stacksjs/buddy-wheels/docs/README.md

# Buddy Wheels project documents

Prepared November 7, 2026. This is a development-stage business and product plan. No physical product has been validated, certified, manufactured or fitted in this project.

- [Business plan](business/business-plan.md): business model, market discovery, economics, operations, launch and risks.
- [Unit economics](business/unit-economics.md): reproducible assumptions and scenario outputs, generated with `bun run finance`.
- [Product and manufacturing plan](product/product-development.md): five proposed size families, printable architecture, material selection and release gates.
- [Suspension research](product/suspension-research.md): wheel isolation, damping, lockout and separately controlled rehabilitation support.
- [Actual bench CAD package](../designs/wheelchair/r0/README.md): all five families, editable CAD, printable STL parts, metal DXFs, full interface BOMs and kinematics.
- [Buddy's XL assembly traveler](engineering/xl-assembly-r0.md): illustrated sequence, hardware stacks, suspension settings and inspection.
- [Other family assemblies](engineering/wheelchair-family-assembly-r0.md): L, M, S and XS dimensions and common build sequence.
- [Fabrication drawing notes](engineering/wheelchair-drawings-r0.md): datums, tube drilling, pin/spacer stacks and unresolved engineering details.
- [Print instructions](engineering/wheelchair-printing-r0.md): file identity, orientation, bench profiles and inspection.
- [Buddy's configurable fit inputs](engineering/buddy-xl-measurements.md): reported 140 lb weight and explicitly estimated geometry, with a separate JSON profile.
- [Interactive wheelchair design studio](engineering/design-studio.md): native 3D inspection, bounded live dimensions, suspension views and matching download provenance.
- [Printer choices near LA](engineering/printer-options-la.md): current options, local support and starter budget.
- [Buddy Rover product brief](product/buddy-rover.md): running, beach and ski configurations, mechanical architecture and qualification gates.
- [Rover unit economics](business/rover-unit-economics.md): independently costed complete configurations, generated with `bun run finance`.
- [Validation and risk register](product/validation.md): bench tests, fitting studies, traceability, failure response and launch criteria.
- [Buddy's immediate needs](product/buddy-first.md): care-first action list and the information still needed for his fit.
- [Product marketing brief](marketing/product-marketing.md): positioning, evidence, audience and voice.
- [Go-to-market plan](marketing/go-to-market.md): acquisition, activation, retention, referral, budget and experiments.
- [Research and sources](business/research.md): checked reference prices, primary sources, uncertainties and comparison limits.
- [Architecture and operations](engineering/architecture.md): native Stacks boundaries, local setup, data model and checkout gate.
- [Acceptance record](engineering/acceptance.md): executed checks, browser evidence and remaining launch work.
- [Asset provenance](marketing/assets.md): original generated imagery, prompts and intended use.

The catalog's weight and height bands are planning inputs, not proven load ratings. Price targets exclude tax and delivery. Public product copy must retain these distinctions until evidence supports a change.

- [Illustrated measuring guide and customer handbooks](engineering/measurement-guide.md): six anatomical diagrams, private worksheet, unit conversion, PDF rebuild and review sources.
- [One-off XL build budget](business/xl-prototype-build-budget.md): every BOM line, printer, tools, finish, tax reserve, contingency and development allowances.
- [Industrial design refinement](engineering/industrial-design-refinement.md): candidate forest/silver finish and rounded nonstructural prints, with the remaining clinical/engineering gates.

- [XL r1 standard-parts manufacturing costs and checked prices](business/xl-standard-r1-costs.md)
- [XL r1 scope, architecture and verification plan](engineering/xl-r1-plan.md)
- [XL r1 configured assembly, BOM and drilling](../designs/wheelchair/r1/XL/assembly.md)

- [XL r2 adjustable spring cartridge costs and online evidence](business/xl-spring-r2-costs.md)
- [XL r2 design and verification scope](engineering/xl-r2-suspension-plan.md)
- [Product customization, colors and saved finish preferences](product/customization.md)

- [Rear support, mesh, padding and front-harness cut/sew guide](engineering/softgoods-xl-r1.md)
- [Complete textile design scope and verification](engineering/softgoods-plan.md)
- [Textile design verification record](engineering/softgoods-verification.md)

- [Complete XL per-unit cost and the $299 decision](business/xl-complete-unit-costs.md)
- [Checked textile supplier SKUs, prices and availability](business/textile-supplier-research.md)

- [Rover r0 bench assembly, cut list and joint patterns](engineering/rover-r0-assembly.md)
- [Rover r0 scope, native geometry kit and verification](engineering/rover-r0-plan.md)
- [Rover materials and weather system: rain, wind, sun, sand and snow](product/rover-materials.md)
- [Rover r0 cost study: counted cost, the $999 price and the path to a lower cost](business/rover-r0-costs.md)
- [Rover r0 build guide: ordering, shop work and assembly, in order](engineering/rover-r0-build-guide.md)
- [Rover r0 design files](../designs/rover/r0/README.md)
- [Rover r0 buy list for one carrier, with supplier links](../designs/rover/r0/buy-list.md)
