stacksjs/buddy-wheels/designs/rover/r0/buy-list.md

# Buddy Rover r0 buy list for one carrier

Configuration rover-r0-l1300-w700-h1000-r1000-a560-g1000-hub101.6-trail-swivel310-k350-t180-welded-sprung. Checked 2026-11-12, USD, before tax and shipping. This is what one builder buys for one bench carrier, in whole bars, sheets, yards and packs, so it is more than the material the carrier consumes. It is a bench build. Nothing here is rated or approved for carrying an animal.

**Materials to buy: about $2,378.24.** $1,811.24 of that has a supplier page behind it. The remaining $567.00 is allowance and needs a quote or a shop visit. Your own time is extra: the study assumes about 6 hours of cutting and assembly, with the welding done by a shop, and 9 hours of sewing.

## Frame, running gear and hardware

| Item | Cost | Basis |
| --- | ---: | --- |
| [1 bars of 1 x 1 x 1/16 inch 6063-T52 square tube, 21 ft each, cut in half to carry](https://www.metalsdepot.com/aluminum-products/aluminum-square-tube) | $65.73 | Observed 2026-11-12 |
| [2 bars of 1 x 1 x 1/8 inch 6061-T6 square tube, 24 ft each, cut in half to carry](https://www.metalsdepot.com/aluminum-products/aluminum-square-tube) | $232.32 | Observed 2026-11-12 |
| [2 brake clamp plates, laser cut 1/8 inch 6061](https://app.oshcut.com) | $27.32 | One carrier: quoted 2026-11-12. Batch: allowance |
| 36 TIG welded joints by a fabrication shop | $540.00 | RFQ |
| [5 round tubes cut and bent by a mail-order service, 10 bends, and 2 end plugs](https://app.oshcut.com) | $443.39 | Quoted 2026-11-12 |
| [2 pneumatic trail wheels, 15 inch 4.00-8](https://www.zoro.com/zoro-select-pneumatic-wheel-15-316dia-435lb-400-8-1nwv4/i/G1932594/) | $65.78 | Observed 2026-11-12 |
| [Front swivel caster with swivel lock, 10 inch pneumatic, and four bolts](https://www.zoro.com/service-caster-10-inch-black-pneumatic-wheel-swivel-caster-with-bolt-swivel-lock-scc-100s3504-pnb-bsl/i/G705434817/) | $67.69 | Observed 2026-11-12 + nut and sleeve allowance |
| [2 stock-shaft axles, sleeves, spacers, washers and cotters](https://www.onlinemetals.com/en/buy/carbon-steel/0-75-od-x-0-065-wall-x-0-62-id-carbon-steel-round-tube-a513-type-5-dom/pid/7765) | $26.44 | Observed 2026-11-12, rod from a listing |
| [8 sleeved bolted joints](https://boltdepot.com/Product-Details?product=328) | $36.20 | Observed 2026-11-12 |
| [Floor and ramp panels, sealed 15/32 inch ACX plywood](https://www.homedepot.com/b/Lumber-Composites-Plywood/15-32/N-5yc1vZbqm7Z1z0mcqq) | $77.00 | Observed 2026-11-12 + sealing allowance |
| [Hinge, two latches, carriage bolts and strap hardware](https://www.zoro.com/zoro-select-piano-hinge-stainless-steel-full-surface-mounting-1-in-leaf-w-x-36-in-leaf-h-stainless-steel-2zfk4/i/G1671966/) | $51.19 | Observed 2026-11-12 + strap allowance |
| [Wheel chocks, grip, tip-stop feet, floor fasteners, bedding tape and ridge pole](https://www.harborfreight.com/solid-rubber-wheel-chock-96479.html) | $105.77 | Observed 2026-11-12, partly from listings |
| [Parking brake: two push-pull toggle clamps with neoprene-tipped spindles](https://www.zoro.com/powertec-toggle-clamp-300lbs-cap-302f-quick-release-pushpull-clamp-20304n/i/G714915420/) | $31.70 | Observed 2026-11-12 + screw allowance |
| [Rear suspension: two coil-over shocks, eight bolt-on mount plates, pivot bolts, bushings and mount bolts](https://www.amazon.com/LvTu-Bicycle-Absorber-Suspension-Bushing/dp/B0CH6DCCPS) | $130.66 | Observed 2026-11-12 + hardware allowances |
| Printed service parts and fixtures | $27.00 | Computed volume + allowance |
| **Subtotal** | **$1,928.19** | |

The tube is priced as full-length bars at one online supplier's listed prices; a local supplier's counter price was not checked. Cut from the bars with cut-list.csv. Send metal/*.dxf to a laser or waterjet shop for the 2 brake clamp plates. The plate prices above are a real quote for one carrier. The frame is welded by a fabrication shop from weld-schedule.csv; build-guide.md says how to find one and what to ask. The parts list in bom.csv has every specification.

## Cover, floor and ramp surface

| Item | Cost | Basis |
| --- | ---: | --- |
| [Roof shell, one piece: 2 whole linear yards](https://www.rockywoods.com/products/solution-dyed-600-denier-polyester-with-urethane-water-repellant-coating_2) | $30.56 | Listed price |
| [Wall shell: sides, front, header and gussets: 4 whole linear yards](https://www.owfinc.com/p/productinfo/POLY6CHAR/) | $26.00 | Listed price |
| [Mesh: three windows and the rear vent: 2 whole linear yards](https://www.sailrite.com/Phifertex-Mesh-White-000-54) | $35.90 | Listed price |
| [Clear storm panels: 10 yards, bought as 60-yard and 10-yard rolls](https://www.sailrite.com/Plastipane-20-Gauge-Vinyl-Window-Material-54) | $89.35 | Listed price |
| [Floor tub liner and threshold flap: 2 whole linear yards](https://www.owfinc.com/p/productinfo/VIN18BLK/) | $19.92 | Listed price |
| [Two floor pad halves: 2 39 x 51 inch sheets](https://www.avetcoinc.com/product/e600-high-density-eva-foam-sheets-60-65-shore-c-39-x-51-5mm-10mm/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) | $63.00 | Listed price |
| [Ramp traction surface: 1 27 x 94 inch sheets](https://www.sailrite.com/Marine-Foam-Flooring-Gray-27-x-94-Adhesive-Backed) | $90.95 | Listed price |
| [Hook tape: 11 yards](https://questoutfitters.com/products/hook-and-loop) | $17.38 | Listed price |
| [Loop tape: 11 yards](https://questoutfitters.com/products/hook-and-loop) | $17.38 | Listed price |
| [Roof seam tape: 4 meters](https://www.rockywoods.com/products/melco-seam-sealing-tape-for-2-layer-fabrics) | $11.56 | Listed price |
| [Reflective trim: 2 2.2-yard packs](https://www.sailrite.com/Sew-On-Reflective-Tape-1-Yellow-2.2-Yds) | $5.90 | Listed price |
| [Roof hem shock cord: 5 yards](https://questoutfitters.com/products/shock-cord) | $5.20 | Listed price |
| [Four stainless D-rings: 4 each](https://www.sailrite.com/D-Ring-Without-Bar-0-1-Stainless-Steel) | $6.20 | Listed price |
| [Tether, grab loop, ties and wrist strap: 20 feet](https://www.strapworks.com/1-inch-utility-polyester-webbing-black) | $14.80 | Listed price |
| [Thread allowance: 1 cones](https://www.sailrite.com/PremoBond-V-92-Black-UV-Bonded-Polyester-Thread-4-Oz-1-350-Yds) | $15.95 | Listed price |
| **Subtotal** | **$450.05** | |

Cut from cover-cut-schedule.csv. A 10% allowance for sewing mistakes is not in this subtotal.

## Before you order

1. Measure the dog and set the cabin size first. Every tube cut and fabric blank follows from it.
2. Buy one wheel and measure its hub before cutting an axle or ordering hangers.
3. Print the clearance coupon and one cap, then the rest.
4. Read the release gates in assembly.md. This list builds a bench carrier for fit and handling trials with ballast, not a finished product.
