stacksjs/buddy-wheels/docs/engineering/acceptance.md

# Acceptance record

Implementation and local QA recorded November 7, 2026. Production deployment and public QA recorded November 8, 2026. This record covers software and planning artifacts only. It does not validate a physical wheelchair.

## Completed locally

- Project created with native Buddy scaffolding under ~/Code/Apps/buddy-wheels.
- Commerce enabled through Buddy and 244 native migrations applied to the development SQLite database.
- Five known development configurations installed with the idempotent native seed command.
- Marketing, shop, fit guide, basket, checkout preview, story, care, policies and development-plan pages implemented in STX with ts-css.
- Native ProductCard, QuantitySelector, Button, OrderSummary and CheckoutSteps used for commerce UI.
- Business plan, reproducible financial model, product/manufacturing plan, validation/risk register, research, marketing and operations docs completed.
- Origin story corrected to include Buddy's very large size and limited suitable options, alongside affordability.
- Public development page includes outdoor-use goals and separate suspension/body-support research, with no availability or rehabilitation efficacy claim.
- Native app lint passed with zero errors and zero warnings.
- App TypeScript checks passed, including the direct application project check.
- STX checks passed with zero errors and zero warnings.
- Native unit/feature suite passed: five tests, 37 assertions.
- Browser journey passed: choose L, set quantity two, add to basket, change quantity, preview checkout, acknowledge fitting and see the disabled payment state.
- Server checkout returns HTTP 409 and PRODUCT_VALIDATION_REQUIRED.
- Fresh/tampered cart cookies reveal no other basket, and fractional quantities/open redirects are rejected.
- Local fit planner passed a medium-family example and labels its result as unapproved.
- Home layout checked at 320, 428, 768 and 1440 pixels with zero horizontal overflow and no browser console errors.
- Native deployment dry-run targets the existing stacks host, not new compute. Web/API ports 3460/3468 were checked against live listeners and were unused at inspection time.
- Private production env and provider credentials are excluded from Git. Only required provider keys are passed to the local deployment process.

## Framework source evidence

The Stacks source includes generic product-card props, status copy below images, isolated STX quantity state, native form values, one native change event, and live bounds/model normalization. Four retained source tests passed with 26 assertions, including real Chromium interactions. Source lint and framework typechecks passed.

Source review found and corrected duplicate change events and stale form values after live bounds changed. The publishing pipeline also exposed a pre-existing router declaration-generator failure; removing a redundant nested conditional preserves type behavior and passed router build/type fixtures. Source changes were fast-forward pushed to origin/main and native patch release commands were run. Publication and installed-consumer evidence follows.

Stacks 0.75.522 was published to npm after the exact release source passed CI. Native `./buddy upgrade` installed it in this application, updating the root and framework-support manifests and lockfile. Installed stacks, defaults and actions package versions were verified as 0.75.522. App lint, native tests, typechecks and STX checks passed against that install. The real-browser journey passed again, including native ProductCard links to `/shop?size=L`, quantity updates, concurrent five-per-size enforcement and all four responsive widths. No local component fork is used.

## Production verification

Live at [buddywheels.org](https://buddywheels.org). The founder enabled domain-specific Porkbun API access, verified through the saved setting and a successful native provider request. The authorized provider keys remained deploy-process inputs.

Native `./buddy deploy --prod --yes` successfully deployed application commit `8089b9153ef4e9e624ed6d6787349bb355c2421d` to the existing `stacks-production-app` server. It skipped provisioning and installed independent `buddy-wheels-main` and `buddy-wheels-api` services and the `buddy-wheels` gateway fragment. The API listener was verified on loopback port 3468; web traffic is routed to port 3460. SQLite persists at the app-specific absolute path declared in config/cloud.ts.

- Native Porkbun reconciliation published apex and www IPv4/IPv6 records.
- Native TLS issuance completed for both names. HTTPS passed with normal certificate verification.
- HTTP and www requests for `/shop?size=L` returned 301 to `https://buddywheels.org/shop?size=L`.
- All nine public pages returned 200: home, shop, fit guide, basket, checkout, story, care, policies and development plan.
- The theme stylesheet and responsive WebP assets returned 200 with their expected content types.
- Same-origin `/api/cart` returned 200 JSON; order placement returned HTTP 409 with PRODUCT_VALIDATION_REQUIRED.
- The full native Chromium journey passed against the public HTTPS origin: L quantity two totals $529.00, quantity one totals $264.50, checkout remains disabled, unsigned/forged/absent cookies isolate baskets, invalid quantities and redirects are rejected, and concurrent adds retain the five-per-size limit.
- The local fit planner example passed on the public site. Responsive checks at 320, 428, 768 and 1440 pixels found no horizontal overflow or browser console errors.
- Application CI passed for the deployed commit; the Stacks 0.75.522 release workflow completed successfully.

The site is a development storefront with persistent planning baskets. It accepts no payments, deposits, reservations or customer orders. Software delivery does not establish physical-product readiness.

## November 8 storefront and Rover update

Launch-style copy replaces the repeated planning language and competitor-price references in all public pages. Internal price evidence remains in the project docs. A concise availability statement and the server order gate remain accurate.

- Buddy Rover adds complete Run ($399), Coast ($449), Snow ($499) and All-season ($599) configurations to the native catalog, shared signed basket and idempotent seeder.
- The wheelchair fit helper still searches only wheelchair size families. No untested carrier dimensions or load rating is published.
- Native STX configuration state updates price, SKU, included items and imagery. Snow has its own generated visualization and SKU thumbnail.
- Basket quantity changes save through their owning native form; removal, correct product images/links and the shared header count work across both families.
- Product pages have mobile purchase actions; checkout now has one direct availability step without forced preview acknowledgements.
- Native `buddy upgrade` installed Stacks 0.75.524. Source OrderSummary changes preserve defaults while supporting separate heading, tax and item-total labels. Source tests and exact release CI passed; a superseded 0.75.523 release was cancelled after the newer mainline release included its changes.
- App lint has zero errors/warnings; app TypeScript and STX checks passed; seven tests passed with 45 assertions; both financial documents regenerated successfully.
- Retained native Chromium QA passed on the installed package graph: real home-to-Rover-to-wheelchair navigation, configuration prices, image switching, mixed totals, mobile submit, quantity limits/concurrency, removal, cookie isolation, professional-fit wording and the HTTP 409 gate.
- All ten public pages were checked at 320, 428, 768 and 1440 pixels with no horizontal overflow or console errors. Hero CTA centers, principle icons and heading tops align within one CSS pixel; native purchase buttons use the forest-green theme. Mobile safe-area spacing and visible keyboard focus are styled consistently.
- Independent Standards and Spec reviews found three issues, all corrected: overly advanced readiness wording, an unverified stability adjective and incorrect Rover Open Graph metadata.

Production verification completed November 8, 2026. Native Buddy deployed the complete collection at application commit `1b1ecd1f8170f8ccb85283e660880afc36b9a89c`; a subsequent web-only release `f7cdb152cc35e38b9ddb8226dd167d580c704ef1` added automatic stylesheet revisions. Both commits passed application CI. The web and API continue to use the existing Stacks server.

The full retained Chromium journey passed again against https://buddywheels.org, including native navigation, all configuration prices, Snow image switching, mixed totals, mobile purchase, automatic quantity updates, removal, anonymous HTML/API isolation, concurrency limits, the fit guide and disabled order placement. All ten public pages passed responsive overflow and console checks at the four recorded widths, including alignment and native button-color assertions.

Public smoke checks returned 200 for all pages, the revised stylesheet, both Rover WebP images and the cart API. HTTP and www preserved `/rover?mode=snow` in 301 redirects to the HTTPS apex. The stylesheet URL includes its content revision because the static server caches CSS for one hour; existing visitors receive the changed styles after a normal page refresh. GitHub deployment `7638107422` records the final web deployment.

## Wheelchair bench CAD r0, November 8, 2026

- Native `buddy design:wheelchair` generates editable OpenSCAD, family-specific BOMs, tube drilling coordinates and ideal rigid-linkage kinematics. It calls the official external OpenSCAD CLI for solid/mesh export; no CAD engine or web dependency was added to Stacks.
- All five baseline families exported: 50 binary STL files, 15 metal DXF profiles and assembly previews. The separate Buddy XL estimate adds another 10 STL files and three DXF profiles. Each dataset includes source/output hashes and `mesh-inspection.json`.
- All 60 actual STL files passed export-time checks for closed two-face edges, consistent winding, one connected body, positive signed volume and the declared 220 x 220 x 100 mm print envelope. These are digital checks, not structural tests.
- All 50 baseline meshes also passed the retained native test suite's independent binary-STL inspection and authored arm dimensions. Nominal shock travel, tube overlap, hole separation, profile validation, invalid hardware/wall/corner combinations and isolation of configured iterations are covered.
- `./buddy lint`: zero errors or warnings. `./buddy typecheck`: passed. `./buddy test`: 12 passed, 536 assertions.
- The native Bun download bundle contains 60 STLs and 18 DXFs. Every bundled CAD file was compared byte-for-byte by SHA256 with its working-tree source; archive tests also confirm private environment/runtime files stay excluded.
- Authored Standards and Spec reviews found incompatible parameter combinations, corner-hole edge breakout and an inconsistent XS cotter size. The generator now rejects incompatible dimensions/pitches and uses one family-specific retention-hole value consistently; regression checks cover the boundary errors.
- XL and XS assembly views and the XL suspension/detail views were visually inspected. The rear-bridge cheek orientation and perpendicular tube termination were corrected during development.
- Owner-reported Buddy weight is 140 lb, with standing reach context retained separately. Supported dimensions remain estimated and explicitly configurable. The compact shocks, exact wheel/harness interfaces, finish drawings, fastener procedures and physical verification remain open as described in the mechanical docs.
- Current LA printer options were checked against manufacturer and seller sources. No printer, hardware, filament, testing service or fabrication was purchased or booked.

## Interactive XL studio, November 8, 2026

- `/design-studio` uses native STX state, shared CAD parameters and the framework's new `<ModelViewer>` component. The underlying WebGL module has no external renderer dependency and is published in Stacks 0.75.526.
- Framework commit `c6f6d044cd` adds the viewer, parser/primitives and retained component tests. The exact 0.75.526 release source (`fdc238ad30`) passed CI and Releaser. Framework lint/typecheck, three geometry/parser tests and two real-Chromium component/lifecycle tests passed.
- Native `buddy upgrade` installed 0.75.526. The temporary development link was removed and registry-installed browser/defaults/actions packages were verified. Final checks below use the published packages with no source-component override.
- App lint and TypeScript checks passed. STX checked 14 scripts and 177 expressions without diagnostics. Sixteen tests passed with 609 assertions, including configured artifact hashes and rejection of stale, modified or incomplete export provenance.
- The retained native Chromium studio test passed pointer-driven orbit pixel changes, zoom, live dimensions, leverage/travel/lock behavior, individual part inspection, invalid fields, unknown parts, deep links, exact configured downloads and every packaged checksum.
- Studio checks passed at 320, 428, 768 and 1440 pixels, including actual 2x canvas backing resolution, system dark theme and a forced non-WebGL drawing/download fallback. No horizontal overflow or browser console errors remained. The added navigation link initially overflowed at 320 pixels; the mobile navigation typography was corrected and verified again.
- The complete shopping/cart/Rover/fit journey passed again at all four widths after the shared navigation change. Checkout remains gated and no payments or orders were created.
- Editable controls change only frame height, rail spacing and rail length, so print geometry is unchanged. Downloaded dimensions, BOM, tube-hole datums, CAD pose, setup JSON and Markdown instructions match the selected setup. Independent review caught and corrected the missing optional lock-pin depiction and the publisher's stale-export acceptance.
- CAD cap insertion direction and lock depiction were fixed in the parametric source; all family exports and provenance were regenerated. `design:publish` supplies the public XL assets only after verifying their canonical sources and output hashes.
- The native production preview retains the existing attached Hetzner host, web port 3460 and API port 3468, with no additional compute.

Production verification completed November 8, 2026. Native `buddy deploy --prod --yes` deployed both web and API at application commit `0604302cfeb1d5d2df1c1b17dc2621aa41241000`. Application CI passed and GitHub deployment `7640338088` records success. Existing Porkbun DNS and TLS remain attached to the Stacks host.

The retained studio browser test passed against https://buddywheels.org/design-studio: real WebGL orbit, zoom, dimension changes, suspension settings, neutral lock, individual STL inspection, server validation, configured downloads and every archived checksum. Four responsive widths, 2x canvas resolution, dark mode and forced non-WebGL fallback passed without overflow or browser console errors. The separate public storefront journey also passed with the new shared navigation, including Rover configurations, mixed basket, mobile purchase controls, checkout gate, cart isolation and fit planner. No payments or orders were created.

## All-size studio extension, November 8, 2026

- The shared studio now covers XS, S, M, L and XL. Native radio selection updates geometry, dimension limits, suspension radii, individual meshes and download paths. Each family's valid edits are retained during the page visit; reset affects only the selected size. The shop opens its selected family directly.
- Each family publishes its own ten STL types and three metal DXF profiles. Independent review compared all 65 public mesh/profile assets with their canonical export hashes. Configured kits include family-specific CAD, BOM, tube drilling, suspension metadata, assembly instructions and checksums. Buddy's reported weight appears only in XL context.
- Standards review caught inner-upright/mount interference at low frame heights and opposed rear-cheek overlap at the narrowest XS spacing. Continuous studio envelopes now keep the undrilled inner tube above the mount-pin envelopes and leave at least 2 mm between rear corner cheeks. All advertised range corners have regression checks. Compact studio starting heights intentionally differ from the original nominal r0 rigs; the reference images are not configured fabrication drawings.
- Twenty-seven native tests passed with 1,379 assertions. App lint, TypeScript and STX checks passed. The native Chromium journey passed all five configured kits and every archived checksum, dimension/suspension changes, remembered edits, per-family reset, size deep links, shop handoff, keyboard radio selection and individual part downloads. The full existing storefront journey also passed.
- All five sizes passed responsive checks at 320, 428, 768 and 1440 pixels, with aligned selector buttons, touch targets, no horizontal overflow and no console errors. Retina canvas, dark mode and five distinct non-WebGL fallback drawings passed.
- Stacks commit `59e64f18f5` makes the reusable viewer's label and poster reactive alongside the scene. Two real-Chromium component tests passed with 14 assertions, framework lint/typecheck passed, and the exact 0.75.527 release source `85df359add` passed CI and Releaser. Native `bun run release:patch` drives publication. The app pins the published `@stacksjs/defaults` 0.75.527 component package on its existing 0.75.526 runtime and unchanged STX 0.2.807. Frozen installation passed, the development link was removed, and the installed viewer's SHA256 matches the source. All 27 tests, lint, app/STX type checks and the complete five-size browser journey passed again against the installed registry package with no source override.

Production verification completed November 8, 2026. Native Buddy deployed web and API at commit `0b973ed4e4dea458f4a1bfa70687a9cf9bdbe390`; application CI passed, and GitHub deployment `7641310439` records success. The public five-size browser suite passed all configured kits and archived hashes, per-family parts, suspension/lock controls, remembered edits, reset, shop handoff, size deep links, keyboard selection, four responsive widths, aligned touch targets, Retina rendering, dark mode and all five non-WebGL drawings. The separate storefront journey passed shopping, Rover configurations, mixed baskets, mobile controls, checkout gate, cart isolation, quantity validation and fit planning. Both suites reported zero console errors. No payments or orders were created.

The follow-up deployment configuration declares the backwards-compatible API before the frontend for future releases. Native dry-run confirms API 3468, web 3460 and the unchanged www redirect on the existing attached Stacks host, with no new compute or warnings. Lint and type checks passed for that configuration change. This ordering changes future release sequencing, not the currently verified application behavior.

## Illustrated fitting, first-build costs and appearance refinement, November 8, 2026

- The native STX fit page adds six original vector measurement diagrams with explicit landmarks, tools, posture and common mistakes. Supported groin height A stays distinct from lying rear-leg measurement E. Hip width B1 and widest body width B2 are separate raw measurements. No anatomical value is automatically mapped to a CAD setting.
- The local worksheet converts inches/cm and lb/kg numerically, keeps missing values pending, rejects nonpositive entries, and copies only after user action. It sends no worksheet data to an API or browser storage. Reset for Buddy explicitly clears a previous dog's record before filling his name and owner-reported 140 lb.
- Customer downloads include a visually checked two-page illustrated PDF/blank worksheet, a four-page XL budget PDF and line-item CSV/JSON. Both tagged PDFs have no embedded JavaScript. Mobile tables retain all columns in a keyboard-accessible scroll region.
- The reproducible integer-cent budget reconciles every XL BOM ID without charging a printer per chair or charging both a spool and consumed filament grams. Base first-rig DIY cash is $3,012.12 including a $549 printer, tools/fixture, material, fabrication, a candidate exterior finish, shipping and illustrative reserves. Low/high scenarios are $1,972.54/$4,932.92. Paid assembly makes the base $3,362.12; assembly plus engineering, fitting and testing allowances makes it $5,312.12. Most prices remain unquoted allowances, and these amounts do not buy approval or establish a bound on development cost.
- The actual parametric chair and native scene share a forest/silver/charcoal palette. End-cap flanges, loose marker collars and sample pivot shields have rounded or tapered nonstructural edges while nominal attachment interfaces and structural profiles stay unchanged. All five family exports and the separate Buddy estimate were rebuilt with OpenSCAD; mesh checks verify closed, consistently wound, positive-volume single bodies within the print envelope. Public kits carry matching refreshed meshes, source/export hashes and an industrial-design note.
- Thirty native tests passed with 1,504 assertions. App lint, app TypeScript and STX checks passed. The native Chromium storefront and all-size studio suites passed again, including configured kits and hashes, real WebGL controls, non-WebGL fallback, four responsive widths, dark mode and gated checkout. The fit-page journey passes all six diagrams, keyboard selection, populated-record reset, conversions, pending/invalid values, real clipboard copying, distinct height methods, helper handoff, downloads and budget arithmetic.
- Independent Standards and Spec review findings were corrected: resetting a populated worksheet, keeping mobile table headers/body aligned, and accurately labeling the finish allowance. This iteration did not expose a new generic framework defect; it uses the already published native component/runtime graph without a local source override.

Production verification completed November 8, 2026. Native `buddy deploy --prod --yes` deployed API first and web second at commit `ca72c969a6ea9efed7290bf7b8e4106f93c295e8`, on the existing attached Stacks host. GitHub deployment `7642197514` records success, application CI passed, and native Porkbun/TLS reconciliation completed without provisioning new compute.

The public HTTPS fit suite passed all six diagrams, keyboard selection, populated-record reset, conversions, pending/invalid values, actual clipboard copying, distinct height methods, size-helper handoff, downloads and cost arithmetic at 320, 428, 768 and 1440 pixels. The measurement and budget PDFs, CSV and JSON returned 200 and matched their committed SHA256 hashes byte for byte. Both PDFs were rendered and visually inspected, with two measurement pages and four budget pages. The complete public studio and storefront journeys passed again, including all five configured kits/checksums, refreshed print meshes, real WebGL manipulation, non-WebGL fallbacks, mobile layouts, dark theme, mixed baskets and gated checkout. Every suite reported zero console errors. No payments or orders were created.

## XL r1 standard-parts redesign, November 8, 2026

- A separate rigid, cut-to-fit XL r1 studio is linked from the XL shop, r0 studio and visual fit page. The existing all-size r0/suspension platform remains available. r1 has no fictitious independent-suspension controls. Frame edits produce matching configured CAD, BOM, drilling, assembly, profile and cost records.
- Standard 1 inch 6061-T6 stock, candidate 13 inch pneumatic wheels, cut plain shafts, two repeated steel profile types and nonstructural prints replace the r0 shock platform. Six real STL types and two DXFs were exported through native Buddy/OpenSCAD. Digital checks verify closed, oriented, positive-volume single-body meshes within the print envelope. This does not establish structural capacity or animal-use readiness.
- Checked Online Metals and Harbor Freight prices drive whole-stock nesting and wheel cost. The 100-chair scenario is $180.01 landed manufacturing versus $264.50 retail, 31.9% product gross margin and $28.29 contribution before fixed overhead under customer-paid outbound freight. A single retail-quantity build is $336.01 before applicable purchase tax/outbound freight. Most operations and softgoods remain unquoted. Independent suspension is deferred from the base, whose modeled 30% gross-margin headroom is only $5.14.
- Both hardware and cost provenance are guarded. Configured kits include every actual mesh/profile and checksums; incomplete manifests, modified assets, stale CAD and stale cost inputs are rejected. Public reference files are distinct from configured kit data.
- Thirty-four native tests passed with 1,666 assertions. Native lint, app TypeScript and STX checks passed. The r1 real-browser suite passed configured links/downloads/hashes, all parts, margin gates, four responsive widths, measured dark-panel contrast and non-WebGL fallback. The previous all-size studio, commerce and fit suites also passed. Independent Standards and Spec review findings were fixed.

Production verification completed November 8, 2026. Native Buddy deployed API and web at commit `2357ef1ef4026db3268e4a50220a6172bf98568f` to the existing attached Stacks host. GitHub deployment `7642854730` and application CI record success. Public HTTPS tests passed for r1 actual 3D interaction, all six part meshes, configured document links and archives, every archived checksum, one-versus-100 costs, size/quantity margin failures, four responsive widths, dark contrast and non-WebGL fallback. All 18 published r1 assets matched their committed hashes, including source, CAD, meshes, profiles, instructions and cost records. The full public r0 all-size, commerce and fit journeys also passed with zero console errors. No payments or orders were created. Product copy calls the printed pieces service parts, consistent with the metal load path.

## Buddy Rover r0 walk-in carrier, November 11, 2026

- A first Rover bench design is published at /design-studio-rover and linked from the Rover product page. The tailgate folds down into a ramp of about 9 degrees to a 152 mm deck, standing on its own feet. The starting cabin is 1200 x 700 x 950 mm clear, about twice the stated interior volume of the Burley Bark Ranger XL, whose own page lists a 9 inch step-up.
- Geometry is generated by a native solid kit with no external CAD program. Fourteen STL meshes and three DXF profiles are checked as closed, consistently wound, single bodies inside a 220 x 220 x 100 mm envelope. OpenSCAD was not run for Rover; there is no SCAD or STEP source for it.
- A rain, wind and sun cover is specified layer by layer with supplier prices read on November 11, 2026. No fabric page stated a hydrostatic head or UPF figure, so no weather claim is made.
- The counted cost is $2,037.93 per carrier at 100 units and $3,254.89 for one, against the provisional $399 Run price. The studio, the cost study and the Rover brief all state that the price or the architecture must change. The catalog price was left alone pending the owner's decision.
- Wheel, brake, swivel front wheel and anti-tip behavior are open. Estimated empty mass is about 47 kg by arithmetic.
- Fifty-seven native tests passed with 4,206 assertions, seven of them new for Rover. Native lint, app TypeScript and STX checks passed. In a local browser the studio reached its ready state with no console errors at desktop and 375 pixel widths, the raised and lowered ramp, ramp detail and weather cover views rendered, all six configured document links and the configured kit returned 200, and an out-of-range setup returned 422.

Production verification completed November 12, 2026 (UTC). Native `buddy deploy --prod --yes` deployed API first and web second at commit `ab5b64e` to the existing attached Stacks host; GitHub deployment `7731093166` records it and application CI passed on the same commit. The GitHub Deploy workflow itself did nothing, because its deploy secrets are not configured, so a push alone does not ship. The deploy warned that Porkbun credentials were absent and left DNS untouched; the existing records already point at the host.

On the public HTTPS site the Rover studio, Rover product page, shop and XL studio returned 200. The Rover studio reached its 3D ready state in desktop Chrome with a 8.9 degree ramp, a 2.0x volume readout, $2,037.93 modeled cost and fourteen part cards; the only console error came from a browser extension. A configured kit returned 200, an out-of-range setup returned 422 and the checkout gate still returned 409. All 28 published Rover assets matched their manifest hashes and the committed files byte for byte. The full real-browser QA scripts were not rerun against production for this release. No payments or orders were created.

## Buddy Rover r0 cost-down pass, November 12, 2026

- The counted cost fell from $2,037.93 to $1,668.26 per carrier at 100 units and from $3,254.89 to $2,809.28 for one, through a cheaper verified wall fabric, hook and loop in place of zippers, listed quantity tiers, zinc-plated hardware, exterior plywood, thin-wall secondary tubes and eight fewer gussets. Each change carries a stated trade-off in the cost study. Estimated mass is about 45 kg.
- A second, clearly labeled total prices the tube by weight at an assumed $4.00 per pound: $1,296.72. No tube or wheel price could be verified lower from a supplier page.
- Neither figure fits the provisional $399 price or reaches the reference trailer's retail price. The studio, cost study and Rover brief say so. The catalog price is unchanged.
- No existing part geometry changed. The fourteen meshes and three profiles of the first release are byte-identical.
- A second pass made the 13 x 4 inch pneumatic wheel from the XL wheelchair the default, at its observed $14.99, with a new low axle hanger profile and fork spacers. Totals are $1,527.23 at 100 units, $2,674.25 for one and $1,159.53 with tube by weight. The 20 inch wheel is a studio option and still costs $1,668.26. The package now has fifteen meshes and four profiles.

The first cost-down pass was deployed natively at commit `dd57a1a` on November 12, 2026 (UTC), GitHub deployment `7731443503`. On the public site the studio and product page returned 200, the published cost study read $1,668.26, the materials list showed the new roof and wall fabrics, a configured kit returned 200, an out-of-range setup returned 422, the checkout gate returned 409 and all 28 published Rover assets matched their manifest hashes and the committed files. The second pass, with the path wheel, is committed and verified locally with 57 passing tests, clean lint and type checks, and a browser check of the wheel switch, both kits and the parts list; its production deployment is recorded separately once done.

- A third pass priced tube, wheels, bolts and plywood from supplier pages read in a browser, moved the cabin tube to 1/16 inch 6063-T52, made a 15 inch pneumatic wheel the default and added a one-carrier buy list. Totals are $1,365.53 at 100 units, $2,589.59 for one and $1,186.31 with tube by weight; materials for one build are about $1,616, of which $1,147 has a supplier page behind it. The package has sixteen meshes and five profiles. The cabin tube cap mesh changed with the wall thickness; the other earlier meshes are unchanged. Verified locally only; not deployed at the time of writing.

- A fourth pass added a swivel front caster on a raised nose, a step-by-step build guide, a base frame plan, a drilling schedule for every tube, a parcel-bar nesting plan and 8 ft bar pricing for one build. Totals are $1,384.07 at 100 units, $2,663.98 for one and $1,188.17 with tube by weight; materials for one build are about $1,750, of which $1,294 has a supplier page behind it. Eight Rover tests cover it, including that every drilled hole lies inside its cut piece and that rail holes in the two directions never share a station. No wheel brake exists; parking is by wheel chocks. Verified locally only; not deployed at the time of writing.

- A fifth pass added a swivel caster with a swivel lock and a stated mounting height, a toggle-clamp parking brake on each rear tire with a new clamp plate profile, and supplier-page prices for most remaining hardware. Totals are $1,507.81 at 100 units, $2,777.43 for one and $1,309.43 with tube by weight; materials for one build are about $1,863, of which $1,557 has a supplier page behind it. The package has seventeen meshes and six profiles. The laser-cut plates remain an allowance, the brake is untested and nothing has been built.

Production verification completed November 12, 2026 (UTC). Native `buddy deploy --prod --yes` deployed API and web at commit `a4d5507`, GitHub deployment `7742748604`, after application CI passed on the same commit. On the public HTTPS site the Rover studio, Rover product page, shop and XL studio returned 200. Configured kits for the swivel and the fixed front returned 200, the build guide, buy list, drilling schedule and base plan downloads returned 200, an out-of-range setup returned 422 and the checkout gate returned 409. The published cost study read $1,507.81 and the served build guide contained the parking brake and caster sections. All 38 published Rover assets matched their manifest hashes and the committed files byte for byte. In desktop Chrome the studio reached its 3D ready state with the swivel and the fixed front, showed seventeen part cards and ten document links, and logged no site errors. The earlier note that the second pass awaited deployment is superseded by this release. The full real-browser QA scripts were not rerun against production. No payments or orders were created.

- A sixth pass drew the caster beam holes from the maker's published plate pattern, replaced the brake pad with a spindle whose thread is stated, and changed the ramp stand legs to a fixed length with a printed cap because no threaded insert fits the tube. Totals are $1,481.08 at 100 units, $2,749.54 for one and $1,281.97 with tube by weight; materials for one build are about $1,836, of which $1,530 has a supplier page behind it. The plate lines remain an allowance: a no-account instant quote exists at OSH Cut, but uploading the files was not permitted in the session.

The sixth pass was deployed natively at commit `baeff07` on November 12, 2026 (UTC), GitHub deployment `7743471602`, after CI passed on that commit. On the public site the studio, product page and shop returned 200, configured kits for both front options returned 200, the build guide, buy list and drilling schedule downloads returned 200, an out-of-range setup returned 422 and the checkout gate returned 409. The published cost study read $1,481.08, the served build guide named the no-account quote route and the new spindle and no longer mentioned a threaded insert, and all 38 published Rover assets matched their manifest hashes and the committed files. The studio was checked in a local browser for this release, not in a browser against production.

- The Rover catalog prices changed on November 12, 2026 at the owner's instruction: Run $999, Coast $1,049, Snow $1,099, All-season $1,199. The starting cabin grew to 1300 x 700 x 1000 mm with a 1000 mm ramp at about 8 degrees. The counted cost at that size is $1,538.35 per carrier at 100 units, so every configuration sells below its counted cost; the unit economics table, the cost study and the studio state this, and orders stay closed.

The price and size change was deployed natively at commit `3a0691a` on November 12, 2026 (UTC), GitHub deployment `7744606710`, after CI passed. On the public site the Rover page served $999.00, $1,049.00, $1,099.00 and $1,199.00, the studio and a default kit returned 200, an out-of-range setup returned 422, the checkout gate returned 409, the served setup was 1300 x 700 x 1000 with a 1000 ramp, and all 38 published Rover assets matched their manifest hashes and the committed files.

- A later pass raked the cabin front 350 mm on two fabric stays, added Walk, Run, Coast and Snow setups to the studio and a concept ski conversion kit. Totals for the starting setup are $1,518.19 at 100 units and $2,769.85 for one. The ski kit has no selected ski and no supplier price.

That pass was deployed natively at commit `930d16e` on November 12, 2026 (UTC), GitHub deployment `7745304382`. On the public site the studio returned 200 and served four activity choices, configured kits for the wheeled, ski and fixed-front setups returned 200, a rake of 50 returned 422, the checkout gate returned 409, and all 38 published Rover assets matched their manifest hashes.

- A welded pass made a welded frame the starting design and kept the bolted frame as an option: a roof that falls 180 mm toward the front, raked front pillars, 46 welded joints, no gussets, a weld schedule and a build guide written for briefing a fabrication shop. Totals for the welded starting setup are $1,504.41 at 100 units and $2,970.43 for one, against $1,518.19 and $2,769.85 bolted, so welding does not lower the cost. The welding line is arithmetic on an assumed shop rate with no quote behind it, no weld procedure or sample exists, and outbound freight for an assembled frame is not counted.
- A ride and seating pass put each rear wheel on a trailing swing arm with a coil-over shock, as the starting design on the welded frame, and added a two-seat bench as a labeled layout concept. Ride figures (about 59 mm of travel, about 22 mm of settle) are arithmetic from the drawn geometry and one seller's spring label; nothing was fitted or measured and no comparison with another product is claimed. The seat concept is marked not for use with a child, has no restraint or joint design, and cites the stroller standard and certification it would need. Totals for the starting setup are $1,624.72 at 100 units and $3,251.09 for one.
- A home-build pass gave the bolted frame the same sloped roof, raked pillars and sprung rear as the welded one, with three gusset plates generated at each setup's angles and bolt-on shock mounts for both builds, and made the bolted frame the starting setup. Totals for the starting setup are $1,607.79 at 100 units and $2,932.51 for one. The generated plates have not been cut or trial-fitted.
- A tube file pass added a STEP file for every different tube of the bolted frame, with its holes and angled ends, and an order sheet, so a tube laser service can cut and drill them. The solids pass native closed-shell and volume checks. With the owner's permission the 20 files for the starting setup were uploaded to OSH Cut on November 12, 2026: all passed its design check and the set was quoted at $1,405.06 before shipping and tax. Nothing was ordered and no tube has been cut.
- A cost pass added the plates to the same quote, $551.22 for 62 plates in 6061-T6, about double the earlier allowance, and put those prices into the one-carrier cost. The tube files became 8 sticks to saw apart, quoted at $1,195.44, and the handle grip lost its four gussets. The 100-carrier plate figure is still an unquoted allowance. The owner decided to keep the plates in 6061-T6 and to buy the tube for one carrier as full-length bars cut in half; materials for one bolted build then count about $2,063. These five passes were verified locally only at the time of writing and were not deployed, at the owner's instruction.
- A bent-frame pass made the shop-built frame the starting setup again and bent its cabin sides, handle and nose hoops from single tubes: 29 tubes, 10 bends at a 4.5 inch centerline radius and 36 welded joints, with a bend schedule beside the weld schedule. Totals for the starting setup are $1,564.38 at 100 units and $2,950.38 for one. The bending and welding lines are arithmetic on assumed shop rates. No shop has quoted, bent or welded anything, and the radius comes from one published result for this tube size, not from a sample. OSH Cut's bent tube tool was checked on November 12, 2026 and offers round tube only. Verified locally only and not deployed, at the owner's instruction.
- A round-tube pass redrew those five bent parts in 1 inch round 6063-T52 with a 1/8 inch wall, to OSH Cut's bending rules: a 3 inch centerline radius and at least 2.25 inches of straight beside each bend. All five passed its design check on November 12, 2026 and were quoted at $440.39 for one carrier. The bend schedule carries the points its order form asks for. Totals for the starting setup became $1,666.02 at 100 units and $3,082.31 for one, then $3,093.25 once the ten plates were quoted as an order of their own at $71.00, not $60.06. Nothing was ordered. The round nose hoops, the round-on-round handle welds, the notched square tubes and the fit of the printed clips on round tube are open and uncalculated. Verified locally only and not deployed, at the owner's instruction.

## Physical product gate

No production CAD/STL/3MF, qualified print specification, structural test report, veterinary fitting study, certified load rating, production inventory, supplier quotes, insurance, final return/warranty terms, live payment provider or customer order exists. Follow docs/product/validation.md before enabling sales or using a prototype on an animal.
