stacksjs/buddy-wheels/docs/product/buddy-rover.md

# Buddy Rover product and launch brief

November 8, 2026, updated November 11. Second product family: a repairable large-dog adventure carrier. This is a design specification and commercial hypothesis, not a qualified physical product, load rating or use guide. The software catalog and basket work; orders remain gated.

## r0 bench design, November 11, 2026

The first Rover design package now exists: [assembly and cut list](../engineering/rover-r0-assembly.md), [materials and weather system](rover-materials.md), [cost study](../business/rover-r0-costs.md), [scope and verification](../engineering/rover-r0-plan.md), the [design files](../../designs/rover/r0/README.md) and an interactive [Rover studio](https://buddywheels.org/design-studio-rover). It is a bench design. Nothing has been built, loaded, sewn or tested.

What changed from the brief:

- **Shape.** The front leans back 350 mm on a real pillar each side and the roof falls 180 mm from rear to front, so the side view is a wedge and not a box. On the welded frame each cabin side is one round tube bent twice. On the bolted frame every piece is a straight tube and six have an angled end. Rake and roof taper are studio settings, and zero for both gives the earlier box. No drag figure is claimed.
- **Ride.** Each rear wheel hangs on its own trailing swing arm with a coil-over shock. From the drawn geometry and one candidate shock at an observed $31.05, that is about 59 mm of wheel travel, settling about 22 mm under the 160 lb planning mass. The spring figure is a seller's label, nothing has been fitted, and no ride has been measured, so no claim is made against any other carrier. The mounts bolt on, so it fits either frame, and it is drawn for the 13 and 15 inch wheels; a rigid axle remains an option. Open: side play at a single-bolt pivot, a parking brake pad on a tire that now moves with the load, and an unsprung front caster.
- **Two seats.** The studio can show a two-place bench just ahead of the axle, 350 mm per place with about 620 mm of seated height. It is a layout concept and is labeled not for use with a child. No joint, anchor or restraint is designed and no build steps are issued for it. See the decision below.
- **Shop-built, or built at home.** The starting design is a welded frame made by a fabrication shop, so that as little as possible is left to do at home. Each cabin side is one tube bent into a hoop (rear post, roof run and front pillar), the handle is one U-shaped tube, and each end of the caster nose is one small hoop. That is 29 tubes, 10 bends and 36 welded joints, against 39 tubes for the bolted frame. The five bent tubes are round, 1 inch across with a 1/8 inch wall in 6063-T52, because no mail-order service was found that bends square tube and one does bend round. They are drawn to that service's rules, a single 3 inch centerline radius with at least 2.25 inches of straight beside each bend. On November 12, 2026 all five passed OSH Cut's design check and were quoted at $440.39 for one carrier's set: $100.50 a side hoop, $116.09 for the handle bar and $61.65 a nose hoop. The base, posts and cross tubes stay square, and a shop welds the frame from a cut list and a weld schedule, so it needs a welder and a tube notcher but no bender. The wheels, suspension, floor, ramp and cover bolt on afterward. Nothing has been ordered, bent or welded. Open on this frame: the round nose hoops are a smaller and softer section than the square tube they replace, the handle bar is welded where round crosses round, the square tubes that meet a hoop must be notched to it, and the printed cover clips and the latch keepers were drawn for square tube. The bolted frame remains the home build: one person with a saw and a drill, every tube straight, and every joint a flat plate cut by a mail-order laser service, three of them cut to the roof and pillar angles of the chosen setup. That is 62 plates and 172 bolted joints. Its kit carries 3D files of the tubes, packed into 8 sticks to saw apart, which passed one service's design check and were quoted at $1,195.44 for the set, about $766 more than bars cut and drilled by hand. It comes out about 6 kg heavier on paper and counts a little less. The reference maker's frame is not one piece either: its manual describes separate front, rear and middle frame tubes that pivot, click and latch so it folds.
- **Activities.** The studio has four one-tap setups that match the catalog: Walk with a swivel front wheel, Run with a fixed front wheel, Coast with wide 4 inch tires, and Snow with the wheels off, a ski on each rear axle and two tow shafts to a hip belt. The Snow kit is a concept: no ski is chosen and none of it has a supplier price.
- **Steering.** The base rails run about 330 mm past the cabin and carry four short posts and two cross beams. A 10 inch pneumatic swivel caster bolts under the beams.
- **Entry.** Buddy can no longer step up, so the tailgate is the ramp. At the starting size it is 1000 mm long and rises 140 mm to a 152 mm deck, about 8 degrees, with curb rails, a grip surface and printed threshold toes so there is no lip at the ground. The ramp stands on its own two feet under the threshold, so a dog's weight there goes to the ground instead of tipping the carrier. Ramp length is configurable and the design refuses anything steeper than 12 degrees.
- **Size.** The starting cabin is 1300 x 700 x 1000 mm clear (51.2 x 27.6 x 39.4 in), about 2.3 times the stated interior volume of the reference trailer, and it is cut-to-fit from 1000 to 1400 mm long.
- **Weather.** A one-piece pitched roof in solution-dyed fabric, taped roof seams, roll-down clear storm panels, shaded mesh windows, a high rear vent and a floor tub liner, each with a named, priced candidate material and the tests it still owes.
- **Running gear.** Two rear wheels on a repeated stainless hanger profile and a swivel caster at the front. The rear pick is a 15 inch pneumatic wheel (4.00-8) at an observed $32.89 whose supplier states ball bearings, a 5/8 inch bore, a 4 inch hub and a 435 lb load, so its axle can be drawn from stated numbers. The 13 x 4 inch wheel from the XL wheelchair is the budget option at $14.99, and a 20 inch run wheel remains an option with no verified candidate. Each has its own hanger profile on the same deck height. The brake is an open selection.
- **Printing.** Eleven printable service and fixture types plus seven fit-check copies of the metal profiles, generated natively and checked as closed single-body meshes.

Three findings need a decision before more design work:

1. **Cost and price.** The owner set the Run price to $999 on November 12, 2026, with Coast, Snow and All-season keeping their earlier steps above it. The counted cost of the starting design, welded with the sprung rear, is about $1,666 per carrier at 100 units and $3,093 for one, so at $999 every carrier would sell about $667 below its counted cost before any selling expense. Bolted, the same carrier counts $1,600 and $2,978. The one-carrier bolted figure uses a real laser quote for the plates, $551 for 62, about double the earlier allowance; the 100-carrier plate figure is still an allowance and is probably low. A 30% gross margin at $999 needs the cost at $699.30 or less. The [cost study](../business/rover-r0-costs.md) sets out why similar products retail near $800 and which levers would bring this one down; with all of them it lands near the price with no margin, and the rest needs a bent, folding, fabric-sided design made by a contract factory. With the bent tubes at a real mail-order quote, the welded frame counts about $66 more than the bolted one at 100 units and $116 more for one; neither closes the gap. Tube, wheels, caster, brake clamps, bolts, hinge, latches, leveling mounts, plywood and fabric are priced from supplier pages and the bent tubes from an instant quote; the welding and labor are still allowances, and no fabricator has quoted the frame. Materials for one bolted build come to about $2,063, most of it now priced from a supplier page or a real quote. That figure buys the tube as full-length bars cut in half to carry, at one online supplier's listed prices, which is $210 less than 8 ft bars by parcel. On November 12, 2026 the owner chose to keep the plates in 6061-T6 and not take a $167 saving from a softer alloy. Two comfort choices, the storm panels and the caster lock, would lower it by about $113 more; see the [buy list](../../designs/rover/r0/buy-list.md). Orders stay closed.
2. **Mass, steering and parking.** The estimate is about 46 kg (101 lb) empty for the welded frame and 52 kg (115 lb) bolted, well over twice the reference trailer. The sprung wheels sit further out, so it is about 1080 mm (42.5 in) wide over the axle ends. Steering is a 10 inch swivel caster on a raised nose, so the carrier turns by pushing the handle sideways; the priced caster has a swivel lock for running and states its mounting height. Parking is a push-pull toggle clamp on an arm over each rear tire, pressing a neoprene-tipped spindle onto the tread, with wheel chocks as a backup. That brake is drawn from standard parts and untested, and nothing slows the carrier while it moves. A dog standing at the tailgate still shifts the balance behind the axle, with tip-stop feet drawn but unproven.

The [build guide](../engineering/rover-r0-build-guide.md) walks one builder through ordering, cutting, drilling and assembly in order, with a base frame plan, a drilling schedule for every tube and a stock nesting plan.

The cost-down pass kept the cabin size, the ramp and the printed parts. It changed the wall fabric, closures, hardware finish, plywood grade, the tube source and cabin alloy, some tube walls and the default wheel, and each change has a stated trade-off in the [cost study](../business/rover-r0-costs.md). The Run configuration is now specified for fresh-water weather. Stainless fasteners and marine plywood come back as the salt-use upgrade for Coast.

## Customer and product job

Help an active caregiver bring a dog along when walking the whole route is unsuitable. Prioritize long-distance running and beach walks, with a dedicated winter conversion. Rover carries the dog; the wheelchair supports an eligible dog's own movement. Do not treat a carrier as a rehabilitation trainer.

Buddy's size makes cabin space and caregiver handling central. Interview runners with older or mobility-limited large dogs, beach walkers, rehabilitation professionals and winter-route users. Learn actual route conditions, dog dimensions, loading methods, storage constraints, repair experience and willingness to pay. Do not recruit dogs into unqualified equipment.

## Reference research

The founder identified the [Burley Bark Ranger XL Ski Bundle](https://burley.com/products/bark-ranger-xl-ski-bundle) as a reference. Its page displayed $900.91 on November 8, 2026, a 100 lb XL pet-and-cargo capacity and 20-inch wheels. Burley's [Ski Kit](https://burley.com/products/ski-kit) describes cross-country skiing and snowshoeing conversion and lists Bark Ranger XL compatibility. On November 11, 2026 the same Burley page listed an interior of 36.2 x 22.4 x 29.9 inches, a 33 lb trailer weight, a 33 inch maximum pet length, a 9 inch step-up at the tailgate, a 6.5 inch trailer drop and overall dimensions of 36.5 x 32.8 x 37.3 inches. Tree Fort Bikes listed the XL trailer alone at $729.95. Burley's standard-size figures could not be read that day and are not quoted. These facts describe Burley's products only. Do not transfer their ratings, compatibility, instructions, reviews or certifications to Rover.

Differentiate through large-dog cabin discovery, long-run handling, beach-serviceable running gear, repair architecture and total delivered cost. Independently engineer the chassis, conversion mounts and restraint system. Bicycle towing is a possible later module requiring separate hitch and dynamic validation; it is not included in the current Rover offer.

## Catalog architecture

| Configuration | Provisional USD price | Design contents |
| --- | ---: | --- |
| Run | $999 | Cabin, floor/liner, chassis, three running wheels, handle, brake and wrist tether |
| Coast | $1,049 | Run plus wider-wheel beach conversion and easy-clean floor/liner specification |
| Snow | $1,099 | Run plus skis, dedicated metal mounts, tow shafts and waist harness |
| All-season | $1,199 | Run plus both Coast and Snow conversion assemblies |

Each is a complete configuration, not an accessory-only purchase. Coast and Snow inherit the Run base; bundle calculations must not count its chassis or cabin twice. Final contents, assembly, price and delivered costs need qualification and quotes. These prices are not a public half-price or performance comparison with Burley.

The storefront deliberately publishes no untested payload, cabin dimensions, speed, distance, gradient, mass or folding-size rating. The planning brief should investigate a large-dog envelope beyond the reference's 100 lb class, followed by a separately qualified giant family. Select actual geometry from measured dogs and caregiver handling trials. Do not simply scale a 100 lb frame or assume Buddy fits.

## Mechanical architecture

Use a metal load-bearing chassis and floor with a defined load path through rated mechanical joints, axles and wheel or ski mounts. Keep the supported floor close enough to the ground to help loading without compromising required clearance. Assess a loading ramp or supported entry method independently. No unsupported jump-in requirement for a compromised dog.

A stable three-wheel running layout needs a positively retained, straight-tracking front assembly, appropriate wheelbase and track, handle ergonomics, controllable braking, a parking function and a secondary caregiver tether. Establish how it behaves if a brake cable, wheel retainer or primary connection fails. Do not rely on friction-only adjustments.

The cabin needs ventilation, adequate settled and seated space, secure closures, escape prevention and a restraint arrangement appropriate to the dog and the intended use. A shifted or standing dog changes the center of mass. Include paws, tail, leash, fur and clothing in the entrapment review. No vehicle-restraint, unattended-use, swimming or medical-treatment claim.

## Printable and serviceable parts

Use printed covers, guides, organizers and replaceable non-primary service parts first. Axles, forks, brake anchors, ski/tow connections and primary loaded joints require independently reviewed mechanical designs; a home print is not an acceptable substitution by default. Any printed safety-critical component needs qualified material, geometry, process, orientation, batch testing and traceability before release.

Design replaceable liners, fabric panels, wheels, bearings, brake components and conversion parts. Use captive hardware where practical, clear revision marking and service instructions. Evaluate corrosion isolation, drainage, cleaning, cold brittleness, UV, sand ingress and parts availability. A proprietary consumable should need a real functional reason.

## Route-specific qualification

| Track | Questions to resolve before release |
| --- | --- |
| Long-distance Run | Tracking and front-wheel shimmy, emergency stopping, braking temperature, dynamic dog movement, repeated impacts, tire/axle retention, handle fatigue, cadence clearance, rolling resistance and caregiver effort |
| Coast | Firm wet shoreline versus loose dry sand, wheel sinkage, steering and braking effort, side slope stability, salt/sand ingress, corrosion, drainage and cleaning; start with firm routes rather than assuming every beach is passable |
| Snow | Ski flotation and tracking, mount retention, articulation, tow-shaft loading, stopping and downhill push, icing, cold material behavior, harness release, thermal comfort and rescue handling |
| Common chassis | Static proof and fatigue, asymmetric loads, curb/threshold events within intended limits, tip stability, restraint/escape, floor support, thermal/ventilation conditions and setup mistakes |

An independent engineer defines fixtures, worst cases, acceptance limits, factors, sample counts and applicable standards before testing. Use ballast for proof, overload and failure exploration. A smooth-looking render or a component vendor's rating does not qualify the assembled carrier.

After bench approval, use an appropriate consented, professionally advised fit and handling study with defined stop rules. Evaluate the dog and the caregiver. Release each configuration's own payload, geometry, speed, distance, surface, slope, temperature and inspection limits. A passed Run chassis does not automatically qualify Coast, Snow or giant variants.

## Commercial and operational gate

Use [the reproducible economics](../business/rover-unit-economics.md) as a hypothesis. Obtain supplier, assembly and dimensional-freight quotes, including separate conversion packaging, before placing a production order. Include reject allocation, warranty/returns, support, seasonal inventory and replacement-part availability. The previous wheelchair startup budget does not include Rover engineering or tooling.

Qualify Run first, then Coast and Snow independently. Keep the software order gate until engineering, fit, manufacturing, instructions, support, inventory, shipping/tax/payment and incident response are ready. No paid preorder or reservation substitutes for that gate. Record the evidence with the change that enables orders.

## Software acceptance

Nine native product rows now cover five wheelchair sizes and four Rover configurations. Existing native Product/Cart/CartItem tables, signed cookies and server-side price lookup remain the commerce boundary. Wheelchair sizing continues to use only the five wheelchair records. Rover links, prices, contents, imagery, mobile purchase and mixed-basket totals are verified in the retained browser journey.

The Run image also illustrates Coast and All-season with an explicit shown-configuration caption. Snow has a separate visualization. Images are original generated design renders, not product photography or manufacturing evidence.
3. **Carrying children.** The owner asked for a conversion to carry two children. The reference maker's pet trailer page says nothing about children; its child trailer is a separate product, tested to a bicycle trailer standard, with 40 lb per child and 100 lb in total for two. A carrier for children is a children's product. In the United States a pushed one comes under 16 CFR part 1227, the Safety Standard for Carriages and Strollers, which requires ASTM F833-21, and it needs testing by a CPSC-accepted laboratory and a Children's Product Certificate before sale. The two-seat bench in the studio is therefore a layout concept only. Taking it further means a restraint and anchor design, a test plan with a laboratory and product liability cover, and that is the owner's call.
