stacksjs/buddy-wheels/docs/engineering/softgoods-xl-r1.md

# XL r2 rear support and front harness, textile revision 1

BENCH CUT/SEW PROTOTYPE. NOT FOR ANIMAL USE. No 140 lb capacity, fit, seam, anchor, buckle or pressure rating exists. These are actual reproducible candidate patterns and assembly geometry, not a qualified harness. Obtain anatomy, professional fit guidance and engineering review before any dog uses them. Not a lifting, vehicle-restraint or front-leg-support harness.

## Included design

A rear woven support saddle with two rounded leg openings, an open rear hygiene channel, removable foam and spacer-mesh lining; a padded front bib; chest and shoulder webbing; four rear suspension tails, two front tethers, reinforcing bands, closed frame wraps, protective chafe sleeves, metal adjuster envelopes and a front-only closure. Body load travels through the woven shell and reinforced webbing into metal frame members. The mesh is lining, not the sole support. Caps and printed fit-check parts carry no harness load.

## Exact selected dimensions

All mm. Saddle width 350, fore-aft length 220, frame-to-shell drop 90; shell plane Z530. Leg openings are rounded capsules 75 wide x120 long, centers Y+/-85.75. Each opening perimeter is approximately 325.6. This is a cut geometry readout, not a thigh-clearance recommendation. Padding, clothing, tissue, posture and load alter fit. Chest band centerline circumference 1065, before the added sewing/adjustment length. Front bib 159.75 wide x213 long, located near X-390, center Z556.1. The frame height follows the selected inspection pose; physical fabrication uses the baseline frame datums and a fitted support position.

## Material and cut schedule

Use textile-bom.csv for every piece, strap length, lap and hardware interface. Rear shell/mesh/foam use saddle-shell.svg; the front shell/mesh/foam use front-bib.svg. Body and cover-tab cut edges are bound; sleeve edges use their turned 10 mm seam allowance, so the outline is the raw cut line and contains NO extra fold allowance. Do not add an assumed 12 mm fold to the leg openings. Webbing cut lengths already include two 60 mm candidate sewing laps and adjustable tails where stated. Verify required adjustment travel with the actual fit and hardware before cutting load webbing.

The shell is woven polyester, the mesh is bought spacer mesh, the pad is 5 mm closed-cell foam, and the load tapes are 25.4 mm polyester webbing. Exact fabric grade, finish, thread, foam chemistry, metal adjuster/buckle SKU and strength remain RFQ and qualification items. Do not replace load webbing with grosgrain, mesh, printed straps or unverified elastic. The specified thicknesses are model envelopes, not approved supplier tolerances.

Print pattern-tiles.html from a browser at 100% / Actual Size, with headers/footers off. Letter and A4 both fit the 190 x240 mm tile. Verify the 50 mm scale bar with a ruler before cutting. Match coordinates and 10 mm overlaps; do not scale to fit. The SVGs use physical millimeters and DXFs declare millimeters. Each cut contour is chord-sampled by the native geometry kernel; use a fabric-safe finishing process, not a guessed laser setting.

## Candidate sewing sequence

1. Make paper and non-load mockups first. Record Buddy's supported groin height, actual chest girth, each upper-thigh circumference, hind-leg spacing and body length. Confirm anatomy, elimination clearance and skin sensitivity with the fitting professional. The starting settings are bench estimates.
2. Cut SG01-SG06 from the exact selected patterns and mark fore/aft, left/right and warp direction. Rear opening faces positive X. Keep the rear hygiene channel open. Inspect that seams or binding do not close a leg opening or migrate toward sensitive tissue.
3. Lay the rear reinforcing webbing under the woven shell, along the two side edges and front edge, with two separate rear cross pieces that stop 3 mm before each side of the hygiene channel. Retain 60 mm candidate sewing laps at their reinforced joins, directed along the webbing route rather than across a cut opening. Four suspension tails meet those reinforcements at the four corner zones. No tail may terminate on mesh or foam alone. Mark each overlap and keep its stitching clear of the leg openings.
4. Candidate bench stitch plan: bonded polyester Tex 90 thread, lockstitch, nominal 3 mm stitch length. Two independent stitch rows 4 and 8 mm from a bound cut edge; webbing overlaps use a 60 mm rectangular box with two diagonals and a second perimeter row. This is a reproducible coupon proposal, NOT a validated strength specification. Qualify exact material stacks, needle/thread/tension, machine settings, seam efficiency, tear-out and fatigue before approving production. If the sewing setup damages fibers, stop and redesign it.
5. Fit the rear pad and mesh over the woven support. Keep pad/mesh removable for inspection and cleaning using a bound cover opening and non-load hook-and-loop closure. Its closure must never substitute for structural stitching. Check seam bulk and bare-edge contact on a mock body, not Buddy.
6. Assemble the front bib layers with bound edges. Add chest and shoulder bands to the woven reinforcement. The front buckle closes restraint webbing only. Keep it outside rear body-support paths. Shoulder/chest routing is a layout candidate; the throat, axillae and foreleg motion must remain clear in the approved fit.
7. Sew the 12 chafe-sleeve panels into six sleeves with 10 mm seams, then fit them onto the frame wraps. Each wrap has a centerline perimeter plus two 60 mm return tails sewn to its reinforcement tab. Qualify those load seams as a stack, not a guessed simple end overlap. Rear wraps enclose the rear metal bridge/bracket stack; front support wraps enclose the side rails. Two L-shaped keeper runs, with reinforced corner joins, follow the outer side rails and then the rear bridge to tie their wraps together, so the system remains captured to the metal frame rather than a printed end cap. Keep these runs along the metal members, never diagonally through body space. Front-harness tethers have separate rail wraps. Assemble wraps before closing the frame if required. Do not force a loop over sharp metal, an adjuster or a pin head.
8. The studio shows nominal bracket/loop envelopes. Actual rail/bracket corners, fasteners, sleeve thickness and loop perimeter must be checked at every size. Webbing migration, edge loading and keeper extension require loaded fixture tests. These wraps are NOT approved anchors merely because they are drawn around metal. Do not drill extra frame holes or substitute hose clamps, printed buckles or snap clips without a reviewed redesign.
9. Thread metal adjusters using their actual manufacturer routing, with a captive sewn return and retained free tail. No approved adjuster SKU exists yet, so do not assume the pictured two-bar envelope is purchasable or slip-resistant. The model shows unthreaded placement below the tape; actual over/under routing follows the approved hardware drawing. In a guarded empty fixture, measure adjuster slip, tail pull-through, seam failure and anchor migration under an approved load protocol before any animal. Unload completely before adjusting/removing a support.
10. Qualify dry/wet/dirty/salt-exposed material stacks, abrasion over the actual metal finish, washing/drying, sweat/urine compatibility, sustained creep, cyclic loading, asymmetric entry and redundant capture. Measure loaded sag, pressure distribution, stride and stability using an approved clinical/engineering protocol. A raw-webbing breaking number or mesh upholstery rating is not a wheelchair/harness rating.

## Cost and manufacturing status

All SG items expand the existing complete-support T01 cost line. Do not count both a complete bundle and its subparts twice. The old $24 complete-set target is superseded. The current itemized material, reject, sewing and textile-freight estimate is $88.01 per set at 100 units. Read cost-notes.md for exact packs, candidate SKUs, missing stock/compatibility evidence and assumed labor. It is not a completed-harness supplier quote. Get an itemized manufacturing quote and replace the allowance before claiming the $265/$299 retail scenario is feasible. One-off material minimums, offcuts, shipping and a sewing machine are separate from consumed per-unit material. Colors: covers #254b38, textile trim #344c43. Black/reference materials may be the only currently listed stock colors; custom colors can require minimum orders.

## Files and reproduction

assembly-with-softgoods.scad includes your exact frame CAD and the generated textile assembly. softgoods/parts.scad exposes the six non-printable textile layers and editable dimensions. TEXTILE_REFERENCE_ONLY STLs are inspection volumes, never printable animal support. SVG/DXF files are cut patterns; source kernel.ts and export.ts regenerate the rear/front panel profiles with native Bun. Use the studio for a changed complete frame/strap/cut schedule; changing only a profile variable in parts.scad does not reroute the serialized strap geometry. The 3D view uses the same triangulated cut profile, not a cloth/pressure simulation. Load-path tapes, wrapping and hardware are nominal straight/envelope geometry, and fabric will deform under load.

Supplier references, checked November 8, 2026:
- [Seattle Fabrics Disco spacer mesh](https://www.seattlefabrics.com/56-Disco-3D-Spacer-Mesh-3300-linear-yard_p_96.html): listed $33 per linear yard, 56 inches wide, 0.5-yard minimum; the page exposes a waiting-list/out-of-stock notice. This is upholstery/lining evidence, not dog-support approval. Other colors may require full rolls. Do not quote it as available custom stock.
- [Sailrite webbing selection guide](https://directus.sailrite.com/assets/606b3c95-1846-4558-9ff8-a6b9a99b149a/Webbing_Specs_Chart.pdf): distinguishes webbing constructions. Confirm exact polyester grade, width, elongation, edge behavior and supplier lot. No raw-webbing figure qualifies our seams or anchors.
- [Walkin' Pets parts explanation](https://help.walkinpets.com/en-US/what-are-the-wheelchair-parts-842181): supports distinguishing rear support from the front harness. This is context, not an approval or a copied proprietary pattern.
