stacksjs/buddy-wheels/docs/product/customization.md

# Product choices and color preferences

Wheelchairs use size as a development fit starting point, not a load rating. Record anatomy with the fit guide. The studios expose actual manufacturing dimensions: rail height, center spacing, rail length, and measured wheel hub length where that axle design needs it. These do not represent a delivered, clinically fitted size or field adjustment. XL r1 and r2 are cut to fit; changing dimensions changes metal cuts.

R0 suspension leverage A/B/C changes shock attachment geometry. It does not select an approved shock tune or rehabilitation support force. XL r1 has no suspension control. XL r2 uses matched 0/1/2 mm preload shims, fixed 65.3 N/mm spring rate and no damper. Travel, plate separation and cutaway are inspection views. They are not product upgrades, predicted sag or clinical settings.

Rover Run, Coast and Snow choose running, beach or ski hardware. All-season includes the three gear configurations. None is a promise of validated terrain, distance, speed or load limits. Wheelchair dimensions and suspension controls are not offered on Rover.

## Colors

Forest, Ocean, Berry and Sunflower presets apply to nonstructural printed service parts. A native color picker also accepts any six-digit hex shade. Textile trim has an independent custom swatch. Metal, tires, bearings, springs, pins and other specified load-path materials keep their approved specification and reference finish. Only printable covers/markers/guards change color in 3D. The wheelchair studios now show candidate support and harness layers in the selected trim color. Their geometry is a bench layout, not a qualified fit. Product photographs and baseline CAD preview images retain reference colors.

Colors are preferences while products remain in development. Pigments and filament grade/process can affect print behavior; choosing a shade never authorizes a material substitution or load-bearing printed part. Textile availability, durability, validation and final custom pricing must be confirmed. The current cost models use reference finishes; do not claim arbitrary custom colors are qualified, stocked or free.

Your basket saves both color preferences. Identical product/finish combinations merge; different finishes stay separate. The five-per-product planning limit counts all colors, including quantity edits, when adding items or editing quantities. Links back to products restore the saved preference. No payment or order opens as a result of choosing colors.

Studio downloads carry finish.json, finish metadata in the setup/profile, selected assembly/BOM notes and refreshed archive checksums. Finish preferences change no CAD dimensions, source hash, STL/DXF geometry or material approval. Select print filament and textile trim against the saved finish instruction, subject to the engineering and procurement gates above.

## Choose and save a finish

1. Choose a wheelchair size with the [visual fit guide](https://buddywheels.org/fit-guide), or choose the Rover gear configuration for your routes. Measurements and professional fitting still come first.
2. Select Forest, Ocean, Berry or Sunflower for printable covers. To choose another shade, open Custom cover color. The hex value below the picker identifies your choice.
3. Choose Textile trim independently. This is a color preference for the candidate textile layers in the wheelchair studios. It does not recolor reference product photographs or approve a fabric or fitted harness.
4. Save the product to your basket, or open a studio and download your configured kit. Color choices travel with the product links and between studio revisions. Geometry settings stay specific to each revision.
5. Review the saved colors in your basket or finish.json. Confirm available, qualified materials and final pricing before manufacture or ordering. Ordering remains closed while development and validation continue.
