stacksjs/buddy-wheels/docs/marketing/product-marketing.md

# Product marketing context

Updated November 8, 2026. Canonical brief for Buddy Wheels.

## Product and evidence

Two product families: modular rear-support wheelchairs and Buddy Rover adventure carriers. The physical products remain at design stage. No tested chair/carrier, clinical evidence, customer orders, endorsements, certified rating or production files exist. The deployed software catalog, basket and fit guide are functional; payment and order placement remain gated.

Buddy is very large and stopped using his hind legs. Few available options offered a suitable size; cost mattered too. Do not invent his diagnosis, breed, age, recovery, fitted chair or photograph.

## Voice and current learning

The founder explicitly requested launch-style copy, without repeated planning language, dated price comparisons or competitor links in the shopping flow. Lead with what a caregiver can picture: a familiar walk, a place to ride, a frame worth repairing. Keep the warm, plain voice and the large-dog origin.

Use confident benefit-led headings and clear choices. Describe unverified performance as design intent. Put concise availability information at the product/basket/checkout boundary, with detailed product status and policies in the appropriate supporting pages. Do not repeat the entire validation checklist in every section.

Keep competitor pricing and research in project docs. The wheelchair price hypothesis remains approximately half the verified references internally; it is not a public superiority, equivalence or discount claim. Rover has its own configuration economics. Do not fabricate shipping, inventory, ratings, guarantees, testimonials, certifications or clinical results.

## Rover positioning

Buddy Rover is designed around long-distance running, beach walks and a dedicated winter conversion. Run, Coast, Snow and All-season are complete configurations. Large-dog room, repairability and suitable running gear are the positioning hypotheses. Cabin/load/speed/distance limits remain unpublished until validated. Cycling is a later separate research track.

## Design and implementation

Targeted evolution of the established light forest-green storefront. DESIGN_VARIANCE 4, MOTION_INTENSITY 2, VISUAL_DENSITY 4. Warm paper/sage surfaces, DM Sans, clear image-led product families and restrained hover feedback. No heavy animation or theme flips. Use STX, ts-css, native Stacks controls, server-rendered data and Iconify.

Keep /shop and existing size links working. Add /rover with query-selectable configurations. Both families use native catalog, signed basket and server-side prices. Provide a mobile purchase action, product-specific basket images/links, automatic quantity updates and a single clear availability step. No fake checkout progress, forced preview checkbox or payment form.

Product visuals are original generated design renders, disclosed once in the shared footer and supporting policies. Do not identify the generated dog as Buddy.

## Conversion and safety

Today: discover a family, choose a setup, check wheelchair starting size, save a basket and check availability. No orders, payments, deposits or reservations are accepted. Physical-product readiness and commercial operations must precede paid launch.

Wheelchairs and carriers serve different jobs. Do not prescribe rehabilitation through suspension stiffness, suggest universal terrain support or give an exercise regimen. Retain concise professional-fit guidance and urgent-care information on the fit/care surfaces.
