stacksjs/buddy-wheels/docs/business/research.md

# Research record

Checked November 7, 2026, America/Los_Angeles. Prices are USD product-page amounts observed during this session, not signed quotes or guaranteed future prices. Regional pricing, selected options, discounts and delivery can change them.

| Reference | Observed listed price | Proposed Buddy Wheels target | Comparison scope |
| --- | ---: | ---: | --- |
| [Walkin' Wheels Small](https://walkinpets.com/products/dog-wheelchair-small-adjustable-wheelchairs-for-dogs-with-disabilities) | $319.00 | S $159.50 | Half the observed small price; our proposed band and included services differ |
| [Walkin' Wheels Medium](https://walkinpets.com/products/dog-wheelchair-medium-adjustable-wheelchairs-for-dogs-with-disabilities) | $449.00 | M $224.50 | Half the observed medium price; no performance equivalence established |
| [Walkin' Wheels Large](https://walkinpets.com/products/dog-wheelchair-large-adjustable-wheelchairs-for-dogs-with-disabilities) | $529.00 | L and XL $264.50 | Both compared to the single large family; our L/XL split is our own proposal |
| XS reference | Not verified | $129.00 | Independent cost-led hypothesis; do not claim 50% savings |

The reference large product describes adjustable aluminum construction and a 70-180 lb band. It is a currently offered product; Buddy Wheels is a proposed design. A lower proposed price is not evidence of comparable safety, durability or fit. Do not copy their proprietary geometry, instructions, trademarks, photography, reviews or guarantee. Conduct an independent design and freedom-to-operate review before tooling or sales. No patent search or legal clearance has been completed.

## Animal care

The [Animal Emergency & Referral Center of Minnesota](https://www.aercmn.com/blog/my-dog-cant-walk-sudden-paralysis-in-dogs/) treats sudden inability to walk or get up as an emergency and advises immediate veterinary care. This supports our urgent-care message, not a diagnosis for Buddy. Buddy's diagnosis, examination, front-leg function, pain status, measurements and care plan are unknown. Do not infer IVDD, degenerative myelopathy or any other condition.

## US regulatory discovery

The [FDA's animal-device guidance](https://www.fda.gov/animal-veterinary/animal-health-literacy/how-fda-regulates-animal-devices) explains that animal devices remain under FDA oversight despite not requiring 510(k), PMA or premarket approval. Manufacturers remain responsible for safety, effectiveness and labeling. This is a planning summary; obtain qualified advice for product classification, claims, business location, destination markets and post-sale responsibilities. Do not describe the product as FDA approved. Do not assume US rules apply elsewhere.

## Material discovery

[Prusa's filament material guide](https://help.prusa3d.com/filament-material-guide), [PETG notes](https://help.prusa3d.com/article/petg_2059) and [polyamide notes](https://help.prusa3d.com/article/polyamide-nylon_167188) help narrow candidate materials and printing requirements. They do not validate a wheelchair, establish safe loads, prove skin contact suitability or provide this project's print profiles. Mechanical values depend on material brand, moisture, orientation, geometry, printer and process. All of those are uncontrolled until our own validation work is complete.

## Evidence still needed

No customer interviews, supplier quotes, pilot outcomes, veterinary endorsement, demand estimate, live CAC, repeat-purchase data, insurance quote, regulatory opinion or tested production BOM is available. Financial figures are explicit management assumptions. No primary evidence supports a claim that Buddy Wheels is the best, safest, clinically effective, all-terrain, chew-proof, suitable for every dog or ready to use.

The founder's brief supplies the genuine problem and the half-price ambition. Treat it as a reason to investigate and build, not proof of a market or safe design. Preserve a dated evidence ledger as interviews, supplier quotes and tests arrive. Refresh reference prices immediately before publishing any savings claim.
