stacksjs/buddy-wheels/designs/softgoods/r1/L-r0/softgoods/pattern-tiles.html

Rear saddle, column 1, row 1. 100% / Actual Size. 10 mm overlap. Verify 50 mm bar.

Rear saddle, column 2, row 1. 100% / Actual Size. 10 mm overlap. Verify 50 mm bar.

Rear saddle, column 1, row 2. 100% / Actual Size. 10 mm overlap. Verify 50 mm bar.

Rear saddle, column 2, row 2. 100% / Actual Size. 10 mm overlap. Verify 50 mm bar.

Front bib, column 1, row 1. 100% / Actual Size. 10 mm overlap. Verify 50 mm bar.

Front bib, column 2, row 1. 100% / Actual Size. 10 mm overlap. Verify 50 mm bar.

Cover tabs, column 1, row 1. 100% / Actual Size. 10 mm overlap. Verify 50 mm bar.

Rail chafe sleeves, column 1, row 1. 100% / Actual Size. 10 mm overlap. Verify 50 mm bar.

Rail chafe sleeves, column 2, row 1. 100% / Actual Size. 10 mm overlap. Verify 50 mm bar.

Bridge chafe sleeves, column 1, row 1. 100% / Actual Size. 10 mm overlap. Verify 50 mm bar.

Bridge chafe sleeves, column 2, row 1. 100% / Actual Size. 10 mm overlap. Verify 50 mm bar.
