stacksjs/buddy-wheels/public/designs/xl/r2/drilling.csv

Tube | Quantity | Axis | Centers from cut end mm | Nominal hole mm | Notes
Side rail | 2 | Y | 450 / 510 | 9.725 | T gusset x=-30/+30 at upright datum X=0
Side rail | 2 | Z | 570 / 630 | 9.725 | Rear T gusset X=120, rail holes X=90/150; separated from upright gussets
Rear bridge | 1 | Z | 22.3 / 47.3 / 327.3 / 352.3 | 9.725 | Gusset holes on each side; mirror about bridge center
Axle | 2 | radial | 8 / 154.4 | 3.2 | Do not drill until measured 82.55 mm hub, washer thickness and 0.5 mm end float verified
Wheel carriage | 2 | Y | 20 / 70 | 9.725 | Axle-patch sleeves, bottom datum
Wheel carriage | 2 | Y | 45 | 19.25 | Axle sleeve, bottom datum
Wheel carriage | 2 | Y | 147 to 155 | 8.2 | Capsule slot through both walls: 8 mm between end centers, total length 16.2 mm; finish tool, no 3D printed slot
Housing | 2 | Y | 55 / 205.35 | 8.2 | Lower travel pin and upper spring-seat pin, bottom datum. Do not put crush sleeves through slots
Housing | 2 | Y | 364.9 / 339.9 | 9.725 | Top T-gusset crush sleeves
