stacksjs/buddy-wheels/locales/README.md

# The Language Folder

This folder contains the language files for your application. If you are building an internationalized application, you should populate this directory with the appropriate language files.

To learn more about Stacks Internationalization, check out the [documentation](https://stacksjs.com).

> **Note**
> If your project does not require any routes, you can remove this folder._

## 🚜 Contributing

Please review the [Contributing Guide](https://github.com/stacksjs/contributing) for details.

## 🏝 Community

For help, discussion about best practices, or any other conversation that would benefit from being searchable:

[Discussions on GitHub](https://github.com/stacksjs/stacks/discussions)

For casual chit-chat with others using this package:

[Join the Stacks Discord Server](https://stacksjs.com/discord)

## 📄 License

The MIT License (MIT). Please see [LICENSE](../LICENSE.md) for more information.

Made with 💙
