stacksjs/buddy-wheels/public/audio/README.md

# Audio Files

This directory is intended to contain your audio files. You can organize them as you wish and may delete this folder if your project does not contain any audio files.

## 🏝 Community

For help, discussion about best practices, or any other conversation that would benefit from being searchable:

[Discussions on GitHub](https://github.com/stacksjs/stacks/discussions)

For casual chit-chat with others using this package:

[Join the Stacks Discord Server](https://stacksjs.com/discord)

## 📄 License

The MIT License (MIT). Please see [LICENSE](https://github.com/stacksjs/stacks/tree/main/LICENSE.md) for more information.

Made with 💙
