stacksjs/buddy-wheels/storage/framework/orm/README.md

# Stacks ORM

This package contains the Stacks ORM.

## ☘️ Features

- Based on your models
- Fully-typed
- Reusability

## 🤖 Usage

```bash
bun install -d your-orm
```

Now, you can use it in your project:

```js
import { orm } from 'your-orm'

// wip
```

To view the full documentation, please visit [<https://stacksjs.com/or>m](https://stacksjs.com/orm).

## 🧪 Testing

```bash
bun test
```

## 📈 Changelog

Please see our [releases](https://github.com/stacksjs/stacks/releases) page for more information on what has changed recently.

## 🚜 Contributing

Please review the [Contributing Guide](https://github.com/stacksjs/contributing) for details.

## 🏝 Community

For help, discussion about best practices, or any other conversation that would benefit from being searchable:

[Discussions on GitHub](https://github.com/stacksjs/stacks/discussions)

For casual chit-chat with others using this package:

[Join the Stacks Discord Server](https://stacksjs.com/discord)

## 📄 License

The MIT License (MIT). Please see [LICENSE](https://github.com/stacksjs/stacks/tree/main/LICENSE.md) for more information.

Made with 💙
