stacksjs/buddy-wheels/docs/business/rover-unit-economics.md

# Buddy Rover unit economics

Generated with bun run finance. No physical Rover has been manufactured or qualified. The owner set the Run price to $999 on November 12, 2026; Coast, Snow and All-season keep their earlier steps above it.

| Setup | Price | COGS | Freight | Fees | Reserve | Acquisition | Support | Contribution | COGS +20% contribution |
| --- | ---: | ---: | ---: | ---: | ---: | ---: | ---: | ---: | ---: |
| Run | $999.00 | $1,666.02 | $35.00 | $29.27 | $49.95 | $35.00 | $15.00 | -$831.24 | -$1,164.44 |
| Coast | $1,049.00 | $1,701.02 | $40.00 | $30.72 | $52.45 | $35.00 | $17.00 | -$827.19 | -$1,167.39 |
| Snow | $1,099.00 | $1,741.02 | $45.00 | $32.17 | $54.95 | $35.00 | $20.00 | -$829.14 | -$1,177.34 |
| All-season | $1,199.00 | $1,801.02 | $55.00 | $35.07 | $59.95 | $35.00 | $23.00 | -$810.04 | -$1,170.24 |

**Every row loses money.** The Run COGS is the counted cost of the r0 bench design at 100 units from the [r0 cost study](rover-r0-costs.md), which is higher than the price. Coast, Snow and All-season add the earlier target steps of $35, $75 and $135 for conversion kits that have not been designed. A 30% gross margin at $999 needs the cost at $699.30 or less; the cost study lists what it would take to get there.

Fees assume 2.9% plus $0.30; reserve assumes 5% of product revenue. Tax collected is not revenue. Freight, acquisition and support are management assumptions, not quotes, and the freight figures predate the mass estimate: they are low for a carrier of about 110 lb. The starting design is now a welded frame that ships assembled by truck, which these freight figures do not cover. Returns, dimensional freight and multi-box handling require actual quotes before purchasing inventory.

These contribution figures exclude fixed overhead and development costs. They do not change the wheelchair-only demand scenarios. Do not open orders at these prices until the counted cost is below them.
