stacksjs/buddy-wheels/public/images/buddy-meadow-640.webp

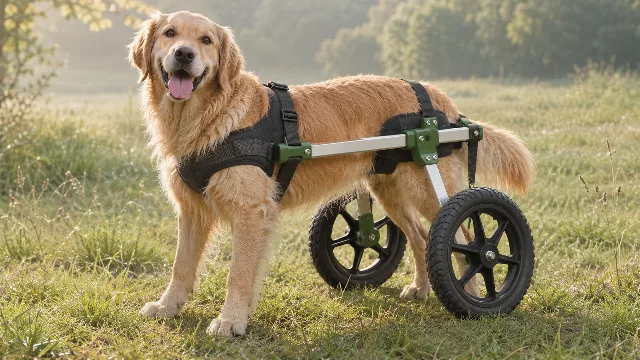
public/images/buddy-meadow-640.webp
