stacksjs/buddy-wheels/public/images/buddy-rover-640.webp

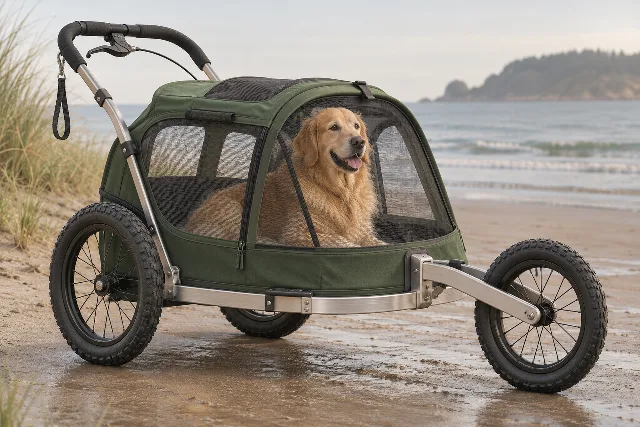
public/images/buddy-rover-640.webp
