stacksjs/buddy-wheels/public/images/buddy-rover-snow-640.webp

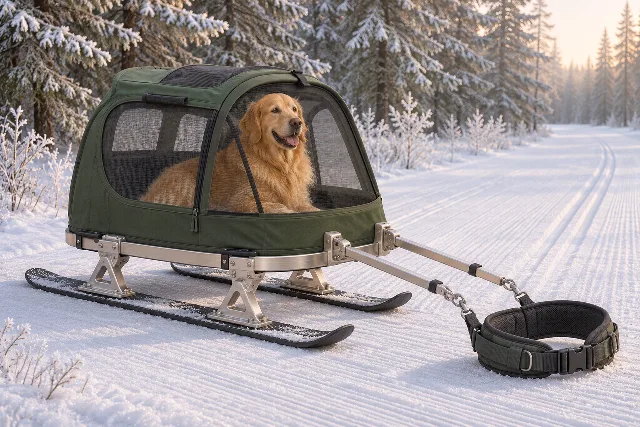
public/images/buddy-rover-snow-640.webp
