stacksjs/buddy-wheels/public/images/chair-concept-640.webp

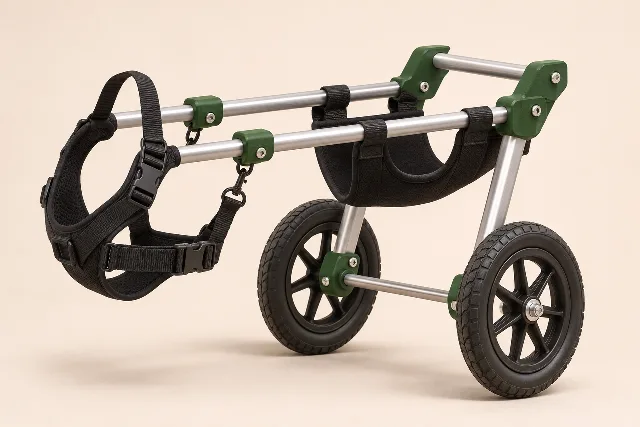
public/images/chair-concept-640.webp
