stacksjs/buddy-wheels/docs/business/rover-r0-costs.md

# Buddy Rover r0 cost study

Checked 2026-11-12, USD, integer cents, native Bun arithmetic. Configuration rover-r0-l1300-w700-h1000-r1000-a560-g1000-hub101.6-trail-swivel310-k350-t180-welded-sprung. This prices the r0 bench architecture. It is not a supplier quote, a production cost or a selling price, and nothing has been bought.

## Result

At 100 carriers the modeled landed manufacturing cost is **$1,666.02 each** at listed prices. A single build at retail quantities is **$3,093.25**. The first count of this design, on November 11, was $2,037.93 and $3,254.89, with 20 inch wheels, the original cover and most prices as allowances.

The owner set the Run price to $999.00 on November 12, 2026. At the counted cost that is $667.02 below cost on every carrier, before card fees, returns, support or freight. A 30% gross margin at that price needs the cost at $699.30 or less, so $966.72 has to come out. At today's cost the price that would carry a 30% margin is about $2,381.00.

If the tube is bought by weight, it drops again. $220.93 of the total is 21.8 lb of aluminum tube priced as 21 ft and 24 ft stock bars at $3.13 and $4.84 per foot. A 100-carrier batch is about 1.1 tons of two extrusions and would be bought from a mill or distributor. At an assumed $4.00 per pound with 8% scrap the tube line falls to $94.18 and the total to **$1,539.27**, which a price near $2,199.00 would carry. That rate is an assumption with no quote behind it.

For scale, the reference trailer sold for $729.95 at one retailer on the check date, with a 100 lb stated capacity and a 36.2 x 22.4 x 29.9 inch interior. Rover's cabin is about twice that volume. Rover does not reach that price in either scenario.

## Welded against bolted

The same carrier can be built two ways, with the same shape and the same running gear. The welded frame goes to a shop: each cabin side, the handle and each nose hoop is one round tube, cut and bent by a mail-order service, and the shop welds them to a square-tube base. The bolted frame is the home build: every tube is straight and every joint is a pair of flat plates. Both are counted with the same rules.

| | Welded | Bolted |
| --- | ---: | ---: |
| Counted cost each, at 100 | $1,666.02 | $1,600.05 |
| Counted cost of one | $3,093.25 | $2,977.64 |
| Frame tubes | 29 | 39 |
| Tube bends | 10 | 0 |
| Welded joints | 36 | 0 |
| Bolted joints | 8 | 172 |
| Plates to cut | 10 | 62 |
| Planning mass, kg | 45.9 | 52.3 |
| Ships | Assembled, by truck | Flat, in cartons |
| Who can build it | A shop with a TIG welder, from mail-order bent tubes | One person at home with a saw and a drill, plates by mail order |

On these counts the welded frame comes out $65.97 more each at 100 and $115.61 more for one. That gap is smaller than the uncertainty in the welding figure, which nobody has quoted. At 100 it trades about $230.77 of plates, bolts, sleeves and drilling time, and $126.06 of bar stock, for $162.00 of welding, $240.80 of bent tubes and $20.00 more packaging. What the shop build buys is about 6.4 kg less mass, 10 fewer tubes, no plates, joints with no bolt clearance to work loose, and a frame that arrives in one piece. What bolting buys is that nothing leaves the house except the plate order. The welding figure is arithmetic on an assumed shop rate; no fabricator has quoted it. The bent tube figure is a mail-order service's instant quote at prototype prices, which a production tube bender should beat in a batch. Outbound freight for an assembled frame is not in either column.

## What changed since the first count

| Change | Effect at 100 carriers | Trade-off |
| --- | ---: | --- |
| Wall fabric: a $6.50 PVC-coated 600 denier polyester under the roof overhang, with the solution-dyed fabric kept for the roof | about -$85 | Walls will fade and carry no stated UV rating |
| Hook and loop instead of six zippers; roof liner made optional; corner seams lapped, not taped | about -$55 | Storm panels are slower to close; less sun insulation unless the liner is added |
| Listed quantity tiers used where the batch reaches them: wall fabric, liner, clear panel rolls | about -$20 | None. They are published prices |
| Sewing time 240 to 200 minutes | -$20.00 | An assumption either way |
| Zinc-plated grade 5 hardware for Run, at prices read on the supplier page; stainless becomes the salt-use upgrade | about -$81 | Add $1.84 for stainless before beach use. Cut sleeves are still an allowance |
| Exterior ACX plywood at an observed $52.00 a sheet instead of marine | -$73.00 | Marine plywood returns for salt use |
| Intermediate cross members and ramp ribs in thin-wall tube | about -$40 | Members checked by hand arithmetic only |
| One gusset instead of two at the eight corner-post joints | -$12.80 | Corner posts carry the cover, not the dog |
| Assembly time 6 to 5.5 hours | -$12.50 | An assumption either way |
| A 15 inch pneumatic wheel at an observed $32.89, with ball bearings, a stated hub length and a 435 lb supplier load figure, instead of a $60 allowance for a 20 inch wheel nobody has found | -$81.33 | Smaller than a running wheel. The 13 inch path wheel at $14.99 saves a further $53.70; the 20 inch wheel stays as an option |
| Tube bought as 21 ft and 24 ft stock bars at prices read on the supplier page, with the cabin and secondary members in 1/16 inch 6063-T52 | about -$136 | 6063-T52 is softer than 6061-T6, so it is kept out of the chassis. Long bars ship by truck |
| A swivel front caster with a swivel lock on a raised nose, in place of the fixed fork and third wheel | about +$63 | Steers without lifting. Adds about 2 kg and twelve gussets |
| A parking brake: a toggle clamp on an arm over each rear tire | about +$60 | Untested as a brake. Nothing slows the carrier while it moves |
| Hinge, latches, leveling mounts, sleeve tube, axle parts and chocks priced from supplier pages instead of allowances | about +$20 | The allowances were low |

## Where the money goes

| Line | One carrier | 100-carrier allocation | Evidence |
| --- | ---: | ---: | --- |
| Aluminum tube, whole stock bars with kerf | $298.05 | $220.93 | Observed 2026-11-12 |
| 2 brake clamp plates, laser cut 1/8 inch 6061 | $27.32 | $3.20 | One carrier: quoted 2026-11-12. Batch: allowance |
| 36 TIG welded joints by a fabrication shop | $540.00 | $162.00 | RFQ |
| 5 round tubes cut and bent by a mail-order service, 10 bends, and 2 end plugs | $443.39 | $240.80 | Quoted 2026-11-12 |
| 2 pneumatic trail wheels, 15 inch 4.00-8 | $65.78 | $65.78 | Observed 2026-11-12 |
| Front swivel caster with swivel lock, 10 inch pneumatic, and four bolts | $67.69 | $66.89 | Observed 2026-11-12 + nut and sleeve allowance |
| 2 stock-shaft axles, sleeves, spacers, washers and cotters | $26.44 | $10.47 | Observed 2026-11-12, rod from a listing |
| 8 sleeved bolted joints | $36.20 | $4.66 | Observed 2026-11-12 |
| Floor and ramp panels, sealed 15/32 inch ACX plywood | $77.00 | $64.00 | Observed 2026-11-12 + sealing allowance |
| Hinge, two latches, carriage bolts and strap hardware | $51.19 | $48.99 | Observed 2026-11-12 + strap allowance |
| Wheel chocks, grip, tip-stop feet, floor fasteners, bedding tape and ridge pole | $105.77 | $83.77 | Observed 2026-11-12, partly from listings |
| Parking brake: two push-pull toggle clamps with neoprene-tipped spindles | $31.70 | $25.58 | Observed 2026-11-12 + screw allowance |
| Rear suspension: two coil-over shocks, eight bolt-on mount plates, pivot bolts, bushings and mount bolts | $130.66 | $90.48 | Observed 2026-11-12 + hardware allowances |
| Printed service parts and fixtures | $27.00 | $23.00 | Computed volume + allowance |
| Cutting, the few drilled holes, deburring and assembly labor | $150.00 | $62.50 | RFQ |
| Per-carrier inspection | $25.00 | $12.00 | RFQ |
| Packaging | $60.00 | $45.00 | RFQ |
| Inbound freight allocation | $90.00 | $30.00 | RFQ |
| Machine wear and shop consumables | $10.00 | $6.00 | RFQ |
| Weather cover, floor set and ramp surface | $830.06 | $399.97 | Listed materials + assumed sewing |
| **Landed manufacturing** | **$3,093.25** | **$1,666.02** | Mostly unquoted |

- **2 brake clamp plates, laser cut 1/8 inch 6061:** One aluminum profile. The welded frame has no gussets. For one carrier this is OSH Cut's instant-quote price in 6061-T6, $13.66 a plate, read 2026-11-12 with only this frame's ten plates and five bent tubes in the cart. The same plate was $12.23 in the larger order for the bolted frame. The batch figure is an allowance of $1.60 a plate with no quote behind it.
- **36 TIG welded joints by a fabrication shop:** No shop has quoted this. Batch: 3.5 minutes a joint on a jig at $70 a shop hour, plus a $15 share of the jig. One frame: 10 minutes a joint at $90 an hour, fit-up included. A real quote replaces all of it.
- **5 round tubes cut and bent by a mail-order service, 10 bends, and 2 end plugs:** OSH Cut's instant quote for the starting setup, read 2026-11-12: the tube itself in 1 inch OD x 1/8 inch wall round 6063-T52, cut and bent at a 3 inch centerline radius. For one carrier: $100.50 a side hoop, $116.09 for the handle bar and $61.65 a nose hoop. At the quantities for 100 carriers: $61.45, $58.04 and $28.43. Every part passed the service's design check; nothing was ordered. Other sizes are that quote scaled by tube length, not quoted. A production tube bender would be asked for a batch price. The two end plugs for the handle bar are a $1.50 allowance each.
- **2 pneumatic trail wheels, 15 inch 4.00-8:** $32.89 each, no bulk discount assumed. Ball bearings, 5/8 inch bore and a 4 inch hub are stated by the supplier.
- **Front swivel caster with swivel lock, 10 inch pneumatic, and four bolts:** Service Caster SCC-100S3504-PNB-BSL at $64.69: 12-3/16 inch mounting height and 350 lb stated, with a bolt-on swivel lock. Plate size and bolt pattern are not on the page.
- **2 stock-shaft axles, sleeves, spacers, washers and cotters:** One 5/8 inch x 3 ft plain steel rod at $20.57 (store listing), 12 inches of 3/4 inch DOM tube at $4.99, 5/8 inch washers at $0.15 and cotters at $0.07.
- **8 sleeved bolted joints:** Zinc-plated grade 5 bolts, lock nuts and washers at Bolt Depot prices: per 1,000 for the batch, whole boxes of 100 for one build. Sleeves are cut from 3/8 inch x .049 DOM steel tube at $11.66 per 6 ft.
- **Floor and ramp panels, sealed 15/32 inch ACX plywood:** 1 sheet at $52.00 plus edge and face sealing. Offcuts are charged.
- **Hinge, two latches, carriage bolts and strap hardware:** Stainless piano hinge 2ZFK4 at $18.19, two Southco TL-20-202-52 stainless draw latches at $11.89, carriage bolts at $0.16. The ramp legs end in printed caps, so they need no feet or inserts. The strap hook is a $4.00 allowance.
- **Wheel chocks, grip, tip-stop feet, floor fasteners, bedding tape and ridge pole:** Two rubber chocks at $7.49, foam grip tube at $1.95 per 6 inches, two tall leveling mounts at $11.59, rivet nuts at $16.87 per 100, foam strip at $18.99 per 50 ft. Floor screws and the ridge pole are allowances.
- **Parking brake: two push-pull toggle clamps with neoprene-tipped spindles:** POWERTEC 302F at $10.70 each, $7.64 in a six-pack, 300 lb holding capacity and a 5/16-18 plunger thread stated. DE-STA-CO 507208 neoprene-tipped spindle, 5/16-18, at $4.15 each.
- **Rear suspension: two coil-over shocks, eight bolt-on mount plates, pivot bolts, bushings and mount bolts:** LvTu 150 mm coil-over at $31.05 each, read on its product page: 30 mm travel, 24 mm wide eyes with an 8 mm bore, springs labeled 150 to 650 lbs. The label is the seller's nominal figure with a rider-weight table, not a measured rate. Bunting EF081008 bronze flanged bearings at $5.29 per pack of three (a listing price) and 1/2-13 x 4 inch grade 5 bolts at $1.64 with $0.41 lock nuts. The mount plates are priced from the one-carrier laser quote, about $5.46 each, and are an allowance in the batch. The pivot crush sleeves, washers, M8 eye bolts and long hanger bolts are allowances. The swing arms and spacer tubes are counted in the tube line.
- **Printed service parts and fixtures:** About 1.3 liters of solid part volume, most of it the three ramp toes. Priced as consumed filament with a reject reserve, not a printer.
- **Cutting, the few drilled holes, deburring and assembly labor:** Batch: 2.5 h at $25/h. One-off: 6 h. Angled cuts on six pieces, about 40 tube-wall holes, then the bolt-on parts. Welding is its own line. Timing assumptions, not observed.
- **Per-carrier inspection:** Does not replace engineering qualification.
- **Packaging:** A welded frame does not pack flat: one carton about the size of the cabin. Outbound freight is separate and for a box this size it is truck freight, not parcel.
- **Inbound freight allocation:** Truck freight for long bars in a batch. For one build, delivery of the parts, with the tube collected from a local supplier. Unquoted.
- **Machine wear and shop consumables:** Drill bits, blades, jig wear.

Tube packing at 100 carriers: 94 bars of 1/16 inch wall, 21 ft each, and 137 bars of 1/8 inch wall, 24 ft each. One carrier needs 1 and 2 whole bars.

## Cover and soft goods detail

| Material line | One carrier | 100-carrier allocation | Purchased for 100 |
| --- | ---: | ---: | --- |
| Roof shell, one piece | $30.56 | $18.49 | 121 whole linear yards |
| Wall shell: sides, front, header and gussets | $26.00 | $17.24 | 390 whole linear yards |
| Mesh: three windows and the rear vent | $35.90 | $23.88 | 133 whole linear yards |
| Clear storm panels | $89.35 | $10.67 | 140 yards, bought as 60-yard and 10-yard rolls |
| Floor tub liner and threshold flap | $19.92 | $12.51 | 161 whole linear yards |
| Two floor pad halves | $63.00 | $63.00 | 200 39 x 51 inch sheets |
| Ramp traction surface | $90.95 | $45.48 | 50 27 x 94 inch sheets |
| Hook tape | $17.38 | $16.22 | 1026 yards |
| Loop tape | $17.38 | $16.22 | 1026 yards |
| Roof seam tape | $11.56 | $10.15 | 351 meters |
| Reflective trim | $5.90 | $5.17 | 175 2.2-yard packs |
| Roof hem shock cord | $5.20 | $4.49 | 431 yards |
| Four stainless D-rings | $6.20 | $6.20 | 400 each |
| Tether, grab loop, ties and wrist strap | $14.80 | $12.39 | 16 120-foot rolls |
| Thread allowance | $15.95 | $2.40 | 15 cones |
| Reject reserve, 10% | $45.01 | $26.46 | |
| Sewing labor at $30/h | $270.00 | $100.00 | 540 min one-off, 200 min batch, assumed |
| Textile freight | $65.00 | $9.00 | Unquoted |
| **Total** | **$830.06** | **$399.97** | |

Material prices are the listed prices in [the materials sheet](../product/rover-materials.md). A listed quantity tier is used only where the 100-carrier purchase actually reaches it; no unlisted discount is assumed.

## What was and was not observed

- [Metals Depot T3118-6061, 1 x 1 x 1/8 inch 6061-T6 square tube](https://www.metalsdepot.com/aluminum-products/aluminum-square-tube): **$116.16**, one 24 ft bar. Read in a browser 2026-11-12: $116.16, in stock, about $4.84 per foot. Chassis members. No quantity break shown. A 24 ft bar ships by truck.
- [Metals Depot T31116, 1 x 1 x 1/16 inch 6063-T52 square tube](https://www.metalsdepot.com/aluminum-products/aluminum-square-tube): **$65.73**, one 21 ft bar. Read in a browser 2026-11-12: $65.73, in stock, about $3.13 per foot. Cabin and secondary members. 6063-T52 is softer than 6061-T6; Online Metals 6061 in .065 wall was $60.03 per 12 ft, about $5.00 per foot.
- [Zoro Select 1NWV4 pneumatic wheel, 4.00-8](https://www.zoro.com/zoro-select-pneumatic-wheel-15-316dia-435lb-400-8-1nwv4/i/G1932594/): **$32.89**, one complete wheel. Read in a browser 2026-11-12: $32.89. Supplier states 15 3/16 inch diameter, 3 1/8 inch width, ball bearings, 5/8 inch bore, 4 inch hub length and a 435 lb load. Weight not stated. The rating does not rate the carrier.
- [HAUL-MASTER 67467 pneumatic wheel, 13 x 4 inch](https://www.harborfreight.com/13-inch-x-4-inch-pneumatic-tire-67467.html): **$14.99**, one complete wheel. Read in a browser 2026-11-12: $14.99. 5/8 inch bore, 4.7 lb, supplier working load 300 lb. The page states no bearing type or hub length.
- [Bolt Depot 328, 1/4-20 x 2 inch grade 5 zinc hex bolt](https://boltdepot.com/Product-Details?product=328): **$16.25**, per 100; $143.00 per 1,000. Read in a browser 2026-11-12. Lock nut 2624 is $5.19 per 100 and $45.70 per 1,000. SAE washer 2976 is $3.10 per 100 and $24.80 per 1,000. The 18-8 stainless bolt 133 is $30.75 per 100.
- [Service Caster SCC-100S3504-PNB-BSL, 10 inch pneumatic swivel caster with swivel lock](https://www.zoro.com/service-caster-10-inch-black-pneumatic-wheel-swivel-caster-with-bolt-swivel-lock-scc-100s3504-pnb-bsl/i/G705434817/): **$64.69**, one caster. Read in a browser 2026-11-12: $64.69, in stock, 12-3/16 inch mounting height, 350 lb, bolt-on swivel lock. Plate size, bolt pattern and swivel radius are not on the page.
- [POWERTEC 302F push-pull toggle clamp, 20304N](https://www.zoro.com/powertec-toggle-clamp-300lbs-cap-302f-quick-release-pushpull-clamp-20304n/i/G714915420/): **$10.70**, one clamp; $45.85 per six. Read in a browser 2026-11-12: 300 lb holding capacity, about 1-5/16 inch of plunger travel, 5/16-18 plunger bolt, base 3-1/2 x 2-3/16 inch. Used as the parking brake on each rear tire.
- [Zoro Select 2ZFK4 stainless piano hinge, 1 inch leaf x 36 inch](https://www.zoro.com/zoro-select-piano-hinge-stainless-steel-full-surface-mounting-1-in-leaf-w-x-36-in-leaf-h-stainless-steel-2zfk4/i/G1671966/): **$18.19**, one hinge. Read in a browser 2026-11-12: $18.19, 0.06 inch thick, 2 inch open width, unpunched. Also read: Southco TL-20-202-52 stainless draw latch $11.89, S&W BSW-1Z 3/8-16 swivel leveling mount $6.15 and $11.59, Online Metals 3/8 inch x .049 DOM tube $11.66 per 6 ft and 3/4 inch x .065 DOM tube $4.99 per foot, Harbor Freight 96479 rubber wheel chock $7.49.
- [Home Depot 15/32 inch x 4 x 8 ft ACX radiata pine sanded plywood, model 80496](https://www.homedepot.com/b/Lumber-Composites-Plywood/15-32/N-5yc1vZbqm7Z1z0mcqq): **$52.00**, one sheet. Read on a store category listing 2026-11-12: $52.00, in stock at one Los Angeles area store. Store prices vary.
- [Burley Bark Ranger XL at Tree Fort Bikes](https://www.treefortbikes.com/Burley-Bark-Ranger-XL-Pet-Bike-Trailer): **$729.95**, one complete trailer, reference only. Observed $729.95. A bike trailer with a stroller kit, 100 lb stated capacity. A market reference, never a Rover cost input.
- [Burley Bark Ranger XL Ski Bundle](https://burley.com/products/bark-ranger-xl-ski-bundle): **$900.91**, one bundle, reference only. Observed $900.91 sale price. Source of the stated 36.2 x 22.4 x 29.9 inch interior, 33 lb weight and 9 inch step-up.
- [LvTu 150 mm coil-over rear shock](https://www.amazon.com/LvTu-Bicycle-Absorber-Suspension-Bushing/dp/B0CH6DCCPS): **$31.05**, one shock. Read in a browser 2026-11-12: $31.05 on the product page, one review. The seller states 150 mm length, 30 mm travel, 24 mm eye bushings with an 8 mm bore and spring options labeled 150, 250, 350, 450 and 650 lbs. Those labels come with a rider-weight table and are not verified spring rates. Damping, life and corrosion resistance are not stated.
- [Bunting EF081008 bronze flanged sleeve bearing, 1/2 x 5/8 x 1/2 inch, pack of 3](https://www.zoro.com/search?q=oil+impregnated+bronze+flanged+sleeve+bearing+1%2F2+x+5%2F8+x+1%2F2): **$5.29**, one pack of three. Seen 2026-11-12 on a Zoro listing, not a product page: $5.29 per three. The listing says bronze and does not say oil-impregnated.
- [Bolt Depot 399, 1/2-13 x 4 inch grade 5 zinc hex bolt, and 21807 lock nut](https://boltdepot.com/Product-Details?product=399): **$1.64**, one bolt. Read in a browser 2026-11-12: bolt $1.64 each or $277.00 per 250; nylon-insert lock nut $0.41 each or $127.00 per 500. Swing arm pivots.
- [Burley D'Lite X child trailer, reference only](https://burley.com/collections/strollers-skis/products/dlite-x): **$799.95**, one trailer, base price shown. Read 2026-11-12. The page says adjustable suspension without describing the mechanism or travel. Double model: 40 lb per child, 100 lb total, 26 inch shoulder width, 24 inch seated height, and a statement that it is designed and tested to ASTM F1975-09. This is the maker's child product. Its pet trailer page mentions neither suspension nor children.
- [OSH Cut tube laser, all 39 frame tubes of the starting bolted setup, cut and drilled](https://app.oshcut.com): **$1,195.44**, one set, as 8 sticks to saw apart, standard lead. Read 2026-11-12 on the instant-quote page after uploading the STEP files from the kit. Every file was recognized as a tube, passed the design check and was matched to its material automatically. As 20 separate tubes the set was quoted at $1,405.06. Packed into 8 sticks with the same holes, to be sawn apart at 25 marked lines, it was quoted at $1,195.44. Subtotals before shipping and tax, which the page shows only after sign-in. Bars for the same tubes cost $639.68. Nothing was ordered.
- [OSH Cut laser-cut plates for one starting bolted carrier, 1/8 inch 6061-T6](https://app.oshcut.com): **$551.22**, all 62 aluminum plates. Read 2026-11-12 on the same page after uploading the eight DXF files: 30 corner gussets at $9.47, 12 tee gussets at $8.19, 10 angled gussets at $10.15 to $12.43, 2 brake plates at $12.23 and 8 shock mount plates at about $4.45. All passed the design check. The same plates in 5052-H32 came to $383.84. With the eight tube sticks the whole metal order was $1,746.66 at the standard lead of 7 business days, $2,357.87 at 6 and $2,532.72 at 5, before shipping and tax. Nothing was ordered.
- [OSH Cut order for one starting welded carrier: 5 bent round tubes and 10 plates](https://app.oshcut.com): **$511.39**, the whole cart, standard lead. Read 2026-11-12 with only the welded frame's parts in the cart: 2 side hoops at $100.50, 1 handle bar at $116.09 and 2 nose hoops at $61.65 in 1 inch round 6063-T52, and in 1/8 inch 6061-T6 2 brake plates at $13.66, 4 shock plates at $5.51 and 4 shock hangers at $5.41. The ten plates came to $71.00 against $60.06 when they shared an order with the bolted frame's 52 gussets. All six lines passed the design check. Standard lead was 6 business days; expedited $690.38 and rush $741.51. Before shipping and tax. Nothing was ordered.
- [Mutual Screw FC1198-25-S-12 round spacer, 3/8 OD x 1/4 ID x 1 inch, clear zinc steel, pack of 250](https://mutualscrew.com/products/spacers-3-8-od-x-1-1-4-hole-steel-clear-zinc_fc1198-25-s-12): **$184.32**, one pack of 250. Read in a browser 2026-11-12: $184.32 per 250, $0.74 each. The same size as the bolt sleeves, ready cut. The page gives the hole as 1/4 inch with no tolerance, so check that a 1/4 inch bolt slides through before relying on it.

- Tube for one build: the supplier ships bars over 8 ft by truck, so the one-carrier scenario buys 8 ft bars at $58.08 for the 1/8 inch 6061-T6 and $41.60 for the 1/16 inch 6063-T52, both read on the supplier page. The batch buys 24 ft and 21 ft bars.
- Run wheels: $60 each is an allowance. No 20 inch pneumatic wheel with a 5/8 inch bore and a suitable rating was found, so the 20 inch wheel remains an open selection.
- Plates: no quote was run. OSH Cut shows instant pricing for uploaded DXF files without an account; SendCutSend lists .125 inch 6061-T6 and .125 inch 304 stainless, accepts DXF, has no minimum quantity and ships laser parts in 1 to 3 days, but asks for a sign-up. Uploading the files is left to the owner, so the gusset, brake plate and hanger lines stay allowances.
- Front caster: the maker's shop page for the same caster series lists a 4 x 4-1/2 inch top plate, bolt holes at 2-5/8 x 3-5/8 inch slotted to 3 x 3 inch, 3/8 inch mounting bolts and a 12-3/16 inch mounting height. The design puts the beams 85.7 mm apart and the holes 70 mm apart, inside those slots. Its swivel radius is not published; the 185 mm sweep comes from CasterHQ CB-SPC10, a same-size caster that states 7-1/4 inch. The maker sells the version without a swivel lock at $41.38, and Harbor Freight 63799 is $19.99 with no stated height.
- Parking brake: a push-pull toggle clamp on an arm over each rear tire, with a neoprene-tipped spindle whose 5/16-18 thread matches the clamp plunger. The spindle tip is listed at 0.83 inch on one page and about 0.5 inch elsewhere. The clamp, the plate it hangs on and the arm are untested as a brake. Two rubber chocks stay in the kit for slopes.
- Still allowances: the tailgate strap hook, floor screws, the ridge pole (the 4 ft store length is too short for the starting cabin), clamp screws, and caster nuts and sleeves.
- Listing prices, read on a search or category page and not a product page: 5/8 inch steel rod $20.57, rivet nuts $16.87 per 100, foam grip $1.95 per 6 inches, foam strip $18.99 per 50 ft.
- Stainless option: the stainless bolt is an observed $30.75 per 100. Stainless nuts and washers were not priced; the $0.23 per joint upgrade includes a $0.10 allowance for them.
- Sprung rear: the travel, sag and spring figures are arithmetic from the drawn arm geometry and an assumed spring rate. No shock has been fitted, no ride has been measured, and no comparison with any other product is claimed. The parking brake presses on a tire that now moves with the load, which is unresolved.
- Axle sleeve fit: the linked 3/4 inch x .065 wall DOM tube is 0.620 inch inside, 0.005 under the 5/8 inch axle. Ream it to 5/8 or buy .058 wall, 0.634 inside, which the drawn numbers assume.
- Laser quotes: on 2026-11-12 the tube and plate files for the starting bolted setup were uploaded to OSH Cut with the owner's permission. All passed its design check. These are quotes for one carrier on one day, before shipping and tax, and nothing was ordered. No other setup, and no batch quantity, has been quoted. The counted one-carrier total uses the quoted plate prices and still assumes stock bars cut and drilled by hand, because that is the cheaper way to get the tubes.
- Tube for one carrier: priced as full 21 ft and 24 ft bars at the listed long-bar prices, each cut in half by the supplier to carry. Those prices are one online supplier's for bars that ship by truck. A local supplier's counter price was not checked and may be higher or lower. The same tube as 8 ft parcel bars costs more and is shown as the alternative.
- Plate alloy: the owner chose to keep the plates in 6061-T6 on 2026-11-12. The 5052-H32 quote stays on record as a price only.
- Welded build: the welding line is arithmetic on assumed shop rates and minutes per joint. No fabricator has seen the drawings. A welded frame also ships assembled, and outbound truck freight for a carton that size is not in any total here.
- Mill-quantity tube: the second total prices tube by weight at $4.00 per pound plus 8% scrap. That rate is an assumption with no quote behind it. The listed-price total stays the headline until a mill or distributor quote exists.

## How others sell near $800, and what it would take here

This section is reasoning from general practice in consumer goods. None of its numbers is a quote or something read on a supplier page, and each is marked as an estimate.

A trailer that retails near $730 is typically built for a small fraction of that. The retailer and the brand each take a margin, so a common rule of thumb puts factory cost at a quarter to a third of the shelf price. Makers reach that with:

- **Volume and a contract factory.** Thousands of units a run, made where assembly labor costs a few dollars an hour, shipped flat in containers.
- **A frame that is bent and welded on jigs.** A handful of tubes, bent once and welded, with almost no fasteners. This frame is welded too, but by hand from 29 straight pieces, one joint at a time: 36 joints, no bends and no tooling.
- **Fabric as the body.** The cabin walls and often the floor are sewn fabric hung on that frame, sewn at the same low labor rate from fabric bought by the roll.
- **Tooling spread over many units.** Molded hubs, joints and wheels cost cents each once the mold is paid for.
- **Material bought by the ton.** Aluminum extrusion at mill prices by weight, not cut bars at $3 to $5 a foot.

Rover r0 is the opposite on every point: one-off architecture, retail material prices, United States labor rates and a rigid box cabin twice the size.

What each lever would do to the $1,666.02 counted cost, as estimates:

| Lever | Estimated effect | What it needs |
| --- | ---: | --- |
| Tube bought by weight from a mill or distributor | about -$126.75 | A quote. The study assumes $4.00 per pound |
| Have the cover cut and sewn by a contract shop from roll goods | about -$135 | A sewing quote on a sample |
| Front caster without a swivel lock, from its maker at $41.38 | -$23.31 | Accepting walking pace only |
| 13 inch wheels at $14.99 | -$35.80 | Accepting a rougher roll |
| **All of the above** | **about $1,345.16** | |

That is about the $999.00 price with no margin left. Getting to $699.30, a 30% margin, takes about another $645.86 out. On this architecture there is no obvious place to find it. The realistic route is the one the cheaper products take: a bent and welded folding frame with fabric sides, made by a contract factory, keeping the two things that make Rover different, the size and the walk-in ramp. That is a new design and needs factory quotes, not a revision of this one.

## What would bring it down further

1. A tube quote. See the mill-quantity paragraph above.
2. Welding. 36 TIG welded joints by a fabrication shop, modeled at $162.00 on an assumed shop rate. A fabricator's quote on the drawings replaces that guess, in either direction.
3. Plates. 2 brake clamp plates, laser cut 1/8 inch 6061 are an allowance, about $3.20. Uploading the DXF files to a cutting service turns that into a real number in minutes.
4. The cover is now $399.97. The ramp surface, floor pad and mesh are the largest material lines left; sewing is $100.00.

Selling-cost lines at the current price, per carrier at 100: payment fee $29.27, returns reserve $49.95, support $15.00, acquisition $35.00. Contribution before fixed overhead: -$796.24.

Rebuild with `./buddy design:rover`. Inspect at https://buddywheels.org/design-studio-rover.
