stacksjs/buddy-wheels/docs/product/rover-materials.md

# Buddy Rover r0 materials and weather system

Configuration rover-r0-l1300-w700-h1000-r1000-a560-g1000-hub101.6-trail-swivel310-k350-t180-welded-sprung. Supplier pages read 2026-11-11 unless a row says otherwise. These are costing candidates and a design intent. No fabric has been bought, sewn, soaked, sun-aged or tested, and nothing here is a waterproof, UPF or temperature claim.

## How the cabin handles weather

| Exposure | Design answer | What still has to be proven |
| --- | --- | --- |
| Rain | One-piece roof in the better, solution-dyed fabric, with no seam on top, pitched over a ridge pole 60 mm above the frame so water runs to both sides. 40 mm drip overhangs. Roof-to-wall seams taped; wall corner seams lapped and left untaped under the overhang. Rear header overlaps the raised ramp. Floor tub liner with 80 mm upturned walls. | Spray and pooling test on the sewn roof. Hydrostatic head of fabric and taped seams. Target to verify: 1,500 mm or better at the roof. |
| Wind | Clear roll-down storm panels on both sides and the front, held by hook and loop down the sides and along the sill. Solid ramp panel as the tailgate, with fabric gussets to the rear posts. | Flap noise and billow at running speed. Whether a nervous dog tolerates it. |
| Sun | Solution-dyed roof fabric the supplier credits with excellent UV resistance, mesh with a stated 70% shade factor, and an optional reflective liner under the roof that is not in the base cost. | UPF of the roof assembly and interior temperature rise in direct sun, panels open and closed. The priced roof is black and the walls charcoal, which run hot; a light roof must be sourced and re-priced. The wall fabric is not solution dyed and will fade. |
| Heat | Three large mesh windows plus a high rear vent that stays open under the roof overhang even with storm panels down. | Airflow and temperature limits. A closed cabin is not safe in heat until measured. |
| Cold and snow | Clear panel with a stated -20 F cold-crack rating, EVA floor pad under the liner. | Panel handling with gloves, hook and loop packed with snow, icing, condensation. |
| Sand and salt | Aluminum frame and gussets, stainless hangers and rings, rinse-out liner. The Run hardware is zinc-plated steel and the panels exterior plywood; salt use needs the stainless fastener and marine plywood upgrades. | Fastener, sleeve and axle corrosion, sand in bearings and hook tape. |
| Wet paws on the ramp | 5 mm diamond EVA surface between two 25 mm curb rails, printed threshold toes at the ground edge. | Grip when wet at 8.0 degrees, claw wear. |

## Layers and candidates

| Layer | Candidate | Observed price | Guards against | Supplier facts | Caveat |
| --- | --- | ---: | --- | --- | --- |
| Roof shell | [Rockywoods solution-dyed 600 denier polyester, polyurethane coated, 58-SD600PC-Black](https://www.rockywoods.com/products/solution-dyed-600-denier-polyester-with-urethane-water-repellant-coating_2) | $15.28 per 59-inch-wide linear yard | Rain, sun | Supplier words: solution dyed, polyurethane coating, 8 oz per square yard, "excellent UV resistance". Solution dyeing holds color in sun. | The page gives no hydrostatic head or UPF number. Both must be measured on the sewn, seam-taped roof. Black only, which runs hotter in sun than a light roof. |
| Wall shell | [OWF polyester 600 denier charcoal, POLY6CHAR](https://www.owfinc.com/p/productinfo/POLY6CHAR/) | $6.50 per 58-inch-wide linear yard; $5.07 at 20 yards, $4.42 at 50 | Wind, splash, sun | Supplier words: 12 oz 600x300 denier polyester, import, PVC coated, "holds up better if subjected to direct sunlight or constant water" than nylon. | Not solution dyed, so expect fading. No waterproof, UV or cold rating on the page. Walls sit under the roof overhang; the roof keeps the better fabric. |
| Window mesh | [Sailrite Phifertex Standard White 54 inch, 393111](https://www.sailrite.com/Phifertex-Mesh-White-000-54) | $17.95 per 54-inch-wide linear yard | Sun, airflow, claws | Supplier words: vinyl-coated polyester mesh, "Shade Factor 70%", 11.3 oz per square yard. | Claw, chew and push-out resistance are not stated for a 140 lb dog. Mesh is not a restraint. |
| Roll-down storm panels | [Sailrite Plastipane 20 gauge clear vinyl 54 inch, 283201](https://www.sailrite.com/Plastipane-20-Gauge-Vinyl-Window-Material-54) | $89.35 per 10-yard roll, 54 inch wide | Rain, wind | Supplier words: 0.020 inch, "Cold Crack Rating -20 F". One-yard rolls are $9.25 but too short for a side panel. A 60-yard roll is $444.00. | Closed storm panels stop airflow. Heat build-up limits must be set by test before any enclosed use. |
| Floor tub liner | [OWF 18 oz vinyl coated polyester black, VIN18BLK](https://www.owfinc.com/p/productinfo/VIN18BLK/) | $9.96 per 61-inch-wide linear yard | Wet paws, sand, accidents | Supplier words: 18 oz (20 mil), 61 inch, heat sealable. $7.77 per yard at 20 yards or more. | Import, black only by the yard. Slip, chew and cleaning-chemical behavior are untested. |
| Floor comfort pad | [Avetco E600 5 mm EVA, SP60A.5MM.BLACK.39X51](https://www.avetcoinc.com/product/e600-high-density-eva-foam-sheets-60-65-shore-c-39-x-51-5mm-10mm/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) | $31.50 per 39 x 51 inch sheet, 5 mm | Comfort, insulation from a cold floor | Checked 2026-11-08: firm 60-65 Shore C closed-cell EVA, in stock, minimum one sheet. | Pressure relief for a recumbent senior dog is unqualified. An orthopedic pad may be needed on top. |
| Ramp traction surface | [Sailrite Nonslip Foam Flooring Gray 27 x 94 inch adhesive-backed, 123492](https://www.sailrite.com/Marine-Foam-Flooring-Gray-27-x-94-Adhesive-Backed) | $90.95 per 27 x 94 inch sheet, 5 mm | Wet paws on the incline | Supplier words: 100% EVA foam, 5 mm, diamond pattern, adhesive backed. | No wet-grip or claw-wear data. Grip on a wet 9 degree incline has to be tested with the intended dog size. |
| Roof seam tape | [Rockywoods MELCO seam tape for 2-layer fabrics, 31-MELCO-FU700-Clear](https://www.rockywoods.com/products/melco-seam-sealing-tape-for-2-layer-fabrics) | $2.89 per meter, 20 mm wide | Rain at needle holes | Supplier words: for polyurethane coated fabric seams, flow temperature 110 C. | Adhesion to this roof fabric and to the PVC-coated wall fabric must be proven on an offcut, or the tape replaced with a compatible sealer. |
| Reflective trim | [Sailrite sew-on reflective tape 1 inch yellow, 123218](https://www.sailrite.com/Sew-On-Reflective-Tape-1-Yellow-2.2-Yds) | $2.95 per 2.2-yard pack | Low light | Sew-on, 1 inch. | No reflectivity rating on the page. Not a substitute for lights. |
| Hook tape, 2 inch | [Quest Outfitters hook and loop 2 inch, hook 2106](https://questoutfitters.com/products/hook-and-loop) | $1.58 per yard | Storm panel edges, cover tabs | Sold by the yard. Loop 2107 is the same price and bought separately. | The page does not state the material. Hook and loop clogs with sand and fur and is never a restraint. |
| Loop tape, 2 inch | [Quest Outfitters hook and loop 2 inch, loop 2107](https://questoutfitters.com/products/hook-and-loop) | $1.58 per yard | Storm panel edges, cover tabs | Sold by the yard. | Confirm hook and loop are matched widths at checkout. |
| Roof hem shock cord | [Quest Outfitters shock cord 3/16 inch, 2403](https://questoutfitters.com/products/shock-cord) | $1.04 per yard | Keeps the roof taut so water runs off | 3/16 inch. | UV life of the cord is not stated. |
| Tether rings | [Sailrite D-ring 1 inch stainless 316, 122757](https://www.sailrite.com/D-Ring-Without-Bar-0-1-Stainless-Steel) | $1.55 per each | Salt | Supplier states a 270 lb working load limit for the ring alone. | A ring rating does not rate the sewn tether, its anchor or the frame. No restraint claim. |
| Tether, grab and tie webbing | [Strapworks 1 inch polyester webbing, WSR-POL-PUT-001-BLK](https://www.strapworks.com/1-inch-utility-polyester-webbing-black) | $0.74 per foot; $77.41 per 120-foot roll | Low stretch when wet | Checked 2026-11-08, listed in stock. | Sewn strength is unqualified. |
| Thread | [Sailrite PremoBond Tex 90 UV bonded polyester, 123338](https://www.sailrite.com/PremoBond-V-92-Black-UV-Bonded-Polyester-Thread-4-Oz-1-350-Yds) | $15.95 per 4 oz cone, 987.552 m | Sun | Checked 2026-11-08. Supplier describes UV protection and a non-wicking finish. | 160 m per cover is an unmeasured allowance. |

- Premium shell for every panel: Sailrite Top Gun Charcoal 62 inch, 120396, $23.95 per yard, acrylic-coated 600 denier polyester, supplier words "Highly UV Resistant" and "Highly Water Resistant". The first cost count used it everywhere; it added about $85 per carrier at 100 units.
- Optional sun layer: eQuilter Insul-Bright 45 inch, WABATISB, $9.25 per yard, quilted under the roof. Left out of the base cover; about $13 per carrier. The supplier says it is not heat-proof or fire-resistant.
- Optional zippers on the storm panels: Sailrite YKK #10 molded-tooth chain 100030 at $6.00 per 5 feet and sliders 100033 at $11.25 per 5. The base cover uses hook and loop instead; zippers added about $32 per carrier.
- Mesh alternate for more shade: Sailrite Phifertex Plus White 54 inch, 235811, $25.95 per yard, "Shade Factor 92.50%". It leaves about 7.5% open area, so airflow drops sharply.
- Liner alternate: Sailrite Shelter-Rite 18 oz grey 61 inch, 112015, $23.95 per yard, supplier word "Waterproof".
- Clear panel alternate for colder routes: Sailrite Regalite 30 gauge 54 x 110 inch, 103762, supplier words "Cold Crack Rating -30 F". Its price was not captured.
- Not found: a hydrostatic head or UPF figure on any shell page, a by-the-yard clear TPU film price, and Seattle Fabrics pages (blocked).

## Cut schedule for this configuration

Cover height 1066 mm, window sill 350 mm above the base rail, window height 606 mm, rear header 150 mm. All blanks are rectangles with 15 mm seam allowance included. See cover-cut-schedule.csv and cover-panels.svg.

| ID | Qty | Piece | Material | Width | Length |
| --- | ---: | --- | --- | ---: | ---: |
| P01 | 1 | Roof, one piece over the ridge | roof | 885 | 1097 |
| P02 | 2 | Side wall | wall | 1096 | 1381 |
| P03 | 1 | Raked front wall | wall | 960 | 781 |
| P04 | 1 | Rear header above the tailgate | wall | 210 | 781 |
| P05 | 2 | Tailgate wind gusset | wall | 200 | 1030 |
| M01 | 2 | Side window mesh | mesh | 636 | 871 |
| M02 | 1 | Front window mesh | mesh | 500 | 670 |
| M03 | 1 | Rear header mesh | mesh | 120 | 670 |
| V01 | 2 | Side storm panel | clear | 666 | 901 |
| V02 | 1 | Front storm panel | clear | 530 | 700 |
| L01 | 1 | Floor tub liner | liner | 860 | 1460 |
| L02 | 1 | Threshold flap | liner | 200 | 688 |
| F01 | 2 | Floor pad half | pad | 700 | 650 |

## Sewing and sealing notes

1. Sew with Tex 90 bonded polyester and a size 18 to 20 needle. Use lapped or flat-felled seams on the shell so water runs over, not into, each seam.
2. Tape the roof-to-wall seams from the inside and prove adhesion on offcuts of both fabrics first. Lap the wall corner seams so they shed outward.
3. Bind every mesh edge inside a shell frame. Never leave a raw mesh edge where a nose or claw can reach it.
4. Hem the roof skirt around the shock cord. Add reflective trim on both sides and the rear at wheel-top height.
5. Bind the four cutouts where the handle arms cross the rear and axle posts, and a slit at each axle post for the brake arm, so metal clamps metal.
6. The cover hangs on the frame with printed rail clips and hook-and-loop tabs. Neither is a restraint. Escape prevention, tether anchors and chew resistance need their own design review.

## Tests before any dog rides

Spray and pooling, hydrostatic head, UPF, interior temperature rise, airflow with panels down, cold handling, wet ramp grip, mesh push-out and chew, hook and loop cycling with sand, colorfastness, and a flame behavior check of every layer.
