stacksjs/buddy-wheels/docs/business/textile-supplier-research.md

# XL textile supplier price research

Observed 2026-11-08, America/Los_Angeles. USD unless identified otherwise. These are online costing candidates, not approved load hardware, material qualification, supplier quotes, or a purchase. No suppliers were contacted and no orders were placed. Prices exclude freight, tax, cutting, sewing, inspection, and other production costs. Stock counts are observations, not reservations.

## Candidate inputs

| Required input per XL set | Purchasable supplier candidate | Observed price and unit | Availability and caveats |
| --- | --- | --- | --- |
| Six metal 1-inch two-bar webbing adjusters | Seattle Fabrics H-MLL, 1-inch Metal Double Bar Ladder Lock in Nickel Plated Steel | Product price $0.65 each; six cost $3.90. The description separately says $0.75 each, so retain $4.50/set as a conservative alternate until checkout resolves the conflicting text. No quantity tiers shown. | Page states In Stock and offers the 1-inch option. This is an explicitly named metal double-bar ladder lock. No rated load is established here. [Product page](https://www.seattlefabrics.com/1-Metal-Double-Bar-Ladder-Lock-in-Nickel-Plated-Steel_p_490.html). |
| One 1-inch acetal front-only side-release buckle | Ripstop by the Roll Standard Side Release Buckle, SKU SR-1-B, variant 12231494785 | **$1.10 each for the 1-inch variant**. The page default $0.90 belongs to the 3/4-inch variant. Sold individually. No public quantity price breaks returned. | Product describes black acetal, flat shape, single-side adjustment. The 1-inch variant returns available=true. Front-only is its location in the assembly, not a supplier claim. [1-inch product variant](https://ripstopbytheroll.com/products/standard-side-release-buckle?variant=12231494785), [live product variant data](https://ripstopbytheroll.com/products/standard-side-release-buckle.js). |
| 8.292m of 20mm polyester binding, including cover tabs | Hobby Trendy 20mm single-fold polyester satin bias binding, 10m pack; black BSB24 or red BSB12 | $8.99 per 10m, $0.899/m. Net 8.292m costs $7.45451. Whole-pack cash purchase for one set is $8.99. No quantity breaks returned. | **Black is unavailable**; red is available. This is a satin bias binding candidate, not evidence of industrial binding suitability. Nominal 20mm width is stated, but fold geometry and finish need comparison with the sewing specification before substitution. [Product](https://hobby-trendy.com/products/polyester-satin-bias-binding-tape-single-fold-20mm-13-16inch-10meters-10-93yds), [red variant](https://hobby-trendy.com/products/polyester-satin-bias-binding-tape-single-fold-20mm-13-16inch-10meters-10-93yds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), [live data](https://hobby-trendy.com/products/polyester-satin-bias-binding-tape-single-fold-20mm-13-16inch-10meters-10-93yds.js). |
| 80m Tex 90 bonded polyester thread | Sailrite PremoBond Tex 90 (V-92) Black UV Bonded Polyester, SKU 123338 | $15.95 per 4oz cone, **1,080 yards** = 987.552m. Net 80m costs $1.29208; buy one cone for a prototype. No quantity tiers shown. | Product page returned Available: 468. The URL retains an old 1,350-yard title; use the current product title's 1,080-yard length. Supplier describes bonded polyester, UV protection, and non-wicking finish. [Product page](https://www.sailrite.com/PremoBond-V-92-Black-UV-Bonded-Polyester-Thread-4-Oz-1-350-Yds). |
| Ten mated sew-on hook-and-loop patches, finished 20x20mm each | RBTR VELCRO Industrial Sew-On Tape: black 1-inch hook SKU 1-VELCRO-HOOK-B and black 1-inch loop SKU 1-VELCRO-LOOP-B | **Each side is $0.90 per linear foot**, separately purchased. Ten patches need 0.2m of each side, then trim 25.4mm width to 20mm. Net tape charge for both sides: $1.18110/set. Purchase one foot of each side for one prototype: $1.80. | Both 1-inch black variants return available=true. Nylon, sew-on, no adhesive. Cut lengths are continuous up to 25ft, then supplied in 25ft increments. Allow for cut losses and unusable width. No public quantity price breaks returned. [Hook](https://ripstopbytheroll.com/products/velcro-industrial-hook-and-loop?variant=47238308692138), [hook live data](https://ripstopbytheroll.com/products/velcro-industrial-hook-and-loop.js), [loop](https://ripstopbytheroll.com/products/velcro-industrial-sew-on-tape-loop?variant=47238312591530), [loop live data](https://ripstopbytheroll.com/products/velcro-industrial-sew-on-tape-loop.js). |
| Exact 5mm closed-cell EVA or XLPE foam, one 220x350mm and one 213x159.75mm panel | Avetco E600 closed-cell EVA black, SKU **SP60A.5MM.BLACK.39X51**, 5mm variation | **$31.50 per 39x51-inch sheet**, 990.6x1295.4mm = 1.28322324m². Not the $63 10mm option. MOQ one sheet. No public quantity tiers seen. | Live variation data: in stock=true, purchasable=true, no backorders. EVA is 60-65 Shore C and described as firm. Exact thickness matches; hardness/comfort remain unqualified. Shipping-cart dimensions 40x5x5 inches are the rolled package, not foam sheet dimensions. [5mm product variant](https://www.avetcoinc.com/product/e600-high-density-eva-foam-sheets-60-65-shore-c-39-x-51-5mm-10mm/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). |

## Pack-aware costing notes

The calculations below are our arithmetic using the cited supplier units, not supplier claims. Net consumption is distinct from purchase cash and finished-set yield.

- Foam net area is 0.11102675m² per set. Area-only allocation is $2.72544/set, before nesting and offcuts. A simple feasible rectangular nest makes **10 sets per sheet**, allocating $3.15/set: rotate ten 220x350 panels to 350x220; arrange them in two columns and five rows (700x1100mm). Place eight 213x159.75 panels down the remaining right strip, and two across the bottom strip. This is an illustrative nest, not a proved optimum or a production cutting plan. The charged final shelf nest includes trim margins and 5 mm cut gaps and uses 12 sheets for 100 sets, $3.78/set. The 10-set illustration is an optimization lead, not the charged model.
- Ten mated patches mean ten hook pieces **and** ten loop pieces. The combined requirement is 0.2m of hook plus 0.2m of loop, not 0.2m total. A one-foot pair yields fifteen 20mm-long mated patches before kerf. For a 100-set batch, 20m net per side would round to 66ft before cut losses. The final model adds 1 mm between patches and respects 25ft section boundaries, requiring 70ft per side, $126.00 total or $1.26/set.
- At 100 sets, thread demand 8,000m requires nine 987.552m cones, $143.55 total, or $1.4355/set in purchase cash. Net-consumption allocation remains $1.29208/set. Test that the 80m allowance includes top thread, bobbin thread, starts/stops, and rework.
- The final cut schedule requires 8.292m/set including cover-tab edges. At 100 sets, 829.2m has a theoretical minimum of 83 ten-meter packs, but continuous panel-edge packing with 2 mm cut gaps requires 84 packs, $755.16 cash or $7.56 allocated per chair after upward-cent rounding. See the [complete cost report](xl-complete-unit-costs.md). The black-stock and binding-construction issues remain unresolved.

## Other observed hardware candidates

[Strapworks MTH-SAJ-001](https://www.strapworks.com/1-inch-metal-strap-adjuster) is a stocked 1-inch metal strap adjuster, with singles $1.03; 10/$9.55; 25/$22.91; 75/$67.28; 150/$133.11; 300/$264.78. Six singles cost $6.18; two 300-packs cover a 100-set batch for $529.56, or $5.2956/set. Page does not explicitly name its bar count, so do not silently replace the specified double-bar topology with this candidate. [Matte black MTH-SAJ-001-PLT-MBK](https://www.strapworks.com/1-inch-black-plated-metal-strap-adjuster-matte-black) is $1.22 single or $312.45/300.

[P&H J06-1BLK](https://www.phfasteners.com/shop/1-side-release-buckle-acetal) is a listed 1-inch acetal side-release buckle at $0.42 each. The page offers Add To Cart but gives no explicit stock count, adjustment geometry, or quantity tiers. Prefer the fully identified RBTR single-adjust candidate for the model until those details are verified.

## Evidence limitations

Supplier product HTML and public product-variant data were read directly. Variant data resolved the 1-inch buckle price, hook/loop availability, binding color availability, and exact 5mm foam price. The Seattle double-bar product has conflicting price text. The 20mm polyester binding has a purchasable colored option but no currently purchasable black variant. These facts should remain visible in any cost model. None of the prices establish compatibility, safe working load, assembled performance, foam compression behavior, or an approved textile specification.
