stacksjs/buddy-wheels/docs/business/xl-complete-unit-costs.md

# Buddy XL: complete per-unit cost and $299 decision

Checked November 8, 2026. USD. This is the current bottom-up r2 spring-chair planning estimate at the default Buddy XL geometry, not a finished-product quote or an animal-use release. The prior $217.44 total contained an unquoted $24 textile placeholder. It is superseded by the complete support/harness costing below.

## Decision

The current design does not support $299 retail under the existing business assumptions. The 100-chair estimate is $281.45 per chair, including $88.01 for the complete support/harness. At $299 that leaves $17.55 gross profit (5.9%), then -$41.37 contribution after fees, reserve, support and acquisition. The unchanged 30% gross-margin gate requires COGS no higher than $209.30, a $72.15 reduction from this estimate. Prices in the storefront are not changed by this study.

Even with FREE sewing, current materials, rejects and textile freight would cost $50.51 for T01. With the $193.44 non-textile base, the 30% gate allows only **$15.86 for the complete T01 set**. Listed material purchasing alone is $42.28. A modest buckle discount cannot close that gap.

## Full recurring cost summary

| Category | 100-chair allocation per chair |
| --- | ---: |
| Whole frame/carriage tube stock | $36.62 |
| Whole cartridge housing stock | $12.60 |
| Springs | $9.24 |
| Wheels | $29.98 |
| Metal profiles, shafts, sleeves, bolts, pins, guidance, shims and guards | $60.00 |
| Complete textile materials, full purchasing units | $42.28 |
| Textile manufacturing reject reserve | $4.23 |
| Textile cutting, sewing and textile inspection | $37.50 |
| Frame cutting, drilling and assembly labor | $25.00 |
| Final chair inspection | $6.00 |
| Packaging | $5.00 |
| Frame/hardware inbound freight | $7.00 |
| Additional textile inbound freight | $4.00 |
| Machine wear and shop consumables | $2.00 |
| **Complete landed manufacturing** | **$281.45** |

The [r2 line-item CSV](xl-spring-r2-costs.csv) expands every mechanical category. All material quantities follow the current CAD/cut schedule. This excludes buying a new printer, sewing machine, reusable tools, design software, fixtures or engineering setup for every chair. Production labor, power/rejects, wear and freight remain recurring. Design qualification, insurance, fixed overhead and salaries beyond the modeled production labor require separate funding.

## $299 selling costs and one-build comparison

| Metric | Per chair |
| --- | ---: |
| Retail revenue excluding customer tax | $299.00 |
| Manufacturing COGS | $281.45 |
| Gross profit | $17.55 |
| Card fee, 2.9% + $0.30 | $8.97 |
| Return/warranty reserve, 5% | $14.95 |
| Customer support assumption | $10.00 |
| Customer acquisition assumption | $25.00 |
| **Contribution before fixed overhead** | **-$41.37** |
| Contribution with $24 seller-paid delivery | -$65.37 |
| Contribution with zero acquisition spend | -$16.37 |

Outbound delivery is customer-paid in the base case. Customer sales tax is not revenue. Input purchases assume valid resale treatment; add any nonrecoverable tax. The extra textile freight allowance is in addition to frame/hardware freight, since these are separate supply sources. Actual checkout freight is not verified.

One-off stock purchasing, paid production labor and modeled freight total **$684.47**, including **$267.38** for textiles. That is cash needed under whole-pack purchasing assumptions and includes leftover inventory. It is not the net material physically consumed by one chair. A 100-chair run is a costing scenario, not a purchase authorization.

## Labor and sourcing sensitivity

These scenarios retain the complete BOM and stock purchasing; they vary only explicit labor assumptions.

| Textile sewing scenario | Complete T01 | Full r2 COGS | Gross margin at $299 | Contribution |
| --- | ---: | ---: | ---: | ---: |
| 45 min at $25.00/hour | $69.26 | $262.70 | 12.1% | -$22.62 |
| 60 min at $30.00/hour | $80.51 | $273.95 | 8.4% | -$33.87 |
| 75 min at $30.00/hour | $88.01 | $281.45 | 5.9% | -$41.37 |
| 120 min at $40.00/hour | $130.51 | $323.95 | -8.3% | -$83.87 |

[US Cargo Control NS-WEB14500BLK](https://www.uscargocontrol.com/products/Black-Polyester-Web-1-x-300-3-5K-Cargo-Webbing) lists a 300-foot polyester roll at $69.99, with $87.00 crossed out; the current page says Call to Order. Buying ten 300-foot rolls at the listed price would be $699.90, or $7.00 per chair before rejected/uncuttable sections, versus the selected Strapworks webbing allocation of $17.81. Even that approximately $11.89 saving after the material reject reserve cannot close the $72.15 gross-gate gap. It is a comparison, not an approved substitute: cargo-web stiffness, width/thickness tolerance, skin/abrasion behavior and adjuster grip must be qualified, and availability/price require confirmation. Do not use promotional or unquoted wholesale prices as guaranteed production savings.

The selected mesh is already the lower-priced OWF reference, not the unavailable $33/yard Seattle mesh. The 100-chair nest needs ten yards, so the published 20/30-yard discount tiers do not apply. The selected adjusters already use the conservative $0.75 listing text. Further optimization must address the complete support architecture, assembly time and the non-textile frame base, with a new reviewed BOM and quote. Do not remove chafe protection, reinforcement or guarding to make a spreadsheet pass.

The rigid r1 alternative is **$244.02** with this same textile model. At $299 its gross margin would be 18.4% and contribution -$3.94. It still fails 30%; removing suspension alone does not solve the complete product economics.

## Price boundary, without changing the product price

At this COGS, contribution break-even is approximately **$343.92**, before fixed overhead. A 30% product gross margin needs at least **$402.08** before any cost overrun. These are arithmetic boundaries, not recommended launch prices or evidence that customers will pay them.

| Illustrative retail | Gross margin | Contribution before fixed overhead |
| --- | ---: | ---: |
| $299.00 | 5.9% | -$41.37 |
| $349.00 | 19.4% | $4.68 |
| $399.00 | 29.5% | $50.73 |
| $409.00 | 31.2% | $59.94 |

## Evidence and release conditions

Labor times and the loaded $30/hour rate are planning inputs, not a measured factory cycle or wage quote. The 10% material reject reserve and incremental $4 textile freight are assumptions. Mechanical fabrication, guards, exact hardware and shipping also retain RFQ allowances. Listed shell stock is ambiguous, black binding is unavailable, the priced red satin binding needs construction approval, firm EVA comfort is unqualified and purchased hardware must match the actual interfaces. None of the costing candidates is approved for Buddy's body support. Obtain available, compatible production SKUs, sewing coupons, loaded fixture tests and professional fit review before any animal use or sales release.

# Complete XL support and harness cost

Checked November 8, 2026. XL r2, rear 220 x 350 mm, chest 1065 mm. Price candidates, not a qualified harness or production quote.  This replaces the old $24 T01 target and $50 one-off allowance. All SG items expand one complete T01 bundle, rather than adding a second harness. For r0 the study remains an unqualified alternative to T01/T02 supplier-selected supports.

## Complete textile purchasing and labor

| Textile line | One-build stock cash | Per chair at 100 | Purchase for 100 |
| --- | ---: | ---: | --- |
| Woven shells, 12 chafe panels and 10 closure tabs | $18.71 | $3.56 | 19 whole linear yards, $355.49 |
| Rear and front spacer mesh | $12.68 | $1.27 | 10 whole linear yards, $126.80 |
| Rear and front 5 mm EVA pads | $31.50 | $3.78 | 12 39 x 51 inch sheets, $378.00 |
| Every webbing cut including returns, laps and tails | $20.57 | $17.81 | 23 120-foot rolls, $1780.43 |
| Six metal double-bar adjusters | $4.50 | $4.50 | 600 each, higher conflicting listing price, $450.00 |
| One 1-inch acetal front closure | $1.10 | $1.10 | 100 each, $110.00 |
| 20 mm binding including cover-tab edges | $8.99 | $7.56 | 84 10-meter packs; each panel/tab edge stays continuous, $755.16 |
| Tex 90 top/bobbin thread allowance | $15.95 | $1.44 | 9 987.552-meter cones, $143.55 |
| Ten 20 x 20 mm hook patches | $0.90 | $0.63 | 70 linear feet of 1-inch hook, $63.00 |
| Ten 20 x 20 mm loop patches | $0.90 | $0.63 | 70 linear feet of 1-inch loop, $63.00 |
| Materials, full purchasing units and nesting | $115.80 | $42.28 | All offcuts and leftover stock charged |
| Manufacturing rejects reserve, 10% of materials | $11.58 | $4.23 | Planning reserve, separate from geometric offcuts |
| Cut, sew and textile inspection labor | $90.00 | $37.50 | 180 / 75 minutes at $30/hour loaded labor assumption |
| Additional textile inbound freight | $50.00 | $4.00 | Unquoted, separate from frame/hardware freight |
| **Complete T01 support/harness** | **$267.38** | **$88.01** | No completed-set supplier quote |

One-build cash buys full supplier packs and leaves reusable material inventory. It is not net consumed fabric cost and it excludes a new printer/sewing machine. The 100-chair column allocates all batch purchasing cash and rounds each line up to a cent. No batch is authorized. Customer tax and delivery are separate. Nonrecoverable purchase tax must be added if resale treatment is unavailable.

## Exact consumption and purchasing method

All 33 SG rows are covered: SG01, SG02, SG03, SG04, SG05, SG06, SG07, SG08-1, SG08-2, SG08-3, SG08-4, SG08-5, SG08-6, SG08-7, SG08-8, SG08-9, SG08-10, SG08-11, SG08-12, SG08-13, SG08-14, SG08-15, SG08-16, SG08-17, SG09-R, SG09-B, SG10-R, SG10-B, SG11, SG12, SG13, SG14, SG15. Webbing cuts total **8.228 m per set**, including actual returns, 60 mm laps, adjustable tails, perimeter keepers and all six frame wraps. Binding totals **8.292 m**, including the ten cover-tab perimeters missing from the earlier binding allowance. Thread allowance is 80 m per set, top and bobbin combined, unmeasured.

Woven nesting includes the two body panels, twelve chafe-sleeve panels and ten tabs. Mesh and foam each include both body panels. Shelf nesting keeps grain orientation, 5 mm cutting gaps, 20 mm stock-width trim and 40 mm stock-end trim. This is a reproducible feasible purchasing plan, not an optimal nest. Foam uses 12 whole sheets for 100 sets. Mesh buys 10 whole yards, below the 20-yard discount threshold, so no discount applies. Binding and webbing use first-fit cuts with 2 mm separation; every panel edge remains continuous. Hook and loop are purchased separately, trimmed from 25.4 to 20 mm, with 1 mm between patches and 25-foot supplier section boundaries. Thread buys 9 full cones. No net-area-only pricing or assumed wholesale discount is used.

The $37.50 batch sewing allowance assumes 75 minutes at a loaded $30/hour. It covers textile cutting, binding, reinforcement/box stitches, threading, closures and in-process textile checks. Frame assembly and final chair QA are still charged separately. A factory's completed-set quote must replace these inputs without double-counting its included sewing/freight. Qualification tests and fixed business overhead remain separate. The 10% reject reserve does not fund design qualification or prove any yield.

## Current listed material candidates

- [Rockywoods 58-CORDURAPOLY-Black](https://rockywoods.com/products/1000-denier-coated-cordura-hp-polyester-fabric): $18.71 per 60-inch-wide linear yard. 1000D-class coated polyester, listed $18.71/yard. Model buys whole yards without an unverified roll discount. Exact black-variant availability is unconfirmed; page exposes both Sold Out and Add to Cart. Nominal .025-inch thickness is not the CAD .8 mm envelope.
- [OWF SPACER3MM](https://www.owfinc.com/Spacer-3mm-Mesh/productinfo/SPACER3MM/): $12.68 per 58-inch-wide linear yard. Listed in stock. $12.68/yard, $9.89 at 20 yards, $8.62 for a full 30-yard roll. Use $12.68 until the actual purchase reaches a tier. Listed 3 mm / approximately 3/32 inch; this is a costing candidate for the 1.5 mm CAD reference layer, not an approved thickness substitution.
- [Avetco E600 5 mm EVA SP60A.5MM.BLACK.39X51](https://www.avetcoinc.com/product/e600-high-density-eva-foam-sheets-60-65-shore-c-39-x-51-5mm-10mm/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): $31.50 per 39 x 51 inch sheet, 5 mm. Exact 5 mm variation $31.50, in stock, MOQ one. Firm 60-65 Shore C. Comfort/compression remains unqualified. Sheet nesting, not net area pricing.
- [Strapworks WSR-POL-PUT-001-BLK](https://www.strapworks.com/1-inch-utility-polyester-webbing-black): $77.41 per 120-foot roll, 1 inch polyester. Listed in stock. $77.41/120 ft; singles $0.74/ft, 30 ft $20.57, 60 ft $39.51. Batch uses actual 120-foot rolls; one-off compares those options without assuming a continuous splice-free roll. Nominal .065-.07 inch thickness; compatibility and sewn strength unqualified.
- [Seattle Fabrics H-MLL](https://www.seattlefabrics.com/1-Metal-Double-Bar-Ladder-Lock-in-Nickel-Plated-Steel_p_490.html): $0.75 per one 1-inch nickel-plated steel double-bar ladder lock. Page header $0.65, description $0.75. Model conservatively uses $0.75, not the lower conflicting price. Page states In Stock but also contains a generic wait-list block. Checkout and actual dimensions/radii/slip resistance need verification.
- [RBTR SR-1-B, variant 12231494785](https://ripstopbytheroll.com/products/standard-side-release-buckle?variant=12231494785): $1.10 per one 1-inch acetal single-adjust buckle. Exact 1-inch variant $1.10, available=true. Default $0.90 is the smaller 3/4-inch option. Front restraint only in this study.
- [HobbyTrendy BSB12 red polyester satin binding](https://hobby-trendy.com/products/polyester-satin-bias-binding-tape-single-fold-20mm-13-16inch-10meters-10-93yds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): $8.99 per 10-meter pack, nominal 20 mm single fold. Red available, black BSB24 unavailable. Satin construction, supplied/folded width and durability must be approved against the 20 mm cut/sew specification. Cost reference only; a qualified black industrial equivalent still needs a quote.
- [Sailrite 123338 PremoBond Tex 90 black bonded polyester](https://www.sailrite.com/PremoBond-V-92-Black-UV-Bonded-Polyester-Thread-4-Oz-1-350-Yds): $15.95 per 4 oz cone, current title 1,080 yards / 987.552 m. Current title says 1,080 yards although URL says 1,350. Use the shorter current yield. Listed available. 80 m per set covers top/bobbin/rework only as an unmeasured allowance.
- [RBTR 1-VELCRO-HOOK-B](https://ripstopbytheroll.com/products/velcro-industrial-hook-and-loop?variant=47238308692138): $0.90 per one foot, 1-inch sew-on nylon hook. Available=true. Trim width to 20 mm, charge full bought width. Cuts include 1 mm separation; account for 25-foot supplier section boundaries.
- [RBTR 1-VELCRO-LOOP-B](https://ripstopbytheroll.com/products/velcro-industrial-sew-on-tape-loop?variant=47238312591530): $0.90 per one foot, 1-inch sew-on nylon loop. Purchased separately from hook at the same price. Ten mated patches require ten pieces of each side.

The black shell's stock status is not confirmed, black binding is unavailable, and the priced red satin binding needs construction/fold-width approval. The foam is firm and needs pressure/comfort testing. Mesh and webbing thicknesses differ from nominal inspection envelopes. Adjuster radii, dimensions, corrosion behavior, strap slip and actual threading remain unapproved. These prices do not authorize material substitutions, provide a dog-support rating or establish an orderable production BOM. Custom colors can add minimums and costs. Hold retail release until a compatible, available bill is quoted and physically qualified.
