stacksjs/buddy-wheels/docs/business/xl-spring-r2-costs.md

# Buddy XL r2: lower-cost adjustable spring cartridge

Checked November 8, 2026. USD, integer-cent native Bun model. This is a costed bench candidate, not a production quote, retail release or animal-use rating. Anatomy, actual hub length and spring suitability remain unverified. Other sizes remain r0. XL r1 uses the same revised complete textile costing with its separate rigid frame.

## Decision

Replace the r0 $220 shock-pair allowance with **two standard MISUMI SWH20-75 die springs**, listed at $5.44 each or $4.62 each for 200+. A 100-chair batch buys 200 springs for $924, **$9.24 per chair**, before included pooled inbound freight. A single pair is $10.88 before freight/tax. The springs alone cost 95.8% less than the old unquoted $220 allowance; this is not a 95.8% installed-system saving. No cheap RC shocks or threaded wheel journals are substituted.

The new mechanism has independent 8 mm nominal vertical travel, steel end stops, four-sided replaceable UHMW guidance and 0/1/2 mm matched steel preload shims. **Preload is adjustable; spring stiffness and damping are not.** Fixed rate 65.3 N/mm, no hydraulic damper. Changing rate would require a separately verified spring. No riding/terrain/rehab suitability is established.

## Complete cost and price scenarios

Configuration: height 620, width 400, rail 680, provisional hub 82.55, preload 1, manual preview travel 0, all mm. Preview travel changes pose, not manufacturing cost. Includes one spring pair, not spare alternative rates.

| Metric | $265 retail | $299 retail |
| --- | ---: | ---: |
| Landed manufacturing, 100-chair batch | $281.45 | $281.45 |
| Product gross profit | -$16.45 | $17.55 |
| Gross margin | -6.2% | 5.9% |
| Maximum COGS at 30% gross gate | $185.50 | $209.30 |
| Headroom / shortfall | -$95.95 | -$72.15 |
| Payment fee, 2.9%+$0.30 | $7.99 | $8.97 |
| Warranty/return reserve, 5% | $13.25 | $14.95 |
| Support + acquisition | $35.00 | $35.00 |
| Contribution before fixed overhead | -$72.69 | -$41.37 |
| Contribution with $24 free delivery subsidy | -$96.69 | -$65.37 |

At $299 the numerical 30% gate FAILS; at $265 it FAILS. Do not lower the gate to make the design appear viable. $299 needs at least $72.15 less landed COGS to pass 30%, plus enough contingency. Get quotes before accepting this architecture for retail. Single-unit retail-stock manufacturing is $684.47 and cannot sustain either retail price. No printer, software setup, reusable jig or development/engineering capital is charged as a new purchase per chair. Machine wear and consumables are recurring and included. A 100-chair batch is a scenario, not an authorized purchase.

| Recurring line | One unit |100-chair allocation | Evidence |
| --- | ---: | ---: | --- |
|1 inch frame/carriage tube, whole 12-foot bars | $60.03 | $36.62 | Checked bar price, computed nesting |
|1.25 inch housings, whole 6-foot lengths | $25.20 | $12.60 | Checked price/foot, length assumption |
| Preload shims, 2 total | $2.00 | $0.50 | RFQ |
| Two cartridge bellows and axle/pinch guard set | $15.00 | $4.00 | RFQ |
| Two complete pneumatic wheels | $29.98 | $29.98 | observed |
| 20 steel profiles, cutting, deburring and corrosion finish | $55.00 | $18.00 | RFQ |
| Two stock-shaft axles, washers and cotters | $20.00 | $10.00 | RFQ |
| Cut standard steel sleeve/spacer stock | $18.00 | $6.00 | RFQ |
| 20 grade-5 bolts, 40 washers and 20 locknuts | $22.00 | $9.50 | RFQ |
| Padded rear support, front restraint and webbing loops | $267.38 | $88.01 | Listed materials + assumed labor/freight |
| Nonstructural prints, rejects and power | $4.00 | $3.00 | RFQ |
| Cutting, drilling, cleanup and assembly labor | $85.00 | $25.00 | RFQ |
| Per-chair inspection | $12.00 | $6.00 | RFQ |
| Packaging | $6.00 | $5.00 | RFQ |
| Inbound freight allocation | $25.00 | $7.00 | RFQ |
| Machine wear, shop consumables and tooling allocation | $3.00 | $2.00 | RFQ |
| Two MISUMI SWH20-75 springs | $10.88 | $9.24 | observed |
| Four smooth clevis pins with washers/cotters | $12.00 | $5.00 | RFQ |
| 16 liner pads and two M5 guide fastener sets | $12.00 | $4.00 | RFQ |
| **Landed COGS** | **$684.47** | **$281.45** | Mostly unquoted |

- **Two cartridge bellows and axle/pinch guard set:** Complete guard material/fastener allowance only. No qualified pattern, supplier, pinch envelope or tested attachment exists. Must replace with a quoted validated design before release.
- **Two complete pneumatic wheels:** 2 x $14.99, no bulk discount assumed.
- **20 steel profiles, cutting, deburring and corrosion finish:** 20 steel pieces: eight T gussets, four axle patches, four rectangular rail shims, four spring seats. Four profile types. $4 batch increment over r1; laser/drill/finish RFQ required.
- **Two stock-shaft axles, washers and cotters:** Unkeyed precision C1018 5/8 stock cut and cross-drilled. No approved supplier SKU/fit yet. No custom turned heads or threaded bearing journals.
- **Cut standard steel sleeve/spacer stock:** 16x25.4 and 4x31.75 small sleeves, two 55 mm guide tubes, two axle sleeves and two wheel spacers. Cut lengths and finish included; RFQ.
- **20 grade-5 bolts, 40 washers and 20 locknuts:** 12 short and 8 long grade 5 joint bolts plus 40 washers/20 nuts. $0.50 batch increment; RFQ.
- **Padded rear support, front restraint and webbing loops:** Itemized shell, mesh, 5 mm foam, all straps/wraps, six adjusters, front buckle, binding, thread and closures. Includes 10% material reject reserve, 75 min at $30/h batch or 180 min one-off, and incremental textile freight. No supplier-approved completed harness quote or load/fit qualification.
- **Nonstructural prints, rejects and power:** Allocated consumed material, not a full spool or printer purchase. Slicer grams/hours are unmeasured. Fixture allowance allocated, not charged as a new tool per chair.
- **Cutting, drilling, cleanup and assembly labor:** 60 min at $25/h batch;3.4 h one-off. Includes slots, liner trimming, seats/pins and cartridge assembly. These times are assumptions, not a time study.
- **Per-chair inspection:** Additional force/travel/friction/retention inspection allowance. Does not fund qualification tests. RFQ.
- **Packaging:** Box, protection and instructions. Outbound freight separate.
- **Inbound freight allocation:** Two tube SKUs plus springs and hardware. Long-stock checkout freight unverified; RFQ.
- **Machine wear, shop consumables and tooling allocation:** Recurring allocation. Printer/tools/jigs and one-time development capital are budgeted separately.
- **Two MISUMI SWH20-75 springs:** Two at $4.62 for 200 springs, or $5.44 for 2. Actual selected online tier, not an invented discount.
- **Four smooth clevis pins with washers/cotters:** $1.25 per complete pin set batch allowance. Supplier SKU, clear grip and retention drawing not yet verified.
- **16 liner pads and two M5 guide fastener sets:** Consumed .050 inch UHMW tape, 16 pads, two M5 x 70 ISO4762 screws, DIN433 upper washers, lower washers and locknuts. No full roll charged per unit; no verified price or wear test.

## Whole-stock purchasing

1 inch: 61 x144 inch bars at $60.03 =$3,661.83 per 100. Housing: 50 x6-foot stock at $25.20 =$1,260.00. Every cut charges 3 mm kerf; all offcuts are charged. Per-chair allocations round UP to a cent. Six-foot housing lengths are a purchasing assumption, not a confirmed supplier SKU; verify fulfillment lengths/cut tolerances and re-nest before ordering. Wider/taller/longer configurations change stock waste and margin. No imaginary wholesale discount on tube or wheels.

## Online evidence

- [Wurth ISO4762 M5 head dimensions](https://eshop.wuerth.de/Hexagon-Socket-Head-Cap-Screw-full-thread-ISO-4762-DIN-912-steel-88-plain-with-full-thread-SCR-CYL-ISO4762-88-HS4-M5X50-50/008295%2050.sku/en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): Unpriced, specification reference, price RFQ. M5 socket head diameter 8.5 mm, height 5 mm. The linked 50 mm listing verifies the head family only; our 70 mm length and actual thread engagement require supplier confirmation.
- [DIN433 M5 reduced-OD washer](https://www.dbroberts.com/din433-a2-m5.html): Unpriced, specification reference, price RFQ. M5 reduced washer 9 mm OD and 5.3 mm ID, unlike the rejected oversized guide washer. Confirm 1 mm thickness and selected steel finish with supplier. In-spring head/washer/guide max OD 9.525 mm versus catalog minimum spring ID 10.1 mm, before working deflection and misalignment.
- [6061-T6 square tube 20737, 1 x .065 inch](https://www.onlinemetals.com/en/buy/aluminum/1-x-0-065-aluminum-square-tube-6061-t6-extruded/pid/20737): $60.03, one 144 inch bar. Observed 144 inch selection, $60.03. Full bars and saw kerf charged. No wholesale discount assumed.
- [HAUL-MASTER 67467 pneumatic wheel](https://www.harborfreight.com/13-inch-x-4-inch-pneumatic-tire-67467.html): $14.99, one complete wheel. Observed regular price. Nominal 13 x 4 inch, 5/8 bore, 4.7 lb each. Supplier 300 lb wheel rating does not rate the chair. Hub length and intended use remain unapproved.
- [MISUMI SWH20-75](https://us.misumi-ec.com/vona2/detail/110100185850/?HissuCode=SWH20-75): $5.44, one spring, quantities 1-19. Observed $5.44 each; $4.62 each at 200+. Two springs per chair: $10.88 one-off or $9.24 at 100 chairs. Batch stock/checkout/freight unconfirmed. Not a chair rating.
- [Wicks SQ1-1/4X065-T6 housing tube](https://www.wicksaircraft.com/shop/6061-t6-aluminum-square-tubing/): $4.20, one foot. Observed 1.25 inch square-corner 6061-T6, .065 wall, $4.20/ft. Model buys full 6-foot lengths at $25.20 each; confirm orderable stock lengths, cut tolerance and shipping. No quantity discount assumed.
- [MISUMI SWH manufacturer table](https://in.misumi-ec.com/pdf/press/09_pr1081.pdf): Unpriced, specification reference, not a price. SWH20-75 rate 65.3 N/mm; nominal 20 mm OD/10 mm ID, 75 mm free length; table solid height 54 mm. Load tolerance +/-10%, length +/-1%. Conservative catalog deflection 14.4 mm; this is not system fatigue qualification.
- [Power Plastics .050 inch UHMW PSA wear tape](https://powerplasticscorp.com/products/uhmw-pe-tape/): Unpriced, specification reference, price RFQ. PSA050 family confirms .050 inch material exists. No exact-width price verified. Liner allowance is unquoted; actual adhesive thickness and corner fit must be measured.

Prices are observed listings, not checkout quotes or guaranteed availability. Spring rate/free-length/manufacturer deflection references come from the linked maker table. Never convert its spring load/cycle numbers into wheelchair capacity/life. Upper-seat and smooth pin strength, bending, slot wear, side loads, corrosion, stiction and undamped rebound are unqualified. Spring body rendering is an envelope helix, not a print/manufacturing model for the industrial spring. Liner adhesive and tube tolerances can consume the nominal 0.254 mm running gap.

## Conditions and exclusions

Outbound delivery is charged separately at actual cost. Customer sales tax is not revenue; manufacturing assumes valid resale treatment. Add any nonrecoverable purchase tax. Every unquoted operation, steel profile finish, pin/axle supplier fit, complete padded support/front restraint, guard system, freight and production time needs an itemized quote. The old $24 textile target is superseded by the itemized T01 estimate below. Listed material candidates and assumed sewing/freight still do not establish a qualified support or anchor. Guard development, clinical/structural qualification, insurance, salaries and startup overhead need separate funding. Full fur/pinch/spring guards remain a release gate; the included $4 manufacturing allowance is provisional, with assembly time included in labor. A quoted validated guard design must replace it before a sale-ready COGS claim. A 20% COGS overrun costs $56.29 per chair and can eliminate contribution. The rigid r1 baseline remains the lower-complexity fallback.

## Manufacturing release gates

Measure Buddy using the fit guide; obtain clinical guidance. Review the complete metal/textile load paths and dimensions. Verify actual spring tolerances, stock corners, wear-liner fits, seats, guide clearances, slot and pin ligaments, positive retainers and wheel journals. Build only a guarded empty rig, measure force/travel and rebound, then qualify fatigue/stability/terrain and all guarding to an approved protocol before any animal. No hind-leg training or support-force prescription follows from the ideal spring-force preview. Time actual manufacturing and replace all allowances; both qualification and 30% margin gates must pass.

Native commands: `./buddy design:xl-spring --export --openscad /absolute/path/to/OpenSCAD`, `./buddy test`, `bun run test:spring`. Inspect and download matching files at [the r2 studio](https://buddywheels.org/design-studio-xl-suspension).
# Complete XL support and harness cost

Checked November 8, 2026. XL r2, rear 220 x 350 mm, chest 1065 mm. Price candidates, not a qualified harness or production quote.  This replaces the old $24 T01 target and $50 one-off allowance. All SG items expand one complete T01 bundle, rather than adding a second harness. For r0 the study remains an unqualified alternative to T01/T02 supplier-selected supports.

## Complete textile purchasing and labor

| Textile line | One-build stock cash | Per chair at 100 | Purchase for 100 |
| --- | ---: | ---: | --- |
| Woven shells, 12 chafe panels and 10 closure tabs | $18.71 | $3.56 | 19 whole linear yards, $355.49 |
| Rear and front spacer mesh | $12.68 | $1.27 | 10 whole linear yards, $126.80 |
| Rear and front 5 mm EVA pads | $31.50 | $3.78 | 12 39 x 51 inch sheets, $378.00 |
| Every webbing cut including returns, laps and tails | $20.57 | $17.81 | 23 120-foot rolls, $1780.43 |
| Six metal double-bar adjusters | $4.50 | $4.50 | 600 each, higher conflicting listing price, $450.00 |
| One 1-inch acetal front closure | $1.10 | $1.10 | 100 each, $110.00 |
| 20 mm binding including cover-tab edges | $8.99 | $7.56 | 84 10-meter packs; each panel/tab edge stays continuous, $755.16 |
| Tex 90 top/bobbin thread allowance | $15.95 | $1.44 | 9 987.552-meter cones, $143.55 |
| Ten 20 x 20 mm hook patches | $0.90 | $0.63 | 70 linear feet of 1-inch hook, $63.00 |
| Ten 20 x 20 mm loop patches | $0.90 | $0.63 | 70 linear feet of 1-inch loop, $63.00 |
| Materials, full purchasing units and nesting | $115.80 | $42.28 | All offcuts and leftover stock charged |
| Manufacturing rejects reserve, 10% of materials | $11.58 | $4.23 | Planning reserve, separate from geometric offcuts |
| Cut, sew and textile inspection labor | $90.00 | $37.50 | 180 / 75 minutes at $30/hour loaded labor assumption |
| Additional textile inbound freight | $50.00 | $4.00 | Unquoted, separate from frame/hardware freight |
| **Complete T01 support/harness** | **$267.38** | **$88.01** | No completed-set supplier quote |

One-build cash buys full supplier packs and leaves reusable material inventory. It is not net consumed fabric cost and it excludes a new printer/sewing machine. The 100-chair column allocates all batch purchasing cash and rounds each line up to a cent. No batch is authorized. Customer tax and delivery are separate. Nonrecoverable purchase tax must be added if resale treatment is unavailable.

## Exact consumption and purchasing method

All 33 SG rows are covered: SG01, SG02, SG03, SG04, SG05, SG06, SG07, SG08-1, SG08-2, SG08-3, SG08-4, SG08-5, SG08-6, SG08-7, SG08-8, SG08-9, SG08-10, SG08-11, SG08-12, SG08-13, SG08-14, SG08-15, SG08-16, SG08-17, SG09-R, SG09-B, SG10-R, SG10-B, SG11, SG12, SG13, SG14, SG15. Webbing cuts total **8.228 m per set**, including actual returns, 60 mm laps, adjustable tails, perimeter keepers and all six frame wraps. Binding totals **8.292 m**, including the ten cover-tab perimeters missing from the earlier binding allowance. Thread allowance is 80 m per set, top and bobbin combined, unmeasured.

Woven nesting includes the two body panels, twelve chafe-sleeve panels and ten tabs. Mesh and foam each include both body panels. Shelf nesting keeps grain orientation, 5 mm cutting gaps, 20 mm stock-width trim and 40 mm stock-end trim. This is a reproducible feasible purchasing plan, not an optimal nest. Foam uses 12 whole sheets for 100 sets. Mesh buys 10 whole yards, below the 20-yard discount threshold, so no discount applies. Binding and webbing use first-fit cuts with 2 mm separation; every panel edge remains continuous. Hook and loop are purchased separately, trimmed from 25.4 to 20 mm, with 1 mm between patches and 25-foot supplier section boundaries. Thread buys 9 full cones. No net-area-only pricing or assumed wholesale discount is used.

The $37.50 batch sewing allowance assumes 75 minutes at a loaded $30/hour. It covers textile cutting, binding, reinforcement/box stitches, threading, closures and in-process textile checks. Frame assembly and final chair QA are still charged separately. A factory's completed-set quote must replace these inputs without double-counting its included sewing/freight. Qualification tests and fixed business overhead remain separate. The 10% reject reserve does not fund design qualification or prove any yield.

## Current listed material candidates

- [Rockywoods 58-CORDURAPOLY-Black](https://rockywoods.com/products/1000-denier-coated-cordura-hp-polyester-fabric): $18.71 per 60-inch-wide linear yard. 1000D-class coated polyester, listed $18.71/yard. Model buys whole yards without an unverified roll discount. Exact black-variant availability is unconfirmed; page exposes both Sold Out and Add to Cart. Nominal .025-inch thickness is not the CAD .8 mm envelope.
- [OWF SPACER3MM](https://www.owfinc.com/Spacer-3mm-Mesh/productinfo/SPACER3MM/): $12.68 per 58-inch-wide linear yard. Listed in stock. $12.68/yard, $9.89 at 20 yards, $8.62 for a full 30-yard roll. Use $12.68 until the actual purchase reaches a tier. Listed 3 mm / approximately 3/32 inch; this is a costing candidate for the 1.5 mm CAD reference layer, not an approved thickness substitution.
- [Avetco E600 5 mm EVA SP60A.5MM.BLACK.39X51](https://www.avetcoinc.com/product/e600-high-density-eva-foam-sheets-60-65-shore-c-39-x-51-5mm-10mm/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): $31.50 per 39 x 51 inch sheet, 5 mm. Exact 5 mm variation $31.50, in stock, MOQ one. Firm 60-65 Shore C. Comfort/compression remains unqualified. Sheet nesting, not net area pricing.
- [Strapworks WSR-POL-PUT-001-BLK](https://www.strapworks.com/1-inch-utility-polyester-webbing-black): $77.41 per 120-foot roll, 1 inch polyester. Listed in stock. $77.41/120 ft; singles $0.74/ft, 30 ft $20.57, 60 ft $39.51. Batch uses actual 120-foot rolls; one-off compares those options without assuming a continuous splice-free roll. Nominal .065-.07 inch thickness; compatibility and sewn strength unqualified.
- [Seattle Fabrics H-MLL](https://www.seattlefabrics.com/1-Metal-Double-Bar-Ladder-Lock-in-Nickel-Plated-Steel_p_490.html): $0.75 per one 1-inch nickel-plated steel double-bar ladder lock. Page header $0.65, description $0.75. Model conservatively uses $0.75, not the lower conflicting price. Page states In Stock but also contains a generic wait-list block. Checkout and actual dimensions/radii/slip resistance need verification.
- [RBTR SR-1-B, variant 12231494785](https://ripstopbytheroll.com/products/standard-side-release-buckle?variant=12231494785): $1.10 per one 1-inch acetal single-adjust buckle. Exact 1-inch variant $1.10, available=true. Default $0.90 is the smaller 3/4-inch option. Front restraint only in this study.
- [HobbyTrendy BSB12 red polyester satin binding](https://hobby-trendy.com/products/polyester-satin-bias-binding-tape-single-fold-20mm-13-16inch-10meters-10-93yds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): $8.99 per 10-meter pack, nominal 20 mm single fold. Red available, black BSB24 unavailable. Satin construction, supplied/folded width and durability must be approved against the 20 mm cut/sew specification. Cost reference only; a qualified black industrial equivalent still needs a quote.
- [Sailrite 123338 PremoBond Tex 90 black bonded polyester](https://www.sailrite.com/PremoBond-V-92-Black-UV-Bonded-Polyester-Thread-4-Oz-1-350-Yds): $15.95 per 4 oz cone, current title 1,080 yards / 987.552 m. Current title says 1,080 yards although URL says 1,350. Use the shorter current yield. Listed available. 80 m per set covers top/bobbin/rework only as an unmeasured allowance.
- [RBTR 1-VELCRO-HOOK-B](https://ripstopbytheroll.com/products/velcro-industrial-hook-and-loop?variant=47238308692138): $0.90 per one foot, 1-inch sew-on nylon hook. Available=true. Trim width to 20 mm, charge full bought width. Cuts include 1 mm separation; account for 25-foot supplier section boundaries.
- [RBTR 1-VELCRO-LOOP-B](https://ripstopbytheroll.com/products/velcro-industrial-sew-on-tape-loop?variant=47238312591530): $0.90 per one foot, 1-inch sew-on nylon loop. Purchased separately from hook at the same price. Ten mated patches require ten pieces of each side.

The black shell's stock status is not confirmed, black binding is unavailable, and the priced red satin binding needs construction/fold-width approval. The foam is firm and needs pressure/comfort testing. Mesh and webbing thicknesses differ from nominal inspection envelopes. Adjuster radii, dimensions, corrosion behavior, strap slip and actual threading remain unapproved. These prices do not authorize material substitutions, provide a dog-support rating or establish an orderable production BOM. Custom colors can add minimums and costs. Hold retail release until a compatible, available bill is quoted and physically qualified.
