stacksjs/buddy-wheels/designs/softgoods/r1/L-r0/softgoods/cost-notes.md

# Textile costing scope

L r0 is a separate cut/sew study. The checked complete price model covers XL with 1-inch webbing and hardware. Do not apply those SKUs or prices to this smaller family. Obtain its correctly sized material, hardware, sewing and freight quotes. No animal-use qualification exists.
