stacksjs/buddy-wheels/designs/rover/r0/bom.csv

ID | Quantity | Part | Specification | Status
C01 | 2 | Base side rail | 6061-T6 1 x 1 x 1/8 inch square tube; cut 1678.65 mm | Cut to fit. Not telescoping
C02 | 2 | Base end cross member | 6061-T6 1 x 1 x 1/8 inch square tube; cut 700 mm | Cut to fit. Not telescoping
C03 | 2 | Axle post | 6061-T6 1 x 1 x 1/8 inch square tube; cut 922.6122 mm | Cut to fit. Not telescoping
C06 | 2 | Ramp side curb rail | 6061-T6 1 x 1 x 1/8 inch square tube; cut 1000 mm | Cut to fit. Not telescoping
C07 | 2 | Ramp under rib | 6063-T52 1 x 1 x 1/16 inch square tube; cut 688 mm | Cut to fit. Not telescoping
C08 | 2 | Ramp stand leg | 6061-T6 1 x 1 x 1/8 inch square tube; cut 107.3571 mm | Cut to fit. Not telescoping
C11 | 3 | Top cross tube | 6063-T52 1 x 1 x 1/16 inch square tube; cut 725.4 mm | Cut to fit. Not telescoping
C14 | 3 | Base intermediate cross member | 6063-T52 1 x 1 x 1/16 inch square tube; cut 700 mm | Cut to fit. Not telescoping
C17 | 2 | Brake arm | 6061-T6 1 x 1 x 1/8 inch square tube; cut 140 mm | Cut to fit. Not telescoping
C26 | 2 | Side hoop | 6063-T52 1 inch OD x 1/8 inch wall round tube; ordered 2882.2637 mm | Cut and bent by a mail-order service. See bend-schedule.csv
C27 | 1 | Handle bar | 6063-T52 1 inch OD x 1/8 inch wall round tube; ordered 2696.1894 mm | Cut and bent by a mail-order service. See bend-schedule.csv
C28 | 2 | Nose hoop | 6063-T52 1 inch OD x 1/8 inch wall round tube; ordered 1031.9894 mm | Cut and bent by a mail-order service. See bend-schedule.csv
C22 | 2 | Swing arm | 6061-T6 1 x 1 x 1/8 inch square tube; cut 357.8103 mm | Cut to fit. Not telescoping
C23 | 2 | Shock spacer tube | 6061-T6 1 x 1 x 1/8 inch square tube; cut 60 mm | Cut to fit. Not telescoping
J02 | 10 | Tube bend | 76.2 mm (3 inch) centerline radius in the round tubes, bent by a mail-order service; see bend-schedule.csv | The radius and the straight needed beside each bend are one service's rules. Every bent tube passed its design check on 2026-11-12. None has been ordered or bent
H07 | 2 | Handle bar end plug | Plastic plug for 1 inch OD x 1/8 inch wall round tube, 3/4 inch inside | Closes the two open ends of the handle bar
J01 | 36 | Welded joint | TIG, 4043 or 5356 filler at the shop's choice, fillet all round unless weld-schedule.csv says otherwise | No weld procedure, sample or strength figure exists. The metal beside every weld is softer than the tube it joins
M04 | 2 | Brake clamp plate | 6061-T6 3.175 mm, metal/brake_plate.dxf | Bolts to the front face of the brake arm with two bolts. Drill its clamp holes from the delivered clamp
M05 | 4 | Shock plate, swing arm | 6061-T6 3.175 mm, metal/shock_plate.dxf | A pair on the two side faces of each swing arm. Check the 8.2 eye hole and the 25.4 gap against the delivered shock
M09 | 4 | Shock hanger, axle post | 6061-T6 3.175 mm, metal/shock_hanger.dxf | A pair on each axle post, either side of a C23 spacer tube
U01 | 2 | Coil-over shock | 150 mm eye to eye, 30 mm travel, spring labeled 450 lbs, 24 mm wide eyes with an 8 mm bore; LvTu 150 mm candidate | Candidate only. Travel and sag figures assume the seller's numbers and treat the spring label as lb/in. Damping, life and corrosion unknown
U02 | 2 | Swing arm pivot bolt | 1/2-13 x 4 inch grade 5 hex bolt, lock nut, two washers, a 5/8 inch OD crush sleeve in the rail and a 13 mm spacer | Single bolt through the base rail. Side play here becomes wheel wobble; untested
U03 | 4 | Pivot bushing | Oil-impregnated bronze flanged sleeve bearing, 1/2 ID x 5/8 OD x 1/2 inch long | One pressed into each wall of each swing arm, flange outside
U04 | 4 | Shock eye bolt | M8 x 50 hex bolt and nylon-insert lock nut | One through each pair of plates
U05 | 4 | Shock hanger bolt | 1/4-20 x 3-1/2 inch grade 5 hex bolt, lock nut, two washers and a 9.8 mm spacer cut from the sleeve tube | Through outer hanger, spacer tube, inner hanger, spacer and axle post. Two per side
W01 | 2 | Pneumatic wheel candidate, 15 inch 4.00-8 | Zoro Select 1NWV4; 15 3/16 inch OD, 3 1/8 inch wide, 5/8 inch bore, ball bearings, hub length stated 4 inch; configured 101.6 mm | Supplier states a 435 lb wheel load. That does not rate the carrier. Measure the delivered hub before cutting an axle
W02 | 2 | Rear stub axle | Plain 15.875 steel shaft; cut 162.4 mm; two 3.2 cross-holes 8 mm from each end | Unkeyed precision shaft. Never a threaded journal
W07 | 1 | Front swivel caster with swivel lock, 10 inch pneumatic | Service Caster SCC-100S3504-PNB-BSL; 10 x 3-1/2 inch wheel, top plate, stated mounting height 12-3/16 inch; configured 310 mm | Supplier states 350 lb and a bolt-on swivel lock. The maker lists a 4 x 4-1/2 inch plate with holes at 2-5/8 x 3-5/8 inch slotted to 3 x 3 inch for this series. Lock the swivel for running
H06 | 4 | Caster bolt set | 5/16-18 x 2-1/2 inch grade 5 bolt, two washers, lock nut and a steel crush sleeve | Vertical through both caster beams, with a washer over each plate slot. Check the delivered plate against the drilling schedule first
W04 | 2 | Axle sleeve | 4130 tube 19.05 OD x 1.4732 wall; cut 25.4 mm | Through each axle post. Steel, not printed
W05 | 2 | Wheel spacer | 4130 tube 19.05 OD x 1.4732 wall; cut 12.7 mm | Rear wheels only. Check actual hub and bearing face contact
W06 | 4 | Thrust washer and split cotter set | 5/8 inch bore washer 1.5 mm; 3.2 mm stainless cotter | Two washers and two cotters per rear wheel
H01 | 8 | Joint bolt | 1/4-20 x 2 inch SAE J429 grade 5 zinc hex bolt | Partially threaded shank required at sleeves. Torque procedure pending. 18-8 stainless is the salt-use upgrade
H03 | 16 | Crush sleeve | A513 DOM steel tube .375 OD x .049 wall; cut 25.4 mm | One per tube crossing. Corrosion finish between steel and aluminum pending
H04 | 16 | Bolt washer | 1/4 inch zinc steel flat washer | Two per bolt
H05 | 8 | Prevailing-torque nut | 1/4-20 zinc nylon-insert locknut | New nuts at every assembly
F01 | 1 | Floor panel | 15/32 inch (12 mm) ACX exterior plywood 1350.8 x 750.8 mm, six post notches 44 x 30, sealed all faces and edges; marine plywood for salt use | Sits on the base tubes and bedding tape. Deflection under a standing dog not yet calculated
F02 | 1 | Bedding tape | 3.2 mm closed-cell tape, 25 mm wide, about 9 m | Under both panels, between the plywood and the aluminum
F03 | 27 | Floor fastener set | 1/4-20 stainless countersunk screw with rivet nut in the tube top wall | Rivet nut pull-out in .125 wall to be tested
R01 | 1 | Ramp panel | 15/32 inch (12 mm) ACX exterior plywood 1000 x 688 mm, sealed all faces and edges, toe edge fitted with printed threshold toes | Curb rails on top, two ribs underneath
R02 | 1 | Continuous hinge | Stainless piano hinge, 1 inch leaf, 36 inch, cut to 680 mm; Zoro Select 2ZFK4 candidate, unpunched | Leaves on the top faces, knuckle in the 6 mm gap. Drill and countersink for flat-head screws. Pinch review pending
R03 | 2 | Draw latch with keeper | Stainless toggle-style draw latch; Southco TL-20-202-52 candidate | Holds the raised ramp to both rear posts. The supplier page does not say a keeper is included. The rear posts are round on this frame, so each keeper needs a flat pad or a curved shim, not yet drawn
R04 | 1 | Tailgate safety strap | 1 inch webbing with a metal hook, independent of both latches | Second retention path if a latch opens
R05 | 18 | Ramp carriage bolt | 1/4-20 x 2 inch stainless carriage bolt, washer and locknut | Smooth heads on the walking side
R06 | 2 | Ramp stand leg cap | Printed cap_heavy.stl pressed into the bottom of each stand leg | Leg cut 107.3571 mm puts the capped end on level ground with the ramp lowered. Fixed length: shim on uneven ground
B01 | 2 | Wheel chock | Solid rubber wheel chock, Harbor Freight 96479 candidate | Backup on slopes and whenever the ramp is down
B03 | 2 | Parking brake clamp | Push-pull toggle clamp, 300 lb holding capacity, about 1-5/16 inch plunger travel; POWERTEC 302F candidate, with four #10 screws and lock nuts each | Bolts to a brake clamp plate over each rear tire. Untested as a brake
B04 | 2 | Brake pad spindle | Toggle clamp spindle, 5/16-18, neoprene flat tip, with jam nuts; DE-STA-CO 507208 candidate | Replaces the plain bolt in the clamp plunger. Cut to length if it bottoms out. Adjust so the tip presses about 10 mm into the tire when locked
B02 | 1 | Handle grip and wrist tether | Foam grip for 25.4 tube over 801.6 mm; 1.2 m wrist tether | Tether is a secondary link to the caregiver
S01 | 2 | Tip-stop foot | 3/8-16 swivel leveling mount, tall version of S&W BSW-1Z, through each base rail behind the axle, nut and washer above and below | Catches a rearward tip. Height setting and strength are untested
X01 | 1 | Roof ridge pole | 12.7 mm aluminum tube, cut 1016.8582 mm | Rests in three printed saddles
T01 | 1 | Weather cover set | Roof and wall shell, mesh windows, clear storm panels, hook and loop, seam tape, reflective trim | See cover-cut-schedule.csv and materials.md. No sewn sample exists
T02 | 1 | Floor set | Two EVA pad halves under a vinyl tub liner with a threshold flap | Removable for washing
T03 | 1 | Ramp traction surface | 5 mm adhesive EVA, 637.2 x 1000 mm between the curbs | Wet grip unproven
T04 | 2 | Interior tether loop | 1 inch webbing loop around a base rail with a 316 D-ring | Positioning aid only. Not a restraint rating
P-cap_heavy | 16 | Chassis tube cap | cap_heavy.stl | Closes 1/8 inch wall tube ends. End protection only.
P-ramp_toe | 3 | Ramp threshold toe | ramp_toe.stl | Ground-supported bevel that removes the step at the ramp edge. It is not the ramp structure.
P-ridge_saddle | 3 | Roof ridge saddle | ridge_saddle.stl | Holds the ridge pole above the frame so the roof sheds water. Carries fabric tension only.
P-fabric_clip | 28 | Cover rail clip | fabric_clip.stl | Snaps a cover hem onto a frame tube. No restraint or structural function.
P-cable_clip | 6 | Brake cable clip | cable_clip.stl | Routes one brake cable housing along a tube. Not a brake anchor.
P-axle_cover | 4 | Axle end cover | axle_cover.stl | Covers a shaft end and cotter. Never a shaft retainer or a complete fur guard.
P-guide_butt | 1 | Drill guide, butt ends | guide_butt.stl | Pilot centers 22.3, 37.3, 52.3 and 67.3 mm from a cut end. Layout aid only.
P-guide_run | 1 | Drill guide, corner runs | guide_run.stl | Pilot centers 47.7, 62.7, 77.7 and 92.7 mm from a rail end. Layout aid only.
P-guide_tee | 1 | Drill guide, tee pattern | guide_tee.stl | Pilot centers 30 mm each side of a scribed joint line. Layout aid only.
P-coupon | 1 | Clearance coupon | coupon.stl | Calibrates the actual printer before any fit is trusted. Not part of the carrier.
