stacksjs/buddy-wheels/designs/wheelchair/r2/XL/bom.csv

ID | Quantity | Part | Specification | Status
M01 | 2 | Side rail | 6061-T6 1 x 1 x .065 inch tube; cut 680 mm | Cut to fit, not telescoping
M03 | 1 | Rear bridge | 6061-T6 1 x 1 x .065 inch tube; cut 374.6 mm | Cut to fit, not telescoping
M04 | 8 | Repeated T gusset | A36 steel 3.175 mm, joint_plate.dxf | Cut/drill one repeated profile; finish and corrosion process pending
M05 | 4 | Axle patch | A36 steel 3.175 mm, axle_plate.dxf | Finish bearing holes after drawing review
W01 | 2 | Pneumatic wheel candidate | HAUL-MASTER 67467; 330.2 OD, 101.6 width, 15.875 bore mm | Supplier hub length not verified; configuration assumes 82.55 mm. Supplier wheel rating is not a chair rating
W02 | 2 | Plain round steel axle stock | 15.875 diameter; cut 162.4 mm; two 3.2 cross-holes | Unkeyed C1018 precision shaft, finish fits/material/retention still need review. No thread as bearing journal
W03 | 2 | Upright axle sleeve | 4130 tube 19.05 OD x 1.4732 wall; cut 25.4 mm | Steel, not a printed load path
W04 | 2 | Outboard wheel spacer | 4130 tube 19.05 OD x 1.4732 wall; cut 25.4 mm | Check actual hub/bearing face contact
W05 | 4 | Axle thrust washer | 5/8 inch bore; nominal 1.5 mm thick | Bearing contact/stack must be verified
W06 | 4 | Split cotter | 3.2 mm shaft cross-hole | Positive end retention, not a friction cap; verify pin end ligaments
H03 | 40 | Bolt washer | 1/4 inch steel flat washer | Two per bolt
H04 | 20 | Prevailing-torque nut | 1/4-20 steel locknut | New retained fasteners, procedure pending
T01 | 1 | Rear support and front restraint set | Padded textile support with continuous webbing loops around metal rails | OEM RFQ only; no approved pattern, rating, size, sewing schedule or anchors. Requires engineering and professional fitting
P-end_cap | 6 | Rounded tube cap | end_cap.stl | Optional end protection. No structural retention.
P-axle_cover | 2 | Axle end sample cover | axle_cover.stl | Empty-rig cover only. Never a shaft retainer or complete fur guard.
P-drill_guide | 1 | Tube layout guide | drill_guide.stl | Bench layout aid. Finish holes require proper metal tooling.
P-coupon | 1 | Clearance coupon | coupon.stl | Calibrate the actual printer. Not part of the chair.
M02 | 2 | Wheel carriage | 6061-T6 25.4 x 25.4 x 1.651 mm; cut 220 mm | See r2 drilling and slot datums
S01 | 2 | Outer housing | 6061-T6 31.75 x 31.75 x 1.651 mm; cut 387.2 mm | Wicks SQ1-1/4X065-T6; inspect actual corners, bore, finish and straightness
S02 | 2 | Compression spring | MISUMI SWH20-75; OD 20 ID 10 nominal, L 75 mm, k 65.3 N/mm | Undamped industrial spring; no dog-support approval
S03 | 4 | Spring seat | 3.175 mm A36 steel; spring_seat.dxf | Lower bridges carriage bore; upper retained by smooth steel pin. Do not print for loaded use
S04 | 4 | Housing retaining pin | 8 mm smooth steel clevis pin, nominal 45 mm under-head length; matching washers/cotters | Two per side. Required clear grip >=34.75 mm. Head/cross-hole specification and supplier SKU require drawing approval; no threads in slots
S05 | 16 | Wear liner | PSA UHMW .050 inch; 18 x 35 mm patches | Two bands of four faces, carriage z=120-155 and 180-215. Keep 8.2 mm slots clear. Actual tolerance, adhesive and wear unqualified
S06 | 2 | Spring guide tube | 4130 .375 OD x .049 wall inch; cut 55 mm | 9.525 OD guide through nominal 10 mm spring ID; verify minimum spring ID, bow and installation clearance
S07 | 2 | Guide fastener set | M5 x 70 mm ISO4762 socket screw (8.5 OD, 5 high head); DIN433 upper washer 5.3 ID/9 OD/1 mm; underside washer 1 mm and 5 mm locknut | Retains guide to lower seat only, does not tie upper seat to carriage. Bolt/head height and 4 mm nominal bump clearance require verification
S08 | 2 | Preload shim | DIN 988 steel washer 10 ID x 20 OD x 1 mm | Stack below upper seat, identical both sides. Preload shifts initial force; spring rate stays 65.3 N/mm
S10 | 1 | Complete cartridge/axle/pinch guard set | Two flexible cartridge bellows plus axle-end and joint pinch guards, retained to metal | RFQ allowance only; pattern and attachment unqualified. No animal use without completed tested guards
S09 | 4 | Rail width shim | 3.175 mm A36 steel, rail_shim.dxf | One between each vertical T plate and narrower rail, not between plate and housing
H01 | 12 | Joint bolt | 1/4-20 x 2 inch SAE J429 grade 5 | Rear frame and axle patches
H01L | 8 | Long joint bolt | 1/4-20 x 2.25 inch SAE J429 grade 5 | Four rail and four housing-top bolts; check thread engagement
H02 | 16 | Short crush sleeve | 4130 .375 OD x .049 wall inch, cut 25.4 mm | Four rail, eight rear bridge/rail, four axle-patch sleeves
H02L | 4 | Housing crush sleeve | Same steel stock, cut 31.75 mm | Housing-top bolts only. Retaining pins stay free, no sleeve through moving carriage
