stacksjs/buddy-wheels/designs/wheelchair/iterations/buddy-xl-estimate/bom.csv

ID | Quantity | Description | Nominal specification mm | Status
M01 | 2 | Side rail | 25 square x 2 wall x 680 long; 6061-T6 candidate | Cut/drill after drawing review
M02 | 2 | Lower upright | 25 square x 2 wall x 315 long; 6061-T6 candidate | Cut/drill after drawing review
M03 | 2 | Upper upright | 20 square x 2 wall x 180 long | Indexed telescoping joint
M04 | 1 | Bridge outer | 25 square x 2 wall x 262.5 long | Indexed telescoping joint
M05 | 1 | Bridge inner | 20 square x 2 wall x 262.5 long | Indexed telescoping joint
M06 | 4 | Fixed suspension cheek | 6 plate; fixed_plate.dxf | Metal only for loaded bench testing
M07 | 4 | Trailing arm cheek | 6 plate; arm_plate.dxf | Metal only for loaded bench testing
M08 | 8 | Frame corner cheek | 6 plate; corner_plate.dxf | Metal only for loaded bench testing
S01 | 2 | Adjustable spring/damper assembly | Extended eyes 165; stroke 38; nominal installed 155; max OD 40; eye bore 8; eye width 20 | RFQ interface only; supplier approval/tune pending
S02 | 2 | Main pivot pin with head and cross-hole | Ground diameter 10; underhead to retaining washer inner face 60.5; end cross-hole 2; washer stack detailed in guide | Custom turned steel candidate; drawing review required
S03 | 4 | Pivot bronze bush | ID 10; nominal OD 14; length 6; fit per supplier, not raw DXF | Supplier running/press fits pending
S04 | 2 | Inner pivot spacer | ID 10.2; OD 14; length 20 | Turned metal
S05 | 4 | Outer pivot spacer | ID 10.2; OD 14; length 8 | Turned metal
S06 | 2 | Travel-stop pin, head and cross-hole | Ground diameter 6; retention span 60.5; end cross-hole 2 | Must slide freely in both slots; no preload
S07 | 2 | Lock pin, head and cross-hole | Ground diameter 6; retention span 60.5; end cross-hole 2 | Installed only in neutral hole, never a friction lock
S08 | 2 | Stop pin arm spacer | ID 6.2; length 20; OD 10 | Metal; between arm cheeks
S09 | 2 | Lock pin arm spacer | ID 6.2; length 20; OD 10 | Metal; between arm cheeks
S10 | 4 | Upper shock eye spacer | ID 8.2; length 14; OD 12 | Confirm does not contact shock body/eye rotation
S11 | 2 | Upper shock pivot pin | Diameter 8; retention span 60.5; end cross-hole 2 | Supplier eye-bushing fit pending
S12 | 2 | Lower shock pivot pin | Diameter 8; retention span 32.5; end cross-hole 2 | Connects paired arm cheeks through eye
W01 | 2 | Wheel and pneumatic tire assembly | OD 400; tire width <=50; hub bearing stack 40; bore 12 | Exact wheel SKU, tire pressure and capacity pending
W02 | 2 | Headed axle shaft | Diameter 12; retention span 106.5; end cross-hole 2 | Custom turned steel; no thread running in bearing
W03 | 2 | Inner axle spacer | ID 12.2; length 20; OD 16 | Between arm cheeks
W04 | 2 | Outer axle spacer | ID 12.2; length 34; OD 16 | Between outer arm and wheel inner bearing
H01 | 16 | Frame joint through-bolt set | M6; grip 37; length >= grip + 2 washers + full locknut engagement | 8 rail/upright + 8 bridge bolts; verify selected actual lengths
H02 | 4 | Suspension-to-upright through-bolt set | M6; grip 60 | Choose length from actual washers and locknut
H03 | 4 | Upright index through-bolt set | M6; grip 25 | Two per upright; no friction-only height retention
H04 | 2 | Bridge index through-bolt set | M6; grip 25 | Two at nominal center +/- pitch/2
H05 | 8 | Fixed cheek-to-upright spacer | ID 6.4; length 11.5; OD 12 | Four per side, no printed compression stack
H06 | 12 | Small tube-to-corner cheek spacers | ID 6.4; length 2.5; OD 12 | 8 at upper uprights + 4 at right bridge
H07a | 20 | Outer tube crush sleeves | OD 8; ID 6.2; length 25; tube bore 8.2 | Ends flush with outer faces; 6 index sleeves removable
H07b | 6 | Inner tube crush sleeves | OD 8; ID 6.2; length 20; tube bore 8.2 | 4 upper upright corner bolts + 2 right bridge corner bolts
H08 | 52 | Frame bolt washers | Fits M6 | Two per through-bolt
H09 | 26 | Frame bolt prevailing-torque locknuts | M6 | No torque specified until joint procedure validated
H10 | 12 | Clevis pin retention cotters | 2 cross-hole interface; actual cotter and pin end ligament require review | One per headed pin, including axles
H11 | 12 | Clevis pin end washers | Bore matches each pin; nominal thickness 1.5; cross-hole diameter 1 for XS or 2 for other families | One per pin at cotter end; retain 0.5 axial float, see shaft drawing notes
T01 | 1 | Padded rear support harness | Professionally selected, measured and supplier-rated | Not a printed or self-designed textile sling
T02 | 1 | Front harness and paired side tethers | Professionally selected, independent of suspension | Hardware and routing approved at fit gate
T03 | 1 | Bench ballast cradle, scales and safety catch | Keep ballast out of pinch paths; supported load measured on rig | Fixture specified by test engineer, not supplied as wearable part
P-tube_cap | 4 | Outer-tube end protection, optional | tube_cap.stl | Nonstructural print, not a released wearable part
P-inner_cap | 1 | Inner bridge end protection, optional | inner_cap.stl | Nonstructural print, not a released wearable part
P-index_collar | 2 | Loose setup witness marker, no retention function | index_collar.stl | Nonstructural print, not a released wearable part
P-pivot_guard | 4 | Removable shield for non-animal rig only | pivot_guard.stl | Nonstructural print, not a released wearable part
P-drill_jig | 1 | Pilot layout aid only; metal bush tooling required for final holes | drill_jig.stl | Bench tooling only
P-coupon | 1 | Hole-clearance calibration coupon | coupon.stl | Bench tooling only
P-shock_dummy | 2 | Rigid nominal eye-distance gauge, no spring/damping or load function | shock_dummy.stl | Bench tooling only
