stacksjs/buddy-wheels/designs/softgoods/r1/XL-r0/softgoods/costs.csv

Line | One-build stock cash USD | 100-chair allocation USD | 100-chair purchase USD | Purchased units at 100 | Source
Woven shells, 12 chafe panels and 10 closure tabs | 18.71 | 3.56 | 355.49 | 19 | https://rockywoods.com/products/1000-denier-coated-cordura-hp-polyester-fabric
Rear and front spacer mesh | 12.68 | 1.27 | 126.80 | 10 | https://www.owfinc.com/Spacer-3mm-Mesh/productinfo/SPACER3MM/
Rear and front 5 mm EVA pads | 31.50 | 3.78 | 378.00 | 12 | https://www.avetcoinc.com/product/e600-high-density-eva-foam-sheets-60-65-shore-c-39-x-51-5mm-10mm/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
Every webbing cut including returns, laps and tails | 19.98 | 17.81 | 1780.43 | 23 | https://www.strapworks.com/1-inch-utility-polyester-webbing-black
Six metal double-bar adjusters | 4.50 | 4.50 | 450.00 | 600 | https://www.seattlefabrics.com/1-Metal-Double-Bar-Ladder-Lock-in-Nickel-Plated-Steel_p_490.html
One 1-inch acetal front closure | 1.10 | 1.10 | 110.00 | 100 | https://ripstopbytheroll.com/products/standard-side-release-buckle?variant=12231494785
20 mm binding including cover-tab edges | 8.99 | 7.56 | 755.16 | 84 | https://hobby-trendy.com/products/polyester-satin-bias-binding-tape-single-fold-20mm-13-16inch-10meters-10-93yds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
Tex 90 top/bobbin thread allowance | 15.95 | 1.44 | 143.55 | 9 | https://www.sailrite.com/PremoBond-V-92-Black-UV-Bonded-Polyester-Thread-4-Oz-1-350-Yds
Ten 20 x 20 mm hook patches | 0.90 | 0.63 | 63.00 | 70 | https://ripstopbytheroll.com/products/velcro-industrial-hook-and-loop?variant=47238308692138
Ten 20 x 20 mm loop patches | 0.90 | 0.63 | 63.00 | 70 | https://ripstopbytheroll.com/products/velcro-industrial-sew-on-tape-loop?variant=47238312591530
Manufacturing rejects | 11.53 | 4.23 |  |  | 10% assumption
Textile cutting/sewing/inspection | 90.00 | 37.50 |  |  | 180/75 minutes at $30/hour assumption
Additional textile freight | 50.00 | 4.00 |  |  | Unquoted allowance
COMPLETE T01 | 266.74 | 88.01 |  |  | Candidate materials and unquoted production assumptions
