stacksjs/buddy-wheels/designs/softgoods/r1/XL-r1/softgoods/textile-bom.csv

ID | Qty | Part | Cut / interface mm | Material and role | Cost parent
SG01 | 1 | Rear woven shell | 220 x 350, saddle-shell.svg | Woven abrasion-resistant polyester shell, candidate 1000D class. Structural shell must be coupon-qualified | T01
SG02 | 1 | Rear spacer-mesh liner | Same saddle outline | Bought 3D polyester mesh, nominal 1.5-3 mm. Comfort/ventilation layer, not the sole support | T01
SG03 | 1 | Rear pad | Same saddle outline | Closed-cell EVA/XLPE nominal 5 mm, bound washable cover. Pressure and hygiene validation pending | T01
SG04 | 1 | Front bib woven shell | 213 x 159.75, front-bib.svg | Woven polyester; no throat-bearing or lifting approval | T01
SG05 | 1 | Front bib mesh liner | Same front-bib outline | Polyester spacer mesh | T01
SG06 | 1 | Front bib pad | Same front-bib outline | Closed-cell foam nominal 5 mm | T01
SG07 | 1 | Chest girth band | 1335 | 25.4 mm polyester load webbing, cut includes 120 lap and 150 adjustment tail. Finished loop centerline circumference 1065 | T01
SG08-1 | 1 | rear-tail--1--1 | 372 | 25.4 mm polyester webbing. Straight geometric run plus 120 mm sewing lap; adjustable tails add 150 mm. Sewn routing and overlap require coupon review | T01
SG08-2 | 1 | rear-tail--1-1 | 379 | 25.4 mm polyester webbing. Straight geometric run plus 120 mm sewing lap; adjustable tails add 150 mm. Sewn routing and overlap require coupon review | T01
SG08-3 | 1 | front-tether--1 | 403 | 25.4 mm polyester webbing. Straight geometric run plus 120 mm sewing lap; adjustable tails add 150 mm. Sewn routing and overlap require coupon review | T01
SG08-4 | 1 | corner-keeper-long--1 | 310 | 25.4 mm polyester webbing. Straight geometric run plus 120 mm sewing lap; adjustable tails add 150 mm. Sewn routing and overlap require coupon review | T01
SG08-5 | 1 | corner-keeper-cross--1 | 215 | 25.4 mm polyester webbing. Straight geometric run plus 120 mm sewing lap; adjustable tails add 150 mm. Sewn routing and overlap require coupon review | T01
SG08-6 | 1 | shoulder--1 | 221 | 25.4 mm polyester webbing. Straight geometric run plus 120 mm sewing lap; adjustable tails add 150 mm. Sewn routing and overlap require coupon review | T01
SG08-7 | 1 | rear-tail-1--1 | 372 | 25.4 mm polyester webbing. Straight geometric run plus 120 mm sewing lap; adjustable tails add 150 mm. Sewn routing and overlap require coupon review | T01
SG08-8 | 1 | rear-tail-1-1 | 379 | 25.4 mm polyester webbing. Straight geometric run plus 120 mm sewing lap; adjustable tails add 150 mm. Sewn routing and overlap require coupon review | T01
SG08-9 | 1 | front-tether-1 | 403 | 25.4 mm polyester webbing. Straight geometric run plus 120 mm sewing lap; adjustable tails add 150 mm. Sewn routing and overlap require coupon review | T01
SG08-10 | 1 | corner-keeper-long-1 | 310 | 25.4 mm polyester webbing. Straight geometric run plus 120 mm sewing lap; adjustable tails add 150 mm. Sewn routing and overlap require coupon review | T01
SG08-11 | 1 | corner-keeper-cross-1 | 215 | 25.4 mm polyester webbing. Straight geometric run plus 120 mm sewing lap; adjustable tails add 150 mm. Sewn routing and overlap require coupon review | T01
SG08-12 | 1 | shoulder-1 | 221 | 25.4 mm polyester webbing. Straight geometric run plus 120 mm sewing lap; adjustable tails add 150 mm. Sewn routing and overlap require coupon review | T01
SG08-13 | 1 | rear-web-long--1 | 309 | 25.4 mm polyester webbing. Straight geometric run plus 120 mm sewing lap; adjustable tails add 150 mm. Sewn routing and overlap require coupon review | T01
SG08-14 | 1 | rear-web-cross-rear--1 | 262 | 25.4 mm polyester webbing. Straight geometric run plus 120 mm sewing lap; adjustable tails add 150 mm. Sewn routing and overlap require coupon review | T01
SG08-15 | 1 | rear-web-long-1 | 309 | 25.4 mm polyester webbing. Straight geometric run plus 120 mm sewing lap; adjustable tails add 150 mm. Sewn routing and overlap require coupon review | T01
SG08-16 | 1 | rear-web-cross-rear-1 | 262 | 25.4 mm polyester webbing. Straight geometric run plus 120 mm sewing lap; adjustable tails add 150 mm. Sewn routing and overlap require coupon review | T01
SG08-17 | 1 | rear-web-cross-front | 439 | 25.4 mm polyester webbing. Straight geometric run plus 120 mm sewing lap; adjustable tails add 150 mm. Sewn routing and overlap require coupon review | T01
SG09-R | 4 | Side-rail wrap loops | 246 | 25.4 mm webbing; bare rail/chafe sleeve perimeter plus two 60 mm return tails | T01
SG09-B | 2 | Rear-bridge wrap loops | 264 | 25.4 mm webbing; bracket-stack/chafe sleeve perimeter plus two 60 mm return tails | T01
SG10-R | 8 | Rail chafe-sleeve panels | 146 x 55.4, chafe-rail.svg | Two panels per sleeve, 10 mm seam allowance included; four sleeves | T01
SG10-B | 4 | Bridge chafe-sleeve panels | 164 x 55.4, chafe-bridge.svg | Two panels per sleeve, 10 mm seam allowance included; two sleeves | T01
SG11 | 6 | Metal two-bar adjusters | 25.4 clear strap width, minimum 3 mm contact radius, actual drawing RFQ | Rear tails 4 plus front tethers 2. No approved SKU or slip strength. Captive sewn return/keeper mandatory | T01
SG12 | 1 | Front-only closure | 25.4 strap width | Acetal side-release buckle candidate for front restraint only. Never a rear load-bearing or lifting release | T01
SG13 | 1 | Binding and sewing thread | 8292 mm of 20 mm fold-over binding; 80 m bonded polyester Tex 90 thread planning allowance | Binding covers woven/mesh edges and ten cover-tab perimeters plus 15% handling allowance. Actual thread/machine yield and sewing qualification still required | T01
SG14 | 10 | Removable-cover closure tabs | 20 x70 mm woven rectangles, a 25 mm fixed sewing lap and 25 mm free-end patch zone. closure-tabs.svg | Six rear plus four front tabs. Non-load closure only; folded tabs close outside body-contact zones | T01
SG15 | 10 | Hook-and-loop mated patches | 20 x20 mm mated sets | Sewn to cover tabs only. Never a substitute for structural stitching or a frame anchor | T01
