stacksjs/buddy-wheels/public/guides/xl-prototype-budget.csv

Group | Item | Purchase quantity | BOM IDs | Low USD | Base USD | High USD | Evidence | Source | Notes
device | Outer aluminum tube stock | 3 m, 25 x 25 x 2 mm | M01 / M02 / M04 | 45.00 | 65.00 | 100.00 | allowance |  | 2,252.5 mm net cut length. Exact metric 6061-T6 stock, kerf and delivery need a quote. Imperial tube is not a drop-in replacement.
device | Inner aluminum tube stock | 1 m, 20 x 20 x 2 mm | M03 / M05 | 20.00 | 30.00 | 45.00 | allowance |  | 622.5 mm net cut length. Actual telescoping and corner radii must be checked.
device | External frame finish and masking | 1 small-batch finish operation |  | 35.00 | 70.00 | 140.00 | allowance |  | Candidate matte forest coating on exterior outer tubes only. Mask sliding sections, tube interiors, bores, bearing interfaces and clamped joint faces. Exact process, adhesion, corrosion behavior and quote are pending. Separate from metal cutting/deburring and finish-hole work.
device | Metal cheeks and fabrication | 16 plates: 4 fixed, 4 arm, 8 corner | M06 / M07 / M08 | 120.00 | 220.00 | 400.00 | allowance |  | 6 mm plate stock, cutting, deburring and finish-hole work. Includes outsourced tube drilling/match-fitting allowance; no drill press purchase assumed. Shop RFQ required.
device | Machined pins and axles | 10 retained pivot/stop/lock/eye pins, 2 axles | S02 / S06 / S07 / S11 / S12 / W02 | 100.00 | 200.00 | 400.00 | allowance |  | Headed shafts, finish fits and cross-holes are custom work. Drawing approval and actual quote pending.
device | Metal spacers and crush sleeves | 38 spacers and 26 sleeves | S04 / S05 / S08 / S09 / S10 / W03 / W04 / H05 / H06 / H07a / H07b | 80.00 | 150.00 | 300.00 | allowance |  | Small-quantity material and machining. These are metal compression/load-path parts, not prints.
device | Bronze pivot bushes | 4, nominal 10 ID / 14 OD / 6 long | S03 | 12.00 | 24.00 | 48.00 | allowance |  | Supplier press/running fits pending.
device | Frame fastener sets | 26 bolts, 52 washers, 26 locknuts | H01 / H02 / H03 / H04 / H08 / H09 | 25.00 | 40.00 | 65.00 | allowance |  | M6 nominal. Lengths and grades require the final joint drawing.
device | Pin washers and retainers | 12 end washers and 12 cotters | H10 / H11 | 10.00 | 18.00 | 30.00 | allowance |  | Positive retention, not friction caps. Final pin-end ligaments and cotter fit pending.
device | Wheel, tire and bearing assemblies | 2, requested 400 mm OD / 12 mm bore / 40 mm hub | W01 | 90.00 | 140.00 | 220.00 | allowance |  | RFQ only. A nominal 16-inch wheel is not automatically compatible or load rated for this rig.
device | Adjustable spring/damper assemblies | 2 matched units | S01 | 120.00 | 220.00 | 400.00 | allowance |  | 165 extended / 38 stroke / 155 installed / 8 pin / 20 eye width / 40 maximum body, all mm. No approved purchasable SKU or spring tune yet. This allowance can be exceeded.
device | Padded rear support | 1 professionally selected harness | T01 | 80.00 | 130.00 | 220.00 | allowance |  | Capacity, anatomy and attachment compatibility need fitting and supplier review.
device | Front harness and paired tethers | 1 fitted set | T02 | 35.00 | 60.00 | 100.00 | allowance |  | Supplier-rated softgoods; not a homemade printed saddle.
device | Support anchor interface reserve | 1 interface set, design unresolved |  | 30.00 | 60.00 | 120.00 | allowance |  | Additional allowance beyond the current BOM, because the harness anchor load path is not yet designed. Not an approved part or purchase instruction.
consumables | Initial PETG purchase | 1 full 1 kg spool, 1.75 mm | P-tube_cap / P-inner_cap / P-index_collar / P-pivot_guard / P-drill_jig / P-coupon / P-shock_dummy | 20.00 | 25.00 | 35.00 | allowance |  | Cash purchase, not a measured print mass. Covers service/fixture prints and some fit-check iterations only as far as the actual slicer yield allows. Metal-part plastic copies are unloaded gauges. Do not charge consumed grams again.
consumables | Printer and dryer electricity | One printing/iteration allowance |  | 1.00 | 3.00 | 8.00 | allowance |  | Unmeasured allowance. Log actual hours, kWh and utility tariff; no print time is represented as observed.
equipment | Bambu Lab P2S, printer only | 1, no AMS or laser bundle |  | 549.00 | 549.00 | 549.00 | observed-price | https://additiveplus.com/product/bambu-lab-p2s/ | Seller lists printer-only at $549. Verify configuration, current stock, freight and checkout price. The 256 mm bed accommodates the current nominal 220 mm part envelope; check brim and exclusions.
equipment | Filament dryer | 1 single-spool dryer |  | 40.00 | 60.00 | 90.00 | allowance | https://www.sunlu.com/products/filadryer-s2-filament-dryer | SUNLU S2 is a capability reference, not a verified price. Match the filament maker drying guidance.
equipment | Digital caliper for printed/metal parts | 1, 150 mm range |  | 24.99 | 24.99 | 24.99 | observed-price | https://www.harborfreight.com/6-in-digital-caliper-63711.html | Harbor Freight item 63711 regular listed price, no membership coupon assumed. Not a tool to squeeze or measure Buddy body width.
equipment | Hand tools and measuring supplies | Wrenches, clamps, deburring tools, tape, ruler, boards |  | 60.00 | 100.00 | 180.00 | allowance |  | Supplier fabricates metalwork. Borrowing an already suitable tool reduces cash outlay; calibration/torque procedure still needs approval.
equipment | Cleanup supplies and spare nozzle | 1 starter set |  | 20.00 | 35.00 | 60.00 | allowance |  | Check printer-specific consumables. No extra build plate assumed.
equipment | Dry storage and desiccant | 1 starter set |  | 15.00 | 25.00 | 40.00 | allowance |  | Reusable storage, not additional filament.
equipment | Empty-rig catch/cradle and scales | 1 bench fixture allowance | T03 | 50.00 | 100.00 | 180.00 | allowance |  | Testing equipment, not part of the wearable chair. This is not a qualified test program or calibrated lab quote.
development | Paid assembly, if used | See basis |  | 150.00 | 350.00 | 960.00 | allowance |  | 6 h x $25 / 10 h x $35 / 16 h x $60. Illustrative labor, not a quote. DIY cash scenarios exclude this line, but your time is not free economically.
development | Mechanical engineering review | See basis |  | 600.00 | 1200.00 | 2160.00 | allowance |  | 6 h x $100 / 8 h x $150 / 12 h x $180. Unquoted planning allowance, not a scope or sign-off commitment.
development | Veterinary/rehabilitation fitting | See basis |  | 150.00 | 250.00 | 450.00 | allowance |  | Unquoted visit allowance. Buddy care continues independently; treatment and ongoing care are additional.
development | Bench testing and additional specimens | See basis |  | 250.00 | 500.00 | 1000.00 | allowance |  | Unquoted development allowance beyond the reusable cradle. Actual test protocol, repetitions and failures can cost more.
summary | Shipping | Not another purchase line; do not sum summary rows again |  | 60.00 | 120.00 | 240.00 | calculated |  | See documented reserve bases and scenario definitions.
summary | Tax reserve | Not another purchase line; do not sum summary rows again |  | 154.15 | 228.73 | 365.33 | calculated |  | See documented reserve bases and scenario definitions.
summary | Contingency | Not another purchase line; do not sum summary rows again |  | 176.40 | 314.40 | 572.60 | calculated |  | See documented reserve bases and scenario definitions.
summary | DIY cash total | Not another purchase line; do not sum summary rows again |  | 1972.54 | 3012.12 | 4932.92 | calculated |  | See documented reserve bases and scenario definitions.
summary | Development budget total | Not another purchase line; do not sum summary rows again |  | 3122.54 | 5312.12 | 9502.92 | calculated |  | See documented reserve bases and scenario definitions.
