stacksjs/buddy-wheels/designs/wheelchair/iterations/buddy-xl-estimate/tube-drilling.csv

Part | Quantity | Axis / datum | Hole centers mm | Tube hole diameter mm | Notes
Side rail | 2 | X from front cut end; drill along Y | 540 / 570 | 8.2 | Side corner pair
Side rail | 2 | X from front cut end; drill along Z | 600 / 630 | 8.2 | Rear bridge corner pair
Lower upright | 2 | Z from lower cut end; drill along Y | 10 / 40 | 8.2 | Fixed suspension cheek attachment
Lower upright | 2 | Z from lower cut end; drill along Y | 265 / 295 | 8.2 | Height index pair, outer wall
Upper upright | 2 | Z from lower cut end; drill along Y | 132.5 / 162.5 | 8.2 | Upper frame corner pair, with cheek spacers
Upper upright | 2 | Z from lower cut end; drill along Y | 62.5 / 92.5 | 8.2 | Match-drill nominal telescoping pair after centering, no extra adjustment rows in r0
Bridge outer and inner | 1 | Y from each bridge outboard cut end toward center; drill along Z | 17.5 / 47.5 | 8.2 | End corner attachment pair, both ends
Bridge outer and inner | 1 | Y from each outboard end toward center; drill along Z | 172.5 / 202.5 | 8.2 | Match-drill both nested tubes at nominal width
