stacksjs/buddy-wheels/designs/wheelchair/r0/M/tube-drilling.csv

Part | Quantity | Axis / datum | Hole centers mm | Tube hole diameter mm | Notes
Side rail | 2 | X from front cut end; drill along Y | 320 / 350 | 7.2 | Side corner pair
Side rail | 2 | X from front cut end; drill along Z | 380 / 410 | 7.2 | Rear bridge corner pair
Lower upright | 2 | Z from lower cut end; drill along Y | 10 / 40 | 7.2 | Fixed suspension cheek attachment
Lower upright | 2 | Z from lower cut end; drill along Y | 75 / 105 | 7.2 | Height index pair, outer wall
Upper upright | 2 | Z from lower cut end; drill along Y | 101 / 131 | 7.2 | Upper frame corner pair, with cheek spacers
Upper upright | 2 | Z from lower cut end; drill along Y | 31 / 61 | 7.2 | Match-drill nominal telescoping pair after centering, no extra adjustment rows in r0
Bridge outer and inner | 1 | Y from each bridge outboard cut end toward center; drill along Z | 19 / 49 | 7.2 | End corner attachment pair, both ends
Bridge outer and inner | 1 | Y from each outboard end toward center; drill along Z | 114 / 144 | 7.2 | Match-drill both nested tubes at nominal width
