stacksjs/buddy-wheels/designs/wheelchair/r0/S/tube-drilling.csv

Part | Quantity | Axis / datum | Hole centers mm | Tube hole diameter mm | Notes
Side rail | 2 | X from front cut end; drill along Y | 220 / 240 | 6.2 | Side corner pair
Side rail | 2 | X from front cut end; drill along Z | 280 / 300 | 6.2 | Rear bridge corner pair
Lower upright | 2 | Z from lower cut end; drill along Y | 10 / 40 | 6.2 | Fixed suspension cheek attachment
Lower upright | 2 | Z from lower cut end; drill along Y | 35 / 55 | 6.2 | Height index pair, outer wall
Upper upright | 2 | Z from lower cut end; drill along Y | 90 / 110 | 6.2 | Upper frame corner pair, with cheek spacers
Upper upright | 2 | Z from lower cut end; drill along Y | 30 / 50 | 6.2 | Match-drill nominal telescoping pair after centering, no extra adjustment rows in r0
Bridge outer and inner | 1 | Y from each bridge outboard cut end toward center; drill along Z | 10 / 30 | 6.2 | End corner attachment pair, both ends
Bridge outer and inner | 1 | Y from each outboard end toward center; drill along Z | 85 / 105 | 6.2 | Match-drill both nested tubes at nominal width
