stacksjs/buddy-wheels/designs/rover/r0/metal/shock_hanger.dxf

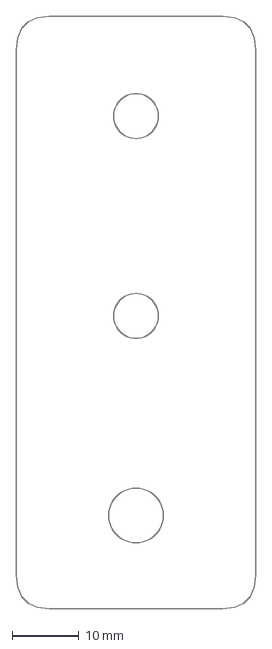
[picture p6: CAD file, 2026-11-12]
designs/rover/r0/metal/shock_hanger.dxf
36.0 x 89.0 mm
