stacksjs/buddy-wheels/designs/rover/r0/parts/FIT_CHECK_ONLY_shock_hanger.stl

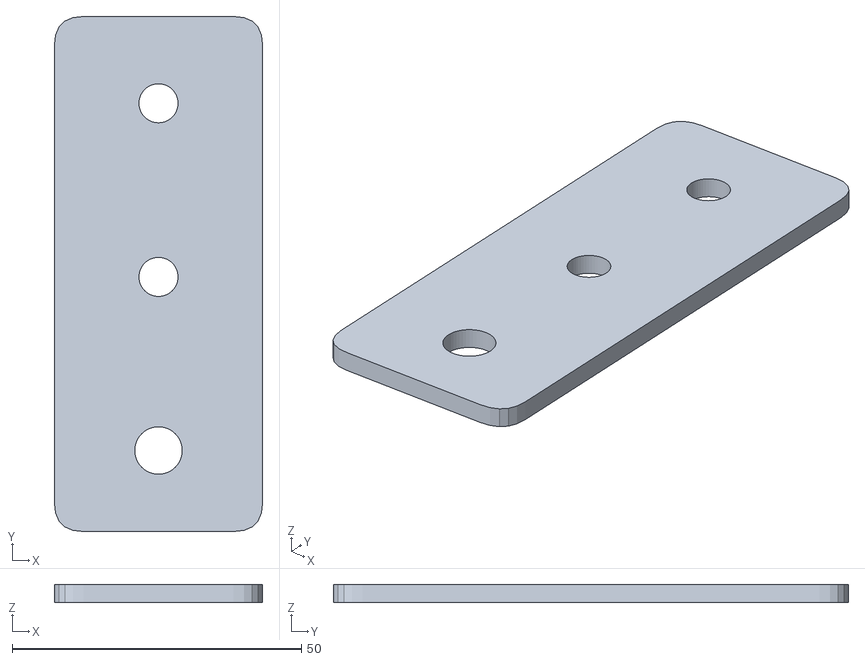
[picture p7: CAD file, 2026-11-12]
designs/rover/r0/parts/FIT_CHECK_ONLY_shock_hanger.stl
36.0 x 89.0 x 3.17
