stacksjs/buddy-wheels/designs/rover/r0/tubes/6063-T52-0.062-wall/C12-x2-handle-arm.step

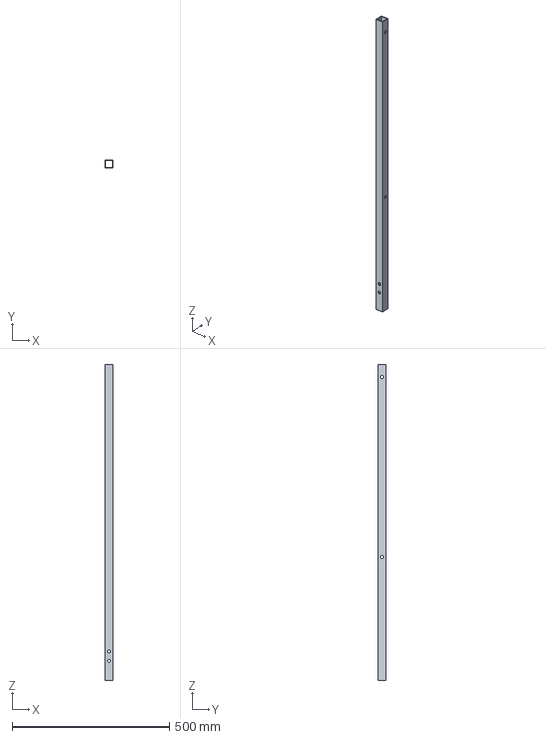
[picture p8: CAD file, 2026-11-12]
designs/rover/r0/tubes/6063-T52-0.062-wall/C12-x2-handle-arm.step
25.4 x 25.4 x 1005.4 mm
