stacksjs/buddy-wheels/designs/rover/r0/tubes/C14-base-intermediate-cross-member.step

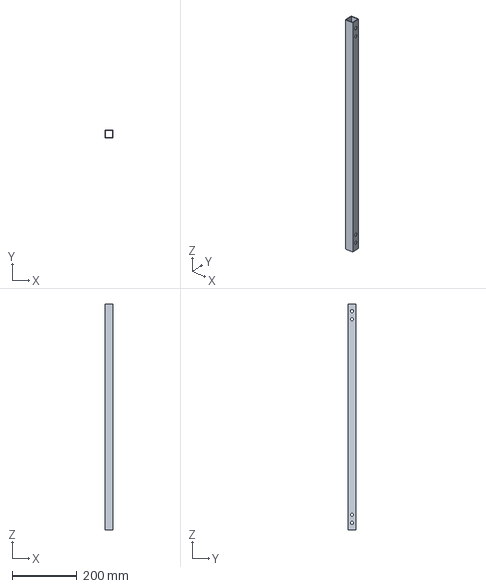
[picture p9: CAD file, 2026-11-12]
designs/rover/r0/tubes/C14-base-intermediate-cross-member.step
25.4 x 25.4 x 700.0 mm
