stacksjs/buddy-wheels/designs/softgoods/r1/L-r0/softgoods/front-bib.dxf

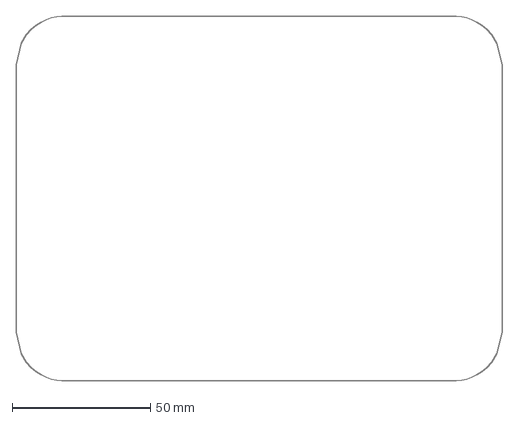
[picture p10: CAD file, 2026-11-09]
designs/softgoods/r1/L-r0/softgoods/front-bib.dxf
176.0 x 132.0 mm
