stacksjs/buddy-wheels/designs/softgoods/r1/M-r0/softgoods/front-bib.dxf

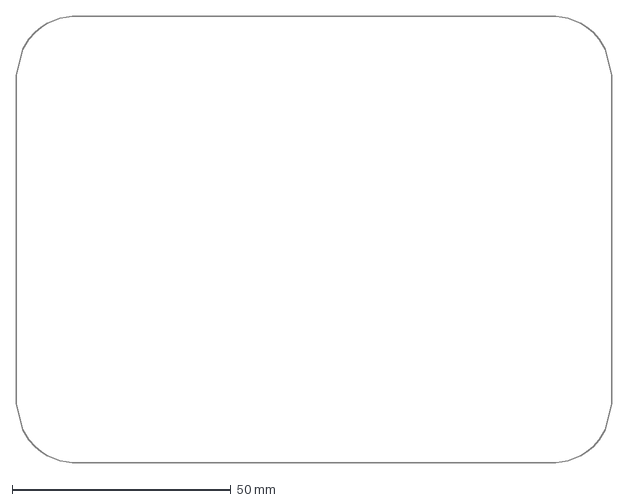
[picture p11: CAD file, 2026-11-09]
designs/softgoods/r1/M-r0/softgoods/front-bib.dxf
136.0 x 102.0 mm
