stacksjs/buddy-wheels/designs/softgoods/r1/S-r0/softgoods/TEXTILE_REFERENCE_ONLY_front_mesh.stl

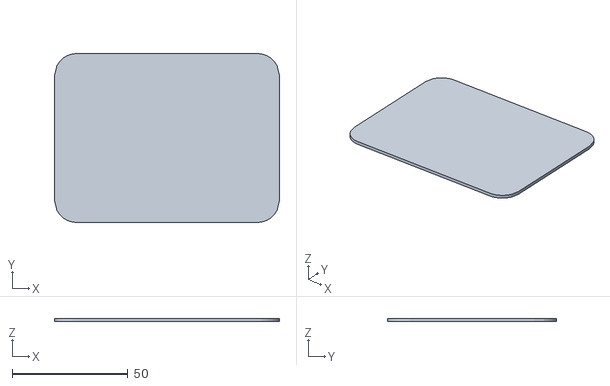
[picture p12: CAD file, 2026-11-09]
designs/softgoods/r1/S-r0/softgoods/TEXTILE_REFERENCE_ONLY_front_mesh.stl
97.0 x 72.8 x 1.50
