stacksjs/buddy-wheels/designs/softgoods/r1/XL-r0/softgoods/TEXTILE_REFERENCE_ONLY_rear_mesh.stl

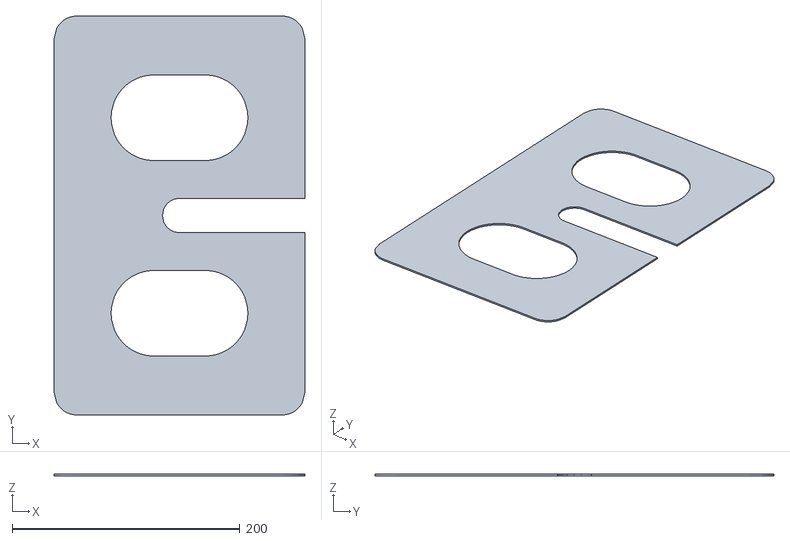
[picture p13: CAD file, 2026-11-09]
designs/softgoods/r1/XL-r0/softgoods/TEXTILE_REFERENCE_ONLY_rear_mesh.stl
220.0 x 350.0 x 1.50
