stacksjs/buddy-wheels/designs/softgoods/r1/XL-r2/softgoods/TEXTILE_REFERENCE_ONLY_front_pad.stl

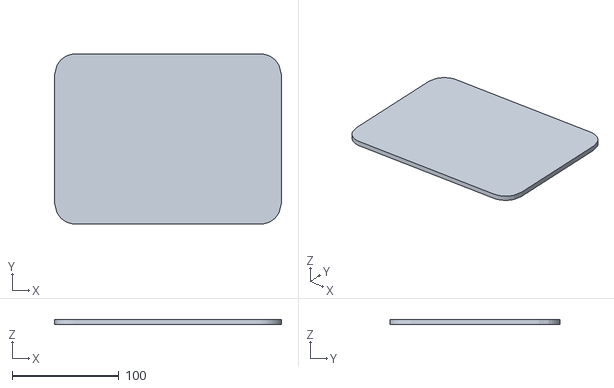
[picture p14: CAD file, 2026-11-09]
designs/softgoods/r1/XL-r2/softgoods/TEXTILE_REFERENCE_ONLY_front_pad.stl
213.0 x 159.8 x 5.00
