stacksjs/buddy-wheels/designs/softgoods/r1/XS-r0/softgoods/front-bib.dxf

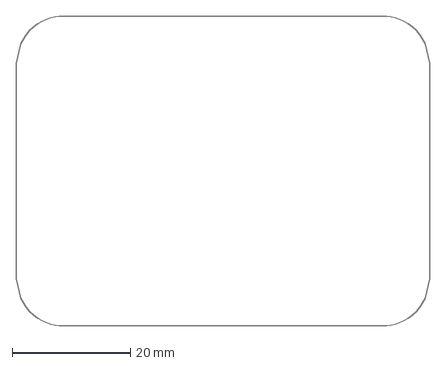
[picture p15: CAD file, 2026-11-09]
designs/softgoods/r1/XS-r0/softgoods/front-bib.dxf
70.0 x 52.5 mm
