stacksjs/buddy-wheels/designs/wheelchair/iterations/buddy-xl-estimate/stl/inner_cap.stl

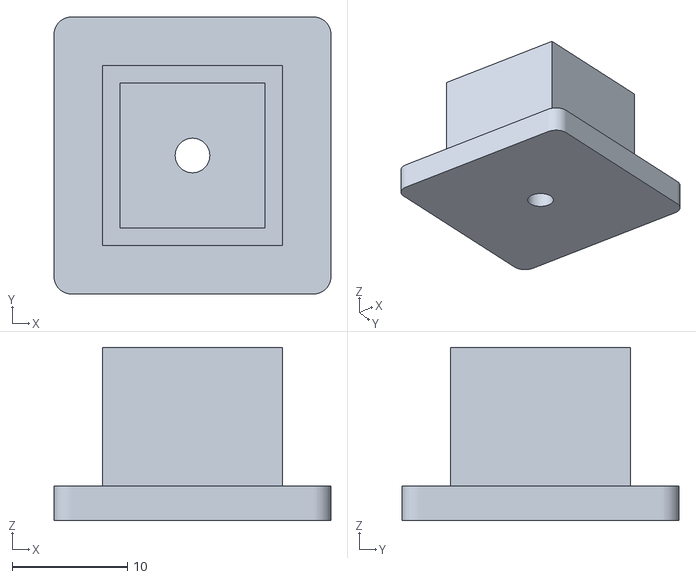
[picture p16: CAD file, 2026-11-08]
designs/wheelchair/iterations/buddy-xl-estimate/stl/inner_cap.stl
24.0 x 24.0 x 15.0
