stacksjs/buddy-wheels/designs/wheelchair/r0/L/stl/tube_cap.stl

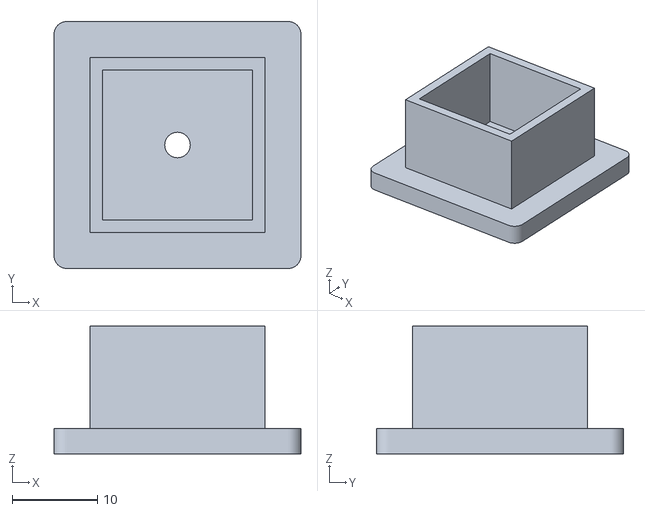
[picture p17: CAD file, 2026-11-08]
designs/wheelchair/r0/L/stl/tube_cap.stl
29.0 x 29.0 x 15.0
