stacksjs/buddy-wheels/designs/wheelchair/r0/M/stl/drill_jig.stl

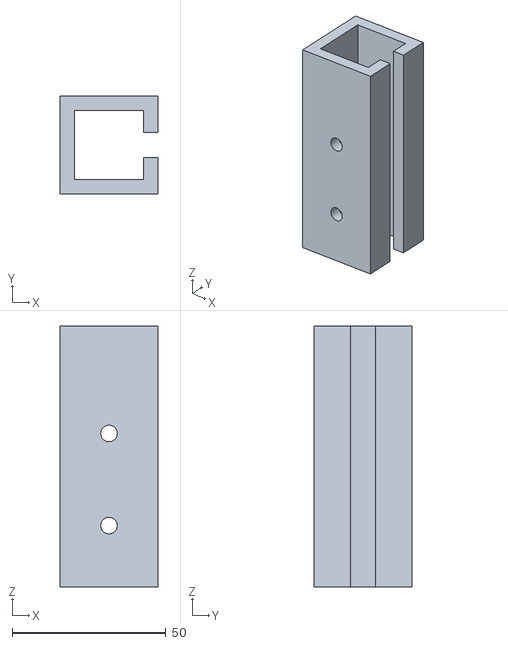
[picture p18: CAD file, 2026-11-08]
designs/wheelchair/r0/M/stl/drill_jig.stl
32.0 x 32.0 x 85.0
