stacksjs/buddy-wheels/designs/wheelchair/r0/S/stl/coupon.stl

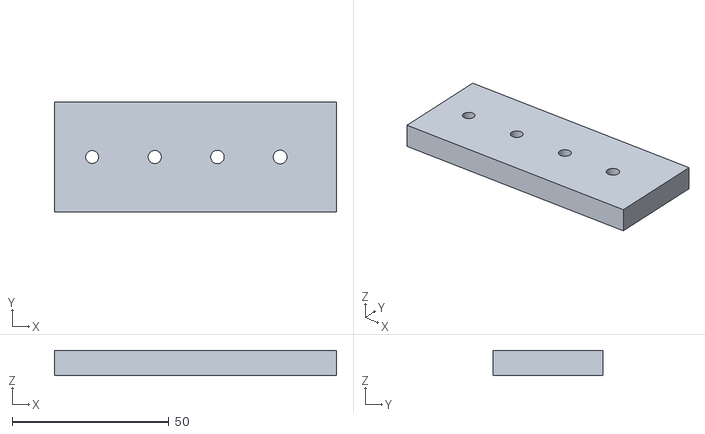
[picture p19: CAD file, 2026-11-08]
designs/wheelchair/r0/S/stl/coupon.stl
90.0 x 35.0 x 8.00
