stacksjs/buddy-wheels/designs/wheelchair/r0/XS/stl/drill_jig.stl

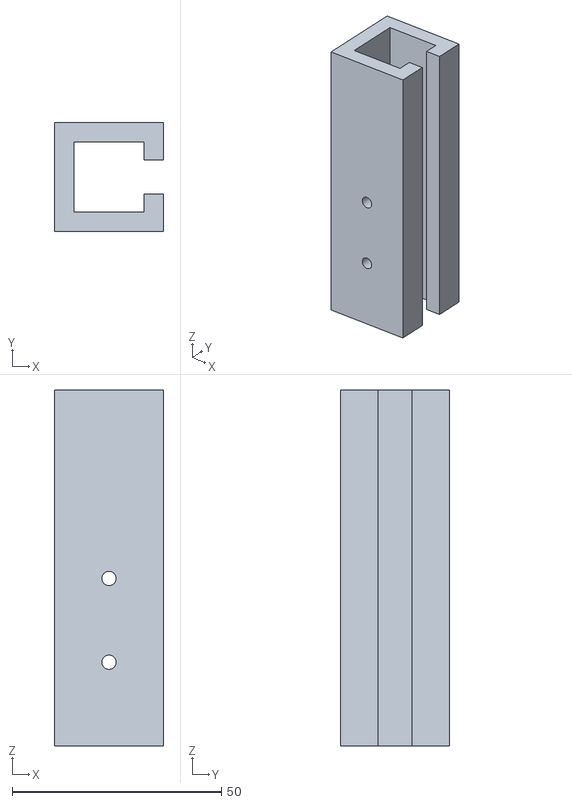
[picture p20: CAD file, 2026-11-08]
designs/wheelchair/r0/XS/stl/drill_jig.stl
26.0 x 26.0 x 85.0
