stacksjs/buddy-wheels/designs/wheelchair/r1/XL/parts/drill_guide.stl

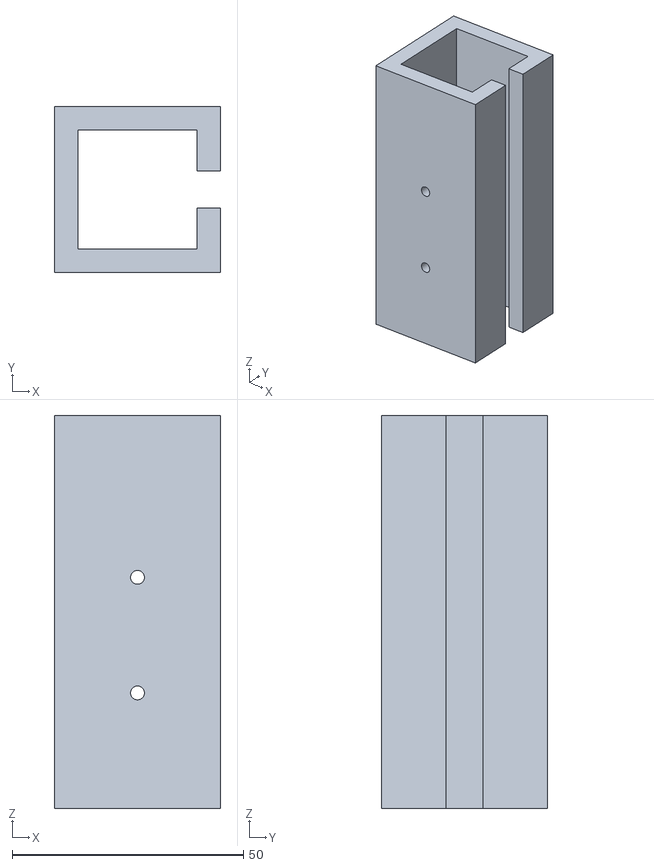
[picture p21: CAD file, 2026-11-09]
designs/wheelchair/r1/XL/parts/drill_guide.stl
36.0 x 36.0 x 85.0
