stacksjs/buddy-wheels/designs/wheelchair/r2/XL/metal/rail_shim.dxf

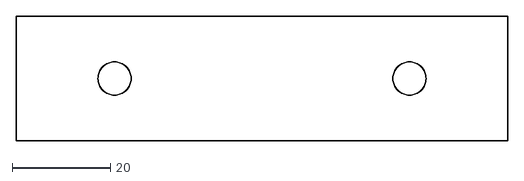
[picture p22: CAD file, 2026-11-08]
designs/wheelchair/r2/XL/metal/rail_shim.dxf
100.0 x 25.4
