stacksjs/buddy-wheels/designs/wheelchair/r2/XL/parts/coupon.stl

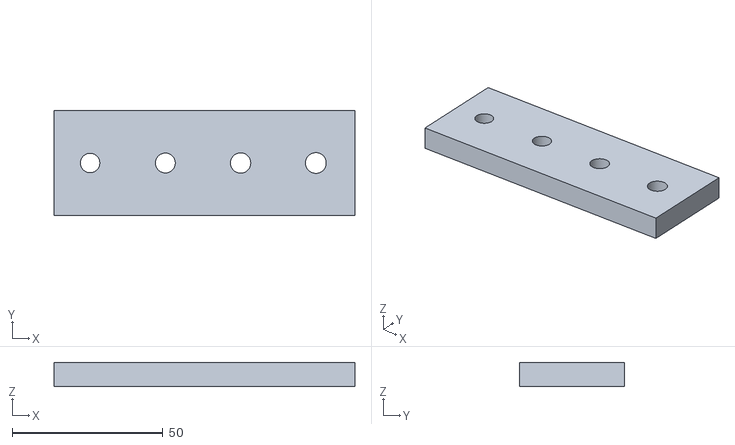
[picture p23: CAD file, 2026-11-09]
designs/wheelchair/r2/XL/parts/coupon.stl
100.0 x 35.0 x 8.00
