stacksjs/buddy-wheels/public/designs/l/r0/metal/fixed_plate.dxf

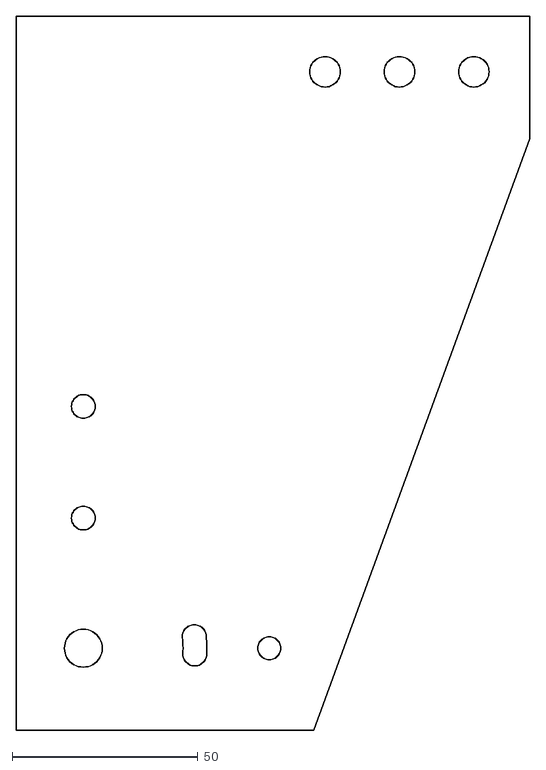
[picture p24: CAD file, 2026-11-08]
public/designs/l/r0/metal/fixed_plate.dxf
138.0 x 192.0
