stacksjs/buddy-wheels/public/designs/l/r0/parts/index_collar.stl

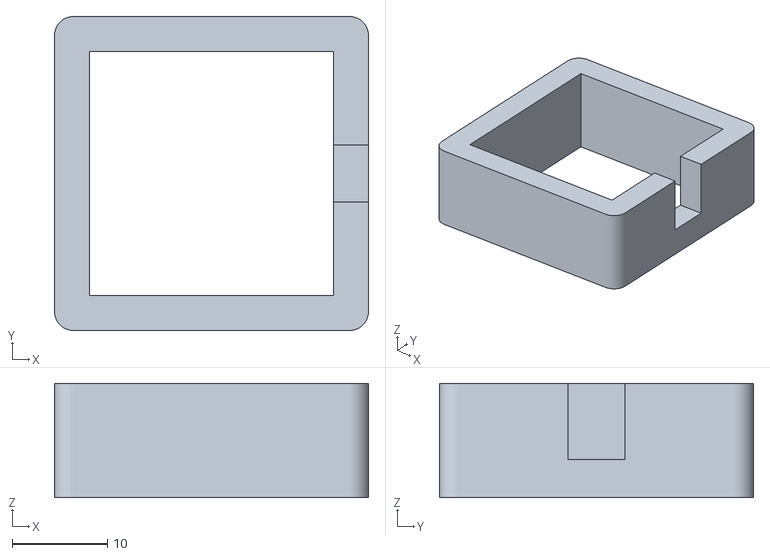
[picture p25: CAD file, 2026-11-08]
public/designs/l/r0/parts/index_collar.stl
33.0 x 33.0 x 12.0
