stacksjs/buddy-wheels/public/designs/m/r0/metal/corner_plate.dxf

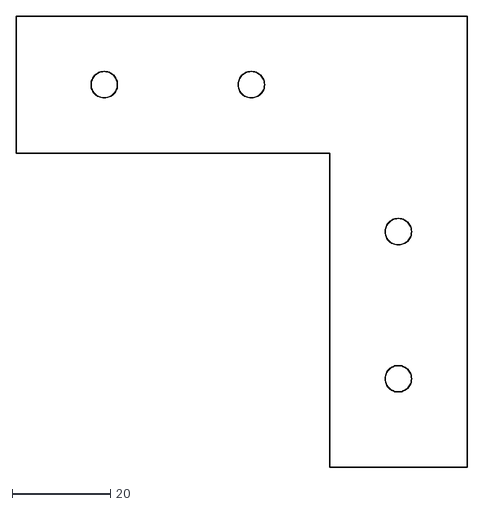
[picture p26: CAD file, 2026-11-08]
public/designs/m/r0/metal/corner_plate.dxf
92.0 x 92.0
