stacksjs/buddy-wheels/public/designs/m/r0/parts/index_collar.stl

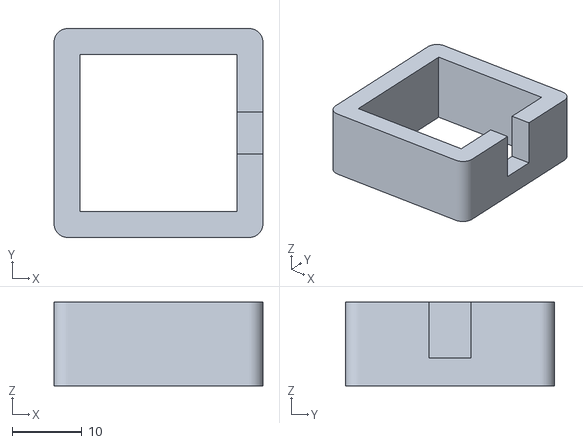
[picture p27: CAD file, 2026-11-08]
public/designs/m/r0/parts/index_collar.stl
30.0 x 30.0 x 12.0
