stacksjs/buddy-wheels/public/designs/rover/r0/metal/shock_plate.dxf

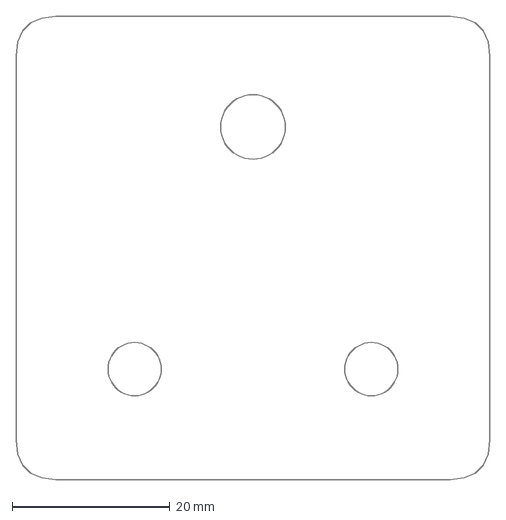
[picture p28: CAD file, 2026-11-12]
public/designs/rover/r0/metal/shock_plate.dxf
60.0 x 58.7 mm
