stacksjs/buddy-wheels/public/designs/rover/r0/parts/FIT_CHECK_ONLY_shock_plate.stl

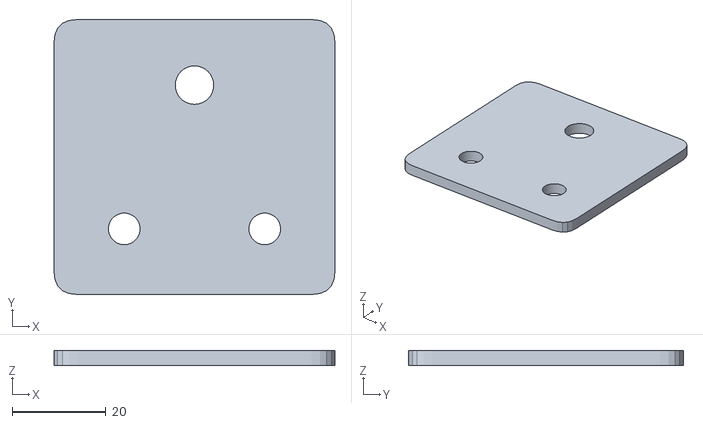
[picture p29: CAD file, 2026-11-12]
public/designs/rover/r0/parts/FIT_CHECK_ONLY_shock_plate.stl
60.0 x 58.7 x 3.17
