stacksjs/buddy-wheels/public/designs/s/r0/metal/corner_plate.dxf

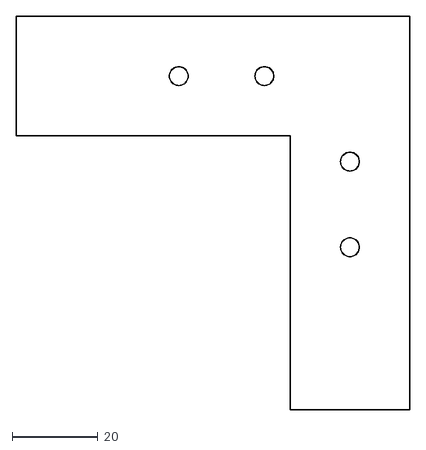
[picture p30: CAD file, 2026-11-08]
public/designs/s/r0/metal/corner_plate.dxf
92.0 x 92.0
