stacksjs/buddy-wheels/public/designs/s/r0/parts/index_collar.stl

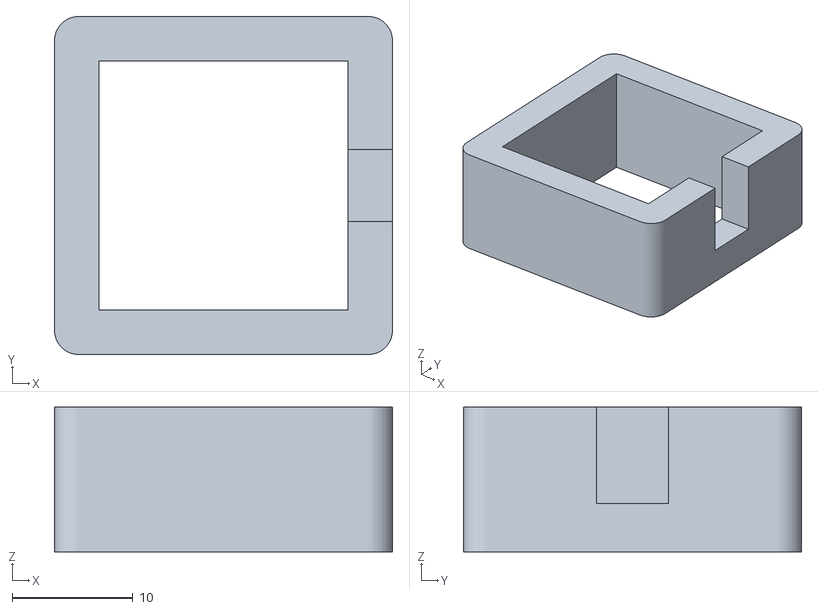
[picture p31: CAD file, 2026-11-08]
public/designs/s/r0/parts/index_collar.stl
28.0 x 28.0 x 12.0
