stacksjs/buddy-wheels/public/designs/xl/r0/parts/drill_jig.stl

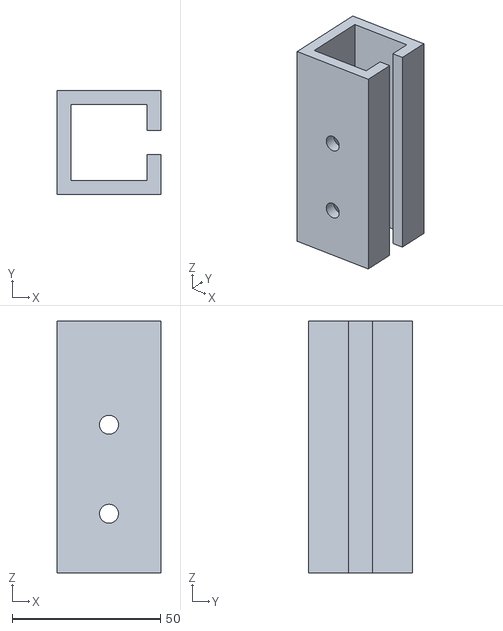
[picture p32: CAD file, 2026-11-08]
public/designs/xl/r0/parts/drill_jig.stl
35.0 x 35.0 x 85.0
