stacksjs/buddy-wheels/public/designs/xl/r2/metal/spring_seat.dxf

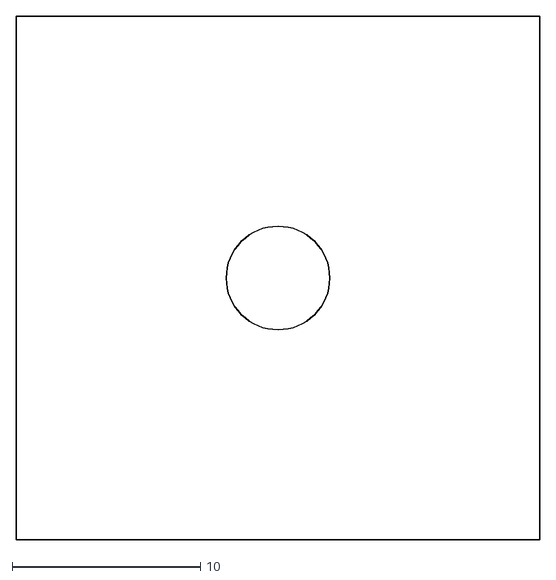
[picture p33: CAD file, 2026-11-08]
public/designs/xl/r2/metal/spring_seat.dxf
27.8 x 27.8
