stacksjs/buddy-wheels/public/designs/xs/r0/metal/arm_plate.dxf

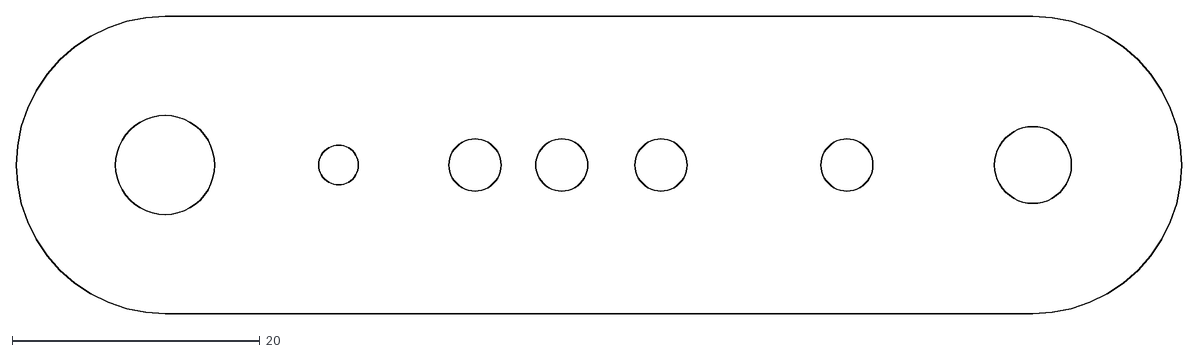
[picture p34: CAD file, 2026-11-08]
public/designs/xs/r0/metal/arm_plate.dxf
94.0 x 24.0
