stacksjs/buddy-wheels/public/designs/xs/r0/parts/tube_cap.stl

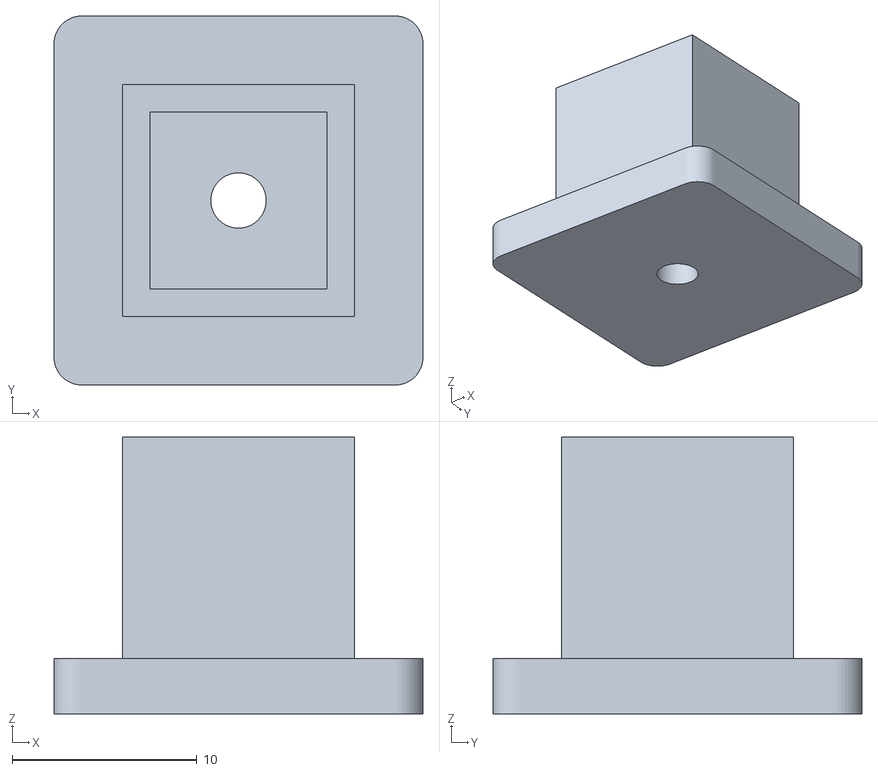
[picture p35: CAD file, 2026-11-08]
public/designs/xs/r0/parts/tube_cap.stl
20.0 x 20.0 x 15.0
