stacksjs/buddy-wheels/designs/softgoods/r1/L-r0/softgoods/TEXTILE_REFERENCE_ONLY_front_pad.stl

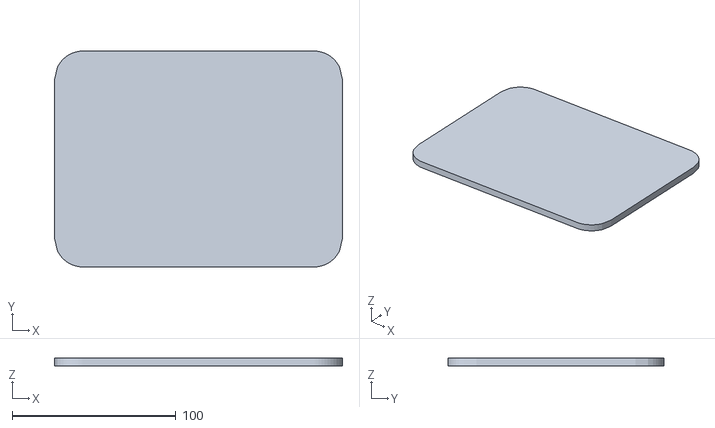
[picture p36: CAD file, 2026-11-09]
designs/softgoods/r1/L-r0/softgoods/TEXTILE_REFERENCE_ONLY_front_pad.stl
176.0 x 132.0 x 5.00
