stacksjs/buddy-wheels/designs/softgoods/r1/S-r0/softgoods/saddle-shell.dxf

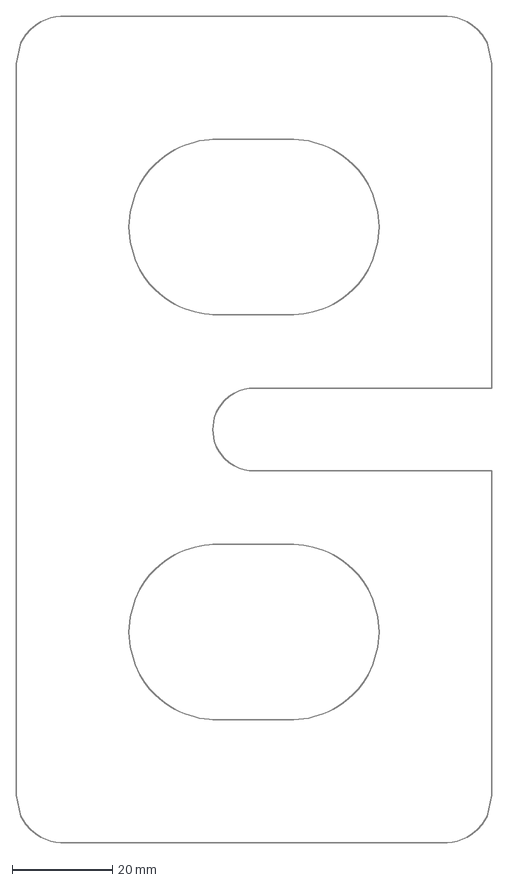
[picture p38: CAD file, 2026-11-09]
designs/softgoods/r1/S-r0/softgoods/saddle-shell.dxf
95.0 x 165.0 mm
