stacksjs/buddy-wheels/designs/softgoods/r1/XL-r1/softgoods/TEXTILE_REFERENCE_ONLY_rear_shell.stl

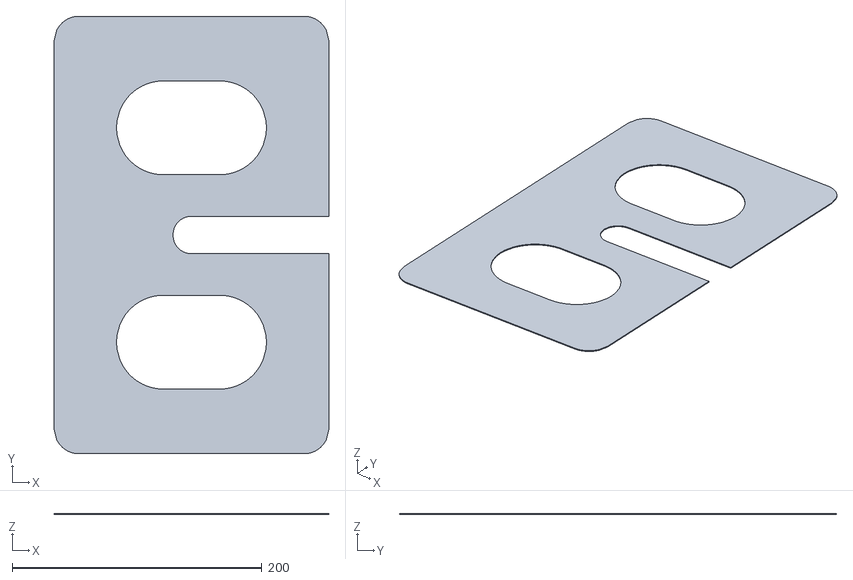
[picture p39: CAD file, 2026-11-09]
designs/softgoods/r1/XL-r1/softgoods/TEXTILE_REFERENCE_ONLY_rear_shell.stl
220.0 x 350.0 x 0.8
