stacksjs/buddy-wheels/designs/softgoods/r1/XL-r2/softgoods/TEXTILE_REFERENCE_ONLY_rear_pad.stl

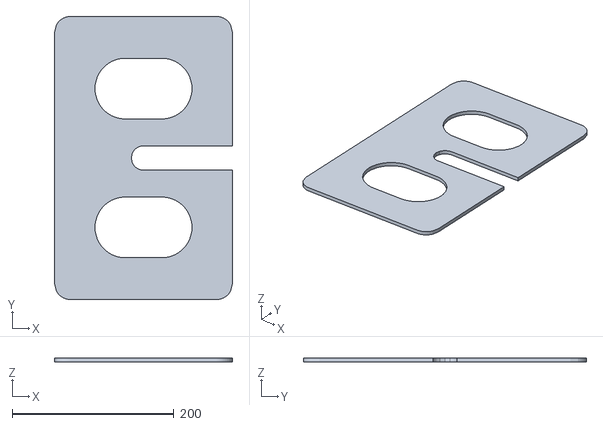
[picture p40: CAD file, 2026-11-09]
designs/softgoods/r1/XL-r2/softgoods/TEXTILE_REFERENCE_ONLY_rear_pad.stl
220.0 x 350.0 x 5.00
