stacksjs/buddy-wheels/designs/softgoods/r1/XS-r0/softgoods/TEXTILE_REFERENCE_ONLY_front_shell.stl

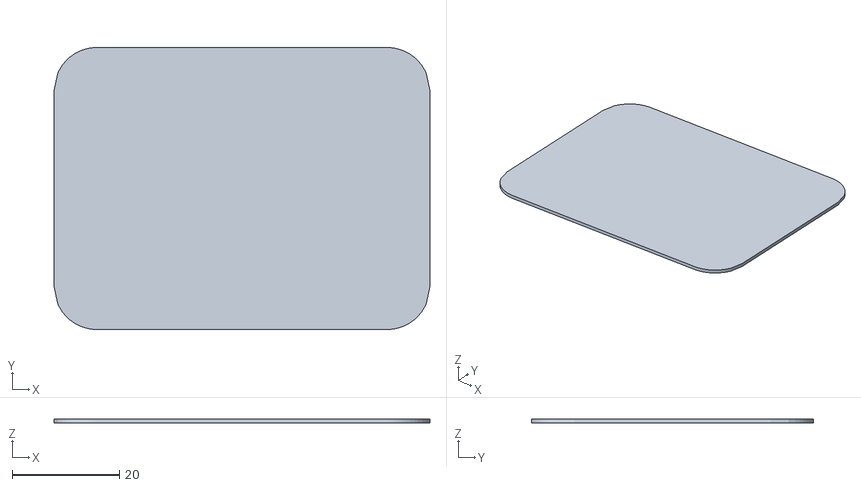
[picture p41: CAD file, 2026-11-09]
designs/softgoods/r1/XS-r0/softgoods/TEXTILE_REFERENCE_ONLY_front_shell.stl
70.0 x 52.5 x 0.8
