stacksjs/buddy-wheels/designs/wheelchair/r0/L/stl/coupon.stl

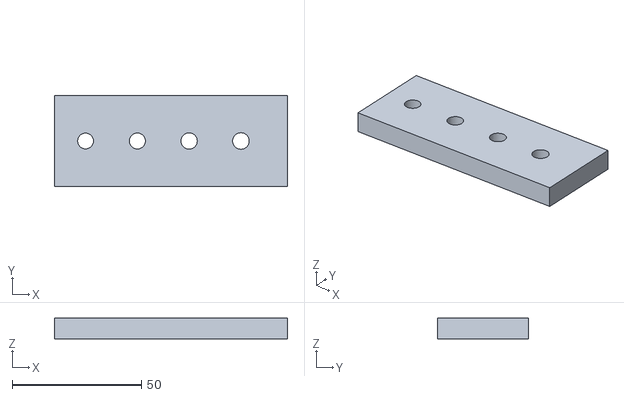
[picture p42: CAD file, 2026-11-08]
designs/wheelchair/r0/L/stl/coupon.stl
90.0 x 35.0 x 8.00
