stacksjs/buddy-wheels/designs/wheelchair/r0/S/stl/drill_jig.stl

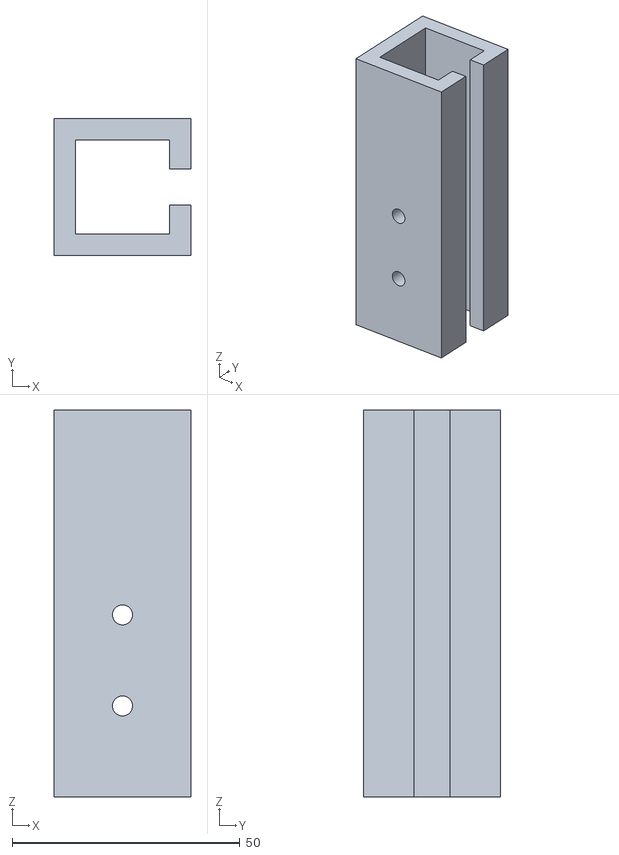
[picture p43: CAD file, 2026-11-08]
designs/wheelchair/r0/S/stl/drill_jig.stl
30.0 x 30.0 x 85.0
