stacksjs/buddy-wheels/designs/wheelchair/r1/XL/parts/axle_cover.stl

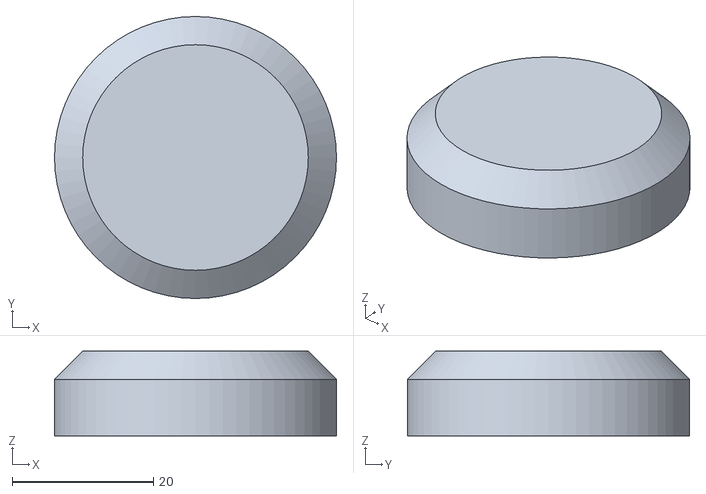
[picture p44: CAD file, 2026-11-09]
designs/wheelchair/r1/XL/parts/axle_cover.stl
40.0 x 40.0 x 12.0
