stacksjs/buddy-wheels/public/designs/l/r0/metal/arm_plate.dxf

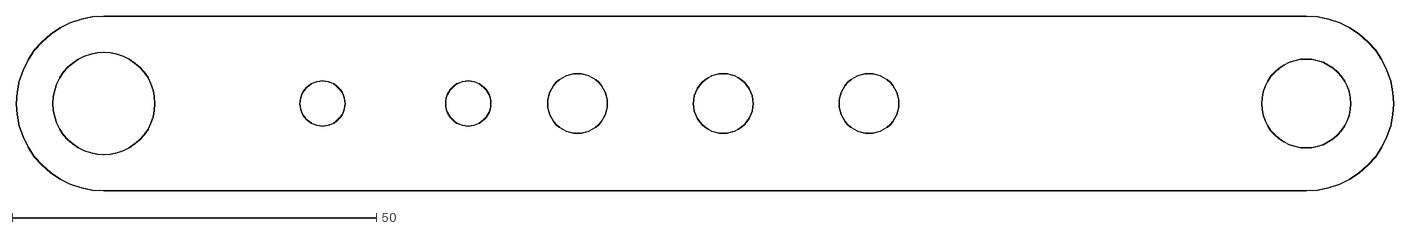
[picture p45: CAD file, 2026-11-08]
public/designs/l/r0/metal/arm_plate.dxf
189.0 x 24.0
