stacksjs/buddy-wheels/public/designs/m/r0/metal/fixed_plate.dxf

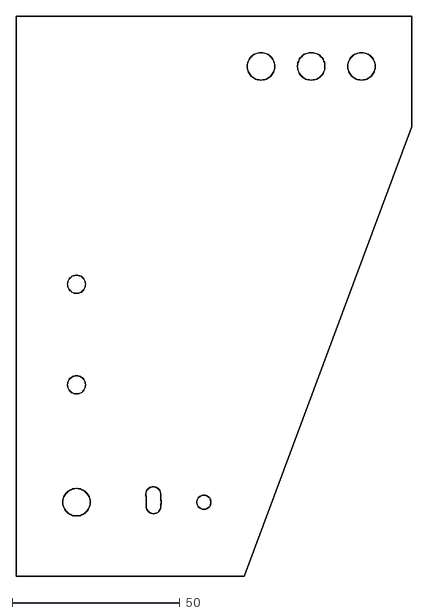
[picture p46: CAD file, 2026-11-08]
public/designs/m/r0/metal/fixed_plate.dxf
118.0 x 167.0
