stacksjs/buddy-wheels/public/designs/m/r0/parts/tube_cap.stl

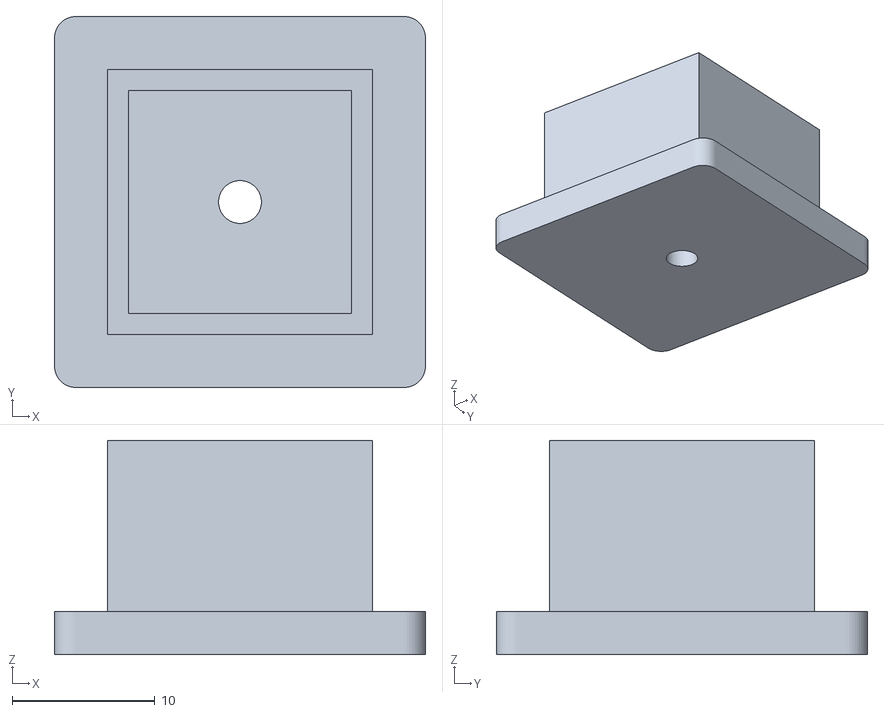
[picture p47: CAD file, 2026-11-08]
public/designs/m/r0/parts/tube_cap.stl
26.0 x 26.0 x 15.0
