stacksjs/buddy-wheels/public/designs/s/r0/metal/arm_plate.dxf

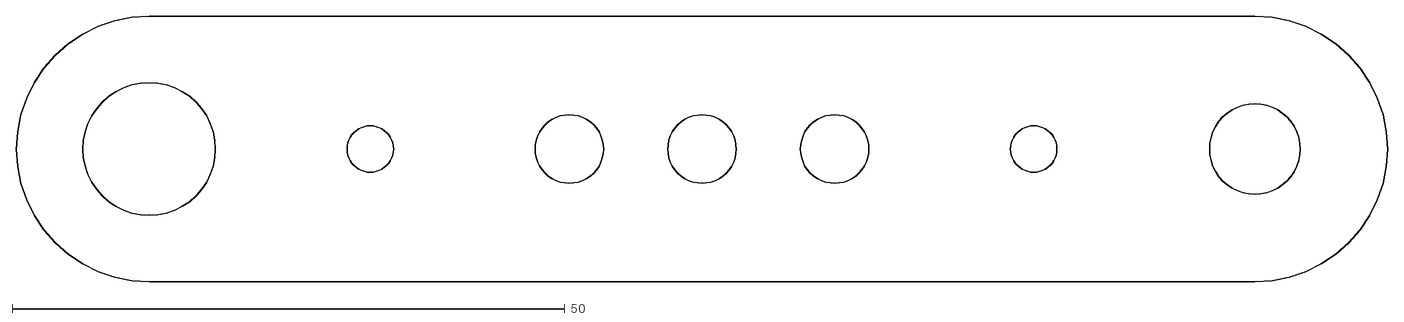
[picture p48: CAD file, 2026-11-08]
public/designs/s/r0/metal/arm_plate.dxf
124.0 x 24.0
