stacksjs/buddy-wheels/public/designs/s/r0/parts/tube_cap.stl

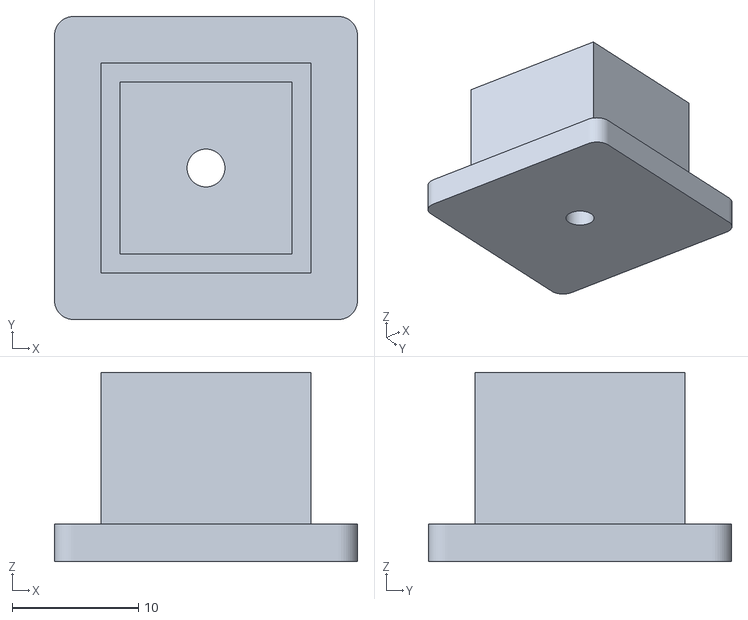
[picture p49: CAD file, 2026-11-08]
public/designs/s/r0/parts/tube_cap.stl
24.0 x 24.0 x 15.0
