stacksjs/buddy-wheels/public/designs/xl/r2/parts/end_cap.stl

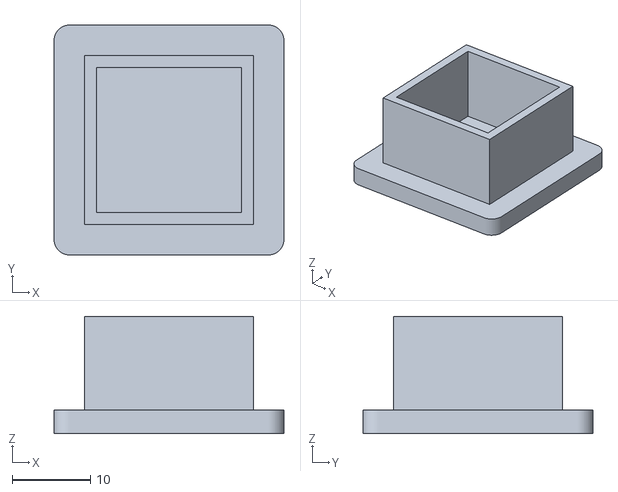
[picture p50: CAD file, 2026-11-09]
public/designs/xl/r2/parts/end_cap.stl
29.4 x 29.4 x 15.0
