stacksjs/buddy-wheels/public/designs/xs/r0/metal/fixed_plate.dxf

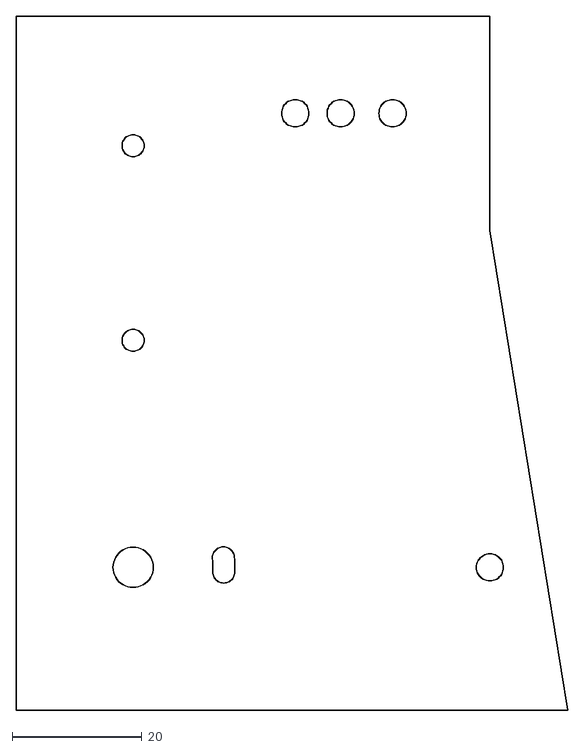
[picture p51: CAD file, 2026-11-08]
public/designs/xs/r0/metal/fixed_plate.dxf
85.0 x 107.0
