stacksjs/buddy-wheels/public/designs/xs/r0/parts/inner_cap.stl

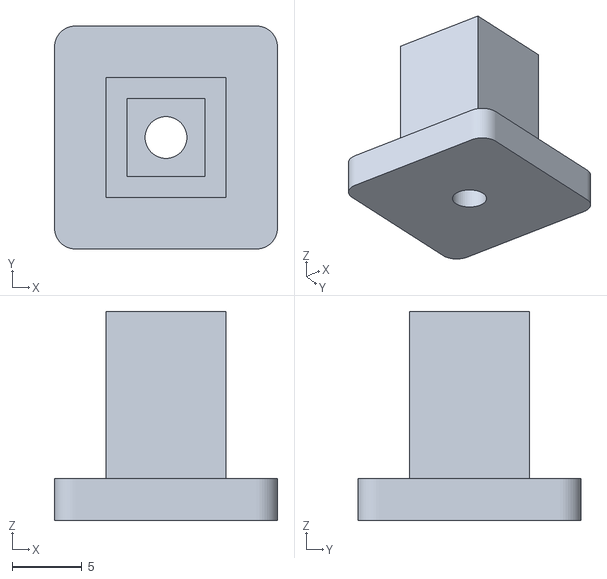
[picture p52: CAD file, 2026-11-08]
public/designs/xs/r0/parts/inner_cap.stl
16.0 x 16.0 x 15.0
