stacksjs/buddy-wheels/designs/rover/r0/metal/brake_plate.dxf

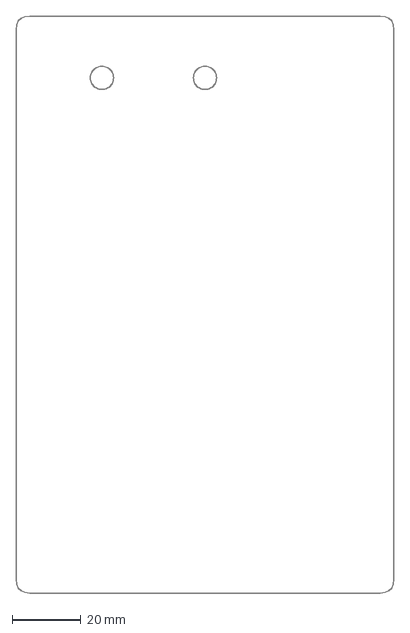
[picture p53: CAD file, 2026-11-12]
designs/rover/r0/metal/brake_plate.dxf
110.0 x 168.0 mm
