stacksjs/buddy-wheels/designs/rover/r0/parts/FIT_CHECK_ONLY_brake_plate.stl

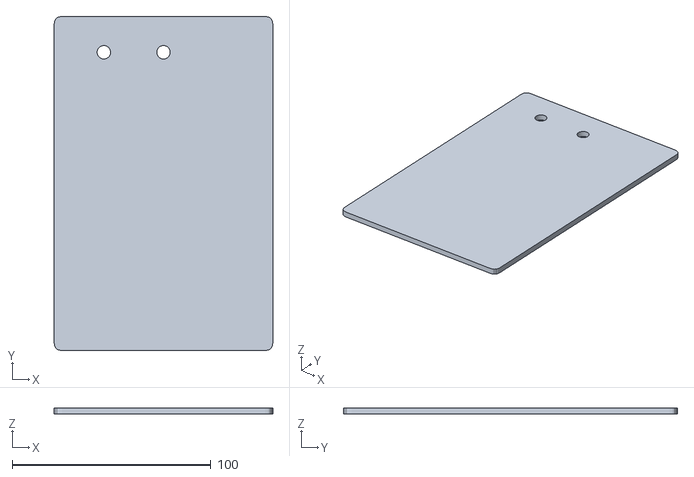
[picture p54: CAD file, 2026-11-12]
designs/rover/r0/parts/FIT_CHECK_ONLY_brake_plate.stl
110.0 x 168.0 x 3.17
