stacksjs/buddy-wheels/designs/softgoods/r1/L-r0/softgoods/TEXTILE_REFERENCE_ONLY_rear_shell.stl

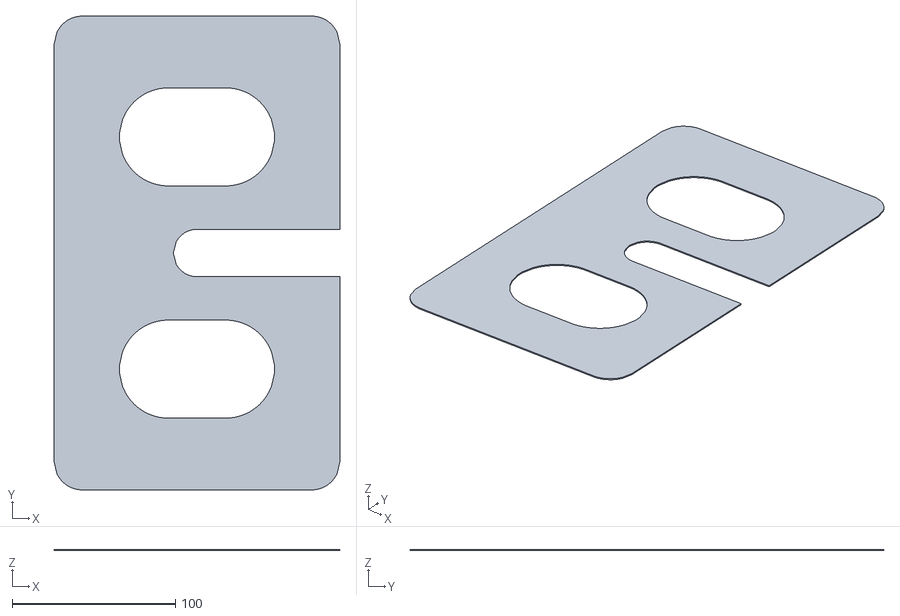
[picture p55: CAD file, 2026-11-09]
designs/softgoods/r1/L-r0/softgoods/TEXTILE_REFERENCE_ONLY_rear_shell.stl
175.0 x 290.0 x 0.8
