stacksjs/buddy-wheels/designs/softgoods/r1/M-r0/softgoods/TEXTILE_REFERENCE_ONLY_rear_pad.stl

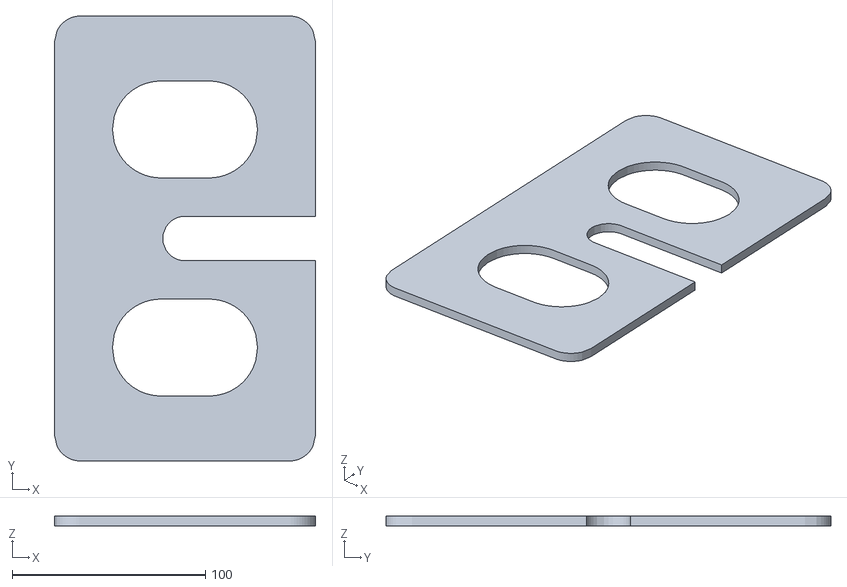
[picture p56: CAD file, 2026-11-09]
designs/softgoods/r1/M-r0/softgoods/TEXTILE_REFERENCE_ONLY_rear_pad.stl
135.0 x 230.0 x 5.00
