stacksjs/buddy-wheels/designs/softgoods/r1/XL-r0/softgoods/TEXTILE_REFERENCE_ONLY_front_shell.stl

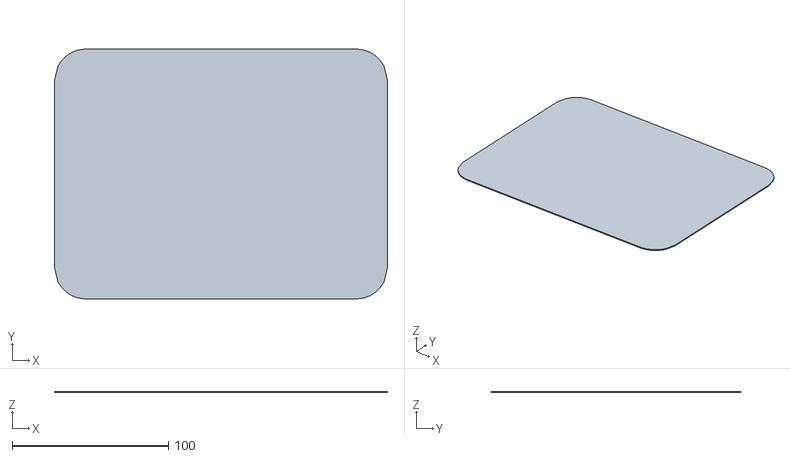
[picture p58: CAD file, 2026-11-09]
designs/softgoods/r1/XL-r0/softgoods/TEXTILE_REFERENCE_ONLY_front_shell.stl
213.0 x 159.8 x 0.8
