stacksjs/buddy-wheels/designs/softgoods/r1/XS-r0/softgoods/saddle-shell.dxf

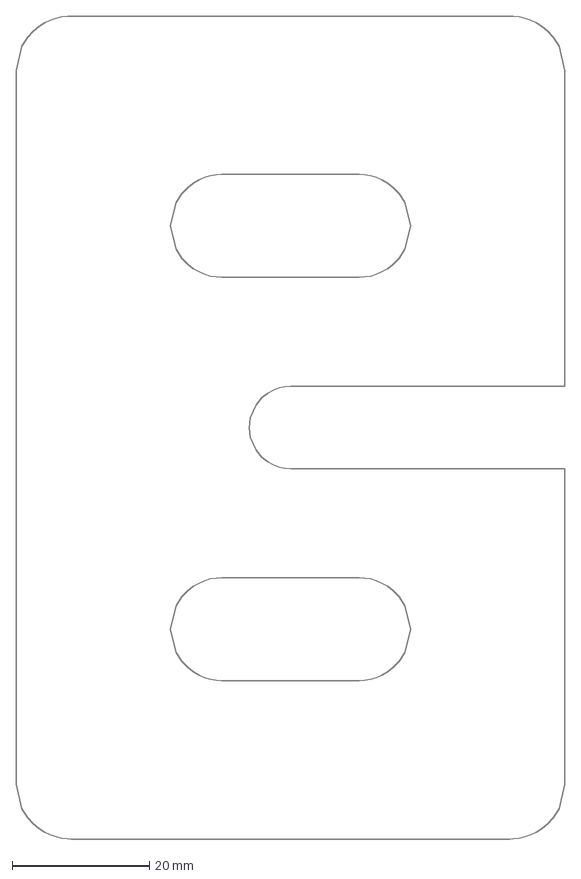
[picture p59: CAD file, 2026-11-09]
designs/softgoods/r1/XS-r0/softgoods/saddle-shell.dxf
80.0 x 120.0 mm
