stacksjs/buddy-wheels/designs/wheelchair/r0/L/stl/pivot_guard.stl

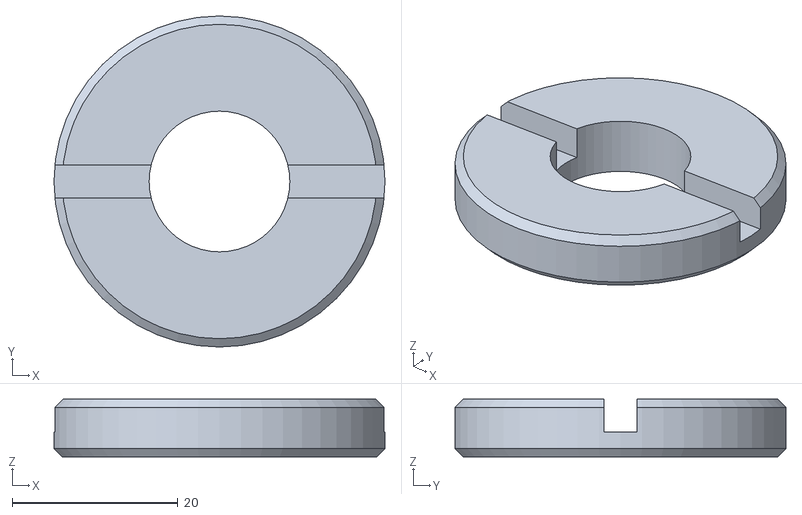
[picture p60: CAD file, 2026-11-08]
designs/wheelchair/r0/L/stl/pivot_guard.stl
40.0 x 40.0 x 7.00
