stacksjs/buddy-wheels/designs/wheelchair/r2/XL/metal/axle_plate.dxf

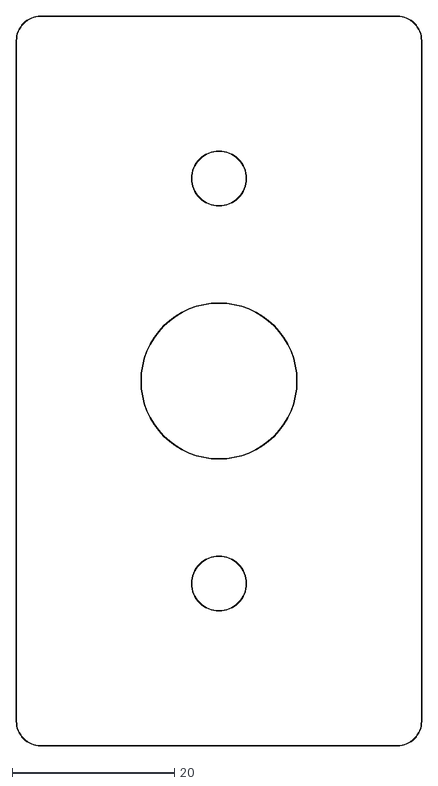
[picture p62: CAD file, 2026-11-08]
designs/wheelchair/r2/XL/metal/axle_plate.dxf
50.0 x 90.0
