stacksjs/buddy-wheels/public/designs/m/r0/metal/arm_plate.dxf

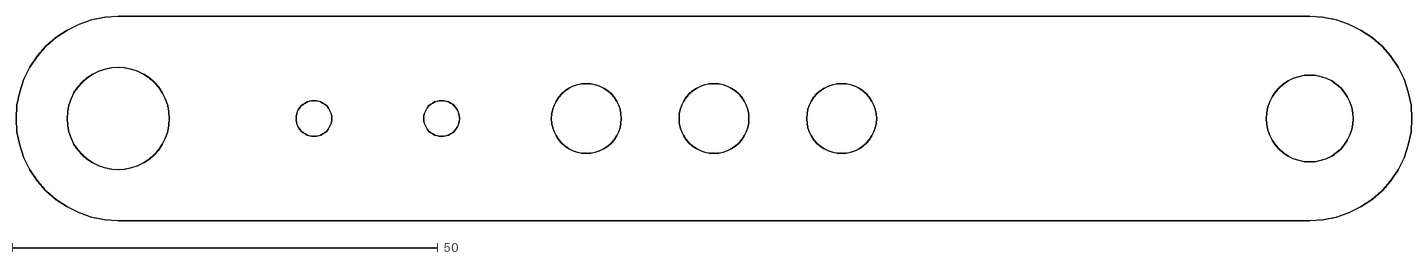
[picture p64: CAD file, 2026-11-08]
public/designs/m/r0/metal/arm_plate.dxf
164.0 x 24.0
