stacksjs/buddy-wheels/public/designs/m/r0/parts/inner_cap.stl

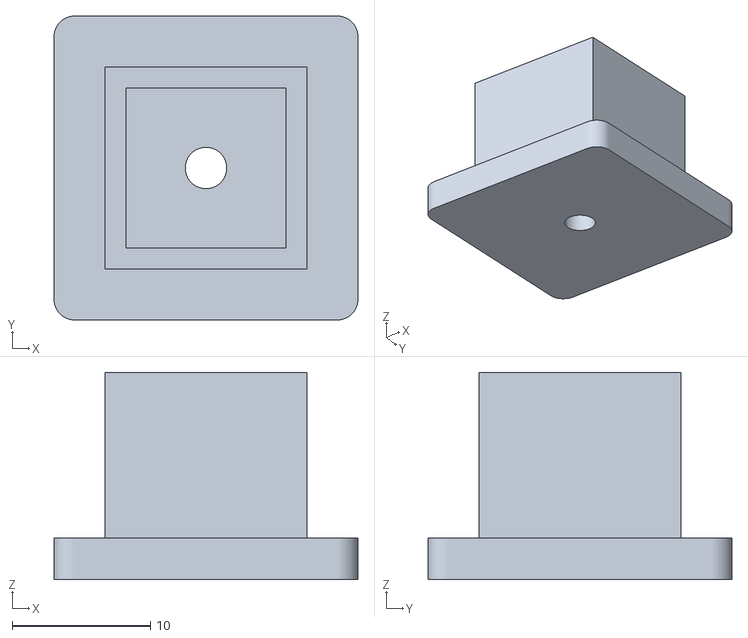
[picture p65: CAD file, 2026-11-08]
public/designs/m/r0/parts/inner_cap.stl
22.0 x 22.0 x 15.0
