stacksjs/buddy-wheels/public/designs/s/r0/metal/fixed_plate.dxf

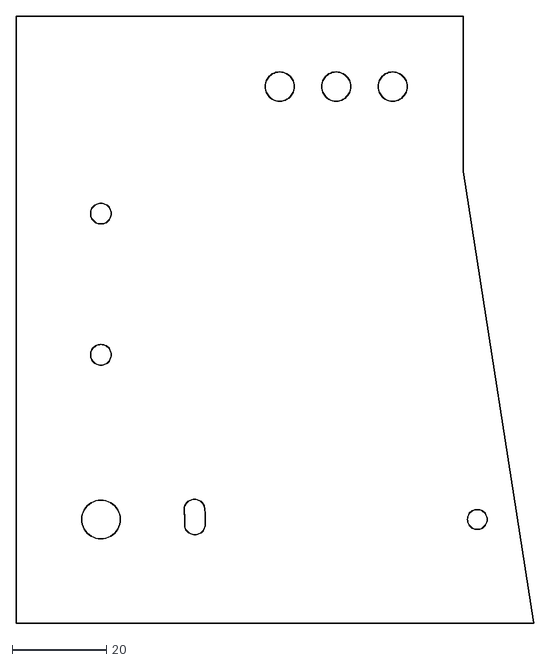
[picture p66: CAD file, 2026-11-08]
public/designs/s/r0/metal/fixed_plate.dxf
110.0 x 129.0
