stacksjs/buddy-wheels/public/designs/xs/r0/metal/corner_plate.dxf

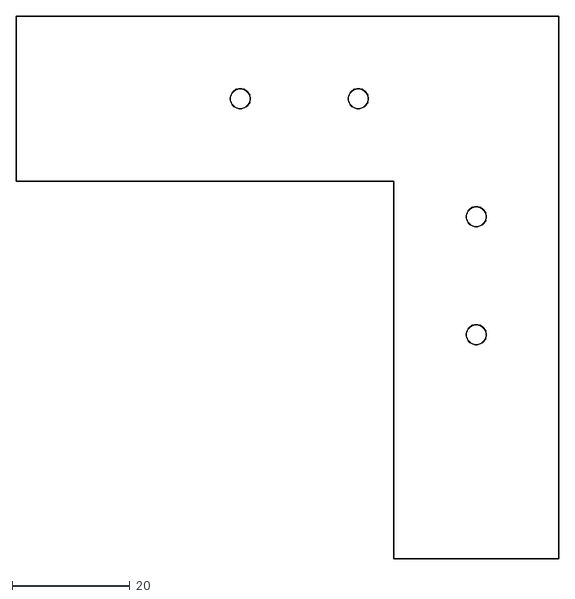
[picture p67: CAD file, 2026-11-08]
public/designs/xs/r0/metal/corner_plate.dxf
92.0 x 92.0
