stacksjs/buddy-wheels/designs/rover/r0/metal/axle_hanger_mid.dxf

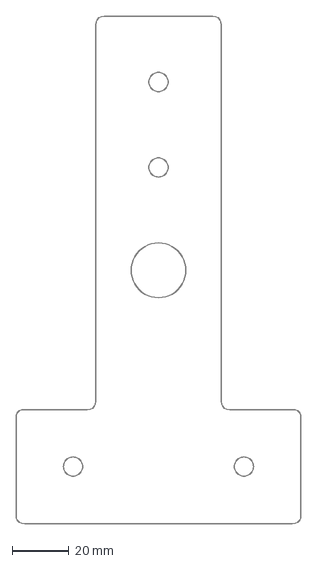
[picture p68: CAD file, 2026-11-12]
designs/rover/r0/metal/axle_hanger_mid.dxf
100.0 x 178.0 mm
