stacksjs/buddy-wheels/designs/rover/r0/parts/FIT_CHECK_ONLY_axle_hanger_mid.stl

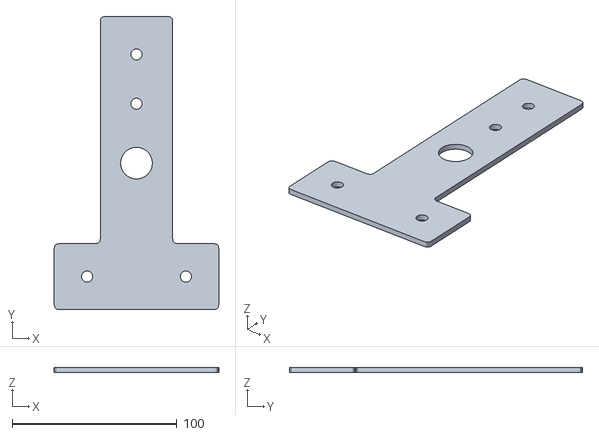
[picture p69: CAD file, 2026-11-12]
designs/rover/r0/parts/FIT_CHECK_ONLY_axle_hanger_mid.stl
100.0 x 178.0 x 3.17
