stacksjs/buddy-wheels/designs/softgoods/r1/L-r0/softgoods/TEXTILE_REFERENCE_ONLY_rear_pad.stl

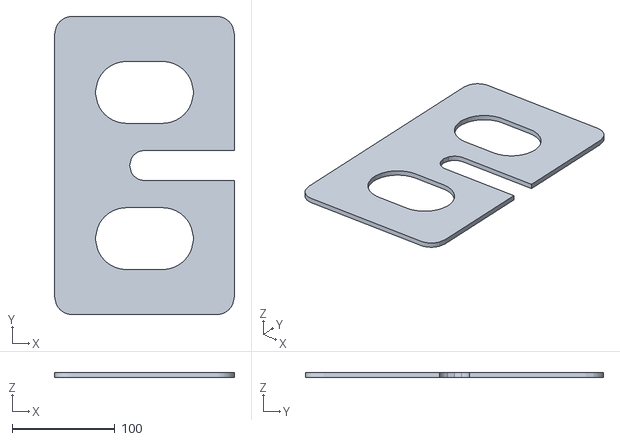
[picture p70: CAD file, 2026-11-09]
designs/softgoods/r1/L-r0/softgoods/TEXTILE_REFERENCE_ONLY_rear_pad.stl
175.0 x 290.0 x 5.00
