stacksjs/buddy-wheels/designs/softgoods/r1/M-r0/softgoods/TEXTILE_REFERENCE_ONLY_rear_shell.stl

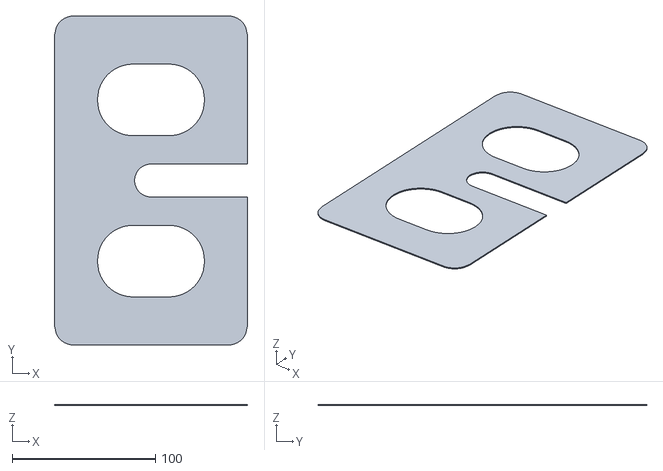
[picture p71: CAD file, 2026-11-09]
designs/softgoods/r1/M-r0/softgoods/TEXTILE_REFERENCE_ONLY_rear_shell.stl
135.0 x 230.0 x 0.8
