stacksjs/buddy-wheels/designs/softgoods/r1/S-r0/softgoods/TEXTILE_REFERENCE_ONLY_rear_mesh.stl

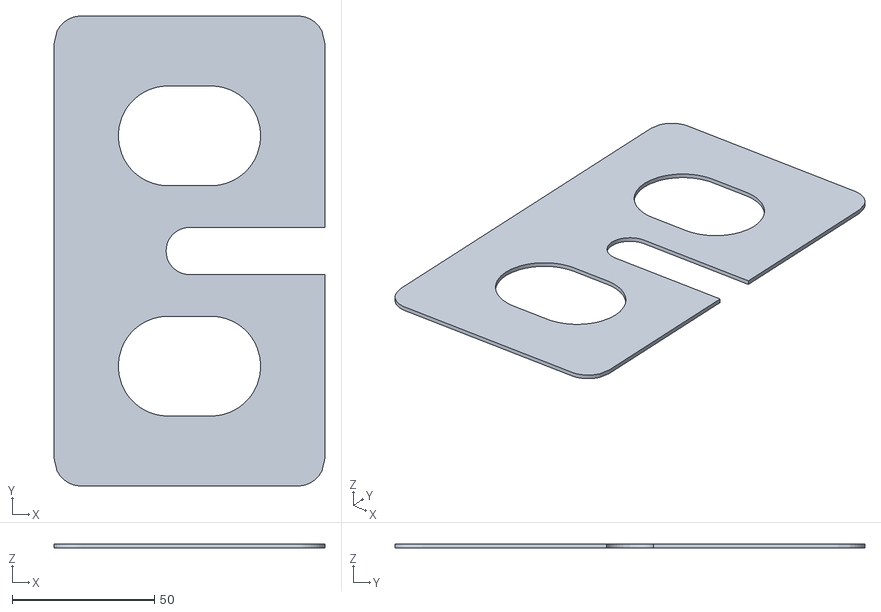
[picture p72: CAD file, 2026-11-09]
designs/softgoods/r1/S-r0/softgoods/TEXTILE_REFERENCE_ONLY_rear_mesh.stl
95.0 x 165.0 x 1.50
