stacksjs/buddy-wheels/designs/softgoods/r1/XL-r1/softgoods/saddle-shell.dxf

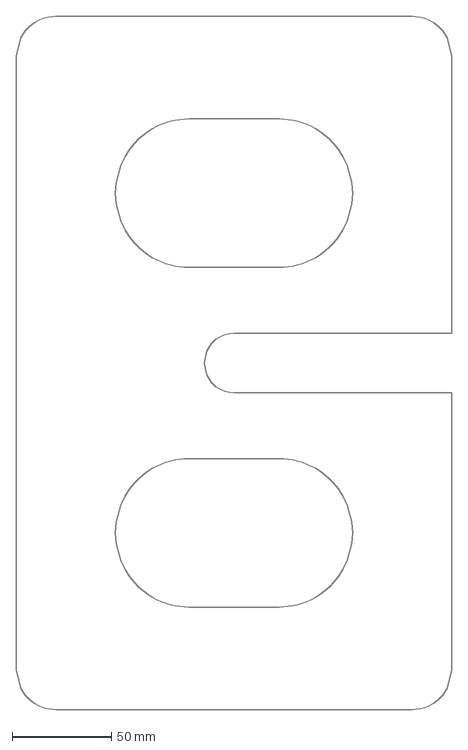
[picture p73: CAD file, 2026-11-09]
designs/softgoods/r1/XL-r1/softgoods/saddle-shell.dxf
220.0 x 350.0 mm
