stacksjs/buddy-wheels/designs/softgoods/r1/XS-r0/softgoods/TEXTILE_REFERENCE_ONLY_rear_pad.stl

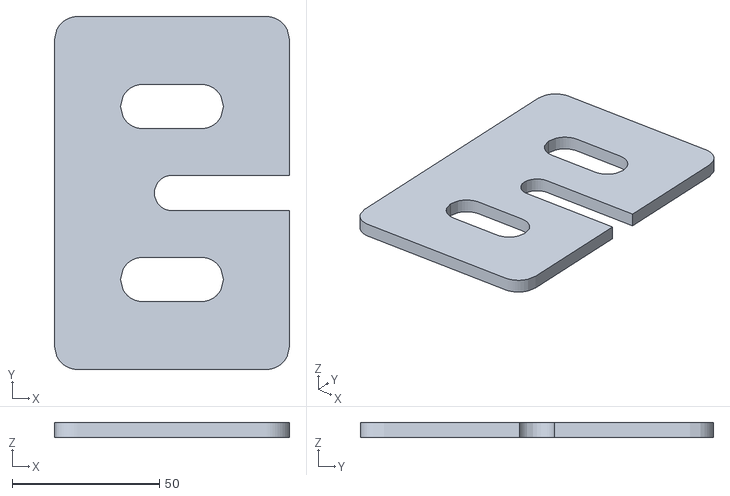
[picture p74: CAD file, 2026-11-09]
designs/softgoods/r1/XS-r0/softgoods/TEXTILE_REFERENCE_ONLY_rear_pad.stl
80.0 x 120.0 x 5.00
