stacksjs/buddy-wheels/designs/wheelchair/r2/XL/metal/joint_plate.dxf

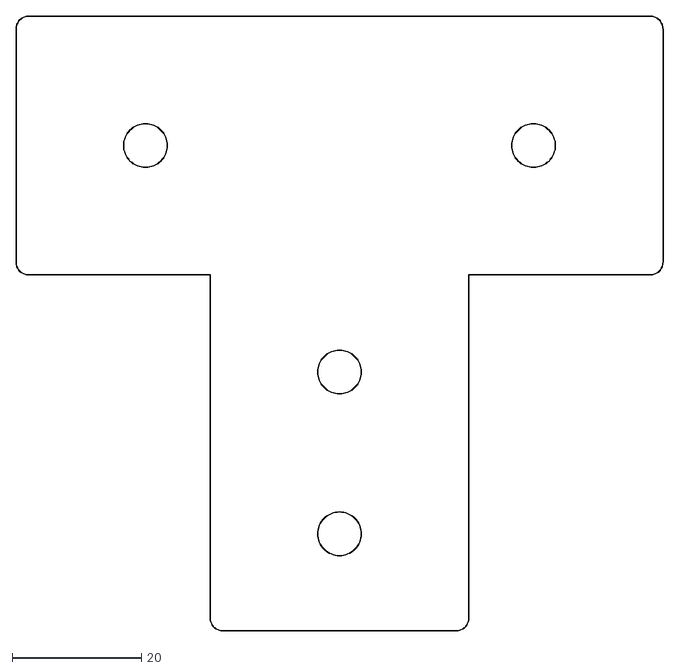
[picture p75: CAD file, 2026-11-08]
designs/wheelchair/r2/XL/metal/joint_plate.dxf
100.0 x 95.0
