stacksjs/buddy-wheels/designs/rover/r0/metal/axle_hanger_low.dxf

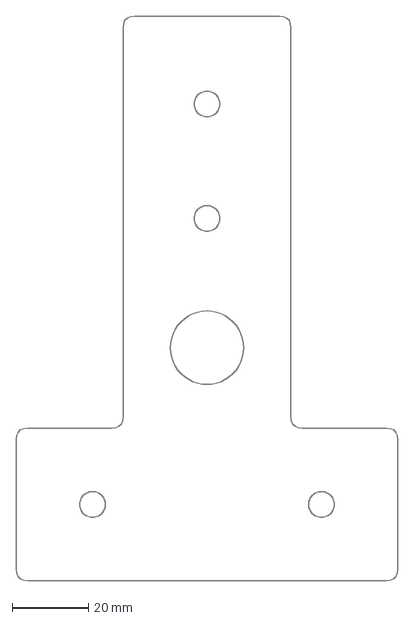
[picture p76: CAD file, 2026-11-12]
designs/rover/r0/metal/axle_hanger_low.dxf
100.0 x 148.0 mm
