stacksjs/buddy-wheels/designs/softgoods/r1/L-r0/softgoods/saddle-shell.dxf

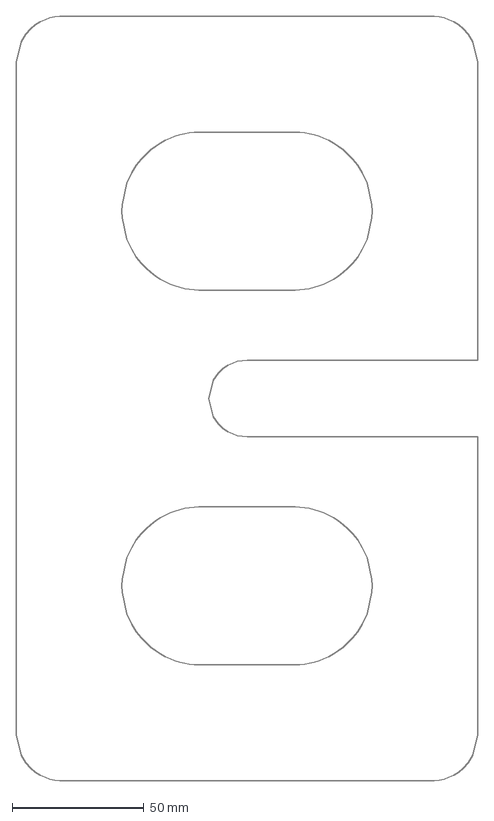
[picture p77: CAD file, 2026-11-09]
designs/softgoods/r1/L-r0/softgoods/saddle-shell.dxf
175.0 x 290.0 mm
