stacksjs/buddy-wheels/designs/softgoods/r1/M-r0/softgoods/TEXTILE_REFERENCE_ONLY_front_mesh.stl

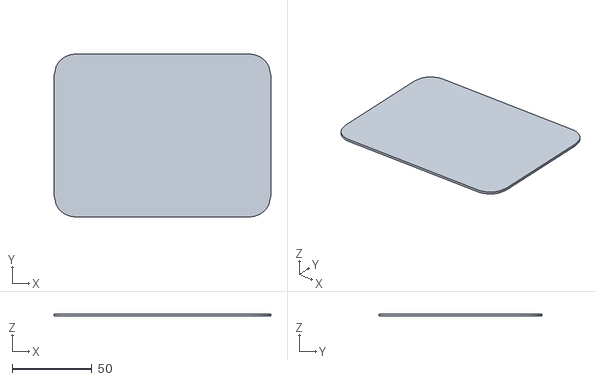
[picture p78: CAD file, 2026-11-09]
designs/softgoods/r1/M-r0/softgoods/TEXTILE_REFERENCE_ONLY_front_mesh.stl
136.0 x 102.0 x 1.50
