stacksjs/buddy-wheels/designs/softgoods/r1/S-r0/softgoods/TEXTILE_REFERENCE_ONLY_front_shell.stl

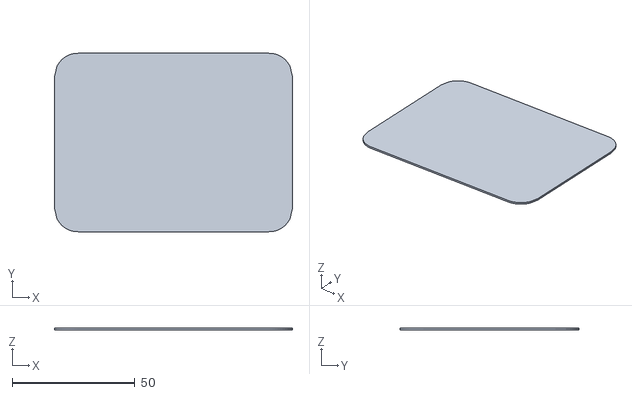
[picture p79: CAD file, 2026-11-09]
designs/softgoods/r1/S-r0/softgoods/TEXTILE_REFERENCE_ONLY_front_shell.stl
97.0 x 72.8 x 0.8
