stacksjs/buddy-wheels/designs/softgoods/r1/XL-r1/softgoods/TEXTILE_REFERENCE_ONLY_front_mesh.stl

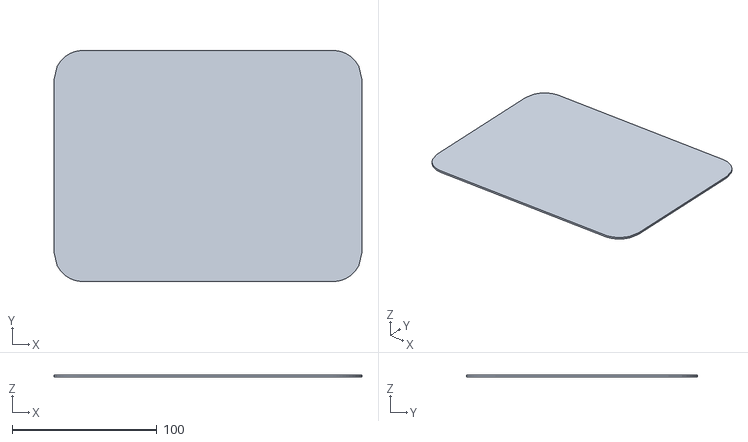
[picture p80: CAD file, 2026-11-09]
designs/softgoods/r1/XL-r1/softgoods/TEXTILE_REFERENCE_ONLY_front_mesh.stl
213.0 x 159.8 x 1.50
