stacksjs/buddy-wheels/designs/softgoods/r1/XL-r2/softgoods/front-bib.dxf

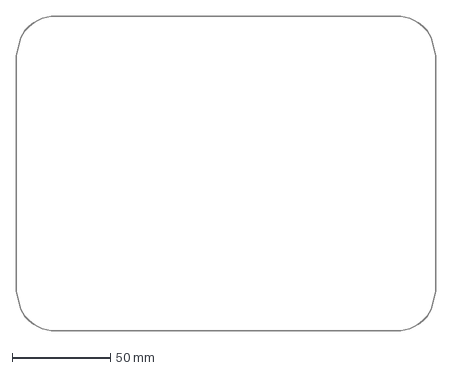
[picture p81: CAD file, 2026-11-09]
designs/softgoods/r1/XL-r2/softgoods/front-bib.dxf
213.0 x 159.8 mm
