stacksjs/buddy-wheels/designs/softgoods/r1/XS-r0/softgoods/TEXTILE_REFERENCE_ONLY_rear_shell.stl

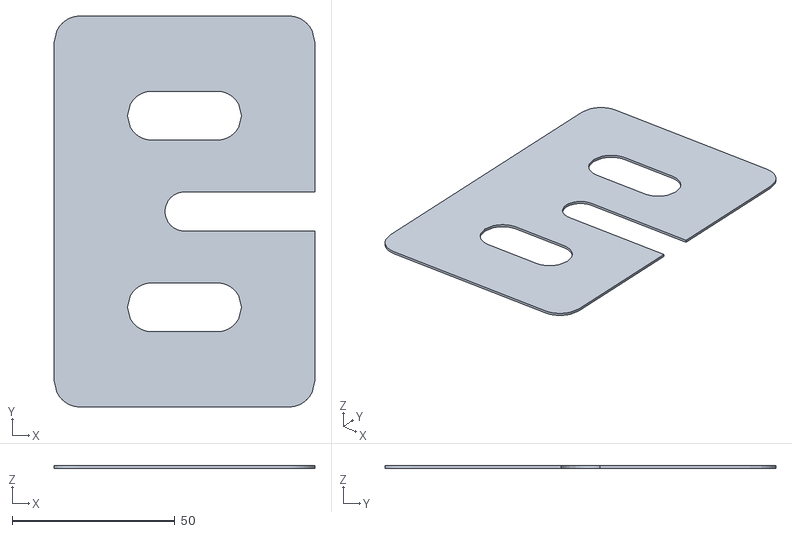
[picture p82: CAD file, 2026-11-09]
designs/softgoods/r1/XS-r0/softgoods/TEXTILE_REFERENCE_ONLY_rear_shell.stl
80.0 x 120.0 x 0.8
