stacksjs/buddy-wheels/designs/wheelchair/r2/XL/parts/FIT_CHECK_ONLY_rail_shim.stl

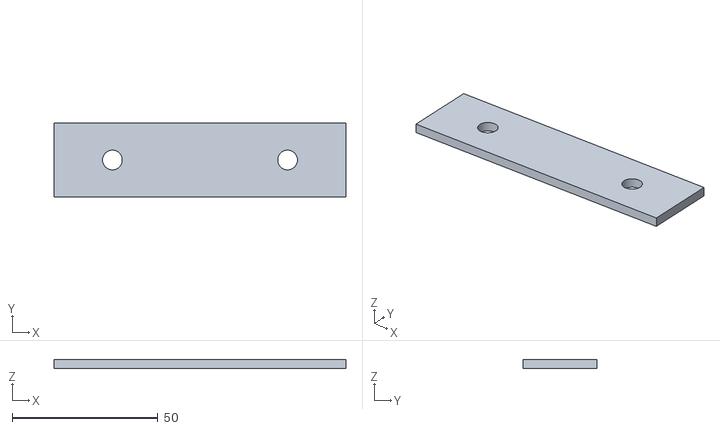
[picture p83: CAD file, 2026-11-08]
designs/wheelchair/r2/XL/parts/FIT_CHECK_ONLY_rail_shim.stl
100.0 x 25.4 x 3.17
