stacksjs/buddy-wheels/designs/wheelchair/iterations/buddy-xl-estimate/model.scad

// GENERATED by buddy design:wheelchair. BENCH ONLY, NOT FITTED TO A DOG.
tube=25;
wall=2;
inner=20;
inner_wall=2;
rail=680;
width=400;
height=620;
wheel=400;
tire_width=50;
hub_width=40;
wheel_offset=70;
arm=180;
shock_full=165;
shock_stroke=38;
shock_neutral=155;
shock_od=40;
radii=[70,90,110];
plate=6;
arm_plate=6;
gap=48;
eye_width=20;
eye_bolt=8;
pivot=10;
pivot_bore=14;
axle=12;
frame_bolt=6;
stop_bolt=6;
lock_bolt=6;
stop_r=30;
lock_r=50;
pitch=30;
inner_length=180;
bw_frame=[0.1922,0.3686,0.2784];
bw_metal=[0.7059,0.749,0.7216];
bw_polymer=[0.1451,0.2941,0.2196];
bw_arm=[0.2431,0.302,0.2627];
bw_tire=[0.1608,0.1961,0.1765];
include <../../r0/source/wheelchair.scad>
