stacksjs/buddy-wheels/designs/wheelchair/r0/M/model.scad

// GENERATED by buddy design:wheelchair. BENCH ONLY, NOT FITTED TO A DOG.
tube=22;
wall=1.5;
inner=18;
inner_wall=1.5;
rail=460;
width=280;
height=380;
wheel=300;
tire_width=40;
hub_width=35;
wheel_offset=60;
arm=140;
shock_full=140;
shock_stroke=28;
shock_neutral=130;
shock_od=32;
radii=[55,70,85];
plate=5;
arm_plate=5;
gap=40;
eye_width=16;
eye_bolt=8;
pivot=8;
pivot_bore=12;
axle=10;
frame_bolt=5;
stop_bolt=4;
lock_bolt=4;
stop_r=23;
lock_r=38;
pitch=30;
inner_length=150;
bw_frame=[0.1922,0.3686,0.2784];
bw_metal=[0.7059,0.749,0.7216];
bw_polymer=[0.1451,0.2941,0.2196];
bw_arm=[0.2431,0.302,0.2627];
bw_tire=[0.1608,0.1961,0.1765];
include <../source/wheelchair.scad>
