stacksjs/buddy-wheels/designs/wheelchair/r0/S/model.scad

// GENERATED by buddy design:wheelchair. BENCH ONLY, NOT FITTED TO A DOG.
tube=20;
wall=1.5;
inner=16;
inner_wall=1.5;
rail=340;
width=210;
height=260;
wheel=200;
tire_width=35;
hub_width=30;
wheel_offset=50;
arm=100;
shock_full=100;
shock_stroke=20;
shock_neutral=92;
shock_od=24;
radii=[38,50,62];
plate=4;
arm_plate=4;
gap=30;
eye_width=12;
eye_bolt=6;
pivot=8;
pivot_bore=12;
axle=8;
frame_bolt=4;
stop_bolt=4;
lock_bolt=4;
stop_r=20;
lock_r=80;
pitch=20;
inner_length=120;
bw_frame=[0.1922,0.3686,0.2784];
bw_metal=[0.7059,0.749,0.7216];
bw_polymer=[0.1451,0.2941,0.2196];
bw_arm=[0.2431,0.302,0.2627];
bw_tire=[0.1608,0.1961,0.1765];
include <../source/wheelchair.scad>
