stacksjs/buddy-wheels/designs/wheelchair/r0/XS/model.scad

// GENERATED by buddy design:wheelchair. BENCH ONLY, NOT FITTED TO A DOG.
tube=16;
wall=1.5;
inner=12;
inner_wall=1.5;
rail=260;
width=160;
height=220;
wheel=120;
tire_width=25;
hub_width=25;
wheel_offset=40;
arm=70;
shock_full=75;
shock_stroke=12;
shock_neutral=70;
shock_od=16;
radii=[25,32,40];
plate=3;
arm_plate=3;
gap=20;
eye_width=10;
eye_bolt=4;
pivot=6;
pivot_bore=8;
axle=6;
frame_bolt=3;
stop_bolt=3;
lock_bolt=4;
stop_r=14;
lock_r=55;
pitch=20;
inner_length=120;
bw_frame=[0.1922,0.3686,0.2784];
bw_metal=[0.7059,0.749,0.7216];
bw_polymer=[0.1451,0.2941,0.2196];
bw_arm=[0.2431,0.302,0.2627];
bw_tire=[0.1608,0.1961,0.1765];
include <../source/wheelchair.scad>
