stacksjs/buddy-wheels/designs/wheelchair/r1/XL/model.scad

// GENERATED XL r1 RIGID BENCH DESIGN. NOT FOR ANIMAL USE.
height=620;
width=400;
rail=680;
hub=82.55;
tube=25.4;
wall=1.651;
plate=3.175;
wheel=330.2;
tire=101.6;
axle=15.875;
sleeve=9.525;
sleeveWall=1.2446;
axleSleeve=19.05;
axleSleeveWall=1.4732;
spacer=25.4;
washer=1.5;
cotter=3.2;
include <source/standard.scad>
