stacksjs/buddy-wheels/designs/softgoods/r1/XL-r0/assembly-with-softgoods.scad

// Exact configured baseline frame plus candidate textile assembly.
include <model.scad>
include <softgoods/parts.scad>
