stacksjs/buddy-wheels/designs/softgoods/r1/L-r0/softgoods/parts.scad

// Textile revision 1 BENCH ONLY. All mm. Not printable animal support.
sg_part="assembly";
sg_width=290;sg_length=175;sg_drop=70;sg_chest=880;sg_leg_width=60;sg_leg_length=95;
sg_corner=17.5;sg_notch=29;sg_leg_center=71.05;
module sg_roundrect(l,w,r){offset(r=r,$fn=96)square([l-2*r,w-2*r],center=true);}
module sg_capsule(l,w){hull()for(x=[-(l-w)/2,(l-w)/2])translate([x,0])circle(d=w,$fn=96);}
module sg_saddle(){difference(){sg_roundrect(sg_length,sg_width,sg_corner);for(y=[-sg_leg_center,sg_leg_center])translate([0,y])sg_capsule(sg_leg_length,sg_leg_width);hull(){circle(d=sg_notch,$fn=96);translate([sg_length,0])circle(d=sg_notch,$fn=96);}}}
module sg_bib(){sg_roundrect(176,132,17.5);}
module sg_layer(bib,t){linear_extrude(t){if(bib)sg_bib();else sg_saddle();}}

module sg_assembly(){
color("#344039")translate([0,0,429.2])sg_layer(false,0.8);
color("#344c43")translate([0,0,430])sg_layer(false,5);
color("#344c43")translate([0,0,435])sg_layer(false,1.5);
color("#344039")translate([-429.2,0,447.2])rotate([0,-90,0])sg_layer(true,0.8);
color("#344c43")translate([-430,0,447.2])rotate([0,-90,0])sg_layer(true,5);
color("#344c43")translate([-435,0,447.2])rotate([0,-90,0])sg_layer(true,1.5);
color("#303b35")multmatrix([[0.8219740153255166,0.4649604932591932,-0.3288927755938325,-85.9],[-0.5695249934196456,0.6710600026825942,-0.47467858037833255,-149.65],[0,0.5774861145584405,0.8164005067932012,465],[0,0,0,1]])cube([25.4,1.6,85.7422299686683],center=true);
color("#303b35")multmatrix([[-0.9771926031067613,0.16632161768229864,-0.13202929949437328,65.9],[-0.2123549303252261,-0.7653613423854932,0.6075585561478367,-102.15],[0,0.621738799716906,0.7832246580174689,465],[0,0,0,1]])cube([25.4,1.6,89.37410139408397],center=true);
color("#303b35")multmatrix([[0.8839945855497453,0,-0.4674971365888076,-457.5],[-0.4674971365888076,0,-0.8839945855497453,-118],[0,1.0000000000000002,0,500],[0,0,0,1]])cube([25.4,1.6,117.64777940955791],center=true);
color("#303b35")multmatrix([[0,0,1,-20],[1,0,0,-170],[0,1,0,515.5],[0,0,0,1]])cube([25.4,1.6,160],center=true);
color("#303b35")multmatrix([[-1,0,0,60],[0,0,1,-122.5],[0,1,0,515.5],[0,0,0,1]])cube([25.4,1.6,95],center=true);
color("#303b35")multmatrix([[0,0.9712829350403137,0.23792742611870935,-420],[-0.9327463542957253,0.08578075288574587,-0.3501798123570062,-60.917925464477165],[-0.36053326968260985,-0.22192593929919166,0.9059606166485042,573.2771830901282],[0,0,0,1]])cube([25.4,1.6,84.05924582238528],center=true);
color("#303b35")multmatrix([[-0.8219740153255166,0.4649604932591932,-0.3288927755938325,-85.9],[-0.5695249934196456,-0.6710600026825942,0.47467858037833255,149.65],[0,0.5774861145584405,0.8164005067932012,465],[0,0,0,1]])cube([25.4,1.6,85.7422299686683],center=true);
color("#303b35")multmatrix([[0.9771926031067613,0.16632161768229864,-0.13202929949437328,65.9],[-0.2123549303252261,0.7653613423854932,-0.6075585561478367,102.15],[0,0.621738799716906,0.7832246580174689,465],[0,0,0,1]])cube([25.4,1.6,89.37410139408397],center=true);
color("#303b35")multmatrix([[-0.8839945855497453,0,-0.4674971365888076,-457.5],[-0.4674971365888076,0,0.8839945855497453,118],[0,1.0000000000000002,0,500],[0,0,0,1]])cube([25.4,1.6,117.64777940955791],center=true);
color("#303b35")multmatrix([[0,0,1,-20],[1,0,0,170],[0,1,0,515.5],[0,0,0,1]])cube([25.4,1.6,160],center=true);
color("#303b35")multmatrix([[1,0,0,60],[0,0,-1,122.5],[0,1,0,515.5],[0,0,0,1]])cube([25.4,1.6,95],center=true);
color("#303b35")multmatrix([[0,0.9712829350403137,0.2379274261187093,-420],[-0.932746354295725,-0.08578075288574594,0.3501798123570066,60.91792546447718],[0.36053326968261024,-0.22192593929919155,0.9059606166485041,573.2771830901282],[0,0,0,1]])cube([25.4,1.6,84.0592458223853],center=true);
color("#303b35")multmatrix([[1,0,0,-410],[0,0.9970402198210327,-0.07688172773310174,150.6246266681017],[0,0.07688172773310174,0.9970402198210327,508.3915906745179],[0,0,0,1]])cube([25.4,1.6,16.833003338670057],center=true);
color("#303b35")multmatrix([[1,0,0,-410],[0,0.973694228614433,-0.22785861660894907,148.04739754477436],[0,0.22785861660894907,0.973694228614433,525.0311895805241],[0,0,0,1]])cube([25.4,1.6,16.94168043539776],center=true);
color("#303b35")multmatrix([[1,0,0,-410],[0,0.9286821551154756,-0.37087660315807963,142.93703640296275],[0,0.37087660315807963,0.9286821551154756,541.2424978928509],[0,0,0,1]])cube([25.4,1.6,17.149678255308004],center=true);
color("#303b35")multmatrix([[1,0,0,-410],[0,0.8649669556719881,-0.5018288210092493,135.380982938663],[0,0.5018288210092493,0.8649669556719881,556.7481356316501],[0,0,0,1]])cube([25.4,1.6,17.439597220454438],center=true);
color("#303b35")multmatrix([[1,0,0,-410],[0,0.7861738613767888,-0.6180053880735262,125.50852332158317],[0,0.6180053880735262,0.7861738613767888,571.2827970362364],[0,0,0,1]])cube([25.4,1.6,17.788237666359944],center=true);
color("#303b35")multmatrix([[1,0,0,-410],[0,0.6959764213224859,-0.7180646356444143,113.48857807293432],[0,0.7180646356444143,0.6959764213224859,584.5977900202074],[0,0,0,1]])cube([25.4,1.6,18.16920528810934],center=true);
color("#303b35")multmatrix([[1,0,0,-410],[0,0.5976524451738587,-0.801755296070882,99.52681178847928],[0,0.801755296070882,0.5976524451738587,596.4652913619941],[0,0,0,1]])cube([25.4,1.6,18.555373274940017],center=true);
color("#303b35")multmatrix([[1,0,0,-410],[0,0.4938582289709189,-0.869542436961939,83.86211416027801],[0,0.869542436961939,0.4938582289709189,606.6822448233456],[0,0,0,1]])cube([25.4,1.6,18.92090111223339],center=true);
color("#303b35")multmatrix([[1,0,0,-410],[0,0.38658453130596276,-0.9222539781182563,66.7625125078237],[0,0.9222539781182563,0.38658453130596276,615.0738354978636],[0,0,0,1]])cube([25.4,1.6,19.242721921862785],center=true);
color("#303b35")multmatrix([[1,0,0,-410],[0,0.27722680430599345,-0.9608045061167679,48.52058575629509],[0,0.9608045061167679,0.27722680430599345,621.4964809425184],[0,0,0,1]])cube([25.4,1.6,19.501549525953973],center=true);
color("#303b35")multmatrix([[1,0,0,-410],[0,0.16670947961696905,-0.9860060595178102,29.448458330028444],[0,0.9860060595178102,0.16670947961696905,625.8402879130583],[0,0,0,1]])cube([25.4,1.6,19.682514122913307],center=true);
color("#303b35")multmatrix([[1,0,0,-410],[0,0.05562568420108491,-0.9984516930012997,9.872459617079878],[0,0.9984516930012997,0.05562568420108491,628.0309326678864],[0,0,0,1]])cube([25.4,1.6,19.77553783779706],center=true);
color("#303b35")multmatrix([[1,0,0,-410],[0,-0.05562568420108498,-0.9984516930012994,-9.872459617079844],[0,0.9984516930012994,-0.05562568420108498,628.0309326678864],[0,0,0,1]])cube([25.4,1.6,19.775537837797035],center=true);
color("#303b35")multmatrix([[1,0,0,-410],[0,-0.16670947961696844,-0.9860060595178102,-29.44845833002843],[0,0.9860060595178102,-0.16670947961696844,625.8402879130583],[0,0,0,1]])cube([25.4,1.6,19.68251412291338],center=true);
color("#303b35")multmatrix([[1,0,0,-410],[0,-0.277226804305994,-0.9608045061167678,-48.52058575629509],[0,0.9608045061167678,-0.277226804305994,621.4964809425184],[0,0,0,1]])cube([25.4,1.6,19.501549525953937],center=true);
color("#303b35")multmatrix([[1,0,0,-410],[0,-0.38658453130596326,-0.9222539781182559,-66.76251250782367],[0,0.9222539781182559,-0.38658453130596326,615.0738354978636],[0,0,0,1]])cube([25.4,1.6,19.24272192186276],center=true);
color("#303b35")multmatrix([[1,0,0,-410],[0,-0.4938582289709179,-0.8695424369619394,-83.862114160278],[0,0.8695424369619394,-0.4938582289709179,606.6822448233456],[0,0,0,1]])cube([25.4,1.6,18.92090111223343],center=true);
color("#303b35")multmatrix([[1,0,0,-410],[0,-0.5976524451738591,-0.8017552960708817,-99.52681178847928],[0,0.8017552960708817,-0.5976524451738591,596.4652913619941],[0,0,0,1]])cube([25.4,1.6,18.555373274940006],center=true);
color("#303b35")multmatrix([[1,0,0,-410],[0,-0.6959764213224859,-0.7180646356444143,-113.4885780729343],[0,0.7180646356444143,-0.6959764213224859,584.5977900202074],[0,0,0,1]])cube([25.4,1.6,18.16920528810934],center=true);
color("#303b35")multmatrix([[1,0,0,-410],[0,-0.7861738613767884,-0.6180053880735267,-125.50852332158316],[0,0.6180053880735267,-0.7861738613767884,571.2827970362364],[0,0,0,1]])cube([25.4,1.6,17.788237666359954],center=true);
color("#303b35")multmatrix([[1,0,0,-410],[0,-0.8649669556719881,-0.5018288210092493,-135.380982938663],[0,0.5018288210092493,-0.8649669556719881,556.7481356316501],[0,0,0,1]])cube([25.4,1.6,17.439597220454438],center=true);
color("#303b35")multmatrix([[1,0,0,-410],[0,-0.9286821551154756,-0.37087660315807963,-142.93703640296275],[0,0.37087660315807963,-0.9286821551154756,541.2424978928509],[0,0,0,1]])cube([25.4,1.6,17.149678255308004],center=true);
color("#303b35")multmatrix([[1,0,0,-410],[0,-0.973694228614433,-0.22785861660894907,-148.04739754477436],[0,0.22785861660894907,-0.973694228614433,525.0311895805241],[0,0,0,1]])cube([25.4,1.6,16.94168043539776],center=true);
color("#303b35")multmatrix([[1,0,0,-410],[0,-0.9970402198210327,-0.07688172773310174,-150.6246266681017],[0,0.07688172773310174,-0.9970402198210327,508.3915906745179],[0,0,0,1]])cube([25.4,1.6,16.833003338670057],center=true);
color("#303b35")multmatrix([[1,0,0,-410],[0,-0.9970402198210327,0.07688172773310174,-150.6246266681017],[0,-0.07688172773310174,-0.9970402198210327,491.6084093254821],[0,0,0,1]])cube([25.4,1.6,16.833003338670057],center=true);
color("#303b35")multmatrix([[1,0,0,-410],[0,-0.9736942286144331,0.227858616608949,-148.04739754477438],[0,-0.227858616608949,-0.9736942286144331,474.96881041947586],[0,0,0,1]])cube([25.4,1.6,16.941680435397643],center=true);
color("#303b35")multmatrix([[1,0,0,-410],[0,-0.9286821551154765,0.37087660315807736,-142.93703640296278],[0,-0.37087660315807736,-0.9286821551154765,458.7575021071492],[0,0,0,1]])cube([25.4,1.6,17.14967825530811],center=true);
color("#303b35")multmatrix([[1,0,0,-410],[0,-0.8649669556719872,0.5018288210092504,-135.38098293866304],[0,-0.5018288210092504,-0.8649669556719872,443.25186436834986],[0,0,0,1]])cube([25.4,1.6,17.439597220454456],center=true);
color("#303b35")multmatrix([[1,0,0,-410],[0,-0.7861738613767875,0.6180053880735278,-125.50852332158318],[0,-0.6180053880735278,-0.7861738613767875,428.7172029637637],[0,0,0,1]])cube([25.4,1.6,17.78823766635983],center=true);
color("#303b35")multmatrix([[1,0,0,-410],[0,-0.6959764213224884,0.7180646356444119,-113.48857807293435],[0,-0.7180646356444119,-0.6959764213224884,415.40220997979264],[0,0,0,1]])cube([25.4,1.6,18.16920528810944],center=true);
color("#303b35")multmatrix([[1,0,0,-410],[0,-0.5976524451738591,0.8017552960708817,-99.5268117884793],[0,-0.8017552960708817,-0.5976524451738591,403.53470863800584],[0,0,0,1]])cube([25.4,1.6,18.555373274940006],center=true);
color("#303b35")multmatrix([[1,0,0,-410],[0,-0.49385822897091947,0.8695424369619384,-83.86211416027805],[0,-0.8695424369619384,-0.49385822897091947,393.3177551766543],[0,0,0,1]])cube([25.4,1.6,18.92090111223337],center=true);
color("#303b35")multmatrix([[1,0,0,-410],[0,-0.38658453130596315,0.9222539781182562,-66.76251250782377],[0,-0.9222539781182562,-0.38658453130596315,384.92616450213643],[0,0,0,1]])cube([25.4,1.6,19.242721921862763],center=true);
color("#303b35")multmatrix([[1,0,0,-410],[0,-0.27722680430598956,0.9608045061167692,-48.52058575629512],[0,-0.9608045061167692,-0.27722680430598956,378.50351905748164],[0,0,0,1]])cube([25.4,1.6,19.501549525954044],center=true);
color("#303b35")multmatrix([[1,0,0,-410],[0,-0.16670947961696908,0.9860060595178102,-29.44845833002843],[0,-0.9860060595178102,-0.16670947961696908,374.1597120869418],[0,0,0,1]])cube([25.4,1.6,19.682514122913304],center=true);
color("#303b35")multmatrix([[1,0,0,-410],[0,-0.05562568420108784,0.9984516930012992,-9.872459617079882],[0,-0.9984516930012992,-0.05562568420108784,371.9690673321136],[0,0,0,1]])cube([25.4,1.6,19.77553783779704],center=true);
color("#303b35")multmatrix([[1,0,0,-410],[0,0.05562568420108784,0.9984516930012992,9.872459617079825],[0,-0.9984516930012992,0.05562568420108784,371.9690673321136],[0,0,0,1]])cube([25.4,1.6,19.77553783779704],center=true);
color("#303b35")multmatrix([[1,0,0,-410],[0,0.1667094796169662,0.9860060595178105,29.44845833002838],[0,-0.9860060595178105,0.1667094796169662,374.1597120869418],[0,0,0,1]])cube([25.4,1.6,19.682514122913304],center=true);
color("#303b35")multmatrix([[1,0,0,-410],[0,0.2772268043059922,0.9608045061167683,48.52058575629508],[0,-0.9608045061167683,0.2772268043059922,378.50351905748164],[0,0,0,1]])cube([25.4,1.6,19.50154952595406],center=true);
color("#303b35")multmatrix([[1,0,0,-410],[0,0.38658453130596326,0.9222539781182559,66.76251250782371],[0,-0.9222539781182559,0.38658453130596326,384.92616450213643],[0,0,0,1]])cube([25.4,1.6,19.24272192186276],center=true);
color("#303b35")multmatrix([[1,0,0,-410],[0,0.4938582289709189,0.869542436961939,83.86211416027801],[0,-0.869542436961939,0.4938582289709189,393.3177551766543],[0,0,0,1]])cube([25.4,1.6,18.92090111223339],center=true);
color("#303b35")multmatrix([[1,0,0,-410],[0,0.5976524451738598,0.8017552960708813,99.52681178847926],[0,-0.8017552960708813,0.5976524451738598,403.53470863800584],[0,0,0,1]])cube([25.4,1.6,18.55537327493998],center=true);
color("#303b35")multmatrix([[1,0,0,-410],[0,0.6959764213224856,0.7180646356444147,113.48857807293427],[0,-0.7180646356444147,0.6959764213224856,415.4022099797926],[0,0,0,1]])cube([25.4,1.6,18.16920528810935],center=true);
color("#303b35")multmatrix([[1,0,0,-410],[0,0.7861738613767877,0.6180053880735278,125.50852332158314],[0,-0.6180053880735278,0.7861738613767877,428.7172029637636],[0,0,0,1]])cube([25.4,1.6,17.788237666359898],center=true);
color("#303b35")multmatrix([[1,0,0,-410],[0,0.8649669556719881,0.5018288210092493,135.380982938663],[0,-0.5018288210092493,0.8649669556719881,443.2518643683498],[0,0,0,1]])cube([25.4,1.6,17.439597220454438],center=true);
color("#303b35")multmatrix([[1,0,0,-410],[0,0.9286821551154759,0.37087660315807874,142.93703640296275],[0,-0.37087660315807874,0.9286821551154759,458.75750210714915],[0,0,0,1]])cube([25.4,1.6,17.14967825530812],center=true);
color("#303b35")multmatrix([[1,0,0,-410],[0,0.9736942286144329,0.22785861660894985,148.04739754477436],[0,-0.22785861660894985,0.9736942286144329,474.96881041947586],[0,0,0,1]])cube([25.4,1.6,16.941680435397704],center=true);
color("#303b35")multmatrix([[1,0,0,-410],[0,0.9970402198210327,0.07688172773310199,150.6246266681017],[0,-0.07688172773310199,0.9970402198210327,491.60840932548206],[0,0,0,1]])cube([25.4,1.6,16.83300333867],center=true);
color("#303b35")multmatrix([[0,0,1,0],[1,0,0,-129.3],[0,1,0,429],[0,0,0,1]])cube([25.4,1.6,143.6],center=true);
color("#303b35")multmatrix([[1,0,0,71.8],[0,0,-1,-73.4],[0,1,0,429],[0,0,0,1]])cube([25.4,1.6,111.80000000000001],center=true);
color("#303b35")multmatrix([[0,0,1,0],[1,0,0,129.3],[0,1,0,429],[0,0,0,1]])cube([25.4,1.6,143.6],center=true);
color("#303b35")multmatrix([[-1,0,0,71.8],[0,0,1,73.4],[0,1,0,429],[0,0,0,1]])cube([25.4,1.6,111.80000000000001],center=true);
color("#303b35")multmatrix([[-1,0,0,-71.8],[0,0,1,0],[0,1,0,429],[0,0,0,1]])cube([25.4,1.6,258.6],center=true);
color("#303b35")multmatrix([[1,0,0,-100],[0,1,0,-170],[0,0,1,484.5],[0,0,0,1]])cube([25.4,31,1.6],center=true);
color("#303b35")multmatrix([[1,0,0,-100],[0,1,0,-154.5],[0,0,1,500],[0,0,0,1]])cube([25.4,1.6,31],center=true);
color("#303b35")multmatrix([[1,0,0,-100],[0,1,0,-170],[0,0,1,515.5],[0,0,0,1]])cube([25.4,31,1.6],center=true);
color("#303b35")multmatrix([[1,0,0,-100],[0,1,0,-185.5],[0,0,1,500],[0,0,0,1]])cube([25.4,1.6,31],center=true);
color("#303b35")multmatrix([[1,0,0,60],[0,1,0,-75],[0,0,1,478.5],[0,0,0,1]])cube([34,25.4,1.6],center=true);
color("#303b35")multmatrix([[1,0,0,77],[0,1,0,-75],[0,0,1,500],[0,0,0,1]])cube([1.6,25.4,43],center=true);
color("#303b35")multmatrix([[1,0,0,60],[0,1,0,-75],[0,0,1,521.5],[0,0,0,1]])cube([34,25.4,1.6],center=true);
color("#303b35")multmatrix([[1,0,0,43],[0,1,0,-75],[0,0,1,500],[0,0,0,1]])cube([1.6,25.4,43],center=true);
color("#303b35")multmatrix([[1,0,0,-485],[0,1,0,-170],[0,0,1,484.5],[0,0,0,1]])cube([25.4,31,1.6],center=true);
color("#303b35")multmatrix([[1,0,0,-485],[0,1,0,-154.5],[0,0,1,500],[0,0,0,1]])cube([25.4,1.6,31],center=true);
color("#303b35")multmatrix([[1,0,0,-485],[0,1,0,-170],[0,0,1,515.5],[0,0,0,1]])cube([25.4,31,1.6],center=true);
color("#303b35")multmatrix([[1,0,0,-485],[0,1,0,-185.5],[0,0,1,500],[0,0,0,1]])cube([25.4,1.6,31],center=true);
color("#303b35")multmatrix([[1,0,0,-100],[0,1,0,170],[0,0,1,484.5],[0,0,0,1]])cube([25.4,31,1.6],center=true);
color("#303b35")multmatrix([[1,0,0,-100],[0,1,0,185.5],[0,0,1,500],[0,0,0,1]])cube([25.4,1.6,31],center=true);
color("#303b35")multmatrix([[1,0,0,-100],[0,1,0,170],[0,0,1,515.5],[0,0,0,1]])cube([25.4,31,1.6],center=true);
color("#303b35")multmatrix([[1,0,0,-100],[0,1,0,154.5],[0,0,1,500],[0,0,0,1]])cube([25.4,1.6,31],center=true);
color("#303b35")multmatrix([[1,0,0,60],[0,1,0,75],[0,0,1,478.5],[0,0,0,1]])cube([34,25.4,1.6],center=true);
color("#303b35")multmatrix([[1,0,0,77],[0,1,0,75],[0,0,1,500],[0,0,0,1]])cube([1.6,25.4,43],center=true);
color("#303b35")multmatrix([[1,0,0,60],[0,1,0,75],[0,0,1,521.5],[0,0,0,1]])cube([34,25.4,1.6],center=true);
color("#303b35")multmatrix([[1,0,0,43],[0,1,0,75],[0,0,1,500],[0,0,0,1]])cube([1.6,25.4,43],center=true);
color("#303b35")multmatrix([[1,0,0,-485],[0,1,0,170],[0,0,1,484.5],[0,0,0,1]])cube([25.4,31,1.6],center=true);
color("#303b35")multmatrix([[1,0,0,-485],[0,1,0,185.5],[0,0,1,500],[0,0,0,1]])cube([25.4,1.6,31],center=true);
color("#303b35")multmatrix([[1,0,0,-485],[0,1,0,170],[0,0,1,515.5],[0,0,0,1]])cube([25.4,31,1.6],center=true);
color("#303b35")multmatrix([[1,0,0,-485],[0,1,0,154.5],[0,0,1,500],[0,0,0,1]])cube([25.4,1.6,31],center=true);
color("#88958d")multmatrix([[0.8219740153255166,0.4649604932591932,-0.3288927755938325,-107.35941416744399],[-0.5695249934196456,0.6710600026825942,-0.47467858037833255,-153.93265810619135],[0,0.5774861145584405,0.8164005067932012,483.2717819365156],[0,0,0,1]])cube([3,3,24],center=true);
color("#88958d")multmatrix([[0.8219740153255166,0.4649604932591932,-0.3288927755938325,-82.37140410154828],[-0.5695249934196456,0.6710600026825942,-0.47467858037833255,-171.24621790614856],[0,0.5774861145584405,0.8164005067932012,483.2717819365156],[0,0,0,1]])cube([3,3,24],center=true);
color("#88958d")multmatrix([[0.8219740153255166,0.4649604932591932,-0.3288927755938325,-98.31878327823138],[-0.5695249934196456,0.6710600026825942,-0.47467858037833255,-167.57356310014245],[0,0.5774861145584405,0.8164005067932012,491.8439872578442],[0,0,0,1]])cube([27.4,3,3],center=true);
color("#88958d")multmatrix([[0.8219740153255166,0.4649604932591932,-0.3288927755938325,-91.4120349907609],[-0.5695249934196456,0.6710600026825942,-0.47467858037833255,-157.60531291219746],[0,0.5774861145584405,0.8164005067932012,474.69957661518697],[0,0,0,1]])cube([27.4,3,3],center=true);
color("#88958d")multmatrix([[0.8219740153255166,0.4649604932591932,-0.3288927755938325,-94.86540913449613],[-0.5695249934196456,0.6710600026825942,-0.47467858037833255,-162.58943800616996],[0,0.5774861145584405,0.8164005067932012,483.2717819365156],[0,0,0,1]])cube([27.4,3,3],center=true);
color("#88958d")multmatrix([[-0.9771926031067613,0.16632161768229864,-0.13202929949437328,77.06678784655348],[-0.2123549303252261,-0.7653613423854932,0.6075585561478367,-81.95787397156992],[0,0.621738799716906,0.7832246580174689,483.17000076065113],[0,0,0,1]])cube([3,3,24],center=true);
color("#88958d")multmatrix([[-0.9771926031067613,0.16632161768229864,-0.13202929949437328,47.36013271210794],[-0.2123549303252261,-0.7653613423854932,0.6075585561478367,-88.4134638534568],[0,0.621738799716906,0.7832246580174689,483.17000076065113],[0,0,0,1]])cube([3,3,24],center=true);
color("#88958d")multmatrix([[-0.9771926031067613,0.16632161768229864,-0.13202929949437328,60.82715263463979],[-0.2123549303252261,-0.7653613423854932,0.6075585561478367,-78.80630407296108],[0,0.621738799716906,0.7832246580174689,491.39385966983457],[0,0,0,1]])cube([27.4,3,3],center=true);
color("#88958d")multmatrix([[-0.9771926031067613,0.16632161768229864,-0.13202929949437328,63.59976792402163],[-0.2123549303252261,-0.7653613423854932,0.6075585561478367,-91.56503375206564],[0,0.621738799716906,0.7832246580174689,474.9461418514677],[0,0,0,1]])cube([27.4,3,3],center=true);
color("#88958d")multmatrix([[-0.9771926031067613,0.16632161768229864,-0.13202929949437328,62.21346027933071],[-0.2123549303252261,-0.7653613423854932,0.6075585561478367,-85.18566891251336],[0,0.621738799716906,0.7832246580174689,483.17000076065113],[0,0,0,1]])cube([27.4,3,3],center=true);
color("#88958d")multmatrix([[0.8839945855497453,0,-0.4674971365888076,-486.33671770035613],[-0.4674971365888076,0,-0.8839945855497453,-140.01404352385012],[0,1.0000000000000002,0,497.7],[0,0,0,1]])cube([3,3,24],center=true);
color("#88958d")multmatrix([[0.8839945855497453,0,-0.4674971365888076,-459.4632822996438],[-0.4674971365888076,0,-0.8839945855497453,-154.2259564761499],[0,1.0000000000000002,0,497.7],[0,0,0,1]])cube([3,3,24],center=true);
color("#88958d")multmatrix([[0.8839945855497453,0,-0.4674971365888076,-477.8087199341825],[-0.4674971365888076,0,-0.8839945855497453,-156.40194314827232],[0,1.0000000000000002,0,497.7],[0,0,0,1]])cube([27.4,3,3],center=true);
color("#88958d")multmatrix([[0.8839945855497453,0,-0.4674971365888076,-467.9912800658175],[-0.4674971365888076,0,-0.8839945855497453,-137.83805685172769],[0,1.0000000000000002,0,497.7],[0,0,0,1]])cube([27.4,3,3],center=true);
color("#88958d")multmatrix([[0.8839945855497453,0,-0.4674971365888076,-472.9],[-0.4674971365888076,0,-0.8839945855497453,-147.12],[0,1.0000000000000002,0,497.7],[0,0,0,1]])cube([27.4,3,3],center=true);
color("#88958d")multmatrix([[-0.8219740153255166,0.4649604932591932,-0.3288927755938325,-82.37140410154828],[-0.5695249934196456,-0.6710600026825942,0.47467858037833255,171.24621790614856],[0,0.5774861145584405,0.8164005067932012,483.2717819365156],[0,0,0,1]])cube([3,3,24],center=true);
color("#88958d")multmatrix([[-0.8219740153255166,0.4649604932591932,-0.3288927755938325,-107.35941416744399],[-0.5695249934196456,-0.6710600026825942,0.47467858037833255,153.93265810619135],[0,0.5774861145584405,0.8164005067932012,483.2717819365156],[0,0,0,1]])cube([3,3,24],center=true);
color("#88958d")multmatrix([[-0.8219740153255166,0.4649604932591932,-0.3288927755938325,-98.31878327823138],[-0.5695249934196456,-0.6710600026825942,0.47467858037833255,167.57356310014245],[0,0.5774861145584405,0.8164005067932012,491.8439872578442],[0,0,0,1]])cube([27.4,3,3],center=true);
color("#88958d")multmatrix([[-0.8219740153255166,0.4649604932591932,-0.3288927755938325,-91.4120349907609],[-0.5695249934196456,-0.6710600026825942,0.47467858037833255,157.60531291219746],[0,0.5774861145584405,0.8164005067932012,474.69957661518697],[0,0,0,1]])cube([27.4,3,3],center=true);
color("#88958d")multmatrix([[-0.8219740153255166,0.4649604932591932,-0.3288927755938325,-94.86540913449613],[-0.5695249934196456,-0.6710600026825942,0.47467858037833255,162.58943800616996],[0,0.5774861145584405,0.8164005067932012,483.2717819365156],[0,0,0,1]])cube([27.4,3,3],center=true);
color("#88958d")multmatrix([[0.9771926031067613,0.16632161768229864,-0.13202929949437328,47.36013271210794],[-0.2123549303252261,0.7653613423854932,-0.6075585561478367,88.4134638534568],[0,0.621738799716906,0.7832246580174689,483.17000076065113],[0,0,0,1]])cube([3,3,24],center=true);
color("#88958d")multmatrix([[0.9771926031067613,0.16632161768229864,-0.13202929949437328,77.06678784655348],[-0.2123549303252261,0.7653613423854932,-0.6075585561478367,81.95787397156992],[0,0.621738799716906,0.7832246580174689,483.17000076065113],[0,0,0,1]])cube([3,3,24],center=true);
color("#88958d")multmatrix([[0.9771926031067613,0.16632161768229864,-0.13202929949437328,60.82715263463979],[-0.2123549303252261,0.7653613423854932,-0.6075585561478367,78.80630407296108],[0,0.621738799716906,0.7832246580174689,491.39385966983457],[0,0,0,1]])cube([27.4,3,3],center=true);
color("#88958d")multmatrix([[0.9771926031067613,0.16632161768229864,-0.13202929949437328,63.59976792402163],[-0.2123549303252261,0.7653613423854932,-0.6075585561478367,91.56503375206564],[0,0.621738799716906,0.7832246580174689,474.9461418514677],[0,0,0,1]])cube([27.4,3,3],center=true);
color("#88958d")multmatrix([[0.9771926031067613,0.16632161768229864,-0.13202929949437328,62.21346027933071],[-0.2123549303252261,0.7653613423854932,-0.6075585561478367,85.18566891251336],[0,0.621738799716906,0.7832246580174689,483.17000076065113],[0,0,0,1]])cube([27.4,3,3],center=true);
color("#88958d")multmatrix([[-0.8839945855497453,0,-0.4674971365888076,-459.4632822996438],[-0.4674971365888076,0,0.8839945855497453,154.2259564761499],[0,1.0000000000000002,0,497.7],[0,0,0,1]])cube([3,3,24],center=true);
color("#88958d")multmatrix([[-0.8839945855497453,0,-0.4674971365888076,-486.33671770035613],[-0.4674971365888076,0,0.8839945855497453,140.01404352385012],[0,1.0000000000000002,0,497.7],[0,0,0,1]])cube([3,3,24],center=true);
color("#88958d")multmatrix([[-0.8839945855497453,0,-0.4674971365888076,-477.8087199341825],[-0.4674971365888076,0,0.8839945855497453,156.40194314827232],[0,1.0000000000000002,0,497.7],[0,0,0,1]])cube([27.4,3,3],center=true);
color("#88958d")multmatrix([[-0.8839945855497453,0,-0.4674971365888076,-467.9912800658175],[-0.4674971365888076,0,0.8839945855497453,137.83805685172769],[0,1.0000000000000002,0,497.7],[0,0,0,1]])cube([27.4,3,3],center=true);
color("#88958d")multmatrix([[-0.8839945855497453,0,-0.4674971365888076,-472.9],[-0.4674971365888076,0,0.8839945855497453,147.12],[0,1.0000000000000002,0,497.7],[0,0,0,1]])cube([27.4,3,3],center=true);
color("#596d5d")multmatrix([[1,0,0,-61.24999999999999],[0,1,0,-145],[0,0,1,432.5],[0,0,0,1]])cube([20,12,1.6],center=true);
color("#596d5d")multmatrix([[1,0,0,0],[0,1,0,-145],[0,0,1,432.5],[0,0,0,1]])cube([20,12,1.6],center=true);
color("#596d5d")multmatrix([[1,0,0,61.24999999999999],[0,1,0,-145],[0,0,1,432.5],[0,0,0,1]])cube([20,12,1.6],center=true);
color("#596d5d")multmatrix([[1,0,0,-432.5],[0,1,0,-66],[0,0,1,394.4],[0,0,0,1]])cube([1.6,12,20],center=true);
color("#596d5d")multmatrix([[1,0,0,-432.5],[0,1,0,-66],[0,0,1,500],[0,0,0,1]])cube([1.6,12,20],center=true);
color("#596d5d")multmatrix([[1,0,0,-61.24999999999999],[0,1,0,145],[0,0,1,432.5],[0,0,0,1]])cube([20,12,1.6],center=true);
color("#596d5d")multmatrix([[1,0,0,0],[0,1,0,145],[0,0,1,432.5],[0,0,0,1]])cube([20,12,1.6],center=true);
color("#596d5d")multmatrix([[1,0,0,61.24999999999999],[0,1,0,145],[0,0,1,432.5],[0,0,0,1]])cube([20,12,1.6],center=true);
color("#596d5d")multmatrix([[1,0,0,-432.5],[0,1,0,66],[0,0,1,394.4],[0,0,0,1]])cube([1.6,12,20],center=true);
color("#596d5d")multmatrix([[1,0,0,-432.5],[0,1,0,66],[0,0,1,500],[0,0,0,1]])cube([1.6,12,20],center=true);
color("#253129")multmatrix([[1,0,0,-410],[0,1,0,-151.2717018579087],[0,0,1,500],[0,0,0,1]])cube([12,33.4,40],center=true);
color("#65796b")multmatrix([[1,0,0,-436.8],[0,1,0,0],[0,0,1,388.5333333333333],[0,0,0,1]])cube([0.4,105.60000000000001,0.6],center=true);
color("#65796b")multmatrix([[1,0,0,-436.8],[0,1,0,0],[0,0,1,408.08888888888885],[0,0,0,1]])cube([0.4,105.60000000000001,0.6],center=true);
color("#65796b")multmatrix([[1,0,0,-436.8],[0,1,0,0],[0,0,1,427.64444444444445],[0,0,0,1]])cube([0.4,105.60000000000001,0.6],center=true);
color("#65796b")multmatrix([[1,0,0,-436.8],[0,1,0,0],[0,0,1,447.2],[0,0,0,1]])cube([0.4,105.60000000000001,0.6],center=true);
color("#65796b")multmatrix([[1,0,0,-436.8],[0,1,0,0],[0,0,1,466.75555555555553],[0,0,0,1]])cube([0.4,105.60000000000001,0.6],center=true);
color("#65796b")multmatrix([[1,0,0,-436.8],[0,1,0,0],[0,0,1,486.31111111111113],[0,0,0,1]])cube([0.4,105.60000000000001,0.6],center=true);
color("#65796b")multmatrix([[1,0,0,-436.8],[0,1,0,0],[0,0,1,505.8666666666667],[0,0,0,1]])cube([0.4,105.60000000000001,0.6],center=true);
}
if(sg_part=="assembly")sg_assembly();else if(sg_part=="rear_pattern")sg_saddle();else if(sg_part=="front_pattern")sg_bib();else if(sg_part=="rear_shell")sg_layer(false,.8);else if(sg_part=="rear_pad")sg_layer(false,5);else if(sg_part=="rear_mesh")sg_layer(false,1.5);else if(sg_part=="front_shell")sg_layer(true,.8);else if(sg_part=="front_pad")sg_layer(true,5);else if(sg_part=="front_mesh")sg_layer(true,1.5);
