stacksjs/buddy-wheels/designs/softgoods/r1/M-r0/softgoods/parts.scad

// Textile revision 1 BENCH ONLY. All mm. Not printable animal support.
sg_part="assembly";
sg_width=230;sg_length=135;sg_drop=55;sg_chest=680;sg_leg_width=50;sg_leg_length=75;
sg_corner=13.5;sg_notch=23;sg_leg_center=56.35;
module sg_roundrect(l,w,r){offset(r=r,$fn=96)square([l-2*r,w-2*r],center=true);}
module sg_capsule(l,w){hull()for(x=[-(l-w)/2,(l-w)/2])translate([x,0])circle(d=w,$fn=96);}
module sg_saddle(){difference(){sg_roundrect(sg_length,sg_width,sg_corner);for(y=[-sg_leg_center,sg_leg_center])translate([0,y])sg_capsule(sg_leg_length,sg_leg_width);hull(){circle(d=sg_notch,$fn=96);translate([sg_length,0])circle(d=sg_notch,$fn=96);}}}
module sg_bib(){sg_roundrect(136,102,13.5);}
module sg_layer(bib,t){linear_extrude(t){if(bib)sg_bib();else sg_saddle();}}

module sg_assembly(){
color("#344039")translate([0,0,329.2])sg_layer(false,0.8);
color("#344c43")translate([0,0,330])sg_layer(false,5);
color("#344c43")translate([0,0,335])sg_layer(false,1.5);
color("#344039")translate([-289.2,0,344.2])rotate([0,-90,0])sg_layer(true,0.8);
color("#344c43")translate([-290,0,344.2])rotate([0,-90,0])sg_layer(true,5);
color("#344c43")translate([-295,0,344.2])rotate([0,-90,0])sg_layer(true,1.5);
color("#303b35")multmatrix([[0.6410136384981981,0.522027989187099,-0.5626617934110822,-77.25],[-0.7675294882017898,0.43597941954087394,-0.46991534394771706,-121],[0,0.7330816627375675,0.6801406293980116,357.5],[0,0,0,1]])cube([20,1.6,80.86562928710813],center=true);
color("#303b35")multmatrix([[-0.9953769786994195,-0.06653059413522681,0.06927012573417989,57.25],[0.09604514706748785,-0.6894988846741689,0.7178903939724097,-73.5],[0,0.7212246308031158,0.6927012573417989,357.5],[0,0,0,1]])cube([20,1.6,79.3993073017643],center=true);
color("#303b35")multmatrix([[0.8506722870958526,0,-0.5256963571940663,-317.5],[-0.5256963571940663,0,-0.8506722870958526,-95.5],[0,1,0,385],[0,0,0,1]])cube([20,1.6,104.62313319720452],center=true);
color("#303b35")multmatrix([[0,0,1,-20],[1,0,0,-140],[0,1,0,399],[0,0,0,1]])cube([20,1.6,160],center=true);
color("#303b35")multmatrix([[-1,0,0,60],[0,0,1,-92.5],[0,1,0,399],[0,0,0,1]])cube([20,1.6,95],center=true);
color("#303b35")multmatrix([[0,0.9532480763823836,0.30218885630228903,-280],[-0.9327463542957253,0.10894913642431256,-0.3436776457967988,-47.07294240436872],[-0.3605332696826097,-0.2818655540247549,0.8891386679850813,441.62327784237175],[0,0,0,1]])cube([20,1.6,66.18377740572065],center=true);
color("#303b35")multmatrix([[-0.6410136384981981,0.522027989187099,-0.5626617934110822,-77.25],[-0.7675294882017898,-0.43597941954087394,0.46991534394771706,121],[0,0.7330816627375675,0.6801406293980116,357.5],[0,0,0,1]])cube([20,1.6,80.86562928710813],center=true);
color("#303b35")multmatrix([[0.9953769786994195,-0.06653059413522681,0.06927012573417989,57.25],[0.09604514706748785,0.6894988846741689,-0.7178903939724097,73.5],[0,0.7212246308031158,0.6927012573417989,357.5],[0,0,0,1]])cube([20,1.6,79.3993073017643],center=true);
color("#303b35")multmatrix([[-0.8506722870958526,0,-0.5256963571940663,-317.5],[-0.5256963571940663,0,0.8506722870958526,95.5],[0,1,0,385],[0,0,0,1]])cube([20,1.6,104.62313319720452],center=true);
color("#303b35")multmatrix([[0,0,1,-20],[1,0,0,140],[0,1,0,399],[0,0,0,1]])cube([20,1.6,160],center=true);
color("#303b35")multmatrix([[1,0,0,60],[0,0,-1,92.5],[0,1,0,399],[0,0,0,1]])cube([20,1.6,95],center=true);
color("#303b35")multmatrix([[0,0.9532480763823835,0.302188856302289,-280],[-0.932746354295725,-0.10894913642431268,0.34367764579679927,47.07294240436873],[0.3605332696826102,-0.28186555402475477,0.8891386679850811,441.62327784237175],[0,0,0,1]])cube([20,1.6,66.18377740572066],center=true);
color("#303b35")multmatrix([[1,0,0,-270],[0,0.9970402198210327,-0.07688172773310209,116.39175697080586],[0,0.07688172773310209,0.9970402198210327,391.4844109757638],[0,0,0,1]])cube([20,1.6,13.007320761699564],center=true);
color("#303b35")multmatrix([[1,0,0,-270],[0,0.9736942286144332,-0.22785861660894843,114.40026173914383],[0,0.22785861660894843,0.9736942286144332,404.3422828576778],[0,0,0,1]])cube([20,1.6,13.091298518261892],center=true);
color("#303b35")multmatrix([[1,0,0,-270],[0,0.9286821551154756,-0.3708766031580797,110.4513463113803],[0,0.3708766031580797,0.9286821551154756,416.86920291720287],[0,0,0,1]])cube([20,1.6,13.252024106374378],center=true);
color("#303b35")multmatrix([[1,0,0,-270],[0,0.8649669556719888,-0.5018288210092483,104.61257772533051],[0,0.5018288210092483,0.8649669556719888,428.8508320790024],[0,0,0,1]])cube([20,1.6,13.47605239762391],center=true);
color("#303b35")multmatrix([[1,0,0,-270],[0,0.7861738613767877,-0.6180053880735276,96.98385893031426],[0,0.6180053880735276,0.7861738613767877,440.0821613461826],[0,0,0,1]])cube([20,1.6,13.745456378550827],center=true);
color("#303b35")multmatrix([[1,0,0,-270],[0,0.6959764213224852,-0.7180646356444151,87.6957194199947],[0,0.7180646356444151,0.6959764213224852,450.3710195610693],[0,0,0,1]])cube([20,1.6,14.039840449902673],center=true);
color("#303b35")multmatrix([[1,0,0,-270],[0,0.5976524451738608,-0.8017552960708806,76.90708183655217],[0,0.8017552960708806,0.5976524451738608,459.5413615069955],[0,0,0,1]])cube([20,1.6,14.338242985180942],center=true);
color("#303b35")multmatrix([[1,0,0,-270],[0,0.493858228970918,-0.8695424369619392,64.80254276021482],[0,0.8695424369619392,0.493858228970918,467.4362800907671],[0,0,0,1]])cube([20,1.6,14.620696313998515],center=true);
color("#303b35")multmatrix([[1,0,0,-270],[0,0.3865845313059657,-0.9222539781182549,51.589214210591045],[0,0.9222539781182549,0.3865845313059657,473.92069106653094],[0,0,0,1]])cube([20,1.6,14.869376030530352],center=true);
color("#303b35")multmatrix([[1,0,0,-270],[0,0.2772268043059903,-0.9608045061167689,37.49317990259166],[0,0.9608045061167689,0.2772268043059903,478.8836443646733],[0,0,0,1]])cube([20,1.6,15.069379179146239],center=true);
color("#303b35")multmatrix([[1,0,0,-270],[0,0.16670947961696675,-0.9860060595178105,22.755626891385617],[0,0.9860060595178105,0.16670947961696675,482.24022247827224],[0,0,0,1]])cube([20,1.6,15.209215458614821],center=true);
color("#303b35")multmatrix([[1,0,0,-270],[0,0.05562568420108624,-0.9984516930012993,7.628718795016269],[0,0.9984516930012993,0.05562568420108624,483.9329934251849],[0,0,0,1]])cube([20,1.6,15.281097420115916],center=true);
color("#303b35")multmatrix([[1,0,0,-270],[0,-0.055625684201082624,-0.9984516930012997,-7.628718795016242],[0,0.9984516930012997,-0.055625684201082624,483.932993425185],[0,0,0,1]])cube([20,1.6,15.281097420115886],center=true);
color("#303b35")multmatrix([[1,0,0,-270],[0,-0.1667094796169698,-0.9860060595178101,-22.755626891385603],[0,0.9860060595178101,-0.1667094796169698,482.24022247827224],[0,0,0,1]])cube([20,1.6,15.209215458614883],center=true);
color("#303b35")multmatrix([[1,0,0,-270],[0,-0.2772268043059908,-0.9608045061167687,-37.49317990259166],[0,0.9608045061167687,-0.2772268043059908,478.8836443646733],[0,0,0,1]])cube([20,1.6,15.069379179146212],center=true);
color("#303b35")multmatrix([[1,0,0,-270],[0,-0.38658453130596626,-0.9222539781182547,-51.589214210591024],[0,0.9222539781182547,-0.38658453130596626,473.92069106653094],[0,0,0,1]])cube([20,1.6,14.869376030530333],center=true);
color("#303b35")multmatrix([[1,0,0,-270],[0,-0.49385822897091697,-0.8695424369619399,-64.8025427602148],[0,0.8695424369619399,-0.49385822897091697,467.4362800907671],[0,0,0,1]])cube([20,1.6,14.620696313998545],center=true);
color("#303b35")multmatrix([[1,0,0,-270],[0,-0.5976524451738587,-0.8017552960708821,-76.90708183655215],[0,0.8017552960708821,-0.5976524451738587,459.5413615069955],[0,0,0,1]])cube([20,1.6,14.338242985180898],center=true);
color("#303b35")multmatrix([[1,0,0,-270],[0,-0.6959764213224872,-0.7180646356444131,-87.69571941999467],[0,0.7180646356444131,-0.6959764213224872,450.3710195610694],[0,0,0,1]])cube([20,1.6,14.039840449902714],center=true);
color("#303b35")multmatrix([[1,0,0,-270],[0,-0.7861738613767871,-0.6180053880735282,-96.98385893031426],[0,0.6180053880735282,-0.7861738613767871,440.0821613461826],[0,0,0,1]])cube([20,1.6,13.745456378550836],center=true);
color("#303b35")multmatrix([[1,0,0,-270],[0,-0.8649669556719876,-0.5018288210092501,-104.61257772533051],[0,0.5018288210092501,-0.8649669556719876,428.85083207900243],[0,0,0,1]])cube([20,1.6,13.476052397623862],center=true);
color("#303b35")multmatrix([[1,0,0,-270],[0,-0.9286821551154765,-0.3708766031580773,-110.45134631138029],[0,0.3708766031580773,-0.9286821551154765,416.8692029172029],[0,0,0,1]])cube([20,1.6,13.252024106374426],center=true);
color("#303b35")multmatrix([[1,0,0,-270],[0,-0.973694228614433,-0.22785861660894946,-114.40026173914382],[0,0.22785861660894946,-0.973694228614433,404.3422828576778],[0,0,0,1]])cube([20,1.6,13.091298518261896],center=true);
color("#303b35")multmatrix([[1,0,0,-270],[0,-0.9970402198210327,-0.07688172773310209,-116.39175697080586],[0,0.07688172773310209,-0.9970402198210327,391.4844109757638],[0,0,0,1]])cube([20,1.6,13.007320761699564],center=true);
color("#303b35")multmatrix([[1,0,0,-270],[0,-0.9970402198210327,0.07688172773310176,-116.39175697080586],[0,-0.07688172773310176,-0.9970402198210327,378.5155890242362],[0,0,0,1]])cube([20,1.6,13.00732076169962],center=true);
color("#303b35")multmatrix([[1,0,0,-270],[0,-0.973694228614433,0.22785861660894932,-114.40026173914384],[0,-0.22785861660894932,-0.973694228614433,365.6577171423222],[0,0,0,1]])cube([20,1.6,13.091298518261778],center=true);
color("#303b35")multmatrix([[1,0,0,-270],[0,-0.9286821551154761,0.3708766031580782,-110.45134631138032],[0,-0.3708766031580782,-0.9286821551154761,353.13079708279713],[0,0,0,1]])cube([20,1.6,13.252024106374432],center=true);
color("#303b35")multmatrix([[1,0,0,-270],[0,-0.8649669556719877,0.5018288210092497,-104.61257772533051],[0,-0.5018288210092497,-0.8649669556719877,341.1491679209976],[0,0,0,1]])cube([20,1.6,13.476052397623926],center=true);
color("#303b35")multmatrix([[1,0,0,-270],[0,-0.7861738613767876,0.6180053880735277,-96.98385893031427],[0,-0.6180053880735277,-0.7861738613767876,329.9178386538174],[0,0,0,1]])cube([20,1.6,13.745456378550756],center=true);
color("#303b35")multmatrix([[1,0,0,-270],[0,-0.6959764213224866,0.7180646356444136,-87.69571941999472],[0,-0.7180646356444136,-0.6959764213224866,319.62898043893074],[0,0,0,1]])cube([20,1.6,14.039840449902725],center=true);
color("#303b35")multmatrix([[1,0,0,-270],[0,-0.5976524451738613,0.8017552960708803,-76.90708183655218],[0,-0.8017552960708803,-0.5976524451738613,310.4586384930045],[0,0,0,1]])cube([20,1.6,14.338242985180932],center=true);
color("#303b35")multmatrix([[1,0,0,-270],[0,-0.49385822897091824,0.8695424369619392,-64.80254276021486],[0,-0.8695424369619392,-0.49385822897091824,302.5637199092329],[0,0,0,1]])cube([20,1.6,14.620696313998508],center=true);
color("#303b35")multmatrix([[1,0,0,-270],[0,-0.386584531305963,0.922253978118256,-51.589214210591095],[0,-0.922253978118256,-0.386584531305963,296.07930893346906],[0,0,0,1]])cube([20,1.6,14.869376030530312],center=true);
color("#303b35")multmatrix([[1,0,0,-270],[0,-0.27722680430599256,0.9608045061167682,-37.493179902591685],[0,-0.9608045061167682,-0.27722680430599256,291.1163556353267],[0,0,0,1]])cube([20,1.6,15.06937917914632],center=true);
color("#303b35")multmatrix([[1,0,0,-270],[0,-0.16670947961696675,0.9860060595178105,-22.755626891385603],[0,-0.9860060595178105,-0.16670947961696675,287.75977752172776],[0,0,0,1]])cube([20,1.6,15.209215458614821],center=true);
color("#303b35")multmatrix([[1,0,0,-270],[0,-0.05562568420108634,0.9984516930012994,-7.628718795016271],[0,-0.9984516930012994,-0.05562568420108634,286.0670065748151],[0,0,0,1]])cube([20,1.6,15.28109742011589],center=true);
color("#303b35")multmatrix([[1,0,0,-270],[0,0.05562568420108262,0.9984516930012997,7.628718795016229],[0,-0.9984516930012997,0.05562568420108262,286.067006574815],[0,0,0,1]])cube([20,1.6,15.281097420115888],center=true);
color("#303b35")multmatrix([[1,0,0,-270],[0,0.16670947961697036,0.9860060595178098,22.755626891385564],[0,-0.9860060595178098,0.16670947961697036,287.75977752172776],[0,0,0,1]])cube([20,1.6,15.209215458614834],center=true);
color("#303b35")multmatrix([[1,0,0,-270],[0,0.277226804305989,0.9608045061167693,37.49317990259165],[0,-0.9608045061167693,0.277226804305989,291.1163556353267],[0,0,0,1]])cube([20,1.6,15.069379179146308],center=true);
color("#303b35")multmatrix([[1,0,0,-270],[0,0.38658453130596626,0.9222539781182547,51.58921421059105],[0,-0.9222539781182547,0.38658453130596626,296.07930893346906],[0,0,0,1]])cube([20,1.6,14.869376030530333],center=true);
color("#303b35")multmatrix([[1,0,0,-270],[0,0.493858228970918,0.8695424369619392,64.80254276021482],[0,-0.8695424369619392,0.493858228970918,302.5637199092329],[0,0,0,1]])cube([20,1.6,14.620696313998515],center=true);
color("#303b35")multmatrix([[1,0,0,-270],[0,0.5976524451738587,0.8017552960708821,76.90708183655215],[0,-0.8017552960708821,0.5976524451738587,310.4586384930045],[0,0,0,1]])cube([20,1.6,14.338242985180898],center=true);
color("#303b35")multmatrix([[1,0,0,-270],[0,0.6959764213224877,0.7180646356444126,87.69571941999467],[0,-0.7180646356444126,0.6959764213224877,319.6289804389306],[0,0,0,1]])cube([20,1.6,14.039840449902703],center=true);
color("#303b35")multmatrix([[1,0,0,-270],[0,0.7861738613767877,0.6180053880735276,96.98385893031423],[0,-0.6180053880735276,0.7861738613767877,329.9178386538174],[0,0,0,1]])cube([20,1.6,13.745456378550827],center=true);
color("#303b35")multmatrix([[1,0,0,-270],[0,0.8649669556719864,0.5018288210092519,104.61257772533048],[0,-0.5018288210092519,0.8649669556719864,341.14916792099757],[0,0,0,1]])cube([20,1.6,13.476052397623814],center=true);
color("#303b35")multmatrix([[1,0,0,-270],[0,0.9286821551154759,0.3708766031580786,110.45134631138029],[0,-0.3708766031580786,0.9286821551154759,353.130797082797],[0,0,0,1]])cube([20,1.6,13.252024106374495],center=true);
color("#303b35")multmatrix([[1,0,0,-270],[0,0.973694228614433,0.2278586166089494,114.40026173914383],[0,-0.2278586166089494,0.973694228614433,365.6577171423222],[0,0,0,1]])cube([20,1.6,13.091298518261837],center=true);
color("#303b35")multmatrix([[1,0,0,-270],[0,0.9970402198210327,0.07688172773310176,116.39175697080586],[0,-0.07688172773310176,0.9970402198210327,378.5155890242362],[0,0,0,1]])cube([20,1.6,13.00732076169962],center=true);
color("#303b35")multmatrix([[0,0,1,0],[1,0,0,-102],[0,1,0,329],[0,0,0,1]])cube([20,1.6,109],center=true);
color("#303b35")multmatrix([[1,0,0,54.5],[0,0,-1,-58.25],[0,1,0,329],[0,0,0,1]])cube([20,1.6,87.5],center=true);
color("#303b35")multmatrix([[0,0,1,0],[1,0,0,102],[0,1,0,329],[0,0,0,1]])cube([20,1.6,109],center=true);
color("#303b35")multmatrix([[-1,0,0,54.5],[0,0,1,58.25],[0,1,0,329],[0,0,0,1]])cube([20,1.6,87.5],center=true);
color("#303b35")multmatrix([[-1,0,0,-54.5],[0,0,1,0],[0,1,0,329],[0,0,0,1]])cube([20,1.6,204],center=true);
color("#303b35")multmatrix([[1,0,0,-100],[0,1,0,-140],[0,0,1,371],[0,0,0,1]])cube([20,28,1.6],center=true);
color("#303b35")multmatrix([[1,0,0,-100],[0,1,0,-126],[0,0,1,385],[0,0,0,1]])cube([20,1.6,28],center=true);
color("#303b35")multmatrix([[1,0,0,-100],[0,1,0,-140],[0,0,1,399],[0,0,0,1]])cube([20,28,1.6],center=true);
color("#303b35")multmatrix([[1,0,0,-100],[0,1,0,-154],[0,0,1,385],[0,0,0,1]])cube([20,1.6,28],center=true);
color("#303b35")multmatrix([[1,0,0,60],[0,1,0,-45],[0,0,1,366],[0,0,0,1]])cube([34,20,1.6],center=true);
color("#303b35")multmatrix([[1,0,0,77],[0,1,0,-45],[0,0,1,385],[0,0,0,1]])cube([1.6,20,38],center=true);
color("#303b35")multmatrix([[1,0,0,60],[0,1,0,-45],[0,0,1,404],[0,0,0,1]])cube([34,20,1.6],center=true);
color("#303b35")multmatrix([[1,0,0,43],[0,1,0,-45],[0,0,1,385],[0,0,0,1]])cube([1.6,20,38],center=true);
color("#303b35")multmatrix([[1,0,0,-345],[0,1,0,-140],[0,0,1,371],[0,0,0,1]])cube([20,28,1.6],center=true);
color("#303b35")multmatrix([[1,0,0,-345],[0,1,0,-126],[0,0,1,385],[0,0,0,1]])cube([20,1.6,28],center=true);
color("#303b35")multmatrix([[1,0,0,-345],[0,1,0,-140],[0,0,1,399],[0,0,0,1]])cube([20,28,1.6],center=true);
color("#303b35")multmatrix([[1,0,0,-345],[0,1,0,-154],[0,0,1,385],[0,0,0,1]])cube([20,1.6,28],center=true);
color("#303b35")multmatrix([[1,0,0,-100],[0,1,0,140],[0,0,1,371],[0,0,0,1]])cube([20,28,1.6],center=true);
color("#303b35")multmatrix([[1,0,0,-100],[0,1,0,154],[0,0,1,385],[0,0,0,1]])cube([20,1.6,28],center=true);
color("#303b35")multmatrix([[1,0,0,-100],[0,1,0,140],[0,0,1,399],[0,0,0,1]])cube([20,28,1.6],center=true);
color("#303b35")multmatrix([[1,0,0,-100],[0,1,0,126],[0,0,1,385],[0,0,0,1]])cube([20,1.6,28],center=true);
color("#303b35")multmatrix([[1,0,0,60],[0,1,0,45],[0,0,1,366],[0,0,0,1]])cube([34,20,1.6],center=true);
color("#303b35")multmatrix([[1,0,0,77],[0,1,0,45],[0,0,1,385],[0,0,0,1]])cube([1.6,20,38],center=true);
color("#303b35")multmatrix([[1,0,0,60],[0,1,0,45],[0,0,1,404],[0,0,0,1]])cube([34,20,1.6],center=true);
color("#303b35")multmatrix([[1,0,0,43],[0,1,0,45],[0,0,1,385],[0,0,0,1]])cube([1.6,20,38],center=true);
color("#303b35")multmatrix([[1,0,0,-345],[0,1,0,140],[0,0,1,371],[0,0,0,1]])cube([20,28,1.6],center=true);
color("#303b35")multmatrix([[1,0,0,-345],[0,1,0,154],[0,0,1,385],[0,0,0,1]])cube([20,1.6,28],center=true);
color("#303b35")multmatrix([[1,0,0,-345],[0,1,0,140],[0,0,1,399],[0,0,0,1]])cube([20,28,1.6],center=true);
color("#303b35")multmatrix([[1,0,0,-345],[0,1,0,126],[0,0,1,385],[0,0,0,1]])cube([20,1.6,28],center=true);
color("#88958d")multmatrix([[0.6410136384981981,0.522027989187099,-0.5626617934110822,-99.20333485635781],[-0.7675294882017898,0.43597941954087394,-0.46991534394771706,-123.04863406242163],[0,0.7330816627375675,0.6801406293980116,371.21391217570357],[0,0,0,1]])cube([3,3,24],center=true);
color("#88958d")multmatrix([[0.6410136384981981,0.522027989187099,-0.5626617934110822,-83.17799389390287],[-0.7675294882017898,0.43597941954087394,-0.46991534394771706,-142.23687126746637],[0,0.7330816627375675,0.6801406293980116,371.21391217570357],[0,0,0,1]])cube([3,3,24],center=true);
color("#88958d")multmatrix([[0.6410136384981981,0.522027989187099,-0.5626617934110822,-97.0986132059467],[-0.7675294882017898,0.43597941954087394,-0.46991534394771706,-137.57686377639502],[0,0.7330816627375675,0.6801406293980116,378.3553887843827],[0,0,0,1]])cube([22,3,3],center=true);
color("#88958d")multmatrix([[0.6410136384981981,0.522027989187099,-0.5626617934110822,-85.28271554431397],[-0.7675294882017898,0.43597941954087394,-0.46991534394771706,-127.70864155349297],[0,0.7330816627375675,0.6801406293980116,364.07243556702446],[0,0,0,1]])cube([22,3,3],center=true);
color("#88958d")multmatrix([[0.6410136384981981,0.522027989187099,-0.5626617934110822,-91.19066437513034],[-0.7675294882017898,0.43597941954087394,-0.46991534394771706,-132.642752664944],[0,0.7330816627375675,0.6801406293980116,371.21391217570357],[0,0,0,1]])cube([22,3,3],center=true);
color("#88958d")multmatrix([[-0.9953769786994195,-0.06653059413522681,0.06927012573417989,71.38523260025377],[0.09604514706748785,-0.6894988846741689,0.7178903939724097,-57.15471690359301],[0,0.7212246308031158,0.6927012573417989,371.24118334915283],[0,0,0,1]])cube([3,3,24],center=true);
color("#88958d")multmatrix([[-0.9953769786994195,-0.06653059413522681,0.06927012573417989,46.50080813276828],[0.09604514706748785,-0.6894988846741689,0.7178903939724097,-54.75358822690581],[0,0.7212246308031158,0.6927012573417989,371.24118334915283],[0,0,0,1]])cube([3,3,24],center=true);
color("#88958d")multmatrix([[-0.9953769786994195,-0.06653059413522681,0.06927012573417989,59.67035668671991],[0.09604514706748785,-0.6894988846741689,0.7178903939724097,-48.41630342853911],[0,0.7212246308031158,0.6927012573417989,378.5145465512417],[0,0,0,1]])cube([22,3,3],center=true);
color("#88958d")multmatrix([[-0.9953769786994195,-0.06653059413522681,0.06927012573417989,58.21568404630213],[0.09604514706748785,-0.6894988846741689,0.7178903939724097,-63.492001701959715],[0,0.7212246308031158,0.6927012573417989,363.96782014706395],[0,0,0,1]])cube([22,3,3],center=true);
color("#88958d")multmatrix([[-0.9953769786994195,-0.06653059413522681,0.06927012573417989,58.94302036651102],[0.09604514706748785,-0.6894988846741689,0.7178903939724097,-55.95415256524941],[0,0.7212246308031158,0.6927012573417989,371.24118334915283],[0,0,0,1]])cube([22,3,3],center=true);
color("#88958d")multmatrix([[0.8506722870958526,0,-0.5256963571940663,-343.53340358869815],[-0.5256963571940663,0,-0.8506722870958526,-113.84879553507417],[0,1,0,382.7],[0,0,0,1]])cube([3,3,24],center=true);
color("#88958d")multmatrix([[0.8506722870958526,0,-0.5256963571940663,-322.2665964113018],[-0.5256963571940663,0,-0.8506722870958526,-126.99120446492583],[0,1,0,382.7],[0,0,0,1]])cube([3,3,24],center=true);
color("#88958d")multmatrix([[0.8506722870958526,0,-0.5256963571940663,-338.4198117505377],[-0.5256963571940663,0,-0.8506722870958526,-129.35205901450647],[0,1,0,382.7],[0,0,0,1]])cube([22,3,3],center=true);
color("#88958d")multmatrix([[0.8506722870958526,0,-0.5256963571940663,-327.38018824946226],[-0.5256963571940663,0,-0.8506722870958526,-111.48794098549355],[0,1,0,382.7],[0,0,0,1]])cube([22,3,3],center=true);
color("#88958d")multmatrix([[0.8506722870958526,0,-0.5256963571940663,-332.9],[-0.5256963571940663,0,-0.8506722870958526,-120.42],[0,1,0,382.7],[0,0,0,1]])cube([22,3,3],center=true);
color("#88958d")multmatrix([[-0.6410136384981981,0.522027989187099,-0.5626617934110822,-83.17799389390287],[-0.7675294882017898,-0.43597941954087394,0.46991534394771706,142.23687126746637],[0,0.7330816627375675,0.6801406293980116,371.21391217570357],[0,0,0,1]])cube([3,3,24],center=true);
color("#88958d")multmatrix([[-0.6410136384981981,0.522027989187099,-0.5626617934110822,-99.20333485635781],[-0.7675294882017898,-0.43597941954087394,0.46991534394771706,123.04863406242163],[0,0.7330816627375675,0.6801406293980116,371.21391217570357],[0,0,0,1]])cube([3,3,24],center=true);
color("#88958d")multmatrix([[-0.6410136384981981,0.522027989187099,-0.5626617934110822,-97.0986132059467],[-0.7675294882017898,-0.43597941954087394,0.46991534394771706,137.57686377639502],[0,0.7330816627375675,0.6801406293980116,378.3553887843827],[0,0,0,1]])cube([22,3,3],center=true);
color("#88958d")multmatrix([[-0.6410136384981981,0.522027989187099,-0.5626617934110822,-85.28271554431397],[-0.7675294882017898,-0.43597941954087394,0.46991534394771706,127.70864155349297],[0,0.7330816627375675,0.6801406293980116,364.07243556702446],[0,0,0,1]])cube([22,3,3],center=true);
color("#88958d")multmatrix([[-0.6410136384981981,0.522027989187099,-0.5626617934110822,-91.19066437513034],[-0.7675294882017898,-0.43597941954087394,0.46991534394771706,132.642752664944],[0,0.7330816627375675,0.6801406293980116,371.21391217570357],[0,0,0,1]])cube([22,3,3],center=true);
color("#88958d")multmatrix([[0.9953769786994195,-0.06653059413522681,0.06927012573417989,46.50080813276828],[0.09604514706748785,0.6894988846741689,-0.7178903939724097,54.75358822690581],[0,0.7212246308031158,0.6927012573417989,371.24118334915283],[0,0,0,1]])cube([3,3,24],center=true);
color("#88958d")multmatrix([[0.9953769786994195,-0.06653059413522681,0.06927012573417989,71.38523260025377],[0.09604514706748785,0.6894988846741689,-0.7178903939724097,57.15471690359301],[0,0.7212246308031158,0.6927012573417989,371.24118334915283],[0,0,0,1]])cube([3,3,24],center=true);
color("#88958d")multmatrix([[0.9953769786994195,-0.06653059413522681,0.06927012573417989,59.67035668671991],[0.09604514706748785,0.6894988846741689,-0.7178903939724097,48.41630342853911],[0,0.7212246308031158,0.6927012573417989,378.5145465512417],[0,0,0,1]])cube([22,3,3],center=true);
color("#88958d")multmatrix([[0.9953769786994195,-0.06653059413522681,0.06927012573417989,58.21568404630213],[0.09604514706748785,0.6894988846741689,-0.7178903939724097,63.492001701959715],[0,0.7212246308031158,0.6927012573417989,363.96782014706395],[0,0,0,1]])cube([22,3,3],center=true);
color("#88958d")multmatrix([[0.9953769786994195,-0.06653059413522681,0.06927012573417989,58.94302036651102],[0.09604514706748785,0.6894988846741689,-0.7178903939724097,55.95415256524941],[0,0.7212246308031158,0.6927012573417989,371.24118334915283],[0,0,0,1]])cube([22,3,3],center=true);
color("#88958d")multmatrix([[-0.8506722870958526,0,-0.5256963571940663,-322.2665964113018],[-0.5256963571940663,0,0.8506722870958526,126.99120446492583],[0,1,0,382.7],[0,0,0,1]])cube([3,3,24],center=true);
color("#88958d")multmatrix([[-0.8506722870958526,0,-0.5256963571940663,-343.53340358869815],[-0.5256963571940663,0,0.8506722870958526,113.84879553507417],[0,1,0,382.7],[0,0,0,1]])cube([3,3,24],center=true);
color("#88958d")multmatrix([[-0.8506722870958526,0,-0.5256963571940663,-338.4198117505377],[-0.5256963571940663,0,0.8506722870958526,129.35205901450647],[0,1,0,382.7],[0,0,0,1]])cube([22,3,3],center=true);
color("#88958d")multmatrix([[-0.8506722870958526,0,-0.5256963571940663,-327.38018824946226],[-0.5256963571940663,0,0.8506722870958526,111.48794098549355],[0,1,0,382.7],[0,0,0,1]])cube([22,3,3],center=true);
color("#88958d")multmatrix([[-0.8506722870958526,0,-0.5256963571940663,-332.9],[-0.5256963571940663,0,0.8506722870958526,120.42],[0,1,0,382.7],[0,0,0,1]])cube([22,3,3],center=true);
color("#596d5d")multmatrix([[1,0,0,-47.25],[0,1,0,-115],[0,0,1,332.5],[0,0,0,1]])cube([20,12,1.6],center=true);
color("#596d5d")multmatrix([[1,0,0,0],[0,1,0,-115],[0,0,1,332.5],[0,0,0,1]])cube([20,12,1.6],center=true);
color("#596d5d")multmatrix([[1,0,0,47.25],[0,1,0,-115],[0,0,1,332.5],[0,0,0,1]])cube([20,12,1.6],center=true);
color("#596d5d")multmatrix([[1,0,0,-292.5],[0,1,0,-51],[0,0,1,303.4],[0,0,0,1]])cube([1.6,12,20],center=true);
color("#596d5d")multmatrix([[1,0,0,-292.5],[0,1,0,-51],[0,0,1,385],[0,0,0,1]])cube([1.6,12,20],center=true);
color("#596d5d")multmatrix([[1,0,0,-47.25],[0,1,0,115],[0,0,1,332.5],[0,0,0,1]])cube([20,12,1.6],center=true);
color("#596d5d")multmatrix([[1,0,0,0],[0,1,0,115],[0,0,1,332.5],[0,0,0,1]])cube([20,12,1.6],center=true);
color("#596d5d")multmatrix([[1,0,0,47.25],[0,1,0,115],[0,0,1,332.5],[0,0,0,1]])cube([20,12,1.6],center=true);
color("#596d5d")multmatrix([[1,0,0,-292.5],[0,1,0,51],[0,0,1,303.4],[0,0,0,1]])cube([1.6,12,20],center=true);
color("#596d5d")multmatrix([[1,0,0,-292.5],[0,1,0,51],[0,0,1,385],[0,0,0,1]])cube([1.6,12,20],center=true);
color("#253129")multmatrix([[1,0,0,-270],[0,1,0,-116.8917696174749],[0,0,1,385],[0,0,0,1]])cube([12,28,40],center=true);
color("#65796b")multmatrix([[1,0,0,-296.8],[0,1,0,0],[0,0,1,298.8666666666667],[0,0,0,1]])cube([0.4,81.60000000000001,0.6],center=true);
color("#65796b")multmatrix([[1,0,0,-296.8],[0,1,0,0],[0,0,1,313.97777777777776],[0,0,0,1]])cube([0.4,81.60000000000001,0.6],center=true);
color("#65796b")multmatrix([[1,0,0,-296.8],[0,1,0,0],[0,0,1,329.0888888888889],[0,0,0,1]])cube([0.4,81.60000000000001,0.6],center=true);
color("#65796b")multmatrix([[1,0,0,-296.8],[0,1,0,0],[0,0,1,344.2],[0,0,0,1]])cube([0.4,81.60000000000001,0.6],center=true);
color("#65796b")multmatrix([[1,0,0,-296.8],[0,1,0,0],[0,0,1,359.3111111111111],[0,0,0,1]])cube([0.4,81.60000000000001,0.6],center=true);
color("#65796b")multmatrix([[1,0,0,-296.8],[0,1,0,0],[0,0,1,374.4222222222222],[0,0,0,1]])cube([0.4,81.60000000000001,0.6],center=true);
color("#65796b")multmatrix([[1,0,0,-296.8],[0,1,0,0],[0,0,1,389.5333333333333],[0,0,0,1]])cube([0.4,81.60000000000001,0.6],center=true);
}
if(sg_part=="assembly")sg_assembly();else if(sg_part=="rear_pattern")sg_saddle();else if(sg_part=="front_pattern")sg_bib();else if(sg_part=="rear_shell")sg_layer(false,.8);else if(sg_part=="rear_pad")sg_layer(false,5);else if(sg_part=="rear_mesh")sg_layer(false,1.5);else if(sg_part=="front_shell")sg_layer(true,.8);else if(sg_part=="front_pad")sg_layer(true,5);else if(sg_part=="front_mesh")sg_layer(true,1.5);
