stacksjs/buddy-wheels/designs/softgoods/r1/S-r0/softgoods/parts.scad

// Textile revision 1 BENCH ONLY. All mm. Not printable animal support.
sg_part="assembly";
sg_width=165;sg_length=95;sg_drop=40;sg_chest=485;sg_leg_width=35;sg_leg_length=50;
sg_corner=9.5;sg_notch=16.5;sg_leg_center=40.425;
module sg_roundrect(l,w,r){offset(r=r,$fn=96)square([l-2*r,w-2*r],center=true);}
module sg_capsule(l,w){hull()for(x=[-(l-w)/2,(l-w)/2])translate([x,0])circle(d=w,$fn=96);}
module sg_saddle(){difference(){sg_roundrect(sg_length,sg_width,sg_corner);for(y=[-sg_leg_center,sg_leg_center])translate([0,y])sg_capsule(sg_leg_length,sg_leg_width);hull(){circle(d=sg_notch,$fn=96);translate([sg_length,0])circle(d=sg_notch,$fn=96);}}}
module sg_bib(){sg_roundrect(97,72.75,9.5);}
module sg_layer(bib,t){linear_extrude(t){if(bib)sg_bib();else sg_saddle();}}

module sg_assembly(){
color("#344039")translate([0,0,259.2])sg_layer(false,0.8);
color("#344c43")translate([0,0,260])sg_layer(false,5);
color("#344c43")translate([0,0,265])sg_layer(false,1.5);
color("#344039")translate([-191.2,0,270.9])rotate([0,-90,0])sg_layer(true,0.8);
color("#344c43")translate([-192,0,270.9])rotate([0,-90,0])sg_layer(true,5);
color("#344c43")translate([-197,0,270.9])rotate([0,-90,0])sg_layer(true,1.5);
color("#303b35")multmatrix([[0.4640069946705576,0.43424940580916244,-0.7720912915265827,-68.5],[-0.8858315352801555,0.22746397447146605,-0.4044287717520195,-88.5],[0,0.8716005930883903,0.49021669303275095,280],[0,0,0,1]])cube([15,1.6,81.59656855530139],center=true);
color("#303b35")multmatrix([[-0.9366417498002272,-0.18224119736115119,0.29914942506303166,48.5],[0.3502887844781338,-0.4872971146830782,0.7998995496250629,-41.25],[0,0.8540080023078946,0.5202598696748377,280],[0,0,0,1]])cube([15,1.6,76.8846538653846],center=true);
color("#303b35")multmatrix([[0.9012154381052687,0,-0.4333713582145554,-208.5],[-0.4333713582145554,0,-0.9012154381052687,-70.6875],[0,1,0,300],[0,0,0,1]])cube([15,1.6,76.1471642610544],center=true);
color("#303b35")multmatrix([[0,0,1,-20],[1,0,0,-105],[0,1,0,313],[0,0,0,1]])cube([15,1.6,160],center=true);
color("#303b35")multmatrix([[-1,0,0,60],[0,0,1,-57.75],[0,1,0,313],[0,0,0,1]])cube([15,1.6,94.5],center=true);
color("#303b35")multmatrix([[0,0.9138038434283484,0.40615580229214815,-182],[-0.9327463542957254,0.14643267940095167,-0.32945668751975776,-33.57408392076298],[-0.3605332696826095,-0.37884034386405663,0.8523472034992138,340.3857202258093],[0,0,0,1]])cube([15,1.6,49.242187079760065],center=true);
color("#303b35")multmatrix([[-0.4640069946705576,0.43424940580916244,-0.7720912915265827,-68.5],[-0.8858315352801555,-0.22746397447146605,0.4044287717520195,88.5],[0,0.8716005930883903,0.49021669303275095,280],[0,0,0,1]])cube([15,1.6,81.59656855530139],center=true);
color("#303b35")multmatrix([[0.9366417498002272,-0.18224119736115119,0.29914942506303166,48.5],[0.3502887844781338,0.4872971146830782,-0.7998995496250629,41.25],[0,0.8540080023078946,0.5202598696748377,280],[0,0,0,1]])cube([15,1.6,76.8846538653846],center=true);
color("#303b35")multmatrix([[-0.9012154381052687,0,-0.4333713582145554,-208.5],[-0.4333713582145554,0,0.9012154381052687,70.6875],[0,1,0,300],[0,0,0,1]])cube([15,1.6,76.1471642610544],center=true);
color("#303b35")multmatrix([[0,0,1,-20],[1,0,0,105],[0,1,0,313],[0,0,0,1]])cube([15,1.6,160],center=true);
color("#303b35")multmatrix([[1,0,0,60],[0,0,-1,57.75],[0,1,0,313],[0,0,0,1]])cube([15,1.6,94.5],center=true);
color("#303b35")multmatrix([[0,0.9138038434283483,0.4061558022921481,-182],[-0.9327463542957252,-0.1464326794009518,0.32945668751975815,33.57408392076299],[0.3605332696826099,-0.37884034386405646,0.8523472034992136,340.3857202258093],[0,0,0,1]])cube([15,1.6,49.24218707976007],center=true);
color("#303b35")multmatrix([[1,0,0,-172],[0,0.9970402198210326,-0.07688172773310277,83.0147090159424],[0,0.07688172773310277,0.9970402198210326,304.6249107694786],[0,0,0,1]])cube([15,1.6,9.277280249153405],center=true);
color("#303b35")multmatrix([[1,0,0,-172],[0,0.9736942286144331,-0.22785861660894874,81.59430432865405],[0,0.22785861660894874,0.9736942286144331,313.79559880290253],[0,0,0,1]])cube([15,1.6,9.337176149054386],center=true);
color("#303b35")multmatrix([[1,0,0,-172],[0,0.928682155115476,-0.3708766031580788,78.77779847208743],[0,0.3708766031580788,0.928682155115476,322.73024031594616],[0,0,0,1]])cube([15,1.6,9.451811311164114],center=true);
color("#303b35")multmatrix([[1,0,0,-172],[0,0.8649669556719881,-0.5018288210092489,74.61338264233132],[0,0.5018288210092489,0.8649669556719881,331.27596111517084],[0,0,0,1]])cube([15,1.6,9.611596195364076],center=true);
color("#303b35")multmatrix([[1,0,0,-172],[0,0.7861738613767875,-0.6180053880735279,69.17231114882708],[0,0.6180053880735279,0.7861738613767875,339.2865415483802],[0,0,0,1]])cube([15,1.6,9.803744622936998],center=true);
color("#303b35")multmatrix([[1,0,0,-172],[0,0.6959764213224862,-0.718064635644414,62.547682233378566],[0,0.718064635644414,0.6959764213224862,346.62491836340973],[0,0,0,1]])cube([15,1.6,10.013709732651174],center=true);
color("#303b35")multmatrix([[1,0,0,-172],[0,0.5976524451738613,-0.8017552960708803,54.85284513342324],[0,0.8017552960708803,0.5976524451738613,353.1655298983718],[0,0,0,1]])cube([15,1.6,10.226540952665834],center=true);
color("#303b35")multmatrix([[1,0,0,-172],[0,0.49385822897091725,-0.8695424369619399,46.21946064515322],[0,0.8695424369619399,0.49385822897091725,358.79646447650305],[0,0,0,1]])cube([15,1.6,10.427996635719524],center=true);
color("#303b35")multmatrix([[1,0,0,-172],[0,0.38658453130596193,-0.9222539781182567,36.795248370789196],[0,0.9222539781182567,0.38658453130596193,363.4213752459816],[0,0,0,1]])cube([15,1.6,10.605363786481186],center=true);
color("#303b35")multmatrix([[1,0,0,-172],[0,0.2772268043059945,-0.9608045061167676,26.741459195230817],[0,0.9608045061167676,0.2772268043059945,366.96112870127433],[0,0,0,1]])cube([15,1.6,10.748013091008726],center=true);
color("#303b35")multmatrix([[1,0,0,-172],[0,0.1667094796169675,-0.9860060595178104,16.23011623870886],[0,0.9860060595178104,0.1667094796169675,369.35515867935595],[0,0,0,1]])cube([15,1.6,10.847749260923807],center=true);
color("#303b35")multmatrix([[1,0,0,-172],[0,0.0556256842010859,-0.9984516930012994,5.441071493504251],[0,0.9984516930012994,0.0556256842010859,370.5625026635511],[0,0,0,1]])cube([15,1.6,10.899018012876791],center=true);
color("#303b35")multmatrix([[1,0,0,-172],[0,-0.05562568420108599,-0.9984516930012994,-5.441071493504231],[0,0.9984516930012994,-0.05562568420108599,370.5625026635511],[0,0,0,1]])cube([15,1.6,10.899018012876773],center=true);
color("#303b35")multmatrix([[1,0,0,-172],[0,-0.16670947961696694,-0.9860060595178106,-16.23011623870885],[0,0.9860060595178106,-0.16670947961696694,369.35515867935595],[0,0,0,1]])cube([15,1.6,10.847749260923845],center=true);
color("#303b35")multmatrix([[1,0,0,-172],[0,-0.27722680430599494,-0.9608045061167676,-26.741459195230817],[0,0.9608045061167676,-0.27722680430599494,366.96112870127433],[0,0,0,1]])cube([15,1.6,10.748013091008708],center=true);
color("#303b35")multmatrix([[1,0,0,-172],[0,-0.3865845313059624,-0.9222539781182565,-36.79524837078918],[0,0.9222539781182565,-0.3865845313059624,363.4213752459816],[0,0,0,1]])cube([15,1.6,10.605363786481174],center=true);
color("#303b35")multmatrix([[1,0,0,-172],[0,-0.49385822897091636,-0.8695424369619402,-46.219460645153205],[0,0.8695424369619402,-0.49385822897091636,358.79646447650305],[0,0,0,1]])cube([15,1.6,10.427996635719543],center=true);
color("#303b35")multmatrix([[1,0,0,-172],[0,-0.5976524451738618,-0.8017552960708797,-54.85284513342323],[0,0.8017552960708797,-0.5976524451738618,353.1655298983718],[0,0,0,1]])cube([15,1.6,10.226540952665824],center=true);
color("#303b35")multmatrix([[1,0,0,-172],[0,-0.6959764213224862,-0.718064635644414,-62.54768223337855],[0,0.718064635644414,-0.6959764213224862,346.62491836340973],[0,0,0,1]])cube([15,1.6,10.013709732651174],center=true);
color("#303b35")multmatrix([[1,0,0,-172],[0,-0.7861738613767867,-0.6180053880735288,-69.17231114882708],[0,0.6180053880735288,-0.7861738613767867,339.2865415483802],[0,0,0,1]])cube([15,1.6,9.803744622937007],center=true);
color("#303b35")multmatrix([[1,0,0,-172],[0,-0.8649669556719881,-0.5018288210092489,-74.61338264233132],[0,0.5018288210092489,-0.8649669556719881,331.27596111517084],[0,0,0,1]])cube([15,1.6,9.611596195364076],center=true);
color("#303b35")multmatrix([[1,0,0,-172],[0,-0.9286821551154766,-0.37087660315807747,-78.77779847208741],[0,0.37087660315807747,-0.9286821551154766,322.73024031594616],[0,0,0,1]])cube([15,1.6,9.451811311164109],center=true);
color("#303b35")multmatrix([[1,0,0,-172],[0,-0.9736942286144328,-0.22785861660895018,-81.59430432865403],[0,0.22785861660895018,-0.9736942286144328,313.79559880290253],[0,0,0,1]])cube([15,1.6,9.33717614905439],center=true);
color("#303b35")multmatrix([[1,0,0,-172],[0,-0.9970402198210326,-0.07688172773310277,-83.0147090159424],[0,0.07688172773310277,-0.9970402198210326,304.6249107694786],[0,0,0,1]])cube([15,1.6,9.277280249153405],center=true);
color("#303b35")multmatrix([[1,0,0,-172],[0,-0.9970402198210326,0.07688172773310277,-83.0147090159424],[0,-0.07688172773310277,-0.9970402198210326,295.3750892305214],[0,0,0,1]])cube([15,1.6,9.277280249153405],center=true);
color("#303b35")multmatrix([[1,0,0,-172],[0,-0.9736942286144331,0.22785861660894874,-81.59430432865405],[0,-0.22785861660894874,-0.9736942286144331,286.20440119709747],[0,0,0,1]])cube([15,1.6,9.337176149054386],center=true);
color("#303b35")multmatrix([[1,0,0,-172],[0,-0.9286821551154766,0.37087660315807747,-78.77779847208743],[0,-0.37087660315807747,-0.9286821551154766,277.26975968405384],[0,0,0,1]])cube([15,1.6,9.451811311164109],center=true);
color("#303b35")multmatrix([[1,0,0,-172],[0,-0.8649669556719868,0.5018288210092511,-74.61338264233132],[0,-0.5018288210092511,-0.8649669556719868,268.72403888482916],[0,0,0,1]])cube([15,1.6,9.61159619536409],center=true);
color("#303b35")multmatrix([[1,0,0,-172],[0,-0.7861738613767889,0.6180053880735261,-69.17231114882708],[0,-0.6180053880735261,-0.7861738613767889,260.7134584516198],[0,0,0,1]])cube([15,1.6,9.80374462293698],center=true);
color("#303b35")multmatrix([[1,0,0,-172],[0,-0.6959764213224875,0.718064635644413,-62.54768223337858],[0,-0.718064635644413,-0.6959764213224875,253.37508163659027],[0,0,0,1]])cube([15,1.6,10.013709732651197],center=true);
color("#303b35")multmatrix([[1,0,0,-172],[0,-0.5976524451738583,0.8017552960708824,-54.85284513342325],[0,-0.8017552960708824,-0.5976524451738583,246.83447010162823],[0,0,0,1]])cube([15,1.6,10.22654095266579],center=true);
color("#303b35")multmatrix([[1,0,0,-172],[0,-0.4938582289709196,0.8695424369619384,-46.21946064515324],[0,-0.8695424369619384,-0.4938582289709196,241.203535523497],[0,0,0,1]])cube([15,1.6,10.427996635719532],center=true);
color("#303b35")multmatrix([[1,0,0,-172],[0,-0.3865845313059624,0.9222539781182565,-36.79524837078923],[0,-0.9222539781182565,-0.3865845313059624,236.5786247540184],[0,0,0,1]])cube([15,1.6,10.605363786481174],center=true);
color("#303b35")multmatrix([[1,0,0,-172],[0,-0.2772268043059933,0.9608045061167682,-26.74145919523083],[0,-0.9608045061167682,-0.2772268043059933,233.0388712987257],[0,0,0,1]])cube([15,1.6,10.748013091008772],center=true);
color("#303b35")multmatrix([[1,0,0,-172],[0,-0.1667094796169675,0.9860060595178104,-16.230116238708852],[0,-0.9860060595178104,-0.1667094796169675,230.64484132064405],[0,0,0,1]])cube([15,1.6,10.847749260923807],center=true);
color("#303b35")multmatrix([[1,0,0,-172],[0,-0.05562568420108599,0.9984516930012994,-5.441071493504253],[0,-0.9984516930012994,-0.05562568420108599,229.43749733644896],[0,0,0,1]])cube([15,1.6,10.899018012876773],center=true);
color("#303b35")multmatrix([[1,0,0,-172],[0,0.05562568420108598,0.9984516930012994,5.441071493504222],[0,-0.9984516930012994,0.05562568420108598,229.43749733644896],[0,0,0,1]])cube([15,1.6,10.899018012876775],center=true);
color("#303b35")multmatrix([[1,0,0,-172],[0,0.16670947961696747,0.9860060595178104,16.23011623870882],[0,-0.9860060595178104,0.16670947961696747,230.64484132064405],[0,0,0,1]])cube([15,1.6,10.847749260923809],center=true);
color("#303b35")multmatrix([[1,0,0,-172],[0,0.2772268043059933,0.9608045061167682,26.741459195230803],[0,-0.9608045061167682,0.2772268043059933,233.0388712987257],[0,0,0,1]])cube([15,1.6,10.748013091008772],center=true);
color("#303b35")multmatrix([[1,0,0,-172],[0,0.3865845313059624,0.9222539781182565,36.7952483707892],[0,-0.9222539781182565,0.3865845313059624,236.5786247540184],[0,0,0,1]])cube([15,1.6,10.605363786481174],center=true);
color("#303b35")multmatrix([[1,0,0,-172],[0,0.49385822897091725,0.8695424369619399,46.21946064515322],[0,-0.8695424369619399,0.49385822897091725,241.20353552349698],[0,0,0,1]])cube([15,1.6,10.427996635719524],center=true);
color("#303b35")multmatrix([[1,0,0,-172],[0,0.5976524451738605,0.8017552960708808,54.85284513342323],[0,-0.8017552960708808,0.5976524451738605,246.8344701016282],[0,0,0,1]])cube([15,1.6,10.2265409526658],center=true);
color("#303b35")multmatrix([[1,0,0,-172],[0,0.6959764213224875,0.718064635644413,62.54768223337855],[0,-0.718064635644413,0.6959764213224875,253.37508163659027],[0,0,0,1]])cube([15,1.6,10.013709732651197],center=true);
color("#303b35")multmatrix([[1,0,0,-172],[0,0.7861738613767881,0.618005388073527,69.17231114882706],[0,-0.618005388073527,0.7861738613767881,260.7134584516198],[0,0,0,1]])cube([15,1.6,9.80374462293699],center=true);
color("#303b35")multmatrix([[1,0,0,-172],[0,0.864966955671986,0.5018288210092526,74.6133826423313],[0,-0.5018288210092526,0.864966955671986,268.72403888482916],[0,0,0,1]])cube([15,1.6,9.611596195364033],center=true);
color("#303b35")multmatrix([[1,0,0,-172],[0,0.9286821551154762,0.37087660315807797,78.77779847208741],[0,-0.37087660315807797,0.9286821551154762,277.2697596840538],[0,0,0,1]])cube([15,1.6,9.451811311164173],center=true);
color("#303b35")multmatrix([[1,0,0,-172],[0,0.9736942286144331,0.22785861660894874,81.59430432865405],[0,-0.22785861660894874,0.9736942286144331,286.20440119709747],[0,0,0,1]])cube([15,1.6,9.337176149054386],center=true);
color("#303b35")multmatrix([[1,0,0,-172],[0,0.9970402198210326,0.07688172773310277,83.0147090159424],[0,-0.07688172773310277,0.9970402198210326,295.3750892305214],[0,0,0,1]])cube([15,1.6,9.277280249153405],center=true);
color("#303b35")multmatrix([[0,0,1,0],[1,0,0,-72],[0,1,0,259],[0,0,0,1]])cube([15,1.6,74],center=true);
color("#303b35")multmatrix([[1,0,0,37],[0,0,-1,-41.625],[0,1,0,259],[0,0,0,1]])cube([15,1.6,60.75],center=true);
color("#303b35")multmatrix([[0,0,1,0],[1,0,0,72],[0,1,0,259],[0,0,0,1]])cube([15,1.6,74],center=true);
color("#303b35")multmatrix([[-1,0,0,37],[0,0,1,41.625],[0,1,0,259],[0,0,0,1]])cube([15,1.6,60.75],center=true);
color("#303b35")multmatrix([[-1,0,0,-37],[0,0,1,0],[0,1,0,259],[0,0,0,1]])cube([15,1.6,144],center=true);
color("#303b35")multmatrix([[1,0,0,-100],[0,1,0,-105],[0,0,1,287],[0,0,0,1]])cube([15,26,1.6],center=true);
color("#303b35")multmatrix([[1,0,0,-100],[0,1,0,-92],[0,0,1,300],[0,0,0,1]])cube([15,1.6,26],center=true);
color("#303b35")multmatrix([[1,0,0,-100],[0,1,0,-105],[0,0,1,313],[0,0,0,1]])cube([15,26,1.6],center=true);
color("#303b35")multmatrix([[1,0,0,-100],[0,1,0,-118],[0,0,1,300],[0,0,0,1]])cube([15,1.6,26],center=true);
color("#303b35")multmatrix([[1,0,0,60],[0,1,0,-10.5],[0,0,1,283],[0,0,0,1]])cube([34,15,1.6],center=true);
color("#303b35")multmatrix([[1,0,0,77],[0,1,0,-10.5],[0,0,1,300],[0,0,0,1]])cube([1.6,15,34],center=true);
color("#303b35")multmatrix([[1,0,0,60],[0,1,0,-10.5],[0,0,1,317],[0,0,0,1]])cube([34,15,1.6],center=true);
color("#303b35")multmatrix([[1,0,0,43],[0,1,0,-10.5],[0,0,1,300],[0,0,0,1]])cube([1.6,15,34],center=true);
color("#303b35")multmatrix([[1,0,0,-225],[0,1,0,-105],[0,0,1,287],[0,0,0,1]])cube([15,26,1.6],center=true);
color("#303b35")multmatrix([[1,0,0,-225],[0,1,0,-92],[0,0,1,300],[0,0,0,1]])cube([15,1.6,26],center=true);
color("#303b35")multmatrix([[1,0,0,-225],[0,1,0,-105],[0,0,1,313],[0,0,0,1]])cube([15,26,1.6],center=true);
color("#303b35")multmatrix([[1,0,0,-225],[0,1,0,-118],[0,0,1,300],[0,0,0,1]])cube([15,1.6,26],center=true);
color("#303b35")multmatrix([[1,0,0,-100],[0,1,0,105],[0,0,1,287],[0,0,0,1]])cube([15,26,1.6],center=true);
color("#303b35")multmatrix([[1,0,0,-100],[0,1,0,118],[0,0,1,300],[0,0,0,1]])cube([15,1.6,26],center=true);
color("#303b35")multmatrix([[1,0,0,-100],[0,1,0,105],[0,0,1,313],[0,0,0,1]])cube([15,26,1.6],center=true);
color("#303b35")multmatrix([[1,0,0,-100],[0,1,0,92],[0,0,1,300],[0,0,0,1]])cube([15,1.6,26],center=true);
color("#303b35")multmatrix([[1,0,0,60],[0,1,0,10.5],[0,0,1,283],[0,0,0,1]])cube([34,15,1.6],center=true);
color("#303b35")multmatrix([[1,0,0,77],[0,1,0,10.5],[0,0,1,300],[0,0,0,1]])cube([1.6,15,34],center=true);
color("#303b35")multmatrix([[1,0,0,60],[0,1,0,10.5],[0,0,1,317],[0,0,0,1]])cube([34,15,1.6],center=true);
color("#303b35")multmatrix([[1,0,0,43],[0,1,0,10.5],[0,0,1,300],[0,0,0,1]])cube([1.6,15,34],center=true);
color("#303b35")multmatrix([[1,0,0,-225],[0,1,0,105],[0,0,1,287],[0,0,0,1]])cube([15,26,1.6],center=true);
color("#303b35")multmatrix([[1,0,0,-225],[0,1,0,118],[0,0,1,300],[0,0,0,1]])cube([15,1.6,26],center=true);
color("#303b35")multmatrix([[1,0,0,-225],[0,1,0,105],[0,0,1,313],[0,0,0,1]])cube([15,26,1.6],center=true);
color("#303b35")multmatrix([[1,0,0,-225],[0,1,0,92],[0,0,1,300],[0,0,0,1]])cube([15,1.6,26],center=true);
color("#88958d")multmatrix([[0.4640069946705576,0.43424940580916244,-0.7720912915265827,-91.77884358006665],[-0.8858315352801555,0.22746397447146605,-0.4044287717520195,-89.40485178848283],[0,0.8716005930883903,0.49021669303275095,289.1953186358967],[0,0,0,1]])cube([3,3,24],center=true);
color("#88958d")multmatrix([[0.4640069946705576,0.43424940580916244,-0.7720912915265827,-82.4987036866555],[-0.8858315352801555,0.22746397447146605,-0.4044287717520195,-107.12148249408594],[0,0.8716005930883903,0.49021669303275095,289.1953186358967],[0,0,0,1]])cube([3,3,24],center=true);
color("#88958d")multmatrix([[0.4640069946705576,0.43424940580916244,-0.7720912915265827,-95.2457321943902],[-0.8858315352801555,0.22746397447146605,-0.4044287717520195,-102.50966924468058],[0,0.8716005930883903,0.49021669303275095,294.3425939127406],[0,0,0,1]])cube([17,3,3],center=true);
color("#88958d")multmatrix([[0.4640069946705576,0.43424940580916244,-0.7720912915265827,-79.03181507233195],[-0.8858315352801555,0.22746397447146605,-0.4044287717520195,-94.01666503788817],[0,0.8716005930883903,0.49021669303275095,284.0480433590528],[0,0,0,1]])cube([17,3,3],center=true);
color("#88958d")multmatrix([[0.4640069946705576,0.43424940580916244,-0.7720912915265827,-87.13877363336107],[-0.8858315352801555,0.22746397447146605,-0.4044287717520195,-98.26316714128438],[0,0.8716005930883903,0.49021669303275095,289.1953186358967],[0,0,0,1]])cube([17,3,3],center=true);
color("#88958d")multmatrix([[-0.9366417498002272,-0.18224119736115119,0.29914942506303166,64.72557225193292],[0.3502887844781338,-0.4872971146830782,0.7998995496250629,-26.41210448101026],[0,0.8540080023078946,0.5202598696748377,289.23578159469184],[0,0,0,1]])cube([3,3,24],center=true);
color("#88958d")multmatrix([[-0.9366417498002272,-0.18224119736115119,0.29914942506303166,45.992737255928375],[0.3502887844781338,-0.4872971146830782,0.7998995496250629,-19.406328791447585],[0,0.8540080023078946,0.5202598696748377,289.23578159469184],[0,0,0,1]])cube([3,3,24],center=true);
color("#88958d")multmatrix([[-0.9366417498002272,-0.18224119736115119,0.29914942506303166,58.50022371709248],[0.3502887844781338,-0.4872971146830782,0.7998995496250629,-14.51027136516576],[0,0.8540080023078946,0.5202598696748377,294.6985102262776],[0,0,0,1]])cube([17,3,3],center=true);
color("#88958d")multmatrix([[-0.9366417498002272,-0.18224119736115119,0.29914942506303166,52.21808579076881],[0.3502887844781338,-0.4872971146830782,0.7998995496250629,-31.30816190729208],[0,0.8540080023078946,0.5202598696748377,283.773052963106],[0,0,0,1]])cube([17,3,3],center=true);
color("#88958d")multmatrix([[-0.9366417498002272,-0.18224119736115119,0.29914942506303166,55.359154753930646],[0.3502887844781338,-0.4872971146830782,0.7998995496250629,-22.909216636228923],[0,0.8540080023078946,0.5202598696748377,289.23578159469184],[0,0,0,1]])cube([17,3,3],center=true);
color("#88958d")multmatrix([[0.9012154381052687,0,-0.4333713582145554,-226.7521543810527],[-0.4333713582145554,0,-0.9012154381052687,-85.56878641785445],[0,1,0,297.7],[0,0,0,1]])cube([3,3,24],center=true);
color("#88958d")multmatrix([[0.9012154381052687,0,-0.4333713582145554,-208.72784561894733],[-0.4333713582145554,0,-0.9012154381052687,-94.23621358214555],[0,1,0,297.7],[0,0,0,1]])cube([3,3,24],center=true);
color("#88958d")multmatrix([[0.9012154381052687,0,-0.4333713582145554,-222.29039926125284],[-0.4333713582145554,0,-0.9012154381052687,-99.36526210010533],[0,1,0,297.7],[0,0,0,1]])cube([17,3,3],center=true);
color("#88958d")multmatrix([[0.9012154381052687,0,-0.4333713582145554,-213.18960073874717],[-0.4333713582145554,0,-0.9012154381052687,-80.43973789989468],[0,1,0,297.7],[0,0,0,1]])cube([17,3,3],center=true);
color("#88958d")multmatrix([[0.9012154381052687,0,-0.4333713582145554,-217.74],[-0.4333713582145554,0,-0.9012154381052687,-89.9025],[0,1,0,297.7],[0,0,0,1]])cube([17,3,3],center=true);
color("#88958d")multmatrix([[-0.4640069946705576,0.43424940580916244,-0.7720912915265827,-82.4987036866555],[-0.8858315352801555,-0.22746397447146605,0.4044287717520195,107.12148249408594],[0,0.8716005930883903,0.49021669303275095,289.1953186358967],[0,0,0,1]])cube([3,3,24],center=true);
color("#88958d")multmatrix([[-0.4640069946705576,0.43424940580916244,-0.7720912915265827,-91.77884358006665],[-0.8858315352801555,-0.22746397447146605,0.4044287717520195,89.40485178848283],[0,0.8716005930883903,0.49021669303275095,289.1953186358967],[0,0,0,1]])cube([3,3,24],center=true);
color("#88958d")multmatrix([[-0.4640069946705576,0.43424940580916244,-0.7720912915265827,-95.2457321943902],[-0.8858315352801555,-0.22746397447146605,0.4044287717520195,102.50966924468058],[0,0.8716005930883903,0.49021669303275095,294.3425939127406],[0,0,0,1]])cube([17,3,3],center=true);
color("#88958d")multmatrix([[-0.4640069946705576,0.43424940580916244,-0.7720912915265827,-79.03181507233195],[-0.8858315352801555,-0.22746397447146605,0.4044287717520195,94.01666503788817],[0,0.8716005930883903,0.49021669303275095,284.0480433590528],[0,0,0,1]])cube([17,3,3],center=true);
color("#88958d")multmatrix([[-0.4640069946705576,0.43424940580916244,-0.7720912915265827,-87.13877363336107],[-0.8858315352801555,-0.22746397447146605,0.4044287717520195,98.26316714128438],[0,0.8716005930883903,0.49021669303275095,289.1953186358967],[0,0,0,1]])cube([17,3,3],center=true);
color("#88958d")multmatrix([[0.9366417498002272,-0.18224119736115119,0.29914942506303166,45.992737255928375],[0.3502887844781338,0.4872971146830782,-0.7998995496250629,19.406328791447585],[0,0.8540080023078946,0.5202598696748377,289.23578159469184],[0,0,0,1]])cube([3,3,24],center=true);
color("#88958d")multmatrix([[0.9366417498002272,-0.18224119736115119,0.29914942506303166,64.72557225193292],[0.3502887844781338,0.4872971146830782,-0.7998995496250629,26.41210448101026],[0,0.8540080023078946,0.5202598696748377,289.23578159469184],[0,0,0,1]])cube([3,3,24],center=true);
color("#88958d")multmatrix([[0.9366417498002272,-0.18224119736115119,0.29914942506303166,58.50022371709248],[0.3502887844781338,0.4872971146830782,-0.7998995496250629,14.51027136516576],[0,0.8540080023078946,0.5202598696748377,294.6985102262776],[0,0,0,1]])cube([17,3,3],center=true);
color("#88958d")multmatrix([[0.9366417498002272,-0.18224119736115119,0.29914942506303166,52.21808579076881],[0.3502887844781338,0.4872971146830782,-0.7998995496250629,31.30816190729208],[0,0.8540080023078946,0.5202598696748377,283.773052963106],[0,0,0,1]])cube([17,3,3],center=true);
color("#88958d")multmatrix([[0.9366417498002272,-0.18224119736115119,0.29914942506303166,55.359154753930646],[0.3502887844781338,0.4872971146830782,-0.7998995496250629,22.909216636228923],[0,0.8540080023078946,0.5202598696748377,289.23578159469184],[0,0,0,1]])cube([17,3,3],center=true);
color("#88958d")multmatrix([[-0.9012154381052687,0,-0.4333713582145554,-208.72784561894733],[-0.4333713582145554,0,0.9012154381052687,94.23621358214555],[0,1,0,297.7],[0,0,0,1]])cube([3,3,24],center=true);
color("#88958d")multmatrix([[-0.9012154381052687,0,-0.4333713582145554,-226.7521543810527],[-0.4333713582145554,0,0.9012154381052687,85.56878641785445],[0,1,0,297.7],[0,0,0,1]])cube([3,3,24],center=true);
color("#88958d")multmatrix([[-0.9012154381052687,0,-0.4333713582145554,-222.29039926125284],[-0.4333713582145554,0,0.9012154381052687,99.36526210010533],[0,1,0,297.7],[0,0,0,1]])cube([17,3,3],center=true);
color("#88958d")multmatrix([[-0.9012154381052687,0,-0.4333713582145554,-213.18960073874717],[-0.4333713582145554,0,0.9012154381052687,80.43973789989468],[0,1,0,297.7],[0,0,0,1]])cube([17,3,3],center=true);
color("#88958d")multmatrix([[-0.9012154381052687,0,-0.4333713582145554,-217.74],[-0.4333713582145554,0,0.9012154381052687,89.9025],[0,1,0,297.7],[0,0,0,1]])cube([17,3,3],center=true);
color("#596d5d")multmatrix([[1,0,0,-33.25],[0,1,0,-82.5],[0,0,1,262.5],[0,0,0,1]])cube([20,12,1.6],center=true);
color("#596d5d")multmatrix([[1,0,0,0],[0,1,0,-82.5],[0,0,1,262.5],[0,0,0,1]])cube([20,12,1.6],center=true);
color("#596d5d")multmatrix([[1,0,0,33.25],[0,1,0,-82.5],[0,0,1,262.5],[0,0,0,1]])cube([20,12,1.6],center=true);
color("#596d5d")multmatrix([[1,0,0,-194.5],[0,1,0,-36.375],[0,0,1,241.79999999999998],[0,0,0,1]])cube([1.6,12,20],center=true);
color("#596d5d")multmatrix([[1,0,0,-194.5],[0,1,0,-36.375],[0,0,1,300],[0,0,0,1]])cube([1.6,12,20],center=true);
color("#596d5d")multmatrix([[1,0,0,-33.25],[0,1,0,82.5],[0,0,1,262.5],[0,0,0,1]])cube([20,12,1.6],center=true);
color("#596d5d")multmatrix([[1,0,0,0],[0,1,0,82.5],[0,0,1,262.5],[0,0,0,1]])cube([20,12,1.6],center=true);
color("#596d5d")multmatrix([[1,0,0,33.25],[0,1,0,82.5],[0,0,1,262.5],[0,0,0,1]])cube([20,12,1.6],center=true);
color("#596d5d")multmatrix([[1,0,0,-194.5],[0,1,0,36.375],[0,0,1,241.79999999999998],[0,0,0,1]])cube([1.6,12,20],center=true);
color("#596d5d")multmatrix([[1,0,0,-194.5],[0,1,0,36.375],[0,0,1,300],[0,0,0,1]])cube([1.6,12,20],center=true);
color("#253129")multmatrix([[1,0,0,-172],[0,1,0,-83.37133568305195],[0,0,1,300],[0,0,0,1]])cube([12,23,40],center=true);
color("#65796b")multmatrix([[1,0,0,-198.8],[0,1,0,0],[0,0,1,238.56666666666663],[0,0,0,1]])cube([0.4,58.2,0.6],center=true);
color("#65796b")multmatrix([[1,0,0,-198.8],[0,1,0,0],[0,0,1,249.34444444444443],[0,0,0,1]])cube([0.4,58.2,0.6],center=true);
color("#65796b")multmatrix([[1,0,0,-198.8],[0,1,0,0],[0,0,1,260.1222222222222],[0,0,0,1]])cube([0.4,58.2,0.6],center=true);
color("#65796b")multmatrix([[1,0,0,-198.8],[0,1,0,0],[0,0,1,270.9],[0,0,0,1]])cube([0.4,58.2,0.6],center=true);
color("#65796b")multmatrix([[1,0,0,-198.8],[0,1,0,0],[0,0,1,281.67777777777775],[0,0,0,1]])cube([0.4,58.2,0.6],center=true);
color("#65796b")multmatrix([[1,0,0,-198.8],[0,1,0,0],[0,0,1,292.4555555555555],[0,0,0,1]])cube([0.4,58.2,0.6],center=true);
color("#65796b")multmatrix([[1,0,0,-198.8],[0,1,0,0],[0,0,1,303.2333333333333],[0,0,0,1]])cube([0.4,58.2,0.6],center=true);
}
if(sg_part=="assembly")sg_assembly();else if(sg_part=="rear_pattern")sg_saddle();else if(sg_part=="front_pattern")sg_bib();else if(sg_part=="rear_shell")sg_layer(false,.8);else if(sg_part=="rear_pad")sg_layer(false,5);else if(sg_part=="rear_mesh")sg_layer(false,1.5);else if(sg_part=="front_shell")sg_layer(true,.8);else if(sg_part=="front_pad")sg_layer(true,5);else if(sg_part=="front_mesh")sg_layer(true,1.5);
