stacksjs/buddy-wheels/designs/softgoods/r1/XL-r0/softgoods/parts.scad

// Textile revision 1 BENCH ONLY. All mm. Not printable animal support.
sg_part="assembly";
sg_width=350;sg_length=220;sg_drop=90;sg_chest=1065;sg_leg_width=75;sg_leg_length=120;
sg_corner=20;sg_notch=30;sg_leg_center=85.75;
module sg_roundrect(l,w,r){offset(r=r,$fn=96)square([l-2*r,w-2*r],center=true);}
module sg_capsule(l,w){hull()for(x=[-(l-w)/2,(l-w)/2])translate([x,0])circle(d=w,$fn=96);}
module sg_saddle(){difference(){sg_roundrect(sg_length,sg_width,sg_corner);for(y=[-sg_leg_center,sg_leg_center])translate([0,y])sg_capsule(sg_leg_length,sg_leg_width);hull(){circle(d=sg_notch,$fn=96);translate([sg_length,0])circle(d=sg_notch,$fn=96);}}}
module sg_bib(){sg_roundrect(213,159.75,20);}
module sg_layer(bib,t){linear_extrude(t){if(bib)sg_bib();else sg_saddle();}}

module sg_assembly(){
color("#344039")translate([0,0,529.2])sg_layer(false,0.8);
color("#344c43")translate([0,0,530])sg_layer(false,5);
color("#344c43")translate([0,0,535])sg_layer(false,1.5);
color("#344039")translate([-509.2,0,556.1])rotate([0,-90,0])sg_layer(true,0.8);
color("#344c43")translate([-510,0,556.1])rotate([0,-90,0])sg_layer(true,5);
color("#344c43")translate([-515,0,556.1])rotate([0,-90,0])sg_layer(true,1.5);
color("#303b35")multmatrix([[0.9903350633783072,0.12616427345441972,-0.057611095695210265,-97.15],[-0.13869557398664267,0.9008571806306802,-0.4113634376833431,-179.65],[0,0.41537804011509855,0.9096488793980563,575],[0,0,0,1]])cube([25.4,1.6,98.93927430499983],center=true);
color("#303b35")multmatrix([[-0.845451902942269,0.43471199839787944,-0.3102201770681881,77.15],[-0.5340515703668476,-0.6881883823033486,0.49110657769103844,-132.15],[0,0.5808805633791011,0.8139888028028259,575],[0,0,0,1]])cube([25.4,1.6,110.5666314943166],center=true);
color("#303b35")multmatrix([[0.9092290011652318,0,-0.4162963168706576,-537.5],[-0.4162963168706576,0,-0.9092290011652318,-139.9375],[0,1,0,620],[0,0,0,1]])cube([25.4,1.6,132.11743119285964],center=true);
color("#303b35")multmatrix([[0,0,1,-20],[1,0,0,-200],[0,1,0,635.5],[0,0,0,1]])cube([25.4,1.6,160],center=true);
color("#303b35")multmatrix([[-1,0,0,60],[0,0,1,-152.5],[0,1,0,635.5],[0,0,0,1]])cube([25.4,1.6,95],center=true);
color("#303b35")multmatrix([[0,0.9801238091865887,0.1983867905521223,-500],[-0.9327463542957252,0.0715250382595957,-0.3533672416198151,-73.72453479507747],[-0.3605332696826097,-0.1850445556279217,0.9142069097772297,708.682045444303],[0,0,0,1]])cube([25.4,1.6,100.81316374108782],center=true);
color("#303b35")multmatrix([[-0.9903350633783072,0.12616427345441972,-0.057611095695210265,-97.15],[-0.13869557398664267,-0.9008571806306802,0.4113634376833431,179.65],[0,0.41537804011509855,0.9096488793980563,575],[0,0,0,1]])cube([25.4,1.6,98.93927430499983],center=true);
color("#303b35")multmatrix([[0.845451902942269,0.43471199839787944,-0.3102201770681881,77.15],[-0.5340515703668476,0.6881883823033486,-0.49110657769103844,132.15],[0,0.5808805633791011,0.8139888028028259,575],[0,0,0,1]])cube([25.4,1.6,110.5666314943166],center=true);
color("#303b35")multmatrix([[-0.9092290011652318,0,-0.4162963168706576,-537.5],[-0.4162963168706576,0,0.9092290011652318,139.9375],[0,1,0,620],[0,0,0,1]])cube([25.4,1.6,132.11743119285964],center=true);
color("#303b35")multmatrix([[0,0,1,-20],[1,0,0,200],[0,1,0,635.5],[0,0,0,1]])cube([25.4,1.6,160],center=true);
color("#303b35")multmatrix([[1,0,0,60],[0,0,-1,152.5],[0,1,0,635.5],[0,0,0,1]])cube([25.4,1.6,95],center=true);
color("#303b35")multmatrix([[0,0.9801238091865885,0.19838679055212224,-500],[-0.932746354295725,-0.07152503825959577,0.3533672416198154,73.72453479507749],[0.36053326968261007,-0.1850445556279216,0.9142069097772294,708.682045444303],[0,0,0,1]])cube([25.4,1.6,100.81316374108785],center=true);
color("#303b35")multmatrix([[1,0,0,-490],[0,0.9970402198210326,-0.07688172773310267,182.29003113810035],[0,0.07688172773310267,0.9970402198210326,630.1557318958654],[0,0,0,1]])cube([25.4,1.6,20.37175972236778],center=true);
color("#303b35")multmatrix([[1,0,0,-490],[0,0.9736942286144331,-0.22785861660894924,179.17099816498262],[0,0.22785861660894924,0.9736942286144331,650.2934282991571],[0,0,0,1]])cube([25.4,1.6,20.50328370874826],center=true);
color("#303b35")multmatrix([[1,0,0,-490],[0,0.9286821551154762,-0.37087660315807786,172.98629973767652],[0,0.37087660315807786,0.9286821551154762,669.9127957453252],[0,0,0,1]])cube([25.4,1.6,20.75500834307176],center=true);
color("#303b35")multmatrix([[1,0,0,-490],[0,0.8649669556719876,-0.5018288210092503,163.8417577609956],[0,0.5018288210092503,0.8649669556719876,688.6781414178492],[0,0,0,1]])cube([25.4,1.6,21.10587618157262],center=true);
color("#303b35")multmatrix([[1,0,0,-490],[0,0.7861738613767881,-0.6180053880735271,151.8938378835069],[0,0.6180053880735271,0.7861738613767881,706.2683850495359],[0,0,0,1]])cube([25.4,1.6,21.52781035758331],center=true);
color("#303b35")multmatrix([[1,0,0,-490],[0,0.6959764213224869,-0.7180646356444135,137.34697232690348],[0,0.7180646356444135,0.6959764213224869,722.38255269491],[0,0,0,1]])cube([25.4,1.6,21.988867763450543],center=true);
color("#303b35")multmatrix([[1,0,0,-490],[0,0.5976524451738608,-0.8017552960708805,120.45006199401186],[0,0.8017552960708805,0.5976524451738608,736.7449264778679],[0,0,0,1]])cube([25.4,1.6,22.45621879296723],center=true);
color("#303b35")multmatrix([[1,0,0,-490],[0,0.49385822897091797,-0.8695424369619394,101.49221770533646],[0,0.8695424369619394,0.49385822897091797,749.1097622009809],[0,0,0,1]])cube([25.4,1.6,22.898590550600627],center=true);
color("#303b35")multmatrix([[1,0,0,-490],[0,0.3865845313059652,-0.9222539781182552,80.79781343276392],[0,0.9222539781182552,0.3865845313059652,759.2654940968463],[0,0,0,1]])cube([25.4,1.6,23.288066871345325],center=true);
color("#303b35")multmatrix([[1,0,0,-490],[0,0.2772268043059887,-0.9608045061167693,58.72093617097076],[0,0.9608045061167693,0.2772268043059887,767.038354777025],[0,0,0,1]])cube([25.4,1.6,23.601307096751075],center=true);
color("#303b35")multmatrix([[1,0,0,-490],[0,0.16670947961696844,-0.9860060595178103,35.63932741077306],[0,0.9860060595178103,0.16670947961696844,772.2953484402352],[0,0,0,1]])cube([25.4,1.6,23.8203153873894],center=true);
color("#303b35")multmatrix([[1,0,0,-490],[0,0.05562568420108783,-0.9984516930012993,11.947919877488715],[0,0.9984516930012993,0.05562568420108783,774.9465264673853],[0,0,0,1]])cube([25.4,1.6,23.932895224152134],center=true);
color("#303b35")multmatrix([[1,0,0,-490],[0,-0.05562568420108792,-0.9984516930012993,-11.947919877488674],[0,0.9984516930012993,-0.05562568420108792,774.9465264673853],[0,0,0,1]])cube([25.4,1.6,23.932895224152094],center=true);
color("#303b35")multmatrix([[1,0,0,-490],[0,-0.16670947961696786,-0.9860060595178103,-35.63932741077304],[0,0.9860060595178103,-0.16670947961696786,772.2953484402352],[0,0,0,1]])cube([25.4,1.6,23.82031538738948],center=true);
color("#303b35")multmatrix([[1,0,0,-490],[0,-0.27722680430598917,-0.9608045061167693,-58.72093617097077],[0,0.9608045061167693,-0.27722680430598917,767.038354777025],[0,0,0,1]])cube([25.4,1.6,23.60130709675104],center=true);
color("#303b35")multmatrix([[1,0,0,-490],[0,-0.38658453130596565,-0.922253978118255,-80.79781343276389],[0,0.922253978118255,-0.38658453130596565,759.2654940968463],[0,0,0,1]])cube([25.4,1.6,23.288066871345297],center=true);
color("#303b35")multmatrix([[1,0,0,-490],[0,-0.4938582289709172,-0.8695424369619399,-101.49221770533643],[0,0.8695424369619399,-0.4938582289709172,749.1097622009809],[0,0,0,1]])cube([25.4,1.6,22.898590550600662],center=true);
color("#303b35")multmatrix([[1,0,0,-490],[0,-0.5976524451738615,-0.8017552960708801,-120.45006199401185],[0,0.8017552960708801,-0.5976524451738615,736.7449264778679],[0,0,0,1]])cube([25.4,1.6,22.456218792967206],center=true);
color("#303b35")multmatrix([[1,0,0,-490],[0,-0.6959764213224843,-0.718064635644416,-137.34697232690343],[0,0.718064635644416,-0.6959764213224843,722.3825526949101],[0,0,0,1]])cube([25.4,1.6,21.988867763450465],center=true);
color("#303b35")multmatrix([[1,0,0,-490],[0,-0.7861738613767896,-0.6180053880735253,-151.89383788350688],[0,0.6180053880735253,-0.7861738613767896,706.2683850495359],[0,0,0,1]])cube([25.4,1.6,21.527810357583416],center=true);
color("#303b35")multmatrix([[1,0,0,-490],[0,-0.8649669556719876,-0.5018288210092503,-163.8417577609956],[0,0.5018288210092503,-0.8649669556719876,688.6781414178492],[0,0,0,1]])cube([25.4,1.6,21.10587618157262],center=true);
color("#303b35")multmatrix([[1,0,0,-490],[0,-0.928682155115476,-0.3708766031580786,-172.9862997376765],[0,0.3708766031580786,-0.928682155115476,669.9127957453252],[0,0,0,1]])cube([25.4,1.6,20.755008343071644],center=true);
color("#303b35")multmatrix([[1,0,0,-490],[0,-0.9736942286144331,-0.22785861660894932,-179.1709981649826],[0,0.22785861660894932,-0.9736942286144331,650.2934282991571],[0,0,0,1]])cube([25.4,1.6,20.503283708748377],center=true);
color("#303b35")multmatrix([[1,0,0,-490],[0,-0.9970402198210326,-0.07688172773310267,-182.29003113810035],[0,0.07688172773310267,-0.9970402198210326,630.1557318958654],[0,0,0,1]])cube([25.4,1.6,20.37175972236778],center=true);
color("#303b35")multmatrix([[1,0,0,-490],[0,-0.9970402198210326,0.07688172773310267,-182.29003113810035],[0,-0.07688172773310267,-0.9970402198210326,609.8442681041346],[0,0,0,1]])cube([25.4,1.6,20.37175972236778],center=true);
color("#303b35")multmatrix([[1,0,0,-490],[0,-0.9736942286144334,0.22785861660894793,-179.17099816498262],[0,-0.22785861660894793,-0.9736942286144334,589.7065717008429],[0,0,0,1]])cube([25.4,1.6,20.503283708748253],center=true);
color("#303b35")multmatrix([[1,0,0,-490],[0,-0.9286821551154762,0.37087660315807786,-172.98629973767652],[0,-0.37087660315807786,-0.9286821551154762,570.0872042546748],[0,0,0,1]])cube([25.4,1.6,20.75500834307176],center=true);
color("#303b35")multmatrix([[1,0,0,-490],[0,-0.8649669556719863,0.5018288210092523,-163.8417577609956],[0,-0.5018288210092523,-0.8649669556719863,551.3218585821508],[0,0,0,1]])cube([25.4,1.6,21.105876181572647],center=true);
color("#303b35")multmatrix([[1,0,0,-490],[0,-0.7861738613767894,0.6180053880735253,-151.8938378835069],[0,-0.6180053880735253,-0.7861738613767894,533.7316149504641],[0,0,0,1]])cube([25.4,1.6,21.527810357583277],center=true);
color("#303b35")multmatrix([[1,0,0,-490],[0,-0.6959764213224863,0.718064635644414,-137.34697232690348],[0,-0.718064635644414,-0.6959764213224863,517.61744730509],[0,0,0,1]])cube([25.4,1.6,21.988867763450564],center=true);
color("#303b35")multmatrix([[1,0,0,-490],[0,-0.5976524451738601,0.801755296070881,-120.45006199401189],[0,-0.801755296070881,-0.5976524451738601,503.2550735221321],[0,0,0,1]])cube([25.4,1.6,22.456218792967164],center=true);
color("#303b35")multmatrix([[1,0,0,-490],[0,-0.49385822897091847,0.8695424369619391,-101.49221770533651],[0,-0.8695424369619391,-0.49385822897091847,490.8902377990192],[0,0,0,1]])cube([25.4,1.6,22.898590550600602],center=true);
color("#303b35")multmatrix([[1,0,0,-490],[0,-0.38658453130596354,0.9222539781182559,-80.797813432764],[0,-0.9222539781182559,-0.38658453130596354,480.73450590315383],[0,0,0,1]])cube([25.4,1.6,23.288066871345276],center=true);
color("#303b35")multmatrix([[1,0,0,-490],[0,-0.27722680430599184,0.9608045061167685,-58.7209361709708],[0,-0.9608045061167685,-0.27722680430599184,472.961645222975],[0,0,0,1]])cube([25.4,1.6,23.60130709675122],center=true);
color("#303b35")multmatrix([[1,0,0,-490],[0,-0.16670947961696847,0.9860060595178103,-35.63932741077304],[0,-0.9860060595178103,-0.16670947961696847,467.7046515597648],[0,0,0,1]])cube([25.4,1.6,23.820315387389396],center=true);
color("#303b35")multmatrix([[1,0,0,-490],[0,-0.05562568420108792,0.9984516930012993,-11.947919877488717],[0,-0.9984516930012993,-0.05562568420108792,465.0534735326147],[0,0,0,1]])cube([25.4,1.6,23.932895224152094],center=true);
color("#303b35")multmatrix([[1,0,0,-490],[0,0.05562568420108792,0.9984516930012993,11.947919877488651],[0,-0.9984516930012993,0.05562568420108792,465.0534735326147],[0,0,0,1]])cube([25.4,1.6,23.932895224152094],center=true);
color("#303b35")multmatrix([[1,0,0,-490],[0,0.16670947961696847,0.9860060595178103,35.63932741077298],[0,-0.9860060595178103,0.16670947961696847,467.7046515597648],[0,0,0,1]])cube([25.4,1.6,23.820315387389396],center=true);
color("#303b35")multmatrix([[1,0,0,-490],[0,0.27722680430598967,0.960804506116769,58.72093617097073],[0,-0.960804506116769,0.27722680430598967,472.961645222975],[0,0,0,1]])cube([25.4,1.6,23.6013070967512],center=true);
color("#303b35")multmatrix([[1,0,0,-490],[0,0.38658453130596354,0.9222539781182559,80.79781343276392],[0,-0.9222539781182559,0.38658453130596354,480.7345059031537],[0,0,0,1]])cube([25.4,1.6,23.288066871345276],center=true);
color("#303b35")multmatrix([[1,0,0,-490],[0,0.49385822897091797,0.8695424369619394,101.49221770533646],[0,-0.8695424369619394,0.49385822897091797,490.89023779901913],[0,0,0,1]])cube([25.4,1.6,22.898590550600627],center=true);
color("#303b35")multmatrix([[1,0,0,-490],[0,0.5976524451738604,0.8017552960708808,120.45006199401183],[0,-0.8017552960708808,0.5976524451738604,503.2550735221321],[0,0,0,1]])cube([25.4,1.6,22.456218792967153],center=true);
color("#303b35")multmatrix([[1,0,0,-490],[0,0.6959764213224856,0.7180646356444147,137.34697232690343],[0,-0.7180646356444147,0.6959764213224856,517.6174473050899],[0,0,0,1]])cube([25.4,1.6,21.988867763450504],center=true);
color("#303b35")multmatrix([[1,0,0,-490],[0,0.7861738613767881,0.6180053880735271,151.89383788350685],[0,-0.6180053880735271,0.7861738613767881,533.731614950464],[0,0,0,1]])cube([25.4,1.6,21.52781035758331],center=true);
color("#303b35")multmatrix([[1,0,0,-490],[0,0.8649669556719868,0.5018288210092512,163.84175776099556],[0,-0.5018288210092512,0.8649669556719868,551.3218585821505],[0,0,0,1]])cube([25.4,1.6,21.105876181572636],center=true);
color("#303b35")multmatrix([[1,0,0,-490],[0,0.9286821551154766,0.3708766031580772,172.9862997376765],[0,-0.3708766031580772,0.9286821551154766,570.0872042546748],[0,0,0,1]])cube([25.4,1.6,20.755008343071875],center=true);
color("#303b35")multmatrix([[1,0,0,-490],[0,0.9736942286144331,0.22785861660894924,179.17099816498262],[0,-0.22785861660894924,0.9736942286144331,589.7065717008429],[0,0,0,1]])cube([25.4,1.6,20.50328370874826],center=true);
color("#303b35")multmatrix([[1,0,0,-490],[0,0.9970402198210326,0.07688172773310267,182.29003113810035],[0,-0.07688172773310267,0.9970402198210326,609.8442681041346],[0,0,0,1]])cube([25.4,1.6,20.37175972236778],center=true);
color("#303b35")multmatrix([[0,0,1,0],[1,0,0,-159.3],[0,1,0,529],[0,0,0,1]])cube([25.4,1.6,188.6],center=true);
color("#303b35")multmatrix([[1,0,0,94.3],[0,0,-1,-88.65],[0,1,0,529],[0,0,0,1]])cube([25.4,1.6,141.3],center=true);
color("#303b35")multmatrix([[0,0,1,0],[1,0,0,159.3],[0,1,0,529],[0,0,0,1]])cube([25.4,1.6,188.6],center=true);
color("#303b35")multmatrix([[-1,0,0,94.3],[0,0,1,88.65],[0,1,0,529],[0,0,0,1]])cube([25.4,1.6,141.3],center=true);
color("#303b35")multmatrix([[-1,0,0,-94.3],[0,0,1,0],[0,1,0,529],[0,0,0,1]])cube([25.4,1.6,318.6],center=true);
color("#303b35")multmatrix([[1,0,0,-100],[0,1,0,-200],[0,0,1,604.5],[0,0,0,1]])cube([25.4,31,1.6],center=true);
color("#303b35")multmatrix([[1,0,0,-100],[0,1,0,-184.5],[0,0,1,620],[0,0,0,1]])cube([25.4,1.6,31],center=true);
color("#303b35")multmatrix([[1,0,0,-100],[0,1,0,-200],[0,0,1,635.5],[0,0,0,1]])cube([25.4,31,1.6],center=true);
color("#303b35")multmatrix([[1,0,0,-100],[0,1,0,-215.5],[0,0,1,620],[0,0,0,1]])cube([25.4,1.6,31],center=true);
color("#303b35")multmatrix([[1,0,0,60],[0,1,0,-105],[0,0,1,598.5],[0,0,0,1]])cube([34,25.4,1.6],center=true);
color("#303b35")multmatrix([[1,0,0,77],[0,1,0,-105],[0,0,1,620],[0,0,0,1]])cube([1.6,25.4,43],center=true);
color("#303b35")multmatrix([[1,0,0,60],[0,1,0,-105],[0,0,1,641.5],[0,0,0,1]])cube([34,25.4,1.6],center=true);
color("#303b35")multmatrix([[1,0,0,43],[0,1,0,-105],[0,0,1,620],[0,0,0,1]])cube([1.6,25.4,43],center=true);
color("#303b35")multmatrix([[1,0,0,-565],[0,1,0,-200],[0,0,1,604.5],[0,0,0,1]])cube([25.4,31,1.6],center=true);
color("#303b35")multmatrix([[1,0,0,-565],[0,1,0,-184.5],[0,0,1,620],[0,0,0,1]])cube([25.4,1.6,31],center=true);
color("#303b35")multmatrix([[1,0,0,-565],[0,1,0,-200],[0,0,1,635.5],[0,0,0,1]])cube([25.4,31,1.6],center=true);
color("#303b35")multmatrix([[1,0,0,-565],[0,1,0,-215.5],[0,0,1,620],[0,0,0,1]])cube([25.4,1.6,31],center=true);
color("#303b35")multmatrix([[1,0,0,-100],[0,1,0,200],[0,0,1,604.5],[0,0,0,1]])cube([25.4,31,1.6],center=true);
color("#303b35")multmatrix([[1,0,0,-100],[0,1,0,215.5],[0,0,1,620],[0,0,0,1]])cube([25.4,1.6,31],center=true);
color("#303b35")multmatrix([[1,0,0,-100],[0,1,0,200],[0,0,1,635.5],[0,0,0,1]])cube([25.4,31,1.6],center=true);
color("#303b35")multmatrix([[1,0,0,-100],[0,1,0,184.5],[0,0,1,620],[0,0,0,1]])cube([25.4,1.6,31],center=true);
color("#303b35")multmatrix([[1,0,0,60],[0,1,0,105],[0,0,1,598.5],[0,0,0,1]])cube([34,25.4,1.6],center=true);
color("#303b35")multmatrix([[1,0,0,77],[0,1,0,105],[0,0,1,620],[0,0,0,1]])cube([1.6,25.4,43],center=true);
color("#303b35")multmatrix([[1,0,0,60],[0,1,0,105],[0,0,1,641.5],[0,0,0,1]])cube([34,25.4,1.6],center=true);
color("#303b35")multmatrix([[1,0,0,43],[0,1,0,105],[0,0,1,620],[0,0,0,1]])cube([1.6,25.4,43],center=true);
color("#303b35")multmatrix([[1,0,0,-565],[0,1,0,200],[0,0,1,604.5],[0,0,0,1]])cube([25.4,31,1.6],center=true);
color("#303b35")multmatrix([[1,0,0,-565],[0,1,0,215.5],[0,0,1,620],[0,0,0,1]])cube([25.4,1.6,31],center=true);
color("#303b35")multmatrix([[1,0,0,-565],[0,1,0,200],[0,0,1,635.5],[0,0,0,1]])cube([25.4,31,1.6],center=true);
color("#303b35")multmatrix([[1,0,0,-565],[0,1,0,184.5],[0,0,1,620],[0,0,0,1]])cube([25.4,1.6,31],center=true);
color("#88958d")multmatrix([[0.9903350633783072,0.12616427345441972,-0.057611095695210265,-114.08927079229542],[-0.13869557398664267,0.9008571806306802,-0.4113634376833431,-191.00979879085358],[0,0.41537804011509855,0.9096488793980563,599.2446305077353],[0,0,0,1]])cube([3,3,24],center=true);
color("#88958d")multmatrix([[0.9903350633783072,0.12616427345441972,-0.057611095695210265,-83.98308486559489],[-0.13869557398664267,0.9008571806306802,-0.4113634376833431,-195.22614424004752],[0,0.41537804011509855,0.9096488793980563,599.2446305077353],[0,0,0,1]])cube([3,3,24],center=true);
color("#88958d")multmatrix([[0.9903350633783072,0.12616427345441972,-0.057611095695210265,-99.64109433374487],[-0.13869557398664267,0.9008571806306802,-0.4113634376833431,-197.43728761112567],[0,0.41537804011509855,0.9096488793980563,608.7959437414149],[0,0,0,1]])cube([27.4,3,3],center=true);
color("#88958d")multmatrix([[0.9903350633783072,0.12616427345441972,-0.057611095695210265,-98.43126132414545],[-0.13869557398664267,0.9008571806306802,-0.4113634376833431,-188.79865541977546],[0,0.41537804011509855,0.9096488793980563,589.6933172740557],[0,0,0,1]])cube([27.4,3,3],center=true);
color("#88958d")multmatrix([[0.9903350633783072,0.12616427345441972,-0.057611095695210265,-99.03617782894516],[-0.13869557398664267,0.9008571806306802,-0.4113634376833431,-193.11797151545056],[0,0.41537804011509855,0.9096488793980563,599.2446305077353],[0,0,0,1]])cube([27.4,3,3],center=true);
color("#88958d")multmatrix([[-0.845451902942269,0.43471199839787944,-0.3102201770681881,79.39703132840737],[-0.5340515703668476,-0.6881883823033486,0.49110657769103844,-107.24558285112622],[0,0.5808805633791011,0.8139888028028259,598.8639747042281],[0,0,0,1]])cube([3,3,24],center=true);
color("#88958d")multmatrix([[-0.845451902942269,0.43471199839787944,-0.3102201770681881,53.695293478962384],[-0.5340515703668476,-0.6881883823033486,0.49110657769103844,-123.48075059027838],[0,0.5808805633791011,0.8139888028028259,598.8639747042281],[0,0,0,1]])cube([3,3,24],center=true);
color("#88958d")multmatrix([[-0.845451902942269,0.43471199839787944,-0.3102201770681881,63.28885054446889],[-0.5340515703668476,-0.6881883823033486,0.49110657769103844,-110.20654765494639],[0,0.5808805633791011,0.8139888028028259,607.4108571336578],[0,0,0,1]])cube([27.4,3,3],center=true);
color("#88958d")multmatrix([[-0.845451902942269,0.43471199839787944,-0.3102201770681881,69.80347426290085],[-0.5340515703668476,-0.6881883823033486,0.49110657769103844,-120.5197857864582],[0,0.5808805633791011,0.8139888028028259,590.3170922747985],[0,0,0,1]])cube([27.4,3,3],center=true);
color("#88958d")multmatrix([[-0.845451902942269,0.43471199839787944,-0.3102201770681881,66.54616240368487],[-0.5340515703668476,-0.6881883823033486,0.49110657769103844,-115.3631667207023],[0,0.5808805633791011,0.8139888028028259,598.8639747042281],[0,0,0,1]])cube([27.4,3,3],center=true);
color("#88958d")multmatrix([[0.9092290011652318,0,-0.4162963168706576,-566.7202808177115],[-0.4162963168706576,0,-0.9092290011652318,-167.244795983566],[0,1,0,617.7],[0,0,0,1]])cube([3,3,24],center=true);
color("#88958d")multmatrix([[0.9092290011652318,0,-0.4162963168706576,-539.0797191822885],[-0.4162963168706576,0,-0.9092290011652318,-179.90020401643397],[0,1,0,617.7],[0,0,0,1]])cube([3,3,24],center=true);
color("#88958d")multmatrix([[0.9092290011652318,0,-0.4162963168706576,-557.2711113271419],[-0.4162963168706576,0,-0.9092290011652318,-183.11940451223492],[0,1,0,617.7],[0,0,0,1]])cube([27.4,3,3],center=true);
color("#88958d")multmatrix([[0.9092290011652318,0,-0.4162963168706576,-548.5288886728581],[-0.4162963168706576,0,-0.9092290011652318,-164.02559548776506],[0,1,0,617.7],[0,0,0,1]])cube([27.4,3,3],center=true);
color("#88958d")multmatrix([[0.9092290011652318,0,-0.4162963168706576,-552.9],[-0.4162963168706576,0,-0.9092290011652318,-173.5725],[0,1,0,617.7],[0,0,0,1]])cube([27.4,3,3],center=true);
color("#88958d")multmatrix([[-0.9903350633783072,0.12616427345441972,-0.057611095695210265,-83.98308486559489],[-0.13869557398664267,-0.9008571806306802,0.4113634376833431,195.22614424004752],[0,0.41537804011509855,0.9096488793980563,599.2446305077353],[0,0,0,1]])cube([3,3,24],center=true);
color("#88958d")multmatrix([[-0.9903350633783072,0.12616427345441972,-0.057611095695210265,-114.08927079229542],[-0.13869557398664267,-0.9008571806306802,0.4113634376833431,191.00979879085358],[0,0.41537804011509855,0.9096488793980563,599.2446305077353],[0,0,0,1]])cube([3,3,24],center=true);
color("#88958d")multmatrix([[-0.9903350633783072,0.12616427345441972,-0.057611095695210265,-99.64109433374487],[-0.13869557398664267,-0.9008571806306802,0.4113634376833431,197.43728761112567],[0,0.41537804011509855,0.9096488793980563,608.7959437414149],[0,0,0,1]])cube([27.4,3,3],center=true);
color("#88958d")multmatrix([[-0.9903350633783072,0.12616427345441972,-0.057611095695210265,-98.43126132414545],[-0.13869557398664267,-0.9008571806306802,0.4113634376833431,188.79865541977546],[0,0.41537804011509855,0.9096488793980563,589.6933172740557],[0,0,0,1]])cube([27.4,3,3],center=true);
color("#88958d")multmatrix([[-0.9903350633783072,0.12616427345441972,-0.057611095695210265,-99.03617782894516],[-0.13869557398664267,-0.9008571806306802,0.4113634376833431,193.11797151545056],[0,0.41537804011509855,0.9096488793980563,599.2446305077353],[0,0,0,1]])cube([27.4,3,3],center=true);
color("#88958d")multmatrix([[0.845451902942269,0.43471199839787944,-0.3102201770681881,53.695293478962384],[-0.5340515703668476,0.6881883823033486,-0.49110657769103844,123.48075059027838],[0,0.5808805633791011,0.8139888028028259,598.8639747042281],[0,0,0,1]])cube([3,3,24],center=true);
color("#88958d")multmatrix([[0.845451902942269,0.43471199839787944,-0.3102201770681881,79.39703132840737],[-0.5340515703668476,0.6881883823033486,-0.49110657769103844,107.24558285112622],[0,0.5808805633791011,0.8139888028028259,598.8639747042281],[0,0,0,1]])cube([3,3,24],center=true);
color("#88958d")multmatrix([[0.845451902942269,0.43471199839787944,-0.3102201770681881,63.28885054446889],[-0.5340515703668476,0.6881883823033486,-0.49110657769103844,110.20654765494639],[0,0.5808805633791011,0.8139888028028259,607.4108571336578],[0,0,0,1]])cube([27.4,3,3],center=true);
color("#88958d")multmatrix([[0.845451902942269,0.43471199839787944,-0.3102201770681881,69.80347426290085],[-0.5340515703668476,0.6881883823033486,-0.49110657769103844,120.5197857864582],[0,0.5808805633791011,0.8139888028028259,590.3170922747985],[0,0,0,1]])cube([27.4,3,3],center=true);
color("#88958d")multmatrix([[0.845451902942269,0.43471199839787944,-0.3102201770681881,66.54616240368487],[-0.5340515703668476,0.6881883823033486,-0.49110657769103844,115.3631667207023],[0,0.5808805633791011,0.8139888028028259,598.8639747042281],[0,0,0,1]])cube([27.4,3,3],center=true);
color("#88958d")multmatrix([[-0.9092290011652318,0,-0.4162963168706576,-539.0797191822885],[-0.4162963168706576,0,0.9092290011652318,179.90020401643397],[0,1,0,617.7],[0,0,0,1]])cube([3,3,24],center=true);
color("#88958d")multmatrix([[-0.9092290011652318,0,-0.4162963168706576,-566.7202808177115],[-0.4162963168706576,0,0.9092290011652318,167.244795983566],[0,1,0,617.7],[0,0,0,1]])cube([3,3,24],center=true);
color("#88958d")multmatrix([[-0.9092290011652318,0,-0.4162963168706576,-557.2711113271419],[-0.4162963168706576,0,0.9092290011652318,183.11940451223492],[0,1,0,617.7],[0,0,0,1]])cube([27.4,3,3],center=true);
color("#88958d")multmatrix([[-0.9092290011652318,0,-0.4162963168706576,-548.5288886728581],[-0.4162963168706576,0,0.9092290011652318,164.02559548776506],[0,1,0,617.7],[0,0,0,1]])cube([27.4,3,3],center=true);
color("#88958d")multmatrix([[-0.9092290011652318,0,-0.4162963168706576,-552.9],[-0.4162963168706576,0,0.9092290011652318,173.5725],[0,1,0,617.7],[0,0,0,1]])cube([27.4,3,3],center=true);
color("#596d5d")multmatrix([[1,0,0,-77],[0,1,0,-175],[0,0,1,532.5],[0,0,0,1]])cube([20,12,1.6],center=true);
color("#596d5d")multmatrix([[1,0,0,0],[0,1,0,-175],[0,0,1,532.5],[0,0,0,1]])cube([20,12,1.6],center=true);
color("#596d5d")multmatrix([[1,0,0,77],[0,1,0,-175],[0,0,1,532.5],[0,0,0,1]])cube([20,12,1.6],center=true);
color("#596d5d")multmatrix([[1,0,0,-512.5],[0,1,0,-79.875],[0,0,1,492.20000000000005],[0,0,0,1]])cube([1.6,12,20],center=true);
color("#596d5d")multmatrix([[1,0,0,-512.5],[0,1,0,-79.875],[0,0,1,620],[0,0,0,1]])cube([1.6,12,20],center=true);
color("#596d5d")multmatrix([[1,0,0,-77],[0,1,0,175],[0,0,1,532.5],[0,0,0,1]])cube([20,12,1.6],center=true);
color("#596d5d")multmatrix([[1,0,0,0],[0,1,0,175],[0,0,1,532.5],[0,0,0,1]])cube([20,12,1.6],center=true);
color("#596d5d")multmatrix([[1,0,0,77],[0,1,0,175],[0,0,1,532.5],[0,0,0,1]])cube([20,12,1.6],center=true);
color("#596d5d")multmatrix([[1,0,0,-512.5],[0,1,0,79.875],[0,0,1,492.20000000000005],[0,0,0,1]])cube([1.6,12,20],center=true);
color("#596d5d")multmatrix([[1,0,0,-512.5],[0,1,0,79.875],[0,0,1,620],[0,0,0,1]])cube([1.6,12,20],center=true);
color("#253129")multmatrix([[1,0,0,-490],[0,1,0,-183.07313918030997],[0,0,1,620],[0,0,0,1]])cube([12,33.4,40],center=true);
color("#65796b")multmatrix([[1,0,0,-516.8],[0,1,0,0],[0,0,1,485.1],[0,0,0,1]])cube([0.4,127.80000000000001,0.6],center=true);
color("#65796b")multmatrix([[1,0,0,-516.8],[0,1,0,0],[0,0,1,508.7666666666667],[0,0,0,1]])cube([0.4,127.80000000000001,0.6],center=true);
color("#65796b")multmatrix([[1,0,0,-516.8],[0,1,0,0],[0,0,1,532.4333333333334],[0,0,0,1]])cube([0.4,127.80000000000001,0.6],center=true);
color("#65796b")multmatrix([[1,0,0,-516.8],[0,1,0,0],[0,0,1,556.1],[0,0,0,1]])cube([0.4,127.80000000000001,0.6],center=true);
color("#65796b")multmatrix([[1,0,0,-516.8],[0,1,0,0],[0,0,1,579.7666666666667],[0,0,0,1]])cube([0.4,127.80000000000001,0.6],center=true);
color("#65796b")multmatrix([[1,0,0,-516.8],[0,1,0,0],[0,0,1,603.4333333333334],[0,0,0,1]])cube([0.4,127.80000000000001,0.6],center=true);
color("#65796b")multmatrix([[1,0,0,-516.8],[0,1,0,0],[0,0,1,627.1],[0,0,0,1]])cube([0.4,127.80000000000001,0.6],center=true);
}
if(sg_part=="assembly")sg_assembly();else if(sg_part=="rear_pattern")sg_saddle();else if(sg_part=="front_pattern")sg_bib();else if(sg_part=="rear_shell")sg_layer(false,.8);else if(sg_part=="rear_pad")sg_layer(false,5);else if(sg_part=="rear_mesh")sg_layer(false,1.5);else if(sg_part=="front_shell")sg_layer(true,.8);else if(sg_part=="front_pad")sg_layer(true,5);else if(sg_part=="front_mesh")sg_layer(true,1.5);
