stacksjs/buddy-wheels/designs/softgoods/r1/XS-r0/softgoods/parts.scad

// Textile revision 1 BENCH ONLY. All mm. Not printable animal support.
sg_part="assembly";
sg_width=120;sg_length=80;sg_drop=30;sg_chest=350;sg_leg_width=15;sg_leg_length=35;
sg_corner=8;sg_notch=12;sg_leg_center=29.4;
module sg_roundrect(l,w,r){offset(r=r,$fn=96)square([l-2*r,w-2*r],center=true);}
module sg_capsule(l,w){hull()for(x=[-(l-w)/2,(l-w)/2])translate([x,0])circle(d=w,$fn=96);}
module sg_saddle(){difference(){sg_roundrect(sg_length,sg_width,sg_corner);for(y=[-sg_leg_center,sg_leg_center])translate([0,y])sg_capsule(sg_leg_length,sg_leg_width);hull(){circle(d=sg_notch,$fn=96);translate([sg_length,0])circle(d=sg_notch,$fn=96);}}}
module sg_bib(){sg_roundrect(70,52.5,8);}
module sg_layer(bib,t){linear_extrude(t){if(bib)sg_bib();else sg_saddle();}}

module sg_assembly(){
color("#344039")translate([0,0,229.2])sg_layer(false,0.8);
color("#344c43")translate([0,0,230])sg_layer(false,5);
color("#344c43")translate([0,0,235])sg_layer(false,1.5);
color("#344039")translate([-127.2,0,239])rotate([0,-90,0])sg_layer(true,0.8);
color("#344c43")translate([-128,0,239])rotate([0,-90,0])sg_layer(true,5);
color("#344c43")translate([-133,0,239])rotate([0,-90,0])sg_layer(true,1.5);
color("#303b35")multmatrix([[0.39705935429903905,0.33388394932650106,-0.8549066484393303,-64.75],[-0.9177929337076148,0.14444624758096855,-0.36985323088510036,-64.75],[0,0.9314809659579287,0.3637900631656725,245],[0,0,0,1]])cube([15,1.6,82.46514415193852],center=true);
color("#303b35")multmatrix([[-0.7877180618901962,-0.31924483324063613,0.5268614537248968,44.75],[0.6160359201961791,-0.4082147047995019,0.6736916949269172,-30],[0,0.8552446967006659,0.5182243807130131,245],[0,0,0,1]])cube([15,1.6,57.88998186214952],center=true);
color("#303b35")multmatrix([[0.953448525995269,0,-0.30155581287292227,-136.5],[-0.30155581287292227,0,-0.953448525995269,-53.125],[0,1,0,260],[0,0,0,1]])cube([15,1.6,56.374307091085385],center=true);
color("#303b35")multmatrix([[0,0,1,-20],[1,0,0,-80],[0,1,0,271],[0,0,0,1]])cube([15,1.6,160],center=true);
color("#303b35")multmatrix([[-1,0,0,60],[0,0,1,-45.25],[0,1,0,271],[0,0,0,1]])cube([15,1.6,69.5],center=true);
color("#303b35")multmatrix([[0,0.851460674213209,0.5244184591224715,-118],[-0.9327463542957255,0.18907030174934045,-0.3069799008802472,-24.22872035518978],[-0.3605332696826093,-0.4891494058718673,0.794196839698551,289.14433418357373],[0,0,0,1]])cube([15,1.6,38.13748286714912],center=true);
color("#303b35")multmatrix([[-0.39705935429903905,0.33388394932650106,-0.8549066484393303,-64.75],[-0.9177929337076148,-0.14444624758096855,0.36985323088510036,64.75],[0,0.9314809659579287,0.3637900631656725,245],[0,0,0,1]])cube([15,1.6,82.46514415193852],center=true);
color("#303b35")multmatrix([[0.7877180618901962,-0.31924483324063613,0.5268614537248968,44.75],[0.6160359201961791,0.4082147047995019,-0.6736916949269172,30],[0,0.8552446967006659,0.5182243807130131,245],[0,0,0,1]])cube([15,1.6,57.88998186214952],center=true);
color("#303b35")multmatrix([[-0.953448525995269,0,-0.30155581287292227,-136.5],[-0.30155581287292227,0,0.953448525995269,53.125],[0,1,0,260],[0,0,0,1]])cube([15,1.6,56.374307091085385],center=true);
color("#303b35")multmatrix([[0,0,1,-20],[1,0,0,80],[0,1,0,271],[0,0,0,1]])cube([15,1.6,160],center=true);
color("#303b35")multmatrix([[1,0,0,60],[0,0,-1,45.25],[0,1,0,271],[0,0,0,1]])cube([15,1.6,69.5],center=true);
color("#303b35")multmatrix([[0,0.8514606742132091,0.5244184591224715,-118],[-0.9327463542957252,-0.1890703017493407,0.3069799008802477,24.22872035518979],[0.3605332696826098,-0.4891494058718671,0.794196839698551,289.14433418357373],[0,0,0,1]])cube([15,1.6,38.13748286714912],center=true);
color("#303b35")multmatrix([[1,0,0,-108],[0,0.9970402198210326,-0.07688172773310245,59.907521970267716],[0,0.07688172773310245,0.9970402198210326,263.3375644728196],[0,0,0,1]])cube([15,1.6,6.6949445096983355],center=true);
color("#303b35")multmatrix([[1,0,0,-108],[0,0.973694228614433,-0.2278586166089497,58.88248765985344],[0,0.2278586166089497,0.973694228614433,269.9555867649812],[0,0,0,1]])cube([15,1.6,6.738168354987692],center=true);
color("#303b35")multmatrix([[1,0,0,-108],[0,0.9286821551154761,-0.37087660315807813,56.849957660269276],[0,0.37087660315807813,0.9286821551154761,276.4032662073838],[0,0,0,1]])cube([15,1.6,6.820894760633887],center=true);
color("#303b35")multmatrix([[1,0,0,-108],[0,0.8649669556719869,-0.5018288210092512,53.84470912333188],[0,0.5018288210092512,0.8649669556719869,282.5702812171336],[0,0,0,1]])cube([15,1.6,6.93620343995345],center=true);
color("#303b35")multmatrix([[1,0,0,-108],[0,0.7861738613767886,-0.6180053880735266,49.91816268472057],[0,0.6180053880735266,0.7861738613767886,288.35111245759396],[0,0,0,1]])cube([15,1.6,7.074867253665884],center=true);
color("#303b35")multmatrix([[1,0,0,-108],[0,0.6959764213224893,-0.718064635644411,45.13750264264433],[0,0.718064635644411,0.6959764213224893,293.64684830349154],[0,0,0,1]])cube([15,1.6,7.226388466861701],center=true);
color("#303b35")multmatrix([[1,0,0,-108],[0,0.5976524451738611,-0.8017552960708804,39.584527415872444],[0,0.8017552960708804,0.5976524451738611,298.36687724624767],[0,0,0,1]])cube([15,1.6,7.379978007078433],center=true);
color("#303b35")multmatrix([[1,0,0,-108],[0,0.49385822897091847,-0.869542436961939,33.35424995011057],[0,0.869542436961939,0.49385822897091847,302.4304382820125],[0,0,0,1]])cube([15,1.6,7.525358396911002],center=true);
color("#303b35")multmatrix([[1,0,0,-108],[0,0.38658453130595904,-0.9222539781182578,26.553272020157156],[0,0.9222539781182578,0.38658453130595904,305.7680027548321],[0,0,0,1]])cube([15,1.6,7.653355309831776],center=true);
color("#303b35")multmatrix([[1,0,0,-108],[0,0.27722680430599067,-0.9608045061167688,19.297960243981002],[0,0.9608045061167688,0.27722680430599067,308.3224640112289],[0,0,0,1]])cube([15,1.6,7.756298106913506],center=true);
color("#303b35")multmatrix([[1,0,0,-108],[0,0.16670947961697338,-0.9860060595178094,11.712455017624949],[0,0.9860060595178094,0.16670947961697338,310.05011451087546],[0,0,0,1]])cube([15,1.6,7.828272662522344],center=true);
color("#303b35")multmatrix([[1,0,0,-108],[0,0.05562568420108211,-0.9984516930012997,3.926546438611315],[0,0.9984516930012997,0.05562568420108211,310.9213936747276],[0,0,0,1]])cube([15,1.6,7.865270730942013],center=true);
color("#303b35")multmatrix([[1,0,0,-108],[0,-0.0556256842010822,-0.9984516930012997,-3.926546438611301],[0,0.9984516930012997,-0.0556256842010822,310.9213936747276],[0,0,0,1]])cube([15,1.6,7.865270730942],center=true);
color("#303b35")multmatrix([[1,0,0,-108],[0,-0.16670947961697283,-0.9860060595178095,-11.712455017624944],[0,0.9860060595178095,-0.16670947961697283,310.05011451087546],[0,0,0,1]])cube([15,1.6,7.82827266252237],center=true);
color("#303b35")multmatrix([[1,0,0,-108],[0,-0.27722680430599117,-0.9608045061167686,-19.297960243981002],[0,0.9608045061167686,-0.27722680430599117,308.3224640112289],[0,0,0,1]])cube([15,1.6,7.756298106913492],center=true);
color("#303b35")multmatrix([[1,0,0,-108],[0,-0.38658453130595954,-0.9222539781182576,-26.553272020157145],[0,0.9222539781182576,-0.38658453130595954,305.7680027548321],[0,0,0,1]])cube([15,1.6,7.653355309831766],center=true);
color("#303b35")multmatrix([[1,0,0,-108],[0,-0.49385822897091747,-0.8695424369619397,-33.354249950110564],[0,0.8695424369619397,-0.49385822897091747,302.4304382820125],[0,0,0,1]])cube([15,1.6,7.525358396911017],center=true);
color("#303b35")multmatrix([[1,0,0,-108],[0,-0.5976524451738615,-0.80175529607088,-39.58452741587244],[0,0.80175529607088,-0.5976524451738615,298.36687724624767],[0,0,0,1]])cube([15,1.6,7.379978007078427],center=true);
color("#303b35")multmatrix([[1,0,0,-108],[0,-0.6959764213224853,-0.718064635644415,-45.13750264264432],[0,0.718064635644415,-0.6959764213224853,293.6468483034916],[0,0,0,1]])cube([15,1.6,7.226388466861661],center=true);
color("#303b35")multmatrix([[1,0,0,-108],[0,-0.7861738613767911,-0.6180053880735232,-49.91816268472057],[0,0.6180053880735232,-0.7861738613767911,288.351112457594],[0,0,0,1]])cube([15,1.6,7.074867253665934],center=true);
color("#303b35")multmatrix([[1,0,0,-108],[0,-0.8649669556719869,-0.5018288210092512,-53.84470912333188],[0,0.5018288210092512,-0.8649669556719869,282.5702812171336],[0,0,0,1]])cube([15,1.6,6.93620343995345],center=true);
color("#303b35")multmatrix([[1,0,0,-108],[0,-0.9286821551154766,-0.37087660315807724,-56.84995766026927],[0,0.37087660315807724,-0.9286821551154766,276.4032662073838],[0,0,0,1]])cube([15,1.6,6.820894760633885],center=true);
color("#303b35")multmatrix([[1,0,0,-108],[0,-0.9736942286144327,-0.2278586166089507,-58.88248765985344],[0,0.2278586166089507,-0.9736942286144327,269.9555867649812],[0,0,0,1]])cube([15,1.6,6.738168354987693],center=true);
color("#303b35")multmatrix([[1,0,0,-108],[0,-0.9970402198210326,-0.07688172773310245,-59.907521970267716],[0,0.07688172773310245,-0.9970402198210326,263.3375644728196],[0,0,0,1]])cube([15,1.6,6.6949445096983355],center=true);
color("#303b35")multmatrix([[1,0,0,-108],[0,-0.9970402198210326,0.07688172773310245,-59.907521970267716],[0,-0.07688172773310245,-0.9970402198210326,256.6624355271804],[0,0,0,1]])cube([15,1.6,6.6949445096983355],center=true);
color("#303b35")multmatrix([[1,0,0,-108],[0,-0.9736942286144332,0.2278586166089487,-58.88248765985344],[0,-0.2278586166089487,-0.9736942286144332,250.0444132350188],[0,0,0,1]])cube([15,1.6,6.73816835498769],center=true);
color("#303b35")multmatrix([[1,0,0,-108],[0,-0.9286821551154761,0.37087660315807813,-56.84995766026928],[0,-0.37087660315807813,-0.9286821551154761,243.59673379261616],[0,0,0,1]])cube([15,1.6,6.820894760633887],center=true);
color("#303b35")multmatrix([[1,0,0,-108],[0,-0.8649669556719874,0.5018288210092502,-53.84470912333189],[0,-0.5018288210092502,-0.8649669556719874,237.42971878286642],[0,0,0,1]])cube([15,1.6,6.936203439953478],center=true);
color("#303b35")multmatrix([[1,0,0,-108],[0,-0.786173861376788,0.6180053880735272,-49.918162684720585],[0,-0.6180053880735272,-0.786173861376788,231.64888754240604],[0,0,0,1]])cube([15,1.6,7.074867253665853],center=true);
color("#303b35")multmatrix([[1,0,0,-108],[0,-0.6959764213224888,0.7180646356444116,-45.137502642644336],[0,-0.7180646356444116,-0.6959764213224888,226.35315169650843],[0,0,0,1]])cube([15,1.6,7.226388466861706],center=true);
color("#303b35")multmatrix([[1,0,0,-108],[0,-0.5976524451738565,0.8017552960708837,-39.58452741587245],[0,-0.8017552960708837,-0.5976524451738565,221.63312275375233],[0,0,0,1]])cube([15,1.6,7.379978007078393],center=true);
color("#303b35")multmatrix([[1,0,0,-108],[0,-0.4938582289709189,0.8695424369619389,-33.354249950110585],[0,-0.8695424369619389,-0.4938582289709189,217.56956171798754],[0,0,0,1]])cube([15,1.6,7.5253583969109945],center=true);
color("#303b35")multmatrix([[1,0,0,-108],[0,-0.38658453130596565,0.922253978118255,-26.55327202015718],[0,-0.922253978118255,-0.38658453130596565,214.23199724516792],[0,0,0,1]])cube([15,1.6,7.653355309831792],center=true);
color("#303b35")multmatrix([[1,0,0,-108],[0,-0.2772268043059895,0.960804506116769,-19.297960243981013],[0,-0.960804506116769,-0.2772268043059895,211.67753598877113],[0,0,0,1]])cube([15,1.6,7.756298106913539],center=true);
color("#303b35")multmatrix([[1,0,0,-108],[0,-0.16670947961696986,0.9860060595178101,-11.712455017624944],[0,-0.9860060595178101,-0.16670947961696986,209.9498854891246],[0,0,0,1]])cube([15,1.6,7.828272662522338],center=true);
color("#303b35")multmatrix([[1,0,0,-108],[0,-0.055625684201085795,0.9984516930012994,-3.926546438611316],[0,-0.9984516930012994,-0.055625684201085795,209.07860632527246],[0,0,0,1]])cube([15,1.6,7.865270730942003],center=true);
color("#303b35")multmatrix([[1,0,0,-108],[0,0.055625684201085795,0.9984516930012994,3.926546438611294],[0,-0.9984516930012994,0.055625684201085795,209.07860632527246],[0,0,0,1]])cube([15,1.6,7.865270730942003],center=true);
color("#303b35")multmatrix([[1,0,0,-108],[0,0.16670947961696986,0.9860060595178101,11.712455017624922],[0,-0.9860060595178101,0.16670947961696986,209.9498854891246],[0,0,0,1]])cube([15,1.6,7.828272662522338],center=true);
color("#303b35")multmatrix([[1,0,0,-108],[0,0.2772268043059894,0.9608045061167692,19.297960243980995],[0,-0.9608045061167692,0.2772268043059894,211.67753598877113],[0,0,0,1]])cube([15,1.6,7.756298106913542],center=true);
color("#303b35")multmatrix([[1,0,0,-108],[0,0.38658453130596265,0.9222539781182563,26.55327202015716],[0,-0.9222539781182563,0.38658453130596265,214.23199724516792],[0,0,0,1]])cube([15,1.6,7.6533553098317775],center=true);
color("#303b35")multmatrix([[1,0,0,-108],[0,0.49385822897091847,0.869542436961939,33.35424995011057],[0,-0.869542436961939,0.49385822897091847,217.5695617179875],[0,0,0,1]])cube([15,1.6,7.525358396911002],center=true);
color("#303b35")multmatrix([[1,0,0,-108],[0,0.5976524451738595,0.8017552960708815,39.58452741587243],[0,-0.8017552960708815,0.5976524451738595,221.63312275375233],[0,0,0,1]])cube([15,1.6,7.379978007078405],center=true);
color("#303b35")multmatrix([[1,0,0,-108],[0,0.6959764213224873,0.718064635644413,45.137502642644314],[0,-0.718064635644413,0.6959764213224873,226.3531516965084],[0,0,0,1]])cube([15,1.6,7.226388466861682],center=true);
color("#303b35")multmatrix([[1,0,0,-108],[0,0.786173861376787,0.6180053880735284,49.918162684720556],[0,-0.6180053880735284,0.786173861376787,231.648887542406],[0,0,0,1]])cube([15,1.6,7.074867253665862],center=true);
color("#303b35")multmatrix([[1,0,0,-108],[0,0.8649669556719869,0.5018288210092512,53.84470912333187],[0,-0.5018288210092512,0.8649669556719869,237.4297187828664],[0,0,0,1]])cube([15,1.6,6.93620343995345],center=true);
color("#303b35")multmatrix([[1,0,0,-108],[0,0.9286821551154767,0.3708766031580771,56.84995766026927],[0,-0.3708766031580771,0.9286821551154767,243.59673379261613],[0,0,0,1]])cube([15,1.6,6.820894760633945],center=true);
color("#303b35")multmatrix([[1,0,0,-108],[0,0.973694228614433,0.2278586166089497,58.88248765985344],[0,-0.2278586166089497,0.973694228614433,250.0444132350188],[0,0,0,1]])cube([15,1.6,6.738168354987692],center=true);
color("#303b35")multmatrix([[1,0,0,-108],[0,0.9970402198210326,0.07688172773310245,59.907521970267716],[0,-0.07688172773310245,0.9970402198210326,256.6624355271804],[0,0,0,1]])cube([15,1.6,6.6949445096983355],center=true);
color("#303b35")multmatrix([[0,0,1,0],[1,0,0,-49.5],[0,1,0,229],[0,0,0,1]])cube([15,1.6,59],center=true);
color("#303b35")multmatrix([[1,0,0,29.5],[0,0,-1,-29.25],[0,1,0,229],[0,0,0,1]])cube([15,1.6,40.5],center=true);
color("#303b35")multmatrix([[0,0,1,0],[1,0,0,49.5],[0,1,0,229],[0,0,0,1]])cube([15,1.6,59],center=true);
color("#303b35")multmatrix([[-1,0,0,29.5],[0,0,1,29.25],[0,1,0,229],[0,0,0,1]])cube([15,1.6,40.5],center=true);
color("#303b35")multmatrix([[-1,0,0,-29.5],[0,0,1,0],[0,1,0,229],[0,0,0,1]])cube([15,1.6,99],center=true);
color("#303b35")multmatrix([[1,0,0,-100],[0,1,0,-80],[0,0,1,249],[0,0,0,1]])cube([15,22,1.6],center=true);
color("#303b35")multmatrix([[1,0,0,-100],[0,1,0,-69],[0,0,1,260],[0,0,0,1]])cube([15,1.6,22],center=true);
color("#303b35")multmatrix([[1,0,0,-100],[0,1,0,-80],[0,0,1,271],[0,0,0,1]])cube([15,22,1.6],center=true);
color("#303b35")multmatrix([[1,0,0,-100],[0,1,0,-91],[0,0,1,260],[0,0,0,1]])cube([15,1.6,22],center=true);
color("#303b35")multmatrix([[1,0,0,60],[0,1,0,-10.5],[0,0,1,246],[0,0,0,1]])cube([34,15,1.6],center=true);
color("#303b35")multmatrix([[1,0,0,77],[0,1,0,-10.5],[0,0,1,260],[0,0,0,1]])cube([1.6,15,28],center=true);
color("#303b35")multmatrix([[1,0,0,60],[0,1,0,-10.5],[0,0,1,274],[0,0,0,1]])cube([34,15,1.6],center=true);
color("#303b35")multmatrix([[1,0,0,43],[0,1,0,-10.5],[0,0,1,260],[0,0,0,1]])cube([1.6,15,28],center=true);
color("#303b35")multmatrix([[1,0,0,-145],[0,1,0,-80],[0,0,1,249],[0,0,0,1]])cube([15,22,1.6],center=true);
color("#303b35")multmatrix([[1,0,0,-145],[0,1,0,-69],[0,0,1,260],[0,0,0,1]])cube([15,1.6,22],center=true);
color("#303b35")multmatrix([[1,0,0,-145],[0,1,0,-80],[0,0,1,271],[0,0,0,1]])cube([15,22,1.6],center=true);
color("#303b35")multmatrix([[1,0,0,-145],[0,1,0,-91],[0,0,1,260],[0,0,0,1]])cube([15,1.6,22],center=true);
color("#303b35")multmatrix([[1,0,0,-100],[0,1,0,80],[0,0,1,249],[0,0,0,1]])cube([15,22,1.6],center=true);
color("#303b35")multmatrix([[1,0,0,-100],[0,1,0,91],[0,0,1,260],[0,0,0,1]])cube([15,1.6,22],center=true);
color("#303b35")multmatrix([[1,0,0,-100],[0,1,0,80],[0,0,1,271],[0,0,0,1]])cube([15,22,1.6],center=true);
color("#303b35")multmatrix([[1,0,0,-100],[0,1,0,69],[0,0,1,260],[0,0,0,1]])cube([15,1.6,22],center=true);
color("#303b35")multmatrix([[1,0,0,60],[0,1,0,10.5],[0,0,1,246],[0,0,0,1]])cube([34,15,1.6],center=true);
color("#303b35")multmatrix([[1,0,0,77],[0,1,0,10.5],[0,0,1,260],[0,0,0,1]])cube([1.6,15,28],center=true);
color("#303b35")multmatrix([[1,0,0,60],[0,1,0,10.5],[0,0,1,274],[0,0,0,1]])cube([34,15,1.6],center=true);
color("#303b35")multmatrix([[1,0,0,43],[0,1,0,10.5],[0,0,1,260],[0,0,0,1]])cube([1.6,15,28],center=true);
color("#303b35")multmatrix([[1,0,0,-145],[0,1,0,80],[0,0,1,249],[0,0,0,1]])cube([15,22,1.6],center=true);
color("#303b35")multmatrix([[1,0,0,-145],[0,1,0,91],[0,0,1,260],[0,0,0,1]])cube([15,1.6,22],center=true);
color("#303b35")multmatrix([[1,0,0,-145],[0,1,0,80],[0,0,1,271],[0,0,0,1]])cube([15,22,1.6],center=true);
color("#303b35")multmatrix([[1,0,0,-145],[0,1,0,69],[0,0,1,260],[0,0,0,1]])cube([15,1.6,22],center=true);
color("#88958d")multmatrix([[0.39705935429903905,0.33388394932650106,-0.8549066484393303,-89.22852662644135],[-0.9177929337076148,0.14444624758096855,-0.36985323088510036,-64.44429703236007],[0,0.9314809659579287,0.3637900631656725,251.25759377829678],[0,0,0,1]])cube([3,3,24],center=true);
color("#88958d")multmatrix([[0.39705935429903905,0.33388394932650106,-0.8549066484393303,-81.28733954046056],[-0.9177929337076148,0.14444624758096855,-0.36985323088510036,-82.80015570651237],[0,0.9314809659579287,0.3637900631656725,251.25759377829678],[0,0,0,1]])cube([3,3,24],center=true);
color("#88958d")multmatrix([[0.39705935429903905,0.33388394932650106,-0.8549066484393303,-94.23445289206393],[-0.9177929337076148,0.14444624758096855,-0.36985323088510036,-77.50568529372977],[0,0.9314809659579287,0.3637900631656725,255.07738944153633],[0,0,0,1]])cube([17,3,3],center=true);
color("#88958d")multmatrix([[0.39705935429903905,0.33388394932650106,-0.8549066484393303,-76.28141327483799],[-0.9177929337076148,0.14444624758096855,-0.36985323088510036,-69.73876744514267],[0,0.9314809659579287,0.3637900631656725,247.4377981150572],[0,0,0,1]])cube([17,3,3],center=true);
color("#88958d")multmatrix([[0.39705935429903905,0.33388394932650106,-0.8549066484393303,-85.25793308345096],[-0.9177929337076148,0.14444624758096855,-0.36985323088510036,-73.62222636943622],[0,0.9314809659579287,0.3637900631656725,251.25759377829678],[0,0,0,1]])cube([17,3,3],center=true);
color("#88958d")multmatrix([[-0.7877180618901962,-0.31924483324063613,0.5268614537248968,61.90144373535542],[0.6160359201961791,-0.4082147047995019,0.6736916949269172,-24.301465380922934],[0,0.8552446967006659,0.5182243807130131,251.43293719758847],[0,0,0,1]])cube([3,3,24],center=true);
color("#88958d")multmatrix([[-0.7877180618901962,-0.31924483324063613,0.5268614537248968,46.1470824975515],[0.6160359201961791,-0.4082147047995019,0.6736916949269172,-11.980746976999352],[0,0.8552446967006659,0.5182243807130131,251.43293719758847],[0,0,0,1]])cube([3,3,24],center=true);
color("#88958d")multmatrix([[-0.7877180618901962,-0.31924483324063613,0.5268614537248968,59.55630838056488],[0.6160359201961791,-0.4082147047995019,0.6736916949269172,-11.067343382228513],[0,0.8552446967006659,0.5182243807130131,256.8742931950751],[0,0,0,1]])cube([17,3,3],center=true);
color("#88958d")multmatrix([[-0.7877180618901962,-0.31924483324063613,0.5268614537248968,48.492217852342044],[0.6160359201961791,-0.4082147047995019,0.6736916949269172,-25.214868975693776],[0,0.8552446967006659,0.5182243807130131,245.99158120010185],[0,0,0,1]])cube([17,3,3],center=true);
color("#88958d")multmatrix([[-0.7877180618901962,-0.31924483324063613,0.5268614537248968,54.02426311645346],[0.6160359201961791,-0.4082147047995019,0.6736916949269172,-18.141106178961145],[0,0.8552446967006659,0.5182243807130131,251.43293719758847],[0,0,0,1]])cube([17,3,3],center=true);
color("#88958d")multmatrix([[0.953448525995269,0,-0.30155581287292227,-150.7944852599527],[-0.30155581287292227,0,-0.953448525995269,-65.15944187127079],[0,1,0,257.7],[0,0,0,1]])cube([3,3,24],center=true);
color("#88958d")multmatrix([[0.953448525995269,0,-0.30155581287292227,-131.7255147400473],[-0.30155581287292227,0,-0.953448525995269,-71.19055812872924],[0,1,0,257.7],[0,0,0,1]])cube([3,3,24],center=true);
color("#88958d")multmatrix([[0.953448525995269,0,-0.30155581287292227,-144.42633603516566],[-0.30155581287292227,0,-0.953448525995269,-78.18620952295034],[0,1,0,257.7],[0,0,0,1]])cube([17,3,3],center=true);
color("#88958d")multmatrix([[0.953448525995269,0,-0.30155581287292227,-138.09366396483432],[-0.30155581287292227,0,-0.953448525995269,-58.16379047704969],[0,1,0,257.7],[0,0,0,1]])cube([17,3,3],center=true);
color("#88958d")multmatrix([[0.953448525995269,0,-0.30155581287292227,-141.26],[-0.30155581287292227,0,-0.953448525995269,-68.17500000000001],[0,1,0,257.7],[0,0,0,1]])cube([17,3,3],center=true);
color("#88958d")multmatrix([[-0.39705935429903905,0.33388394932650106,-0.8549066484393303,-81.28733954046056],[-0.9177929337076148,-0.14444624758096855,0.36985323088510036,82.80015570651237],[0,0.9314809659579287,0.3637900631656725,251.25759377829678],[0,0,0,1]])cube([3,3,24],center=true);
color("#88958d")multmatrix([[-0.39705935429903905,0.33388394932650106,-0.8549066484393303,-89.22852662644135],[-0.9177929337076148,-0.14444624758096855,0.36985323088510036,64.44429703236007],[0,0.9314809659579287,0.3637900631656725,251.25759377829678],[0,0,0,1]])cube([3,3,24],center=true);
color("#88958d")multmatrix([[-0.39705935429903905,0.33388394932650106,-0.8549066484393303,-94.23445289206393],[-0.9177929337076148,-0.14444624758096855,0.36985323088510036,77.50568529372977],[0,0.9314809659579287,0.3637900631656725,255.07738944153633],[0,0,0,1]])cube([17,3,3],center=true);
color("#88958d")multmatrix([[-0.39705935429903905,0.33388394932650106,-0.8549066484393303,-76.28141327483799],[-0.9177929337076148,-0.14444624758096855,0.36985323088510036,69.73876744514267],[0,0.9314809659579287,0.3637900631656725,247.4377981150572],[0,0,0,1]])cube([17,3,3],center=true);
color("#88958d")multmatrix([[-0.39705935429903905,0.33388394932650106,-0.8549066484393303,-85.25793308345096],[-0.9177929337076148,-0.14444624758096855,0.36985323088510036,73.62222636943622],[0,0.9314809659579287,0.3637900631656725,251.25759377829678],[0,0,0,1]])cube([17,3,3],center=true);
color("#88958d")multmatrix([[0.7877180618901962,-0.31924483324063613,0.5268614537248968,46.1470824975515],[0.6160359201961791,0.4082147047995019,-0.6736916949269172,11.980746976999352],[0,0.8552446967006659,0.5182243807130131,251.43293719758847],[0,0,0,1]])cube([3,3,24],center=true);
color("#88958d")multmatrix([[0.7877180618901962,-0.31924483324063613,0.5268614537248968,61.90144373535542],[0.6160359201961791,0.4082147047995019,-0.6736916949269172,24.301465380922934],[0,0.8552446967006659,0.5182243807130131,251.43293719758847],[0,0,0,1]])cube([3,3,24],center=true);
color("#88958d")multmatrix([[0.7877180618901962,-0.31924483324063613,0.5268614537248968,59.55630838056488],[0.6160359201961791,0.4082147047995019,-0.6736916949269172,11.067343382228513],[0,0.8552446967006659,0.5182243807130131,256.8742931950751],[0,0,0,1]])cube([17,3,3],center=true);
color("#88958d")multmatrix([[0.7877180618901962,-0.31924483324063613,0.5268614537248968,48.492217852342044],[0.6160359201961791,0.4082147047995019,-0.6736916949269172,25.214868975693776],[0,0.8552446967006659,0.5182243807130131,245.99158120010185],[0,0,0,1]])cube([17,3,3],center=true);
color("#88958d")multmatrix([[0.7877180618901962,-0.31924483324063613,0.5268614537248968,54.02426311645346],[0.6160359201961791,0.4082147047995019,-0.6736916949269172,18.141106178961145],[0,0.8552446967006659,0.5182243807130131,251.43293719758847],[0,0,0,1]])cube([17,3,3],center=true);
color("#88958d")multmatrix([[-0.953448525995269,0,-0.30155581287292227,-131.7255147400473],[-0.30155581287292227,0,0.953448525995269,71.19055812872924],[0,1,0,257.7],[0,0,0,1]])cube([3,3,24],center=true);
color("#88958d")multmatrix([[-0.953448525995269,0,-0.30155581287292227,-150.7944852599527],[-0.30155581287292227,0,0.953448525995269,65.15944187127079],[0,1,0,257.7],[0,0,0,1]])cube([3,3,24],center=true);
color("#88958d")multmatrix([[-0.953448525995269,0,-0.30155581287292227,-144.42633603516566],[-0.30155581287292227,0,0.953448525995269,78.18620952295034],[0,1,0,257.7],[0,0,0,1]])cube([17,3,3],center=true);
color("#88958d")multmatrix([[-0.953448525995269,0,-0.30155581287292227,-138.09366396483432],[-0.30155581287292227,0,0.953448525995269,58.16379047704969],[0,1,0,257.7],[0,0,0,1]])cube([17,3,3],center=true);
color("#88958d")multmatrix([[-0.953448525995269,0,-0.30155581287292227,-141.26],[-0.30155581287292227,0,0.953448525995269,68.17500000000001],[0,1,0,257.7],[0,0,0,1]])cube([17,3,3],center=true);
color("#596d5d")multmatrix([[1,0,0,-28],[0,1,0,-60],[0,0,1,232.5],[0,0,0,1]])cube([20,12,1.6],center=true);
color("#596d5d")multmatrix([[1,0,0,0],[0,1,0,-60],[0,0,1,232.5],[0,0,0,1]])cube([20,12,1.6],center=true);
color("#596d5d")multmatrix([[1,0,0,28],[0,1,0,-60],[0,0,1,232.5],[0,0,0,1]])cube([20,12,1.6],center=true);
color("#596d5d")multmatrix([[1,0,0,-130.5],[0,1,0,-26.25],[0,0,1,218],[0,0,0,1]])cube([1.6,12,20],center=true);
color("#596d5d")multmatrix([[1,0,0,-130.5],[0,1,0,-26.25],[0,0,1,260],[0,0,0,1]])cube([1.6,12,20],center=true);
color("#596d5d")multmatrix([[1,0,0,-28],[0,1,0,60],[0,0,1,232.5],[0,0,0,1]])cube([20,12,1.6],center=true);
color("#596d5d")multmatrix([[1,0,0,0],[0,1,0,60],[0,0,1,232.5],[0,0,0,1]])cube([20,12,1.6],center=true);
color("#596d5d")multmatrix([[1,0,0,28],[0,1,0,60],[0,0,1,232.5],[0,0,0,1]])cube([20,12,1.6],center=true);
color("#596d5d")multmatrix([[1,0,0,-130.5],[0,1,0,26.25],[0,0,1,218],[0,0,0,1]])cube([1.6,12,20],center=true);
color("#596d5d")multmatrix([[1,0,0,-130.5],[0,1,0,26.25],[0,0,1,260],[0,0,0,1]])cube([1.6,12,20],center=true);
color("#253129")multmatrix([[1,0,0,-108],[0,1,0,-60.164881420759144],[0,0,1,260],[0,0,0,1]])cube([12,23,40],center=true);
color("#65796b")multmatrix([[1,0,0,-134.8],[0,1,0,0],[0,0,1,215.66666666666666],[0,0,0,1]])cube([0.4,42,0.6],center=true);
color("#65796b")multmatrix([[1,0,0,-134.8],[0,1,0,0],[0,0,1,223.44444444444446],[0,0,0,1]])cube([0.4,42,0.6],center=true);
color("#65796b")multmatrix([[1,0,0,-134.8],[0,1,0,0],[0,0,1,231.22222222222223],[0,0,0,1]])cube([0.4,42,0.6],center=true);
color("#65796b")multmatrix([[1,0,0,-134.8],[0,1,0,0],[0,0,1,239],[0,0,0,1]])cube([0.4,42,0.6],center=true);
color("#65796b")multmatrix([[1,0,0,-134.8],[0,1,0,0],[0,0,1,246.77777777777777],[0,0,0,1]])cube([0.4,42,0.6],center=true);
color("#65796b")multmatrix([[1,0,0,-134.8],[0,1,0,0],[0,0,1,254.55555555555554],[0,0,0,1]])cube([0.4,42,0.6],center=true);
color("#65796b")multmatrix([[1,0,0,-134.8],[0,1,0,0],[0,0,1,262.3333333333333],[0,0,0,1]])cube([0.4,42,0.6],center=true);
}
if(sg_part=="assembly")sg_assembly();else if(sg_part=="rear_pattern")sg_saddle();else if(sg_part=="front_pattern")sg_bib();else if(sg_part=="rear_shell")sg_layer(false,.8);else if(sg_part=="rear_pad")sg_layer(false,5);else if(sg_part=="rear_mesh")sg_layer(false,1.5);else if(sg_part=="front_shell")sg_layer(true,.8);else if(sg_part=="front_pad")sg_layer(true,5);else if(sg_part=="front_mesh")sg_layer(true,1.5);
