stacksjs/buddy-wheels/(list of files, cad)

Other CAD files:
designs/wheelchair/r0/XL/stl/tube_cap.stl
designs/wheelchair/iterations/buddy-xl-estimate/stl/index_collar.stl
designs/wheelchair/r0/M/stl/coupon.stl
designs/wheelchair/r2/XL/parts/axle_cover.stl
public/designs/xl/r0/parts/index_collar.stl
designs/wheelchair/iterations/buddy-xl-estimate/stl/drill_jig.stl
designs/wheelchair/r0/XL/stl/inner_cap.stl
designs/wheelchair/r1/XL/parts/coupon.stl
public/designs/xl/r0/parts/inner_cap.stl
public/designs/xl/r1/parts/end_cap.stl
public/designs/xl/r2/parts/drill_guide.stl
public/designs/xs/r0/parts/coupon.stl
designs/wheelchair/iterations/buddy-xl-estimate/stl/pivot_guard.stl
designs/wheelchair/r0/XL/stl/index_collar.stl
designs/wheelchair/r0/XS/stl/coupon.stl
designs/wheelchair/r1/XL/parts/end_cap.stl
designs/wheelchair/r2/XL/parts/drill_guide.stl
public/designs/xl/r0/parts/coupon.stl
public/designs/xl/r1/parts/coupon.stl
public/designs/xl/r2/parts/axle_cover.stl
designs/rover/r0/parts/cap_light.stl
designs/wheelchair/iterations/buddy-xl-estimate/stl/tube_cap.stl
designs/wheelchair/r0/L/stl/inner_cap.stl
designs/wheelchair/r0/S/stl/inner_cap.stl
designs/wheelchair/r0/XL/stl/coupon.stl
designs/wheelchair/r0/XS/stl/pivot_guard.stl
public/designs/l/r0/parts/inner_cap.stl
public/designs/rover/r0/parts/cap_light.stl
public/designs/s/r0/parts/pivot_guard.stl
public/designs/xl/r0/parts/tube_cap.stl
designs/wheelchair/r0/L/model.scad
designs/wheelchair/r0/XL/model.scad
designs/wheelchair/r2/XL/model.scad
designs/softgoods/r1/XL-r1/softgoods/parts.scad
designs/softgoods/r1/XL-r2/softgoods/parts.scad
public/designs/xl/r2/model.scad
designs/rover/r0/metal/axle_hanger.dxf
designs/rover/r0/metal/corner_gusset.dxf
designs/rover/r0/metal/tee_gusset.dxf
designs/rover/r0/parts/FIT_CHECK_ONLY_axle_hanger.stl
designs/rover/r0/parts/FIT_CHECK_ONLY_axle_hanger_low.stl
designs/rover/r0/parts/FIT_CHECK_ONLY_corner_gusset.stl
designs/rover/r0/parts/FIT_CHECK_ONLY_tee_gusset.stl
designs/rover/r0/parts/axle_cover.stl
designs/rover/r0/parts/cable_clip.stl
designs/rover/r0/parts/cap_heavy.stl
designs/rover/r0/parts/coupon.stl
designs/rover/r0/parts/fabric_clip.stl
designs/rover/r0/parts/guide_butt.stl
designs/rover/r0/parts/guide_run.stl
designs/rover/r0/parts/guide_tee.stl
designs/rover/r0/parts/ramp_toe.stl
designs/rover/r0/parts/ridge_saddle.stl
designs/softgoods/r1/L-r0/softgoods/TEXTILE_REFERENCE_ONLY_front_mesh.stl
designs/softgoods/r1/L-r0/softgoods/TEXTILE_REFERENCE_ONLY_front_shell.stl
designs/softgoods/r1/L-r0/softgoods/TEXTILE_REFERENCE_ONLY_rear_mesh.stl
designs/softgoods/r1/M-r0/softgoods/TEXTILE_REFERENCE_ONLY_front_pad.stl
designs/softgoods/r1/M-r0/softgoods/TEXTILE_REFERENCE_ONLY_rear_mesh.stl
designs/softgoods/r1/M-r0/softgoods/saddle-shell.dxf
designs/softgoods/r1/S-r0/softgoods/TEXTILE_REFERENCE_ONLY_front_pad.stl
designs/softgoods/r1/S-r0/softgoods/TEXTILE_REFERENCE_ONLY_rear_shell.stl
designs/softgoods/r1/S-r0/softgoods/front-bib.dxf
designs/softgoods/r1/XS-r0/softgoods/TEXTILE_REFERENCE_ONLY_front_mesh.stl
designs/softgoods/r1/XS-r0/softgoods/TEXTILE_REFERENCE_ONLY_front_pad.stl
designs/softgoods/r1/XS-r0/softgoods/TEXTILE_REFERENCE_ONLY_rear_mesh.stl
designs/wheelchair/iterations/buddy-xl-estimate/stl/coupon.stl
designs/wheelchair/r0/L/stl/drill_jig.stl
designs/wheelchair/r0/S/stl/pivot_guard.stl
designs/wheelchair/r0/XL/stl/pivot_guard.stl
designs/wheelchair/r0/XS/stl/index_collar.stl
designs/wheelchair/r2/XL/parts/FIT_CHECK_ONLY_axle_plate.stl
designs/wheelchair/r2/XL/parts/FIT_CHECK_ONLY_joint_plate.stl
designs/wheelchair/r2/XL/parts/FIT_CHECK_ONLY_spring_seat.stl
public/designs/l/r0/parts/FIT_CHECK_ONLY_arm_plate.stl
public/designs/l/r0/parts/FIT_CHECK_ONLY_corner_plate.stl
public/designs/l/r0/parts/FIT_CHECK_ONLY_fixed_plate.stl
public/designs/l/r0/parts/drill_jig.stl
public/designs/l/r0/parts/shock_dummy.stl
public/designs/m/r0/parts/FIT_CHECK_ONLY_arm_plate.stl
public/designs/m/r0/parts/FIT_CHECK_ONLY_corner_plate.stl
public/designs/m/r0/parts/FIT_CHECK_ONLY_fixed_plate.stl
public/designs/m/r0/parts/coupon.stl
public/designs/m/r0/parts/shock_dummy.stl
public/designs/rover/r0/metal/axle_hanger.dxf
public/designs/rover/r0/metal/corner_gusset.dxf
public/designs/rover/r0/metal/tee_gusset.dxf
public/designs/rover/r0/parts/FIT_CHECK_ONLY_axle_hanger.stl
public/designs/rover/r0/parts/FIT_CHECK_ONLY_axle_hanger_low.stl
public/designs/rover/r0/parts/FIT_CHECK_ONLY_corner_gusset.stl
public/designs/rover/r0/parts/FIT_CHECK_ONLY_tee_gusset.stl
public/designs/rover/r0/parts/axle_cover.stl
public/designs/rover/r0/parts/cable_clip.stl
public/designs/rover/r0/parts/cap_heavy.stl
public/designs/rover/r0/parts/coupon.stl
public/designs/rover/r0/parts/fabric_clip.stl
public/designs/rover/r0/parts/guide_butt.stl
public/designs/rover/r0/parts/guide_run.stl
public/designs/rover/r0/parts/guide_tee.stl
public/designs/rover/r0/parts/ramp_toe.stl
public/designs/rover/r0/parts/ridge_saddle.stl
public/designs/s/r0/parts/FIT_CHECK_ONLY_arm_plate.stl
public/designs/s/r0/parts/FIT_CHECK_ONLY_corner_plate.stl
public/designs/s/r0/parts/FIT_CHECK_ONLY_fixed_plate.stl
public/designs/s/r0/parts/inner_cap.stl
public/designs/s/r0/parts/shock_dummy.stl
public/designs/xl/r0/metal/arm_plate.dxf
public/designs/xl/r0/metal/fixed_plate.dxf
public/designs/xl/r0/parts/pivot_guard.stl
public/designs/xl/r2/parts/FIT_CHECK_ONLY_axle_plate.stl
public/designs/xl/r2/parts/FIT_CHECK_ONLY_joint_plate.stl
public/designs/xl/r2/parts/FIT_CHECK_ONLY_spring_seat.stl
public/designs/xs/r0/parts/FIT_CHECK_ONLY_arm_plate.stl
public/designs/xs/r0/parts/FIT_CHECK_ONLY_corner_plate.stl
public/designs/xs/r0/parts/FIT_CHECK_ONLY_fixed_plate.stl
public/designs/xs/r0/parts/index_collar.stl
public/designs/xs/r0/parts/pivot_guard.stl
public/designs/xs/r0/parts/shock_dummy.stl
