stacksjs/buddy-wheels/docs/engineering/rover-r0-assembly.md

# Buddy Rover r0 bench assembly

Configuration rover-r0-l1300-w700-h1000-r1000-a560-g1000-hub101.6-trail-swivel310-k350-t180-welded-sprung. All dimensions mm. BENCH DESIGN. NOT FOR ANIMAL USE. No payload, speed, distance, slope or surface rating exists. Buddy is owner-reported 140 lb; his measurements and suitability for a carrier are not established.

## What this revision is

A large cut-to-fit carrier built from 1 inch square aluminum tube, 1/8 inch wall 6061-T6 for the chassis and 1/16 inch wall 6063-T52 for the cabin, three repeated flat metal profiles, plywood panels and printed service parts. The tailgate is the ramp: it folds down to a 8.0 degree walk-in with no step, and stands on its own two feet so the dog's weight on the threshold goes to the ground instead of tipping the carrier. Two 15 inch trail (4.00-8) wheels at the rear and a 10 inch swivel caster on a raised nose at the front, so it steers by pushing the handle sideways.

Coordinates: X forward, Y across, Z up. Origin on the ground under the rear axle.

## Your configuration

| Item | Value |
| --- | ---: |
| Clear cabin length at the floor | 1300 (51.2 in) |
| Front rake, top set back from bottom | 350 |
| Clear cabin width between side rails | 700 (27.6 in) |
| Clear cabin height, deck to top rail | 1000 (39.4 in) |
| Deck height above ground | 151.9 (6.0 in) |
| Ramp length and width | 1000 x 688 |
| Ramp rise and incline | 139.9 rise, 8.0 degrees |
| Rear axle ahead of the tailgate plane | 560 |
| Front wheel | swivel caster, mounting height 310 |
| Kit | on wheels |
| Wheelbase | 913.4 |
| Handle height | 1000 (39.4 in) |
| Overall length, width over axle ends, height | 2120.8 x 1078.9 x 1254 |
| Ground clearance under the base gussets | 108.125 |
| Rear wheel | 15 inch trail (4.00-8) |
| Assumed wheel hub through-length | 101.6 |
| Estimated empty mass, arithmetic only | 45.9 kg (101 lb) |

## Stated geometry beside the reference trailer

Burley Bark Ranger XL figures are the maker's published numbers, read 2026-11-11 at https://burley.com/products/bark-ranger-xl-ski-bundle. They describe that product only. Nothing about its capacity, testing or use transfers to Rover.

| Stated figure | Burley Bark Ranger XL | Rover r0, this configuration |
| --- | ---: | ---: |
| Interior length | 36.2 in | 51.2 in |
| Interior width | 22.4 in | 27.6 in |
| Interior height | 29.9 in | 39.4 in |
| Interior volume ratio | 1.0 | 2.29 |
| Entry | 9 in step-up at a tailgate | 8.0 degree ramp, no step |
| Weight | 33 lb | about 101 lb estimated |
| Capacity | 100 lb stated by its maker | none. Untested bench design |

Rover is much larger and much heavier. The mass is the price of a bolted frame and plywood panels and is the first thing a second revision should reduce.

## Planning statics, not test results

With a 72.6 kg (160 lb) planning mass centered in the cabin, its center sits 90 mm ahead of the rear axle and the front wheel carries about 10% of that mass. The swivel caster steers without lifting anything. Lifting the front to climb a curb takes roughly 108 N (24 lbf) down on the handle. A swivel caster can shimmy at a run, so lock the swivel with its bolt-on lock before running and steer by lifting the front as with a fixed wheel. A dog that stands at the tailgate moves the center behind the axle. The two tip-stop feet exist for that case and their setting and strength are unproven.

## Cut list

| ID | Qty | Member | Stock | Cut |
| --- | ---: | --- | --- | ---: |
| C01 | 2 | Base side rail | 1/8 wall 6061-T6 | 1678.65 |
| C02 | 2 | Base end cross member | 1/8 wall 6061-T6 | 700 |
| C03 | 2 | Axle post | 1/8 wall 6061-T6 | 922.6122 |
| C06 | 2 | Ramp side curb rail | 1/8 wall 6061-T6 | 1000 |
| C07 | 2 | Ramp under rib | 1/16 wall 6063-T52 | 688 |
| C08 | 2 | Ramp stand leg | 1/8 wall 6061-T6 | 107.3571 |
| C11 | 3 | Top cross tube | 1/16 wall 6063-T52 | 725.4 |
| C14 | 3 | Base intermediate cross member | 1/16 wall 6063-T52 | 700 |
| C17 | 2 | Brake arm | 1/8 wall 6061-T6 | 140 |
| C26 | 2 | Side hoop | 1 inch round, 1/8 wall 6063-T52 | 2882.2637 |
| C27 | 1 | Handle bar | 1 inch round, 1/8 wall 6063-T52 | 2696.1894 |
| C28 | 2 | Nose hoop | 1 inch round, 1/8 wall 6063-T52 | 1031.9894 |
| C22 | 2 | Swing arm | 1/8 wall 6061-T6 | 357.8103 |
| C23 | 2 | Shock spacer tube | 1/8 wall 6061-T6 | 60 |

Total 9.93 m of 1/8 inch wall 6061-T6 and 5.65 m of 1/16 inch wall 6063-T52 square tube, and 10.52 m of 1 inch round 6063-T52 in the bent tubes. Base cross members sit at X = -572.7, -241.35, 95, 421.35, 752.7.

## Joints

The frame is welded by a fabrication shop and arrives in one piece: 29 tubes, 10 bends and 36 welded joints, with no gussets. The base, posts and cross tubes are square tube. The bent tubes are round, 1 inch across with a 1/8 inch wall, so a mail-order service can cut and bend them. Each cabin side is one hoop bent from a single tube: up the rear, along the roof, which falls 180 from rear to front, 10.2 degrees, and down the front pillar, which leans back 22.7 degrees from upright. The handle is one bent bar and the caster hangs from two bent hoops across the nose.

| Bent tube | Qty | Ordered length | Bends, all at 76.2 mm (3 inch) centerline radius | Shape |
| --- | ---: | ---: | --- | --- |
| C26 Side hoop | 2 | 2882.2637 | 100.2 degrees, 57.1 degrees | Rear post, roof run and front pillar in one. Both bends turn the same way |
| C27 Handle bar | 1 | 2696.1894 | 90.0 degrees, 90.0 degrees | A flat U: two arms and the grip between them |
| C28 Nose hoop | 2 | 1031.9894 | 90.0 degrees, 90.0 degrees | An upside-down U across the carrier that carries the caster |

The welds are listed in weld-schedule.csv and the bends in bend-schedule.csv.

| Weld | Qty | Joint | How |
| --- | ---: | --- | --- |
| W01 | 10 | Base cross member to base side rail | Square tee, fillet all round |
| W02 | 2 | Side hoop rear foot to base side rail | Round tube cut square, standing on the top face of the rail, fillet all round |
| W04 | 2 | Side hoop front foot to base side rail | Round tube standing on the top face of the rail, foot sawn 22.7 degrees off square so the pillar leans back, fillet all round |
| W06 | 2 | Axle post to base side rail | Square tee, fillet all round |
| W07 | 2 | Axle post to the roof run of the side hoop | Tee onto round tube: post top cut 10.2 degrees off square and notched (coped) to the 25.4 round tube, fillet all round |
| W08 | 6 | Top cross tube to the roof run of the side hoop | Tee onto round tube: end notched (coped) to the 25.4 round tube, fillet all round |
| W09 | 4 | Nose hoop foot to base side rail | Round tube cut square, standing on the top face of the rail, fillet all round |
| W11 | 2 | Brake arm to axle post | Square tee, fillet all round |
| W12 | 4 | Handle bar arm to the rear leg of the side hoop and to the axle post | Crossing lap: the round arm lies against the outside of the hoop leg (round on round) and of the axle post (round on flat). Fillet round each contact. A small weld; the shop may add a through bolt |
| W14 | 2 | Ramp leg to ramp rib | Square tee, fillet all round |

What still bolts on: the two swing arms on their pivot bolts, the two shocks, the two brake clamp plates and the caster. Tube bores are 9.725 for the 1/4 inch sleeves, plate holes 6.75, axle sleeve bores 19.25. All are nominal.

Welding softens the aluminum beside each weld. No strength figure exists for this frame in either build, and nothing here allows for that loss. A welded sample joint, a weld procedure and an engineer's review come before any load.

## Build order

1. Print the clearance coupon and measure it. Print one cap and one clip before batching.
2. The shop cuts and bends the tubes from cut-list.csv and bend-schedule.csv. The axle posts and the front foot of each side hoop have an angled end.
3. The shop tacks the base ladder flat: two side rails, 5 cross members. Check the diagonals, then weld.
4. Axle posts at X = 0, then a side hoop on each rail, resting on its axle post, then the two nose hoops. Tack, check both axle posts are square and in line, then weld.
5. Three top cross tubes between the roof runs of the hoops. Handle bar on the outside of the rear and axle posts at Z = 1000. Brake arms on the axle posts.
6. Drill for the hangers, the brake plates, the caster and the tip-stops after welding, from drilling.csv.
7. Swing arms on their pivot bolts outside the base rails, shocks between the tabs, axle sleeves through the arms. Bolt the caster under the beams; its swivel axis sits 205 ahead of the cabin front.
8. Floor panel on bedding tape, fastened to the frame.
9. Ramp: panel, two curb rails on top, two ribs underneath at 40 mm and mid length, stand legs welded to the hinge-end rib 60 mm in from each edge. Hinge leaves on the top faces of floor and ramp.
10. Wheels, washers and cotters. Rear stack between outer washer faces 142.7, with 0.5 total end float.
11. Tip-stop feet, the brake plates and clamps, latches, safety strap. Then the cover.

## The ramp

Lowered, the panel runs from the deck at 151.9 down to the ground over 1000. The two capped stand legs under the hinge end touch the ground directly below the threshold, so the hinge carries no bending on level ground. The walking width between the curb rails is 637.2. Three printed toes slide onto the ground edge and take the last 20 mm down to nothing.

Raised, the ramp is the tailgate. Two draw latches hold it to the rear posts and the safety strap is a second, independent hold. The stand legs then point backward about 110 mm at shin height. The handle reaches 380 mm behind the tailgate. Stride clearance has to be checked by a runner before this layout is accepted.

The rear axles sit in the swing arms outside the frame, so nothing stands into the cabin at the axle. The carrier is 1078.9 wide over the axle ends.

## Rear suspension

Each rear wheel hangs on a trailing swing arm outside the base rail. The arm pivots on one 1/2 inch bolt through the rail, 300 mm ahead of the axle, and a coil-over shock runs from a pair of plates bolted to the arm up to a pair hung from the axle post around a short spacer tube. Nothing in it is welded, so it fits either frame.

| | |
| --- | --- |
| Arm, pivot to axle | 307.8103 mm |
| Shock, as its seller states | 150 mm eye to eye, 30 mm travel, spring labeled 450 lbs |
| Shock movement per unit of wheel movement | 0.51 |
| Rate at the wheel | 20.7 N/mm (118 lb/in) |
| Wheel travel | about 59 mm |
| Settles under its own weight | about 7 mm |
| Settles with the 72.6 kg planning mass | about 22 mm, on 46.5 kg per rear wheel |

These are arithmetic from the drawn geometry and one candidate shock, taking the seller's spring label as pounds per inch, which nobody has checked. No shock has been fitted or measured, and the tires add their own give on top. The same shock is sold with softer and stiffer springs, so the settle can be tuned once a real one is on the frame. There is no ride measurement and no comparison with any other carrier. Open points: side play at a single-bolt pivot, the parking brake pad on a tire that now moves with the load, and the unsprung front caster.

## Printing

- Chassis tube cap, cap_heavy.stl, quantity 16. Closes 1/8 inch wall tube ends. End protection only.
- Ramp threshold toe, ramp_toe.stl, quantity 3. Ground-supported bevel that removes the step at the ramp edge. It is not the ramp structure.
- Roof ridge saddle, ridge_saddle.stl, quantity 3. Holds the ridge pole above the frame so the roof sheds water. Carries fabric tension only.
- Cover rail clip, fabric_clip.stl, quantity 28. Snaps a cover hem onto a frame tube. No restraint or structural function.
- Brake cable clip, cable_clip.stl, quantity 6. Routes one brake cable housing along a tube. Not a brake anchor.
- Axle end cover, axle_cover.stl, quantity 4. Covers a shaft end and cotter. Never a shaft retainer or a complete fur guard.
- Drill guide, butt ends, guide_butt.stl, quantity 1. Pilot centers 22.3, 37.3, 52.3 and 67.3 mm from a cut end. Layout aid only.
- Drill guide, corner runs, guide_run.stl, quantity 1. Pilot centers 47.7, 62.7, 77.7 and 92.7 mm from a rail end. Layout aid only.
- Drill guide, tee pattern, guide_tee.stl, quantity 1. Pilot centers 30 mm each side of a scribed joint line. Layout aid only.
- Clearance coupon, coupon.stl, quantity 1. Calibrates the actual printer before any fit is trusted. Not part of the carrier.

Meshes are exported in print orientation at 1:1 in millimeters and fit a 220 x 220 x 100 mm envelope. Never scale one to fit. Use PETG for indoor fit trials and ASA for parts that will live in sun. Starting point only: 0.4 mm nozzle, 0.2 mm layers, four walls, 30% infill; five walls and 50% for the ramp toes, which carry paw load against the ground. Print clips on end so the snap flexes along the layers. The ramp toe slot is an 18 mm overhang and needs support or a slower bridge. Record filament, settings, measured fit, grams and failures.

Files prefixed FIT_CHECK_ONLY are plastic copies of metal parts for checking hole patterns. Cut the real ones from metal/*.dxf. No printed part here carries the dog, a wheel, the ramp hinge, a latch, a brake or a tether.

## Release gates

1. Buddy's measurements, lying length and standing height first, and a veterinary view on whether riding suits him.
2. Engineering review of the frame, the axle hangers, the ramp and its stand, the handle and the tip-stops, including steel-to-aluminum corrosion.
3. A measured wheel: actual hub length, bearing fit and a rating that suits the carrier, then the parking brake proven on a slope with ballast. The 13 inch candidate is a garden-cart wheel for walking pace; a running wheel is still an open selection. Until wheel and brake are proven the running gear is a placeholder. There is no brake for slowing while moving.
4. Ballast tests to an approved plan: static proof, ramp load at mid span and at the threshold, tip in every direction, curb and brake events, fatigue.
5. Cover tests listed in materials.md.
6. Only then a supervised, consented fit and handling study with stop rules.

Digital mesh checks and a tidy drawing prove none of this.
