stacksjs/buddy-wheels/docs/business/xl-prototype-build-budget.md

# One XL prototype: complete cash and development budget

Checked 2026-11-08. USD, integer cents. Generated by native Bun from app/Designs/PrototypeBudget.ts. All values are planning assumptions except the two explicitly observed retail listings. No quote, purchase, reservation, capacity or animal-use approval is implied.

## The answer

Budget **$3,012.12 for the first DIY bench rig including a printer and all listed equipment**, with an illustrative range of **$1,972.54-$4,932.92**. Paid assembly raises the base to **$3,362.12**. Adding the separately itemized engineering, fitting and testing allowances produces **$5,312.12**, which is a development budget, not a guarantee of a safe finished device. Exact shocks, wheel interfaces, harness anchors and test scope remain unresolved and can exceed the high case.

If all suitable equipment and the bench fixture are already owned, base DIY cash falls to **$2,030.97**. This is a one-off XL r0 custom suspension rig. Do not substitute the storefront's $264.50 future retail planning target or the unquoted $155 production COGS envelope for this build budget. The current r0 design has not demonstrated those production economics.

The printer-only P2S listing is $549, before tax/shipping, from [Additive Plus](https://additiveplus.com/product/bambu-lab-p2s/). Its listed 256 mm bed is larger than the current nominal 220 mm part envelope. Check actual slicer placement, brim and excluded areas. The current parts do not require AMS, a laser bundle or a larger printer. [Printer options and LA support](../engineering/printer-options-la.md) remain separate.

## Full scenario reconciliation

| Cost group | Low | Base | High |
| --- | ---: | ---: | ---: |
| Installed device hardware | $802.00 | $1,427.00 | $2,588.00 |
| Spool + power | $21.00 | $28.00 | $43.00 |
| Printer, equipment + fixture | $758.99 | $893.99 | $1,123.99 |
| Shipping | $60.00 | $120.00 | $240.00 |
| Illustrative tax reserve | $154.15 | $228.73 | $365.33 |
| Build contingency | $176.40 | $314.40 | $572.60 |
| DIY cash total | $1,972.54 | $3,012.12 | $4,932.92 |
| Paid assembly, if used | $150.00 | $350.00 | $960.00 |
| Cash with paid assembly | $2,122.54 | $3,362.12 | $5,892.92 |
| Engineering, fitting + testing allowances | $1,000.00 | $1,950.00 | $3,610.00 |
| Development budget with paid assembly | $3,122.54 | $5,312.12 | $9,502.92 |

These are favorable/base/stress planning scenarios, not confidence intervals, minimum offers or maximum prices. Every case is unquoted. All quantities below are complete purchase-line quantities; amounts are not per-part prices.

## Purchased device hardware

| Purchase line | Full quantity | BOM coverage | Low | Base | High | Evidence |
| --- | --- | --- | ---: | ---: | ---: | --- |
| Outer aluminum tube stock | 3 m, 25 x 25 x 2 mm | M01, M02, M04 | $45.00 | $65.00 | $100.00 | Unquoted allowance |
| Inner aluminum tube stock | 1 m, 20 x 20 x 2 mm | M03, M05 | $20.00 | $30.00 | $45.00 | Unquoted allowance |
| External frame finish and masking | 1 small-batch finish operation | Additional item | $35.00 | $70.00 | $140.00 | Unquoted allowance |
| Metal cheeks and fabrication | 16 plates: 4 fixed, 4 arm, 8 corner | M06, M07, M08 | $120.00 | $220.00 | $400.00 | Unquoted allowance |
| Machined pins and axles | 10 retained pivot/stop/lock/eye pins, 2 axles | S02, S06, S07, S11, S12, W02 | $100.00 | $200.00 | $400.00 | Unquoted allowance |
| Metal spacers and crush sleeves | 38 spacers and 26 sleeves | S04, S05, S08, S09, S10, W03, W04, H05, H06, H07a, H07b | $80.00 | $150.00 | $300.00 | Unquoted allowance |
| Bronze pivot bushes | 4, nominal 10 ID / 14 OD / 6 long | S03 | $12.00 | $24.00 | $48.00 | Unquoted allowance |
| Frame fastener sets | 26 bolts, 52 washers, 26 locknuts | H01, H02, H03, H04, H08, H09 | $25.00 | $40.00 | $65.00 | Unquoted allowance |
| Pin washers and retainers | 12 end washers and 12 cotters | H10, H11 | $10.00 | $18.00 | $30.00 | Unquoted allowance |
| Wheel, tire and bearing assemblies | 2, requested 400 mm OD / 12 mm bore / 40 mm hub | W01 | $90.00 | $140.00 | $220.00 | Unquoted allowance |
| Adjustable spring/damper assemblies | 2 matched units | S01 | $120.00 | $220.00 | $400.00 | Unquoted allowance |
| Padded rear support | 1 professionally selected harness | T01 | $80.00 | $130.00 | $220.00 | Unquoted allowance |
| Front harness and paired tethers | 1 fitted set | T02 | $35.00 | $60.00 | $100.00 | Unquoted allowance |
| Support anchor interface reserve | 1 interface set, design unresolved | Additional item | $30.00 | $60.00 | $120.00 | Unquoted allowance |

## Reusable equipment charged once

| Purchase line | Full quantity | BOM coverage | Low | Base | High | Evidence |
| --- | --- | --- | ---: | ---: | ---: | --- |
| Bambu Lab P2S, printer only | 1, no AMS or laser bundle | Additional item | $549.00 | $549.00 | $549.00 | [Observed listing](https://additiveplus.com/product/bambu-lab-p2s/) |
| Filament dryer | 1 single-spool dryer | Additional item | $40.00 | $60.00 | $90.00 | Unquoted allowance |
| Digital caliper for printed/metal parts | 1, 150 mm range | Additional item | $24.99 | $24.99 | $24.99 | [Observed listing](https://www.harborfreight.com/6-in-digital-caliper-63711.html) |
| Hand tools and measuring supplies | Wrenches, clamps, deburring tools, tape, ruler, boards | Additional item | $60.00 | $100.00 | $180.00 | Unquoted allowance |
| Cleanup supplies and spare nozzle | 1 starter set | Additional item | $20.00 | $35.00 | $60.00 | Unquoted allowance |
| Dry storage and desiccant | 1 starter set | Additional item | $15.00 | $25.00 | $40.00 | Unquoted allowance |
| Empty-rig catch/cradle and scales | 1 bench fixture allowance | T03 | $50.00 | $100.00 | $180.00 | Unquoted allowance |

## Consumables

| Purchase line | Full quantity | BOM coverage | Low | Base | High | Evidence |
| --- | --- | --- | ---: | ---: | ---: | --- |
| Initial PETG purchase | 1 full 1 kg spool, 1.75 mm | P-tube_cap, P-inner_cap, P-index_collar, P-pivot_guard, P-drill_jig, P-coupon, P-shock_dummy | $20.00 | $25.00 | $35.00 | Unquoted allowance |
| Printer and dryer electricity | One printing/iteration allowance | Additional item | $1.00 | $3.00 | $8.00 | Unquoted allowance |

A full initial spool is charged once in the cash budget. No consumed-gram charge is added again. Service/fixture parts and optional unloaded plate copies must be sliced to establish actual grams, supports, failed-print needs and hours. A spool does not promise a complete set plus unlimited iterations. The current metal plates, pins, compression spacers, sleeves, axles, real shocks and harness anchors are not printable substitutes.

## Line-by-line procurement notes

- **Outer aluminum tube stock** (M01, M02, M04): 2,252.5 mm net cut length. Exact metric 6061-T6 stock, kerf and delivery need a quote. Imperial tube is not a drop-in replacement.
- **Inner aluminum tube stock** (M03, M05): 622.5 mm net cut length. Actual telescoping and corner radii must be checked.
- **External frame finish and masking** (finish): Candidate matte forest coating on exterior outer tubes only. Mask sliding sections, tube interiors, bores, bearing interfaces and clamped joint faces. Exact process, adhesion, corrosion behavior and quote are pending. Separate from metal cutting/deburring and finish-hole work.
- **Metal cheeks and fabrication** (M06, M07, M08): 6 mm plate stock, cutting, deburring and finish-hole work. Includes outsourced tube drilling/match-fitting allowance; no drill press purchase assumed. Shop RFQ required.
- **Machined pins and axles** (S02, S06, S07, S11, S12, W02): Headed shafts, finish fits and cross-holes are custom work. Drawing approval and actual quote pending.
- **Metal spacers and crush sleeves** (S04, S05, S08, S09, S10, W03, W04, H05, H06, H07a, H07b): Small-quantity material and machining. These are metal compression/load-path parts, not prints.
- **Bronze pivot bushes** (S03): Supplier press/running fits pending.
- **Frame fastener sets** (H01, H02, H03, H04, H08, H09): M6 nominal. Lengths and grades require the final joint drawing.
- **Pin washers and retainers** (H10, H11): Positive retention, not friction caps. Final pin-end ligaments and cotter fit pending.
- **Wheel, tire and bearing assemblies** (W01): RFQ only. A nominal 16-inch wheel is not automatically compatible or load rated for this rig.
- **Adjustable spring/damper assemblies** (S01): 165 extended / 38 stroke / 155 installed / 8 pin / 20 eye width / 40 maximum body, all mm. No approved purchasable SKU or spring tune yet. This allowance can be exceeded.
- **Padded rear support** (T01): Capacity, anatomy and attachment compatibility need fitting and supplier review.
- **Front harness and paired tethers** (T02): Supplier-rated softgoods; not a homemade printed saddle.
- **Support anchor interface reserve** (anchors): Additional allowance beyond the current BOM, because the harness anchor load path is not yet designed. Not an approved part or purchase instruction.
- **Initial PETG purchase** (P-tube_cap, P-inner_cap, P-index_collar, P-pivot_guard, P-drill_jig, P-coupon, P-shock_dummy): Cash purchase, not a measured print mass. Covers service/fixture prints and some fit-check iterations only as far as the actual slicer yield allows. Metal-part plastic copies are unloaded gauges. Do not charge consumed grams again.
- **Printer and dryer electricity** (electricity): Unmeasured allowance. Log actual hours, kWh and utility tariff; no print time is represented as observed.
- **Bambu Lab P2S, printer only** (printer): Seller lists printer-only at $549. Verify configuration, current stock, freight and checkout price. The 256 mm bed accommodates the current nominal 220 mm part envelope; check brim and exclusions. [Reference](https://additiveplus.com/product/bambu-lab-p2s/).
- **Filament dryer** (dryer): SUNLU S2 is a capability reference, not a verified price. Match the filament maker drying guidance. [Reference](https://www.sunlu.com/products/filadryer-s2-filament-dryer).
- **Digital caliper for printed/metal parts** (calipers): Harbor Freight item 63711 regular listed price, no membership coupon assumed. Not a tool to squeeze or measure Buddy body width. [Reference](https://www.harborfreight.com/6-in-digital-caliper-63711.html).
- **Hand tools and measuring supplies** (tools): Supplier fabricates metalwork. Borrowing an already suitable tool reduces cash outlay; calibration/torque procedure still needs approval.
- **Cleanup supplies and spare nozzle** (spares): Check printer-specific consumables. No extra build plate assumed.
- **Dry storage and desiccant** (storage): Reusable storage, not additional filament.
- **Empty-rig catch/cradle and scales** (T03): Testing equipment, not part of the wearable chair. This is not a qualified test program or calibrated lab quote.

## Assembly, professional work and test allowances

| Work | Low | Base | High | Basis |
| --- | ---: | ---: | ---: | --- |
| Paid assembly, if used | $150.00 | $350.00 | $960.00 | 6 h x $25 / 10 h x $35 / 16 h x $60. Illustrative labor, not a quote. DIY cash scenarios exclude this line, but your time is not free economically. |
| Mechanical engineering review | $600.00 | $1,200.00 | $2,160.00 | 6 h x $100 / 8 h x $150 / 12 h x $180. Unquoted planning allowance, not a scope or sign-off commitment. |
| Veterinary/rehabilitation fitting | $150.00 | $250.00 | $450.00 | Unquoted visit allowance. Buddy care continues independently; treatment and ongoing care are additional. |
| Bench testing and additional specimens | $250.00 | $500.00 | $1,000.00 | Unquoted development allowance beyond the reusable cradle. Actual test protocol, repetitions and failures can cost more. |

DIY cash excludes paying yourself for assembly. The separate labor line shows the economic value and a paid-labor scenario. The engineering, fitting and test entries are illustrative placeholders, not provider quotes or evidence that this scope completes validation. Ongoing veterinary treatment, liability insurance, business overhead, production certification, complete durability/environmental studies, room ventilation work and an in-house machine shop are not included.

## Math, tax and contingency

Base hardware = $1,427.00; equipment = $893.99; spool and power = $28.00; freight = $120.00. The tax reserve is round($2,345.99 x 9.75%) = $228.73. It includes goods, equipment and fabrication, excludes electricity/shipping and makes no statement about address-specific rates or taxable labor. Confirm actual checkout charges and location with the [CDTFA rate lookup](https://cdtfa.ca.gov/taxes-and-fees/sales-use-tax-rates.htm). The 9.75% input is an illustrative LA planning rate, not a verified rate for the owner's address.

Contingency = round(20% x [hardware + spool + freight]) = round(20% x $1,572.00) = $314.40. It is a reserve, not a measured print failure rate and not a second printer charge. The total is $1,427.00 + $893.99 + $28.00 + $120.00 + $228.73 + $314.40 = **$3,012.12**. Both reserves round once to cents.

## Evidence and decision sequence

Observed on 2026-11-08: [P2S printer-only seller listing](https://additiveplus.com/product/bambu-lab-p2s/) $549; [Harbor Freight 63711 regular listing](https://www.harborfreight.com/6-in-digital-caliper-63711.html) $24.99, no membership coupon. Stock and exact checkout configuration must be confirmed. [SUNLU S2](https://www.sunlu.com/products/filadryer-s2-filament-dryer) and [Polymaker PETG](https://shop.polymaker.com/products/petg) supply capability context; no current selected-variant price was verified for this calculation. Metal fabrication, metric tube supply, wheels, shocks, softgoods and professional work all need actual quotes. No generic inch-sized component is confirmed compatible by a similar label.

1. Complete [Buddy's raw measurement worksheet](../engineering/buddy-xl-measurements.md) and professional suitability review. Keep treatment independent of the prototype.
2. Review the configured CAD, load path, shock/wheel interfaces, retention and harness anchors before requesting a fabrication quote. Provide the exact revision and BOM.
3. Obtain itemized material, finish-fit, fabrication, shipping and tax quotes. Verify the actual shock model and tune, wheel bearings/endplay and softgoods ratings. Revise the budget without changing a clinical gate to save cost.
4. Slice and calibrate only the nonstructural/fixture prints. Log actual printer, filament, grams, hours, kWh, defects and failed specimens.
5. Approve a physical test protocol before ballast or animal use. Quote the resulting redesign and validation effort separately. A successful print/export or an expensive printer does not qualify a chair.

## Buyer downloads and rebuild

- [Illustrated fit guide](https://buddywheels.org/fit-guide) and [printable measuring handbook](https://buddywheels.org/measurement-handbook).
- [Public budget handbook](https://buddywheels.org/prototype-budget), [PDF](https://buddywheels.org/guides/buddy-wheels-xl-build-budget.pdf) and [CSV](https://buddywheels.org/guides/xl-prototype-budget.csv).
- Rebuild with `bun run finance:prototype`. The canonical CSV contains every purchase line, coverage ID, evidence status and note. Unit tests reconcile every XL BOM ID, reserves and totals.
