stacksjs/buddy-wheels/public/guides/buddy-wheels-measuring-guide.pdf

buddy wheels | MEASURING & FITTING
| Customer guide, November 8, 2026
Measure their shape.
Keep the landmarks clear.

Record raw body measurements, with no added frame clearance. Our A-E labels apply to this worksheet, not another manufacturer’s
order form.

Comfort first. Ask your vet or rehabilitation professional how to support your dog. Never force standing or straighten a painful limb. New or sudden hind-leg loss needs urgent veterinary assessment; measuring must not delay care.

A

## A Supported groin height

From: Level floor. To: Underside where the hind leg joins the body.

Measure vertically beside the dog, from the floor to the groin crease. Use only the comfortable supported posture your care professional approves.

Do not measure to the top of the hip or back. Do not lift, press into the pelvis or force the hind legs straight.

Head

Hips

B1

## B1 Hip width

From: Outside of one hip. To: Outside of the other hip, at the same level.

Measure straight across the full body at the hips. Two parallel upright boards held lightly beside the body can help locate the edges; measure the gap without squeezing.

Do not wrap the tape around the rump or measure only one thigh. Do not add frame clearance to this body measurement.

Head

Hips

B2

Shoulders

Ribs

## B2 Widest body width

From: One outside body edge. To: Opposite edge at the same cross-section.

Check straight across at the shoulders, ribs and hips. Record the largest width, and note which location was widest. Keep the ruler perpendicular to the spine.

Do not follow the curve of the back or use chest circumference as width. Do not compress the coat or body.

C

## C Armpit-to-rump length

From: Back edge of the front leg at its armpit. To: Back of the rump, before the tail begins.

Measure a straight horizontal line along the side between the two marked vertical landmarks. Keep the ruler parallel to the floor in the approved posture.

Exclude the head, neck and tail. This is not shoulder-to-hip-center length or the distance to the front of the rear thigh.

Original schematics, not to scale. Read the methods before measuring. | buddywheels.org/fit-guide · 1 / 2

buddy wheels | BODY MEASUREMENT RECORD
| Bring this to the fitting conversation.

D

## D Chest girth

Use a soft tape around the chest just behind the front legs at the widest rib-cage area. Keep it flat and comfortably touching the coat without tightening.

Do not measure the neck or squeeze the chest. Do not add strap allowance; follow the selected harness maker’s sizing rules separately.

E

Resting on the side, viewed from above

## E Lying rear-leg measurement

With the dog resting comfortably on their side, measure the straight distance between the marked endpoints. Leave a natural bend in the leg.

Do not stretch or pull the leg. Do not trace the leg’s bent contour, and do not relabel this as supported standing height.

Dog / breed: __________________________________ | Current weight: __________ lb / kg Date: __________
Measurement | Value & unit | Method note
A. Supported groin height | ________________ | Side view
B1. Hip width | ________________ | View from above
B2. Widest body width | ________________ | View from above
C. Armpit-to-rump length | ________________ | Side view
D. Chest girth | ________________ | Side view with tape loop
E. Lying rear-leg measurement | ________________ | Lying comfortably on the side

Use one unit system. Circle inches or centimeters. A uses supported posture; E uses lying posture with a natural bend. Leave A pending if supported standing is not comfortable. Do not substitute E for A.

Supported posture / helper: _______________________ | Widest location / asymmetry: _____________________

Before sharing: repeat the measurement; confirm the same landmarks and units. Note thick coat, posture changes or differences between sides. Buddy’s 140 lb is owner reported; all of his body dimensions are still pending until measured.

Body measurements are not CAD settings. Harness offsets, padding, tire deflection, clearances and suspension movement need separate engineering and fitting review. A completed worksheet does not approve a fit or establish a load capacity.

Method references: Walkin’ Pets rear-leg guide; (https://walkinpets.com/pages/wheelchair-sizer/) Eddie’s Wheels supported-measurement guide. (https://eddieswheels.com/files/A_Visual_Guide_to_Measuring_Your_Pet_-_Eddies_Wheels_for_Pets_-_The_Pet_Mobility_Experts.pdf) Ruffwear’s girth guide (https://ruffwear.com/blogs/explored/the-size-is-right-how-to-measure-for-your-dogs-gear) explains the chest landmark; follow the selected harness supplier’s instructions separately. Methods and codes differ between brands.

Keep care and treatment moving independently of a prototype build. | buddywheels.org/fit-guide · 2 / 2
