stacksjs/buddy-wheels/designs/wheelchair/r0/L/assembly.png

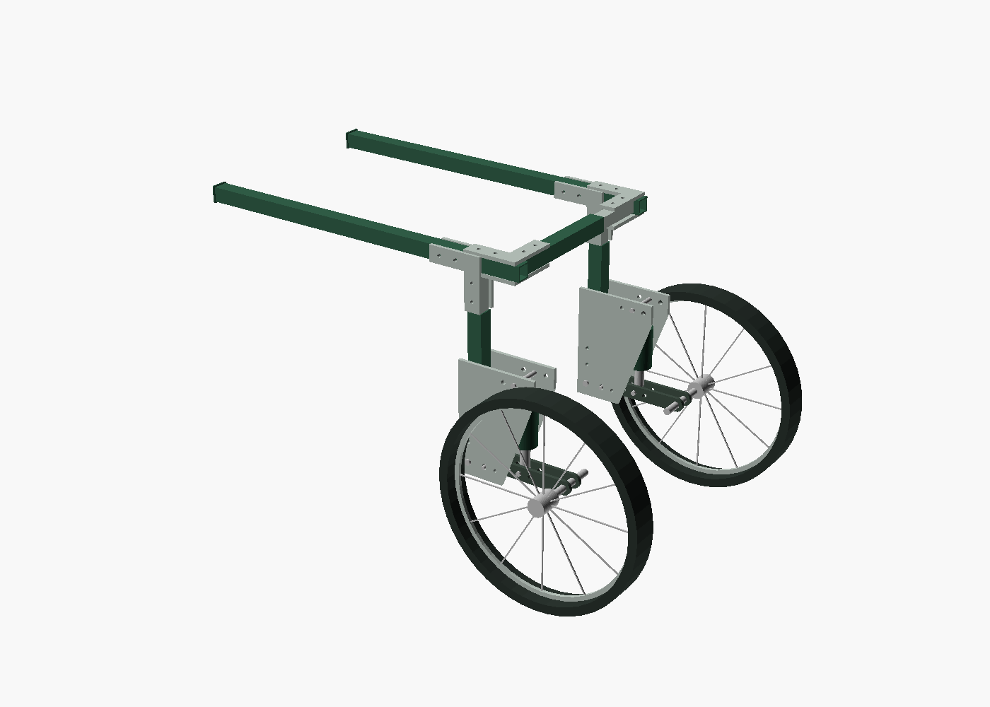
designs/wheelchair/r0/L/assembly.png
