stacksjs/buddy-wheels/designs/wheelchair/r0/S/assembly.png

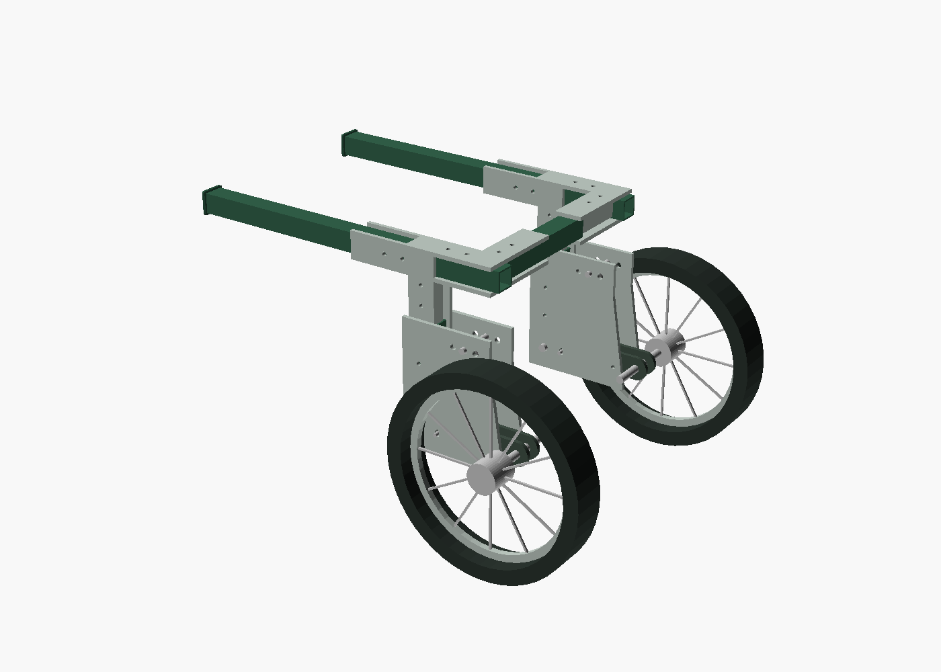
designs/wheelchair/r0/S/assembly.png
