stacksjs/buddy-wheels/designs/wheelchair/r0/XS/assembly.png

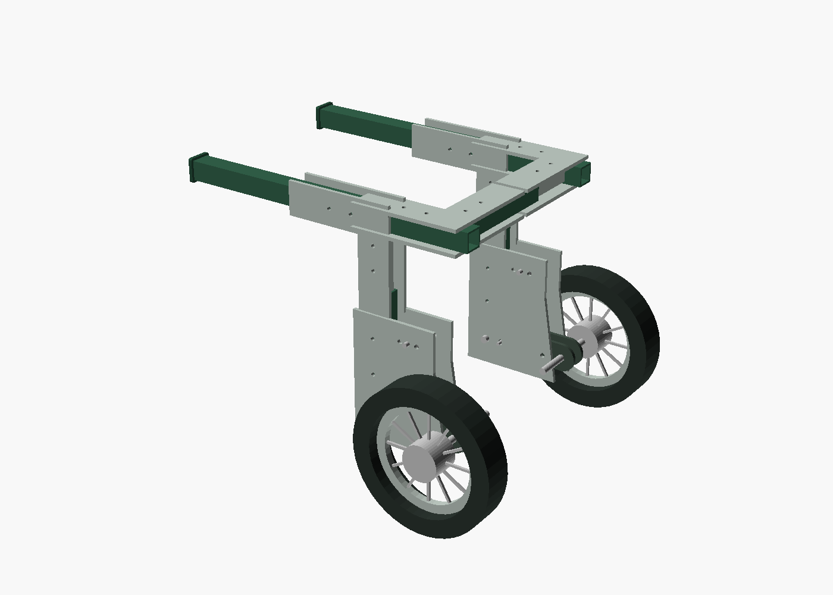
designs/wheelchair/r0/XS/assembly.png
