stacksjs/buddy-wheels/designs/wheelchair/r1/XL/assembly.png

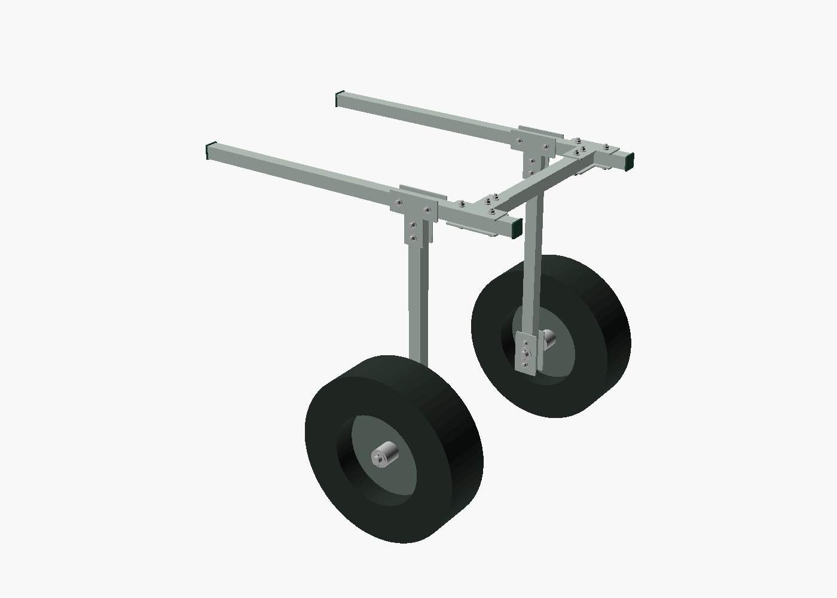
designs/wheelchair/r1/XL/assembly.png
