stacksjs/buddy-wheels/public/designs/softgoods/r1/L-r0/assembly.png

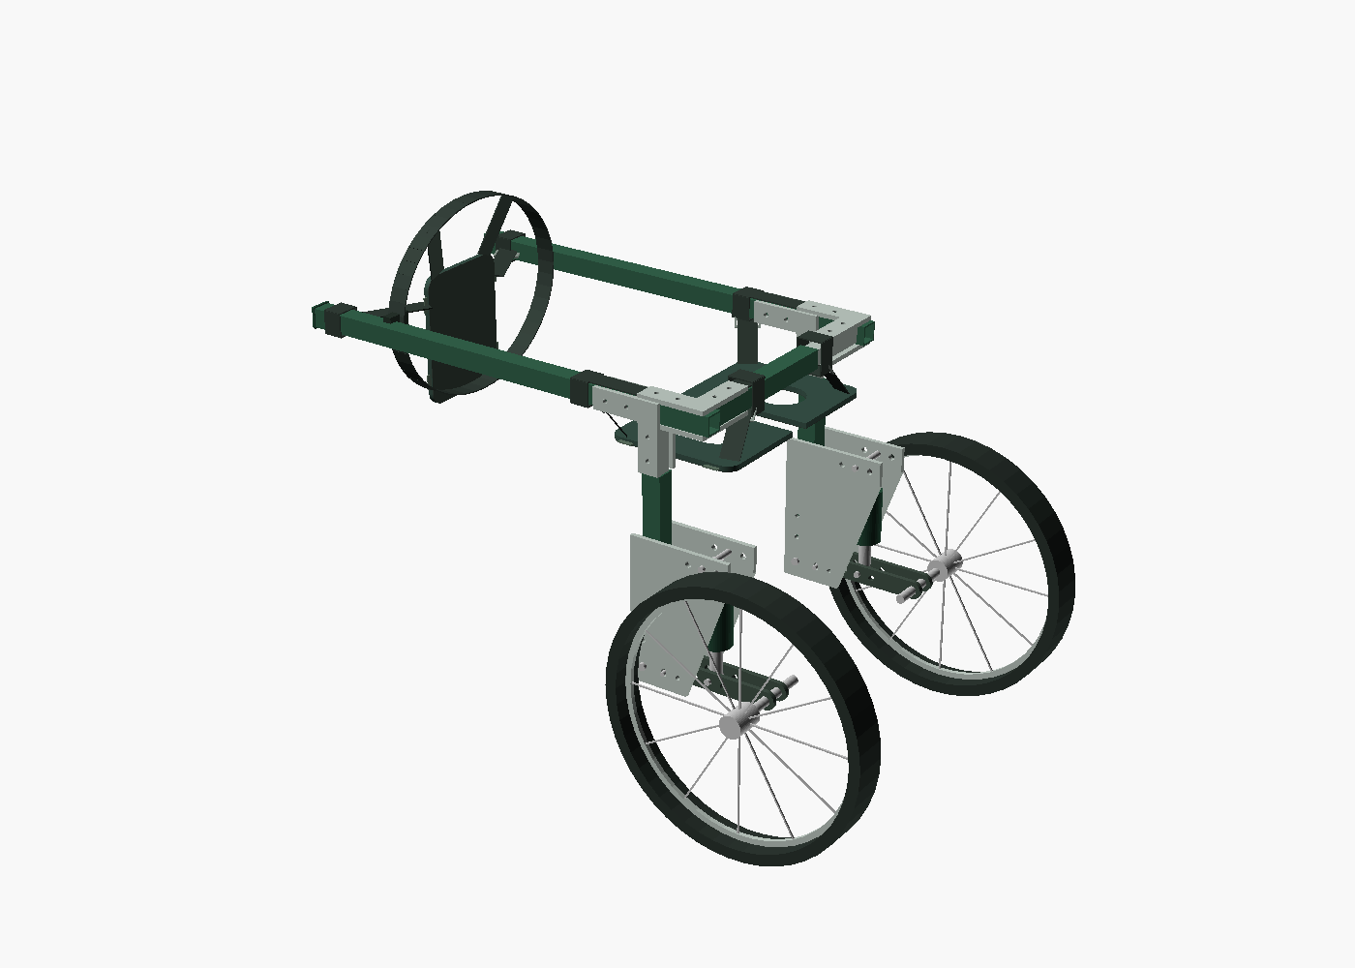
public/designs/softgoods/r1/L-r0/assembly.png
