stacksjs/buddy-wheels/public/designs/softgoods/r1/XL-r1/assembly.png

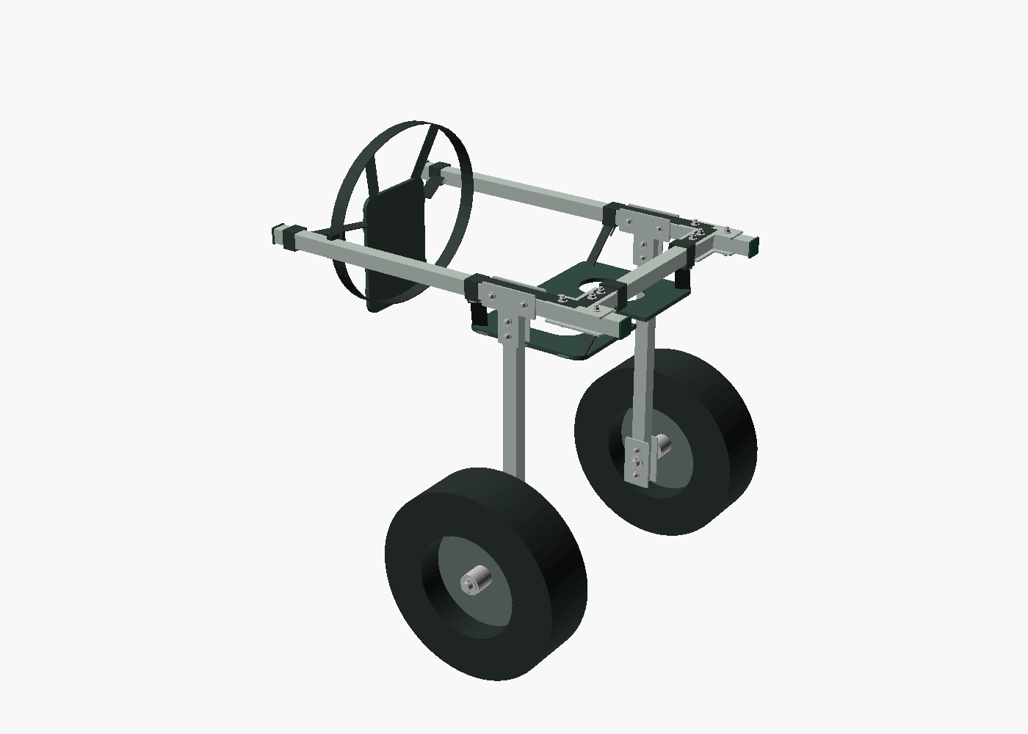
public/designs/softgoods/r1/XL-r1/assembly.png
