stacksjs/buddy-wheels/public/designs/softgoods/r1/XS-r0/assembly.png

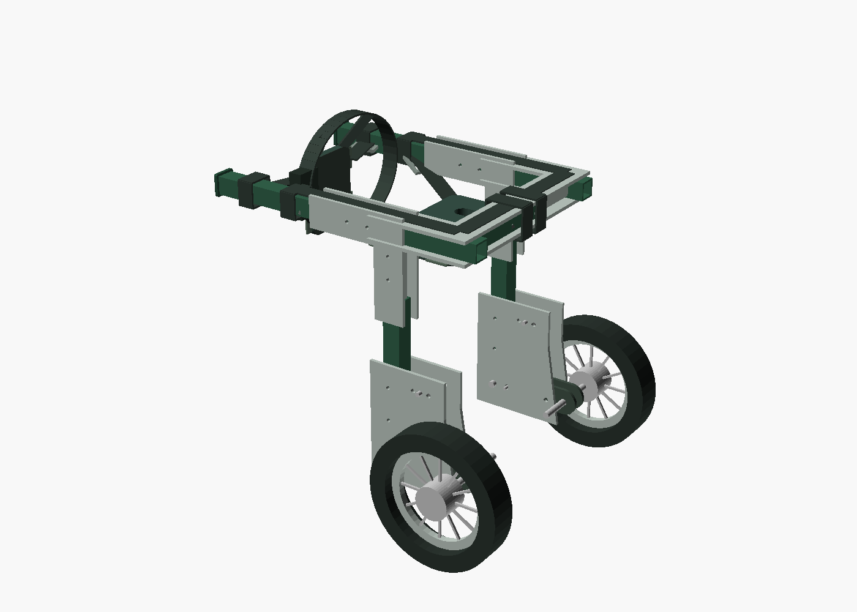
public/designs/softgoods/r1/XS-r0/assembly.png
