stacksjs/buddy-wheels/(commit log)

2026-11-08 feat: launch Buddy Wheels planning storefront and product business plan
2026-11-08 docs: record verified Buddy Wheels production deployment
2026-11-08 feat: add configurable XL-first wheelchair bench CAD and assembly kit
    [FIT_CHECK_ONLY_arm_plate.stl, FIT_CHECK_ONLY_corner_plate.stl, FIT_CHECK_ONLY_fixed_plate.stl, arm_plate.dxf, bom.csv, corner_plate.dxf, coupon.stl, drill_jig.stl]
2026-11-08 feat: add native XL design studio and matching printable kit downloads
    [FIT_CHECK_ONLY_arm_plate.stl, FIT_CHECK_ONLY_corner_plate.stl, FIT_CHECK_ONLY_fixed_plate.stl, arm_plate.dxf, corner_plate.dxf, coupon.stl, drill_jig.stl, fixed_plate.dxf]
2026-11-08 feat: add every wheelchair size to the native design studio
    [FIT_CHECK_ONLY_arm_plate.stl, FIT_CHECK_ONLY_corner_plate.stl, FIT_CHECK_ONLY_fixed_plate.stl, arm_plate.dxf, corner_plate.dxf, coupon.stl, drill_jig.stl, fixed_plate.dxf]
2026-11-08 feat: add illustrated fitting guides and refine wheelchair designs
    [coupon.stl, drill_jig.stl, index_collar.stl, inner_cap.stl, model.scad, pivot_guard.stl, tube_cap.stl, wheelchair.scad]
2026-11-08 feat: redesign XL with standard parts and priced manufacturing model
    [FIT_CHECK_ONLY_axle_plate.stl, FIT_CHECK_ONLY_joint_plate.stl, axle_cover.stl, axle_plate.dxf, bom.csv, costs.csv, coupon.stl, drill_guide.stl]
2026-11-08 fix: clarify printed service parts and record XL r1 verification
2026-11-08 feat: add costed standard-spring XL suspension studio
    [FIT_CHECK_ONLY_axle_plate.stl, FIT_CHECK_ONLY_joint_plate.stl, FIT_CHECK_ONLY_rail_shim.stl, FIT_CHECK_ONLY_spring_seat.stl, axle_cover.stl, axle_plate.dxf, bom.csv, costs.csv]
2026-11-09 feat: include complete support and harness designs in every studio
    [TEXTILE_REFERENCE_ONLY_front_mesh.stl, TEXTILE_REFERENCE_ONLY_front_pad.stl, TEXTILE_REFERENCE_ONLY_front_shell.stl, TEXTILE_REFERENCE_ONLY_rear_mesh.stl, TEXTILE_REFERENCE_ONLY_rear_pad.stl, TEXTILE_REFERENCE_ONLY_rear_shell.stl, assembly-with-softgoods.scad, front-bib.dxf]
2026-11-09 fix: replace XL harness allowance with complete unit costs
    [axle_cover.stl, costs.csv, coupon.stl, drill_guide.stl, end_cap.stl, textile-bom.csv, xl-complete-unit-costs.csv, xl-spring-r2-costs.csv]
2026-11-12 feat: add Buddy Rover r0 walk-in carrier design, studio and cost study
    Add a native solid kit that generates closed printable meshes without an
    external CAD program, a parametric Rover frame with a tailgate ramp, a
    rain, wind and sun cover with priced candidate materials, a counted cost
    study, an interactive studio and configured downloads. Update the Rover
    brief, product page and project documents.
    [FIT_CHECK_ONLY_axle_hanger.stl, FIT_CHECK_ONLY_corner_gusset.stl, FIT_CHECK_ONLY_tee_gusset.stl, axle_cover.stl, axle_hanger.dxf, bom.csv, cable_clip.stl, cap_heavy.stl]
2026-11-12 feat: cut Rover r0 cost with a simpler cover, lighter members and plainer hardware
    Use a verified lower-cost wall fabric under the roof overhang, hook and
    loop instead of zippers, listed quantity tiers, zinc grade 5 hardware,
    exterior plywood, thin-wall secondary tubes and single corner-post
    gussets. Report a separate, labeled total for tube bought by weight.
    Part geometry is unchanged.
    [bom.csv, cover-cut-schedule.csv, cut-list.csv]
2026-11-12 feat: add a verified 13 inch path wheel option to Rover r0
    Make the 13 x 4 inch pneumatic wheel from the XL wheelchair the default
    Rover wheel, with a low axle hanger profile and fork spacers, and keep
    the 20 inch wheel as a studio option. The deck and ramp are unchanged.
    Record the first cost-down deployment.
    [FIT_CHECK_ONLY_axle_hanger_low.stl, axle_hanger_low.dxf, bom.csv, cut-list.csv]
2026-11-12 feat: price Rover r0 from verified supplier pages and add a buy list
    Move the tube to 21 ft and 24 ft stock bars at prices read on the
    supplier page, with cabin members in 1/16 inch 6063-T52. Make a 15 inch
    pneumatic wheel with stated bearings, hub length and load the default,
    with its own hanger profile. Replace bolt, nut, washer and plywood
    allowances with observed prices. Generate a one-carrier buy list with
    supplier links and a verified versus allowance split.
    [FIT_CHECK_ONLY_axle_hanger_mid.stl, axle_hanger_mid.dxf, bom.csv, cap_light.stl, cut-list.csv]
2026-11-12 feat: add Rover swivel front, build guide, base plan and drilling schedule
    Carry a 10 inch swivel caster on a raised nose made from extended base
    rails, four posts and two beams, using the existing corner gusset, with
    the fixed fork kept as an option. Generate a step-by-step build guide,
    a base frame plan, a drilling schedule for every tube and a nesting
    plan into 8 ft parcel bars, and price one build from those bars.
    [bom.csv, cut-list.csv, drilling.csv]
2026-11-12 feat: resolve Rover steering lock, parking brake and hardware prices
    Specify a swivel caster with a swivel lock and a stated mounting height,
    add a toggle-clamp parking brake on an arm over each rear tire with a
    clamp plate profile, and price the hinge, latches, leveling mounts,
    sleeve tube, axle parts, bolts and chocks from supplier pages. Update
    the build guide, buy list, drilling schedule and documents to match.
    [FIT_CHECK_ONLY_brake_plate.stl, bom.csv, brake_plate.dxf, cut-list.csv, drilling.csv]
2026-11-12 fix: close Rover caster pattern, brake pad thread and ramp leg fits
    Draw the caster beam holes from the maker's published plate pattern,
    use a neoprene-tipped spindle whose 5/16-18 thread is stated, and end
    the ramp stand legs in printed caps so they need no threaded insert.
    Point the build guide at a no-account instant quote for the plates.
    [bom.csv, cut-list.csv, drilling.csv]
2026-11-12 feat: set Rover Run to $999 and enlarge the starting cabin
    Set the Rover prices to Run $999, Coast $1,049, Snow $1,099 and
    All-season $1,199 at the owner's instruction, and price the unit
    economics from the counted r0 cost so the table shows the loss per
    sale. Grow the starting cabin to 1300 x 700 x 1000 mm with a 1000 mm
    ramp at about 8 degrees. Add a cost study section on how comparable
    products reach their prices and what each lever would do here.
    [bom.csv, cover-cut-schedule.csv, cut-list.csv, drilling.csv]
2026-11-12 feat: rake the Rover front and add walk, run, coast and snow setups
    Stand the front posts and top frame back so the front wall leans 350 mm,
    with the wall as fabric on two stays, and re-space cross members around
    the moved posts. Add four activity setups to the studio and a concept
    ski conversion kit drawn from the existing tube and tee gussets.
    Record the $999 price deployment.
    [bom.csv, cover-cut-schedule.csv, cut-list.csv, drilling.csv]
2026-11-12 feat: add a welded Rover frame with a tapered roof and raked pillars
    Welded is now the starting build: 46 welded joints, no gussets, a roof
    that falls 180 mm toward the front and a raked pillar on each side. The
    bolted frame stays selectable in the studio. Adds a weld schedule, a
    build guide for briefing a fabrication shop, a welding cost line on
    assumed shop rates, and a welded against bolted comparison in the cost
    study. Welding does not lower the counted cost; it lowers the mass
    estimate by about 7.7 kg.
    Also records the production verification of 930d16e.
    [bom.csv, cover-cut-schedule.csv, cut-list.csv, drilling.csv, weld-schedule.csv]
2026-11-12 feat: add sprung rear swing arms and a two-seat layout concept to Rover
    Each rear wheel now hangs on a trailing swing arm with a coil-over shock
    on the welded frame. Ride figures are arithmetic from the drawn geometry
    and one seller's spring label; nothing is fitted or measured and no
    comparison with another product is claimed. A rigid axle stays an option.
    A two-seat bench is a studio option labeled not for use with a child. No
    joint, anchor or restraint is designed and no build steps are issued.
    Adds a shock tab profile, suspension and seat cost lines, supplier prices
    for the shock, bearings and pivot bolts, and a note that the linked axle
    sleeve tube needs reaming.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
    [FIT_CHECK_ONLY_shock_tab.stl, bom.csv, cut-list.csv, drilling.csv, shock_tab.dxf, weld-schedule.csv]
2026-11-12 feat: make the Rover home build match the welded frame with no welding
    The bolted frame now shares every tube with the welded one: raked
    pillars, a roof that falls toward the front and the sprung rear. Three
    joints are not square, so their gusset plates are generated at each
    setup's angles. The suspension mounts are bolt-on plates for both builds.
    The bolted build is the starting setup; welded stays an option.
    Removes the fabric windshield stays and the welded shock tabs. Records
    what the reference maker's pages say about its folding frame, and that no
    mail-order service was found that bends square tube.
    [FIT_CHECK_ONLY_shock_hanger.stl, FIT_CHECK_ONLY_shock_plate.stl, FIT_CHECK_ONLY_shock_tab.stl, bom.csv, cut-list.csv, drilling.csv, pillar-foot-gusset.dxf, pillar-top-gusset.dxf]
2026-11-12 feat: add laser-ready STEP files for every Rover frame tube
    The bolted kit now carries one STEP file per different tube, with its
    holes and angled ends, and an order sheet with quantity and material, so
    a tube laser service can cut and drill the frame. Hole positions come
    from the drilling schedule. The files come from a small native B-rep kit
    and STEP writer and are checked for a closed, consistently oriented shell
    and the expected volume.
    No file has been opened in a CAD program or uploaded to a service, so
    acceptance and price are unknown; the guide says so.
    [C01-base-side-rail.step, C02-base-end-cross-member.step, C03-axle-post.step, C06-ramp-side-curb-rail.step, C07-ramp-under-rib-hinge-end-one-only.step, C07-ramp-under-rib.step, C08-ramp-stand-leg.step, C09-rear-corner-post.step]
2026-11-12 feat: record the Rover tube laser quote and cut the remaining hand steps
    All 20 STEP files for the starting bolted setup were uploaded to a tube
    laser service's instant-quote page with the owner's permission. Every
    file passed its design check and the set of 39 tubes was quoted at
    $1,405.06 before shipping and tax. Nothing was ordered.
    The floor fastener holes are now placed in the drilling schedule and cut
    as one-wall holes, the one bore the laser cannot cut gets a pilot hole,
    and the files sort into one folder per material with the quantity in each
    name. Adds ready-cut bolt sleeves as a priced shortcut and the exact
    ordering steps to the guide.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
    [C01-base-side-rail.step, C01-x2-base-side-rail.step, C02-base-end-cross-member.step, C02-x2-base-end-cross-member.step, C03-x2-axle-post.step, C06-x2-ramp-side-curb-rail.step, C07-x1-ramp-under-rib-hinge-end-one-only.step, C07-x1-ramp-under-rib.step]
2026-11-12 feat: price the Rover metal from real quotes and cut plates and laser cost
    The plate files were added to the tube laser quote with the owner's
    permission. All passed. The plates came to about double the allowance, so
    the one-carrier cost now uses the quoted prices. The 100-carrier plate
    figure is still an unquoted allowance.
    Three reductions were tested with quotes. The tubes are now packed into 8
    sticks with marker holes at the saw lines, quoted 15 percent below the
    same tubes ordered one by one. The handle grip lies across the arm ends
    on two bolts in place of four gussets. A softer plate alloy is priced as
    a choice and not adopted. The buy list gains a priced table of choices
    that lower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
    [C01-x2-base-side-rail.step, C02-x2-base-end-cross-member.step, C03-x2-axle-post.step, C06-x2-ramp-side-curb-rail.step, C07-x1-ramp-under-rib-hinge-end-one-only.step, C07-x1-ramp-under-rib.step, C08-x2-ramp-stand-leg.step, C09-x2-rear-corner-post.step]
2026-11-12 feat: buy Rover tube as full-length bars and keep 6061-T6 plates
    For one carrier the tube is now counted as full 21 ft and 24 ft bars, each
    cut in half by the supplier to carry, at the listed long-bar prices. That
    is 210 dollars less than the same tube as 8 ft parcel bars, which stays
    as the dearer alternative. A local supplier's counter price was not
    checked.
    Records the owner's decision to keep the plates in 6061-T6. The softer
    alloy quote stays on record as a price only.
2026-11-13 feat: make the bent, shop-welded Rover frame the standard
    Each cabin side, the handle and each nose hoop is now one bent tube on the
    welded build: 29 tubes, 10 bends at a 4.5 inch centerline radius and 36 welds.
    Adds a bend schedule, a bending cost line, a bend schedule download and bent
    tubes in the 3D scene. The bolted home build keeps its straight tubes, plates
    and tube laser files, and its quotes are tied to that setup, not the default.
    The design build now prunes generated files that are no longer produced.
    [S01-x2-C01-C16.step, S02-x2-C03-C06-C22-C17.step, S03-x2-C02-C15-C08-C23.step, S04-x2-C09-C10.step, S05-x2-C12-C11-C14.step, S06-x2-C21.step, S07-x1-C13-C11-C14.step, S08-x1-C07.step]
2026-11-13 feat: draw the Rover's bent tubes round so a mail-order service can bend them
    The five bent parts of the welded frame are now 1 inch OD x 1/8 inch wall
    round 6063-T52, drawn to OSH Cut's bending rules: a 3 inch centerline radius
    and 2.25 inches of straight beside each bend. The bend schedule carries the
    points its order form asks for. Square tubes that end on a round hoop are cut
    to its centerline and notched, and the weld schedule says so. The cost model
    uses the instant quote read on 2026-11-12 in place of the bending allowance,
    which raises the welded totals to 1,666.02 at 100 and 3,082.31 for one.
    [bend-schedule.csv, bom.csv, cut-list.csv, drilling.csv, weld-schedule.csv]
2026-11-13 fix: price the welded Rover's ten plates from their own quote
    The welded frame's plates were priced at what they cost in the bolted
    frame's larger order. Quoted alone with the bent tubes they are $71.00,
    not $60.06, so the one-carrier welded cost rises to $3,093.25.
2026-11-13 docs: record the Rover welding quote requests sent to four shops
2026-11-13 docs: record the Rover welding quote request submitted to Aero Bending
    Also moves the sentences about the bent tube quotes back beside those quotes.
